staskaaa-netizen/uCNC_Pi_Board/manufacturing/board-3d-bottom-da42d9de.png

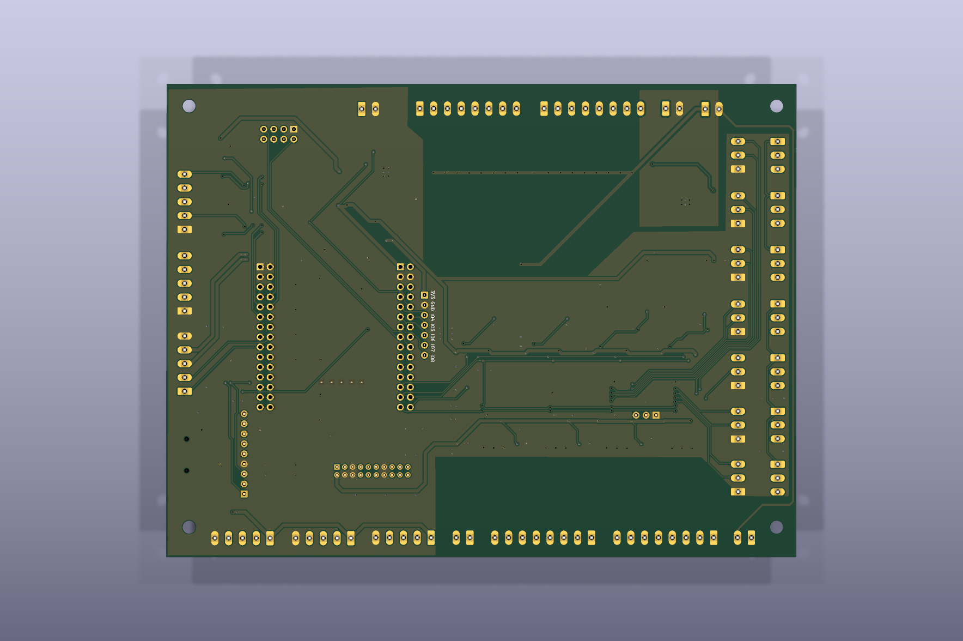
manufacturing/board-3d-bottom-da42d9de.png
