staskaaa-netizen/uCNC_Pi_Board/manufacturing/board-ordered-first-batch.jpg

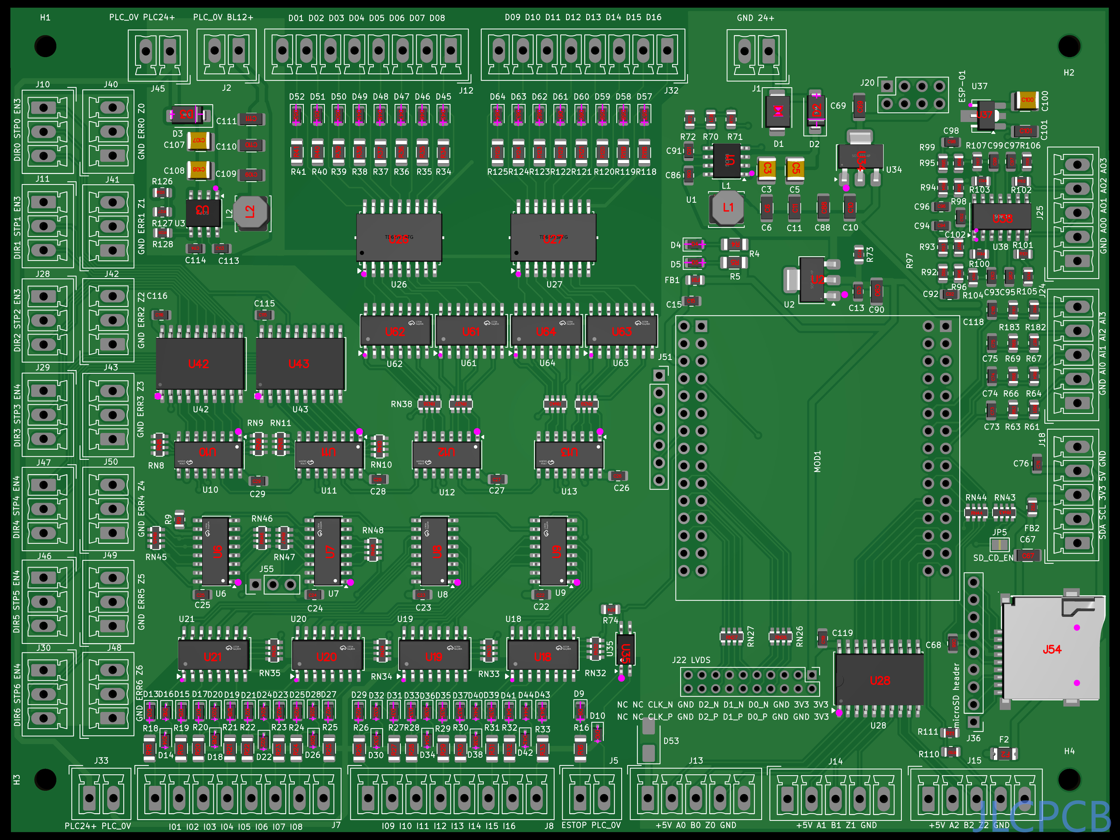
manufacturing/board-ordered-first-batch.jpg
