staskaaa-netizen/uCNC_Pi_Board/experiments/power-schematic-readability/inputs/source-power.png

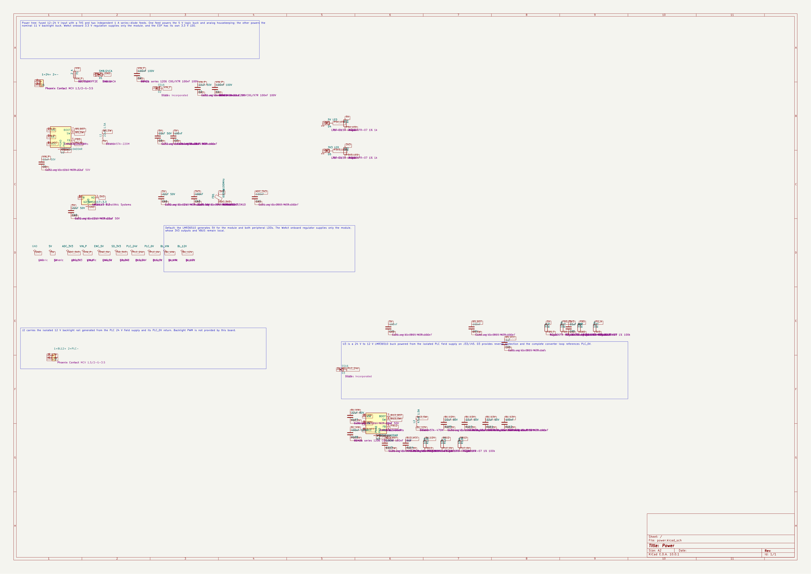
experiments/power-schematic-readability/inputs/source-power.png
