staskaaa-netizen/uCNC_Pi_Board/experiments/power-schematic-readability/method-a/lean-power-a.png

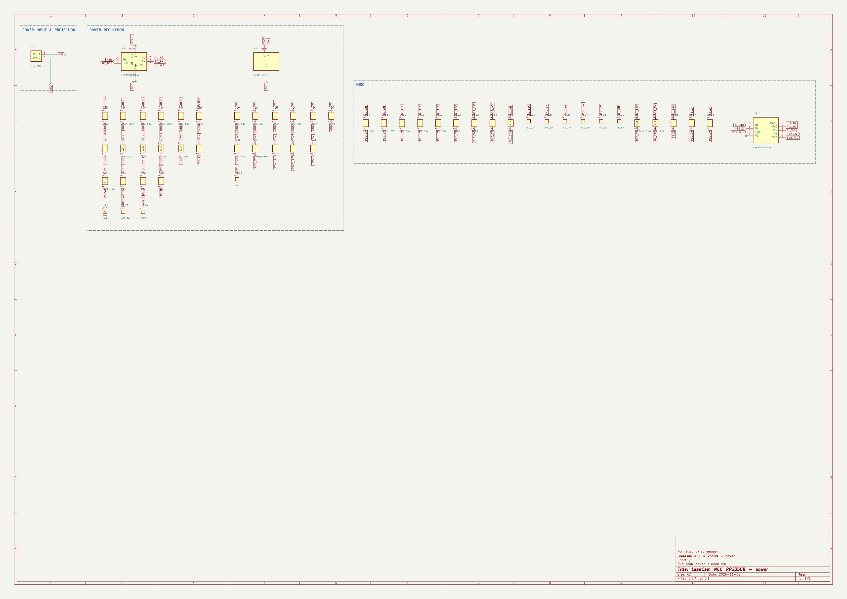
experiments/power-schematic-readability/method-a/lean-power-a.png
