staskaaa-netizen/uCNC_Pi_Board/experiments/power-schematic-readability/method-b/lean-power-b.png

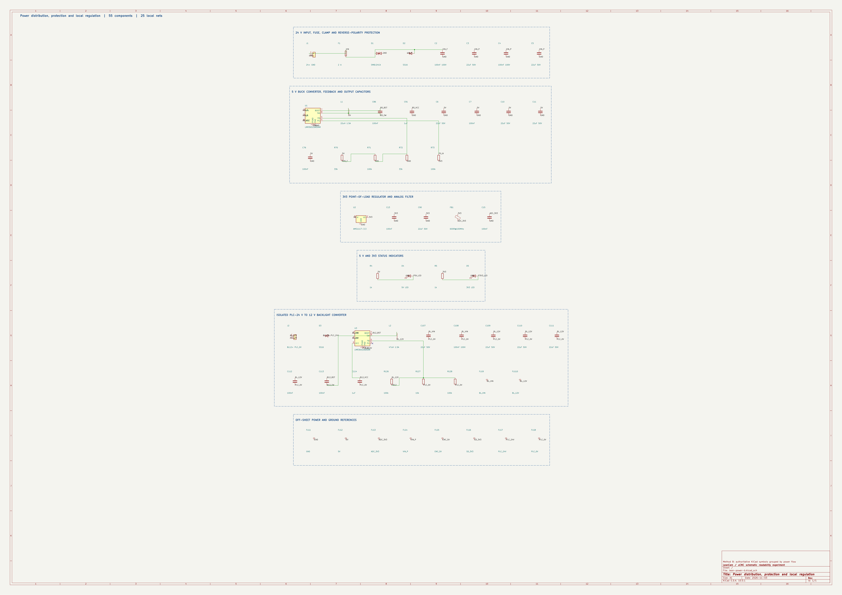
experiments/power-schematic-readability/method-b/lean-power-b.png
