staskaaa-netizen/uCNC_Pi_Board/experiments/power-schematic-readability/other-sheets/analog_io-python.png

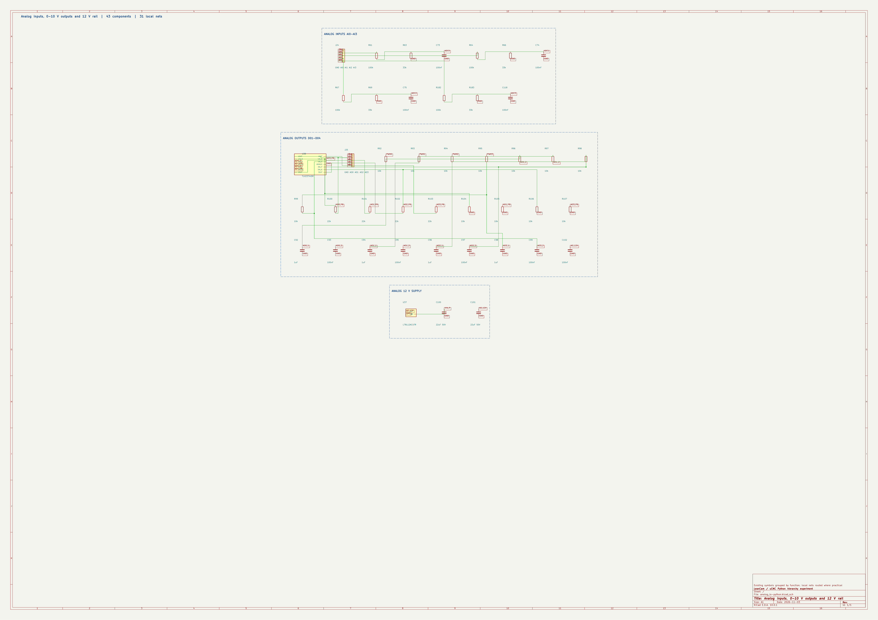
experiments/power-schematic-readability/other-sheets/analog_io-python.png
