staskaaa-netizen/uCNC_Pi_Board/experiments/power-schematic-readability/other-sheets/display-python.png

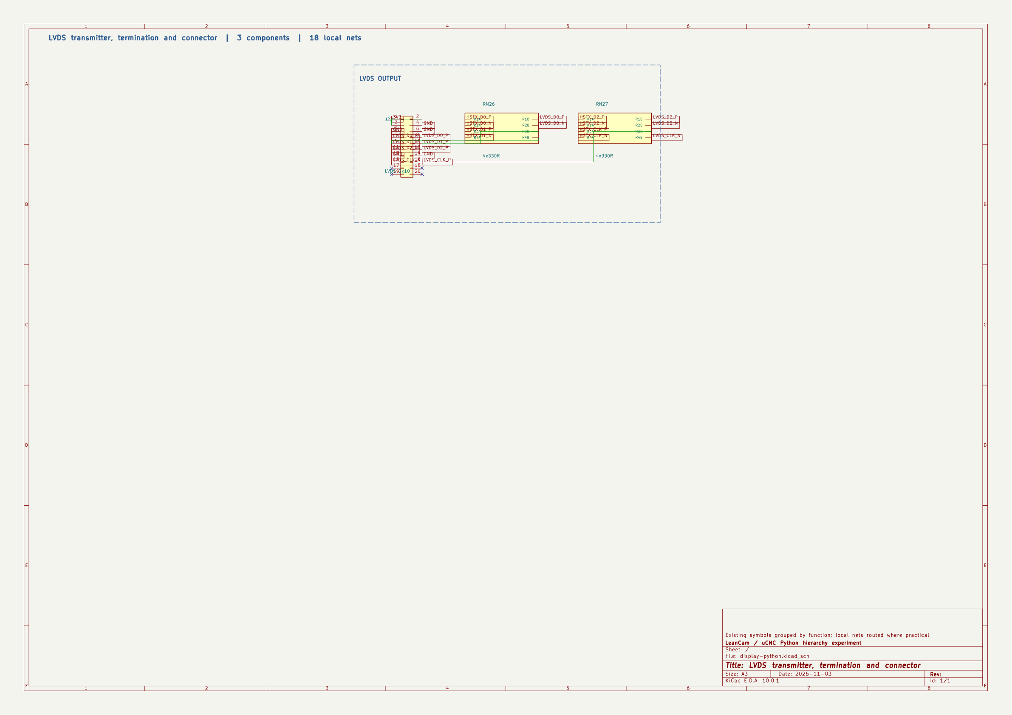
experiments/power-schematic-readability/other-sheets/display-python.png
