staskaaa-netizen/uCNC_Pi_Board/experiments/power-schematic-readability/other-sheets/encoders-python.png

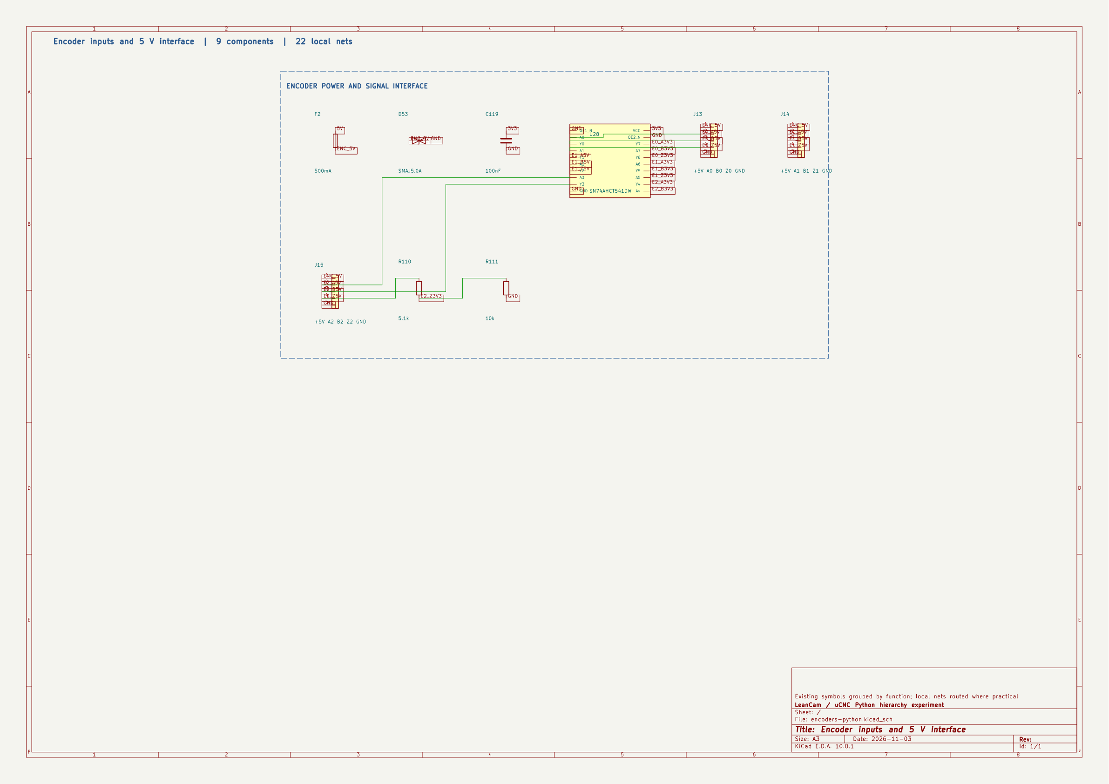
experiments/power-schematic-readability/other-sheets/encoders-python.png
