staskaaa-netizen/uCNC_Pi_Board/experiments/power-schematic-readability/other-sheets/field_inputs-python.png

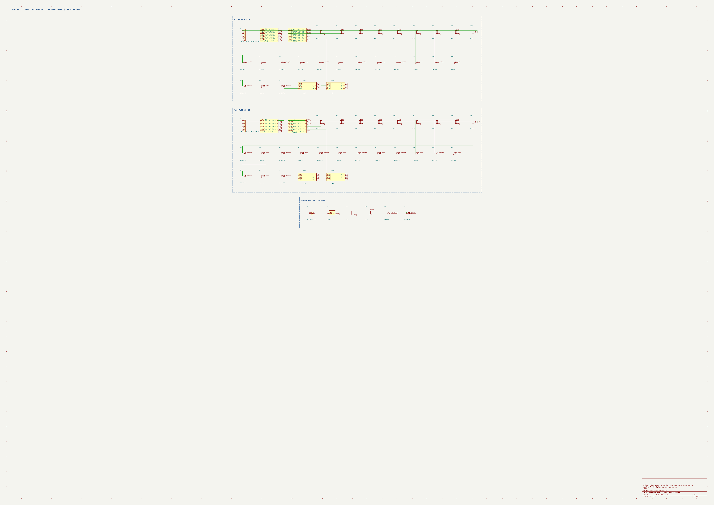
experiments/power-schematic-readability/other-sheets/field_inputs-python.png
