staskaaa-netizen/uCNC_Pi_Board/experiments/power-schematic-readability/other-sheets/field_outputs-python.png

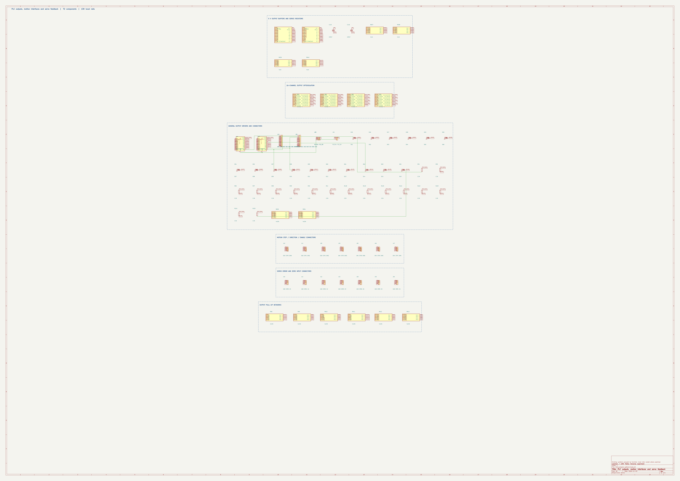
experiments/power-schematic-readability/other-sheets/field_outputs-python.png
