staskaaa-netizen/uCNC_Pi_Board/experiments/power-schematic-readability/other-sheets/mcu_io-python.png

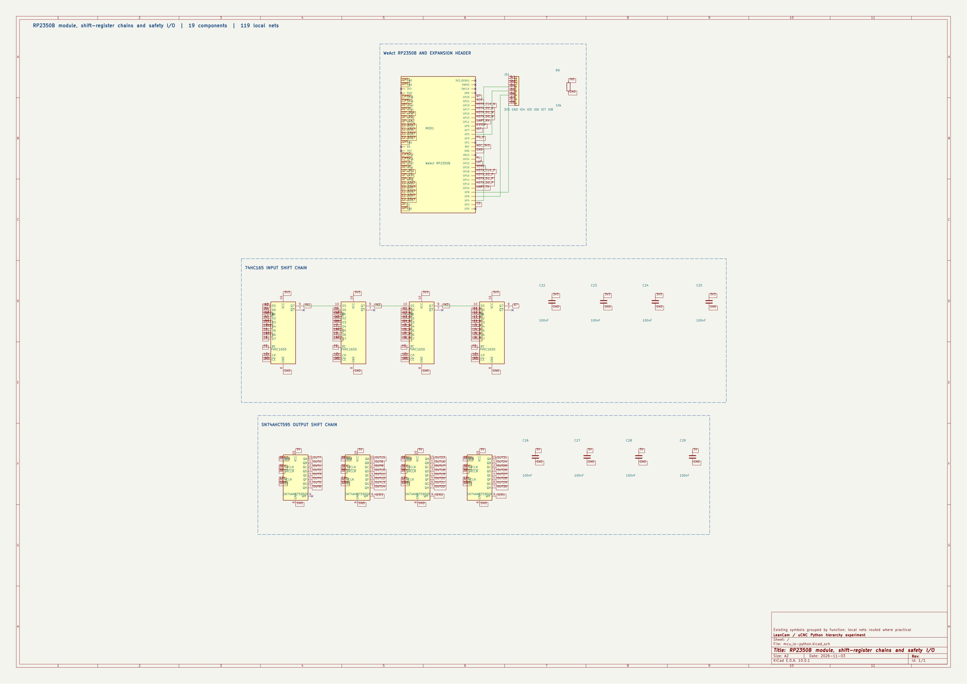
experiments/power-schematic-readability/other-sheets/mcu_io-python.png
