staskaaa-netizen/uCNC_Pi_Board/experiments/power-schematic-readability/other-sheets/storage_wifi_ui-python.png

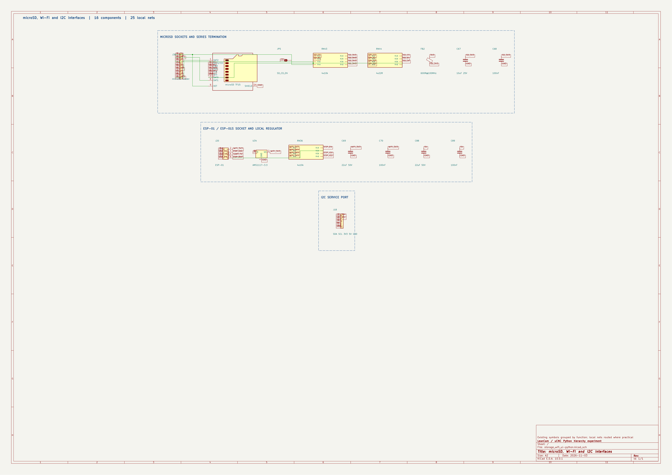
experiments/power-schematic-readability/other-sheets/storage_wifi_ui-python.png
