staskaaa-netizen/uCNC_Pi_Board/manufacturing/bom-all-jlcpcb.csv

Comment | Designator | Footprint | JLCPCB Part #
100nF | C13,C15,C22,C23,C24,C25,C26,C27,C28,C29,C68,C73,C74,C75,C76,C86,C93,C95,C97,C99,C102,C113,C115,C116,C118,C119 | C_0805_2012Metric | C49678
1uF | C91,C92,C94,C96,C98,C114 | C_0805_2012Metric | C28323
22uF 25V | C6,C10,C11,C67,C69,C88,C90,C101,C109,C110,C111 | C_1206_3216Metric | C12891
22uF 35V | C3,C5,C100,C107,C108 | C_1210_3225Metric | C6120016
24+ GND | BL12+ PLC_0V | ESTOP PLC_0V | PLC24+ PLC_0V | J1,J2,J5,J33,J45 | PhoenixContact_MCV_1,5_2-G-3.5_1x02_P3.50mm_Vertical
EN3 STP0 DIR0 | EN3 STP1 DIR1 | EN3 STP2 DIR2 | EN4 STP3 DIR3 | EN4 STP4 DIR4 | EN4 STP5 DIR5 | EN4 STP6 DIR6 | GND ERR0 Z0 | GND ERR1 Z1 | GND ERR2 Z2 | GND ERR3 Z3 | GND ERR4 Z4 | GND ERR5 Z5 | GND ERR6 Z6 | J10,J11,J28,J29,J30,J40,J41,J42,J43,J46,J47,J48,J49,J50 | PhoenixContact_MCV_1,5_3-G-3.5_1x03_P3.50mm_Vertical
5V A0 B0 Z0 GND | 5V A1 B1 Z1 GND | 5V A2 B2 Z2 GND | GND AI0 AI1 AI2 AI3 | GND AO0 AO1 AO2 AO3 | SDA SCL 3V3 5V GND | J13,J14,J15,J18,J24,J25 | PhoenixContact_MCV_1,5_5-G-3.5_1x05_P3.50mm_Vertical
D01 D02 D03 D04 D05 D06 D07 D08 | D09 D10 D11 D12 D13 D14 D15 D16 | I01 I02 I03 I04 I05 I06 I07 I08 | I09 I10 I11 I12 I13 I14 I15 I16 | J7,J8,J12,J32 | PhoenixContact_MCV_1,5_8-G-3.5_1x08_P3.50mm_Vertical
LVDS 2x10 | J22 | PinHeader_2x10_P2.00mm_Vertical
U7 spare inputs: GND, IN13, IN14 | J55 | PinHeader_1x03_P2.54mm_Vertical
microSD header | J36 | PinHeader_1x09_P2.54mm_Vertical
3V3 GND IO4 IO5 IO6 IO7 IO8 | J51 | PinSocket_1x07_P2.54mm_Vertical
ESP-01 | J20 | PinSocket_2x04_P2.54mm_Vertical
US1M | D2,D3 | D_SMA | C412437
SMBJ24CA | D1 | D_SMB | C53133594
1N4148WS | D10,D14,D16,D18,D20,D22,D24,D26,D28,D30,D32,D34,D36,D38,D40,D42,D44 | D_SOD-323 | C2128
3V3 LED | 5V LED | D01 | D02 | D03 | D04 | D05 | D06 | D07 | D08 | D09 | D10 | D11 | D12 | D13 | D14 | D15 | D16 | indicator | D4,D5,D9,D13,D15,D17,D19,D21,D23,D25,D27,D29,D31,D33,D35,D37,D39,D41,D43,D45,D46,D47,D48,D49,D50,D51,D52,D57,D58,D59,D60,D61,D62,D63,D64 | LED_0805_2012Metric | C2297
22uH 1.4A | L1 | L_SXN_SMNR5040 | C9391
47uH 0.9A | L2 | L_SXN_SMNR5040 | C9392
microSD TF15 | J54 | TF-SMD_TF-15-15 | C111196
WeAct RP2350B | MOD1 | WeAct_RP2350B_Socket
TLV2374IDR | U38 | SOIC-14_3.9x8.7mm_P1.27mm | C29793
74HC165D | U6,U7,U8,U9 | SOIC-16_3.9x9.9mm_P1.27mm | C5613
SN74AHCT595DR | U10,U11,U12,U13 | SOIC-16_3.9x9.9mm_P1.27mm | C133793
TLP291-4 | U18,U19,U20,U21,U61,U62,U63,U64 | SOIC-16_4.55x10.3mm_P1.27mm | C60900
SN74AHCT541DWR | U28 | SOIC-20W_7.5x12.8mm_P1.27mm | C2682058
MC74AC541DWR2G | U42,U43 | SOIC-20W_7.5x12.8mm_P1.27mm | C8013
LTV-217-B-G | U35 | SOIC-4_4.55x2.6mm_P1.27mm | C115450
LMR36510ADDAR | U1,U3 | SOIC-8-1EP_3.9x4.9mm_P1.27mm_EP2.41x3.3mm | C1858393
TBD62083AFG(Z,EL) | U26,U27 | SOP-18_7.495x11.515mm_P1.27mm | C4153828
AMS1117-3.3 | U2,U34 | SOT-223-3_TabPin2 | C6186
L78L12ACUTR | U37 | SOT-89-3_Handsoldering | C69601
600R@100MHz | FB1,FB2 | R_0805_2012Metric | C1017
100k | R61,R64,R67,R71,R73,R126,R128,R182 | R_0805_2012Metric | C149504
10k | R9,R74,R92,R93,R94,R95,R96,R97,R98,R99,R104,R105,R106,R107,R127 | R_0805_2012Metric | C17414
22k | R100,R101,R102,R103,R110 | R_0805_2012Metric | C17560
33k | R63,R66,R69,R70,R72,R111,R183 | R_0805_2012Metric | C17633
500mA | F2 | R_1206_3216Metric | C70076
2.2k | R4,R5,R16,R18,R19,R20,R21,R22,R23,R24,R25,R26,R27,R28,R29,R30,R31,R32,R33,R34,R35,R36,R37,R38,R39,R40,R41,R118,R119,R120,R121,R122,R123,R124,R125 | R_1206_3216Metric | C17948
4x1k | RN37,RN38,RN39,RN40 | R_Array_Convex_4x0603 | C20197
4x10k | RN8,RN9,RN10,RN11,RN32,RN33,RN34,RN35,RN43,RN45,RN46,RN47,RN48 | R_Array_Convex_4x0603 | C29718
4x22R | RN44 | R_Array_Convex_4x0603 | C12008
4x330R | RN26,RN27 | R_Array_Convex_4x0603 | C12018
