staskaaa-netizen/uCNC_Pi_Board/manufacturing/packages/uCNC_Pi_Board_SMT_Assembly/bom-full.csv

Quantity | Design Values | Footprint | Manufacturer | MPN | Assembly | References
26 | 100nF | Capacitor_SMD:C_0805_2012Metric | Samsung Electro-Mechanics | CL21 series 0805 X7R 100nF | FIT | C13 C15 C22 C23 C24 C25 C26 C27 C28 C29 C68 C73 C74 C75 C76 C86 C93 C95 C97 C99 C102 C113 C115 C116 C118 C119
6 | 1uF | Capacitor_SMD:C_0805_2012Metric | Samsung Electro-Mechanics | CL21 series 0805 X7R 1uF | FIT | C91 C92 C94 C96 C98 C114
11 | 22uF 25V | Capacitor_SMD:C_1206_3216Metric | Samsung Electro-Mechanics | CL31A226KAHNNNE | FIT | C6 C10 C11 C67 C69 C88 C90 C101 C109 C110 C111
5 | 22uF 35V | Capacitor_SMD:C_1210_3225Metric | Samsung Electro-Mechanics | CL32 series 1210 X7R 22uF 35V | FIT | C3 C5 C100 C107 C108
5 | 24+ GND | BL12+ PLC_0V | ESTOP PLC_0V | PLC24+ PLC_0V | Connector_Phoenix_MC:PhoenixContact_MCV_1,5_2-G-3.5_1x02_P3.50mm_Vertical | Phoenix Contact | Phoenix Contact MCV 1,5/2-G-3.5 | FIT | J1 J2 J5 J33 J45
14 | EN3 STP0 DIR0 | EN3 STP1 DIR1 | EN3 STP2 DIR2 | EN4 STP3 DIR3 | EN4 STP4 DIR4 | EN4 STP5 DIR5 | EN4 STP6 DIR6 | GND ERR0 Z0 | GND ERR1 Z1 | GND ERR2 Z2 | GND ERR3 Z3 | GND ERR4 Z4 | GND ERR5 Z5 | GND ERR6 Z6 | Connector_Phoenix_MC:PhoenixContact_MCV_1,5_3-G-3.5_1x03_P3.50mm_Vertical | Phoenix Contact | Phoenix Contact MCV 1,5/3-G-3.5 | FIT | J10 J11 J28 J29 J30 J40 J41 J42 J43 J46 J47 J48 J49 J50
6 | 5V A0 B0 Z0 GND | 5V A1 B1 Z1 GND | 5V A2 B2 Z2 GND | GND AI0 AI1 AI2 AI3 | GND AO0 AO1 AO2 AO3 | SDA SCL 3V3 5V GND | Connector_Phoenix_MC:PhoenixContact_MCV_1,5_5-G-3.5_1x05_P3.50mm_Vertical | Phoenix Contact | Phoenix Contact MCV 1,5/5-G-3.5 | FIT | J13 J14 J15 J18 J24 J25
4 | D01 D02 D03 D04 D05 D06 D07 D08 | D09 D10 D11 D12 D13 D14 D15 D16 | I01 I02 I03 I04 I05 I06 I07 I08 | I09 I10 I11 I12 I13 I14 I15 I16 | Connector_Phoenix_MC:PhoenixContact_MCV_1,5_8-G-3.5_1x08_P3.50mm_Vertical | Phoenix Contact | Phoenix Contact MCV 1,5/8-G-3.5 | FIT | J7 J8 J12 J32
1 | LVDS 2x10 | Connector_PinHeader_2.00mm:PinHeader_2x10_P2.00mm_Vertical | generic | LVDS 2x10 | FIT | J22
1 | U7 spare inputs: GND, IN13, IN14 | Connector_PinHeader_2.54mm:PinHeader_1x03_P2.54mm_Vertical | generic | U7 spare inputs: GND, IN13, IN14 | FIT | J55
1 | microSD header | Connector_PinHeader_2.54mm:PinHeader_1x09_P2.54mm_Vertical | generic | microSD header | FIT | J36
1 | 3V3 GND IO4 IO5 IO6 IO7 IO8 | Connector_PinSocket_2.54mm:PinSocket_1x07_P2.54mm_Vertical | generic | 3V3 GND IO4 IO5 IO6 IO7 IO8 | FIT | J51
1 | ESP-01 | Connector_PinSocket_2.54mm:PinSocket_2x04_P2.54mm_Vertical | Wurth Elektronik | 61300821121 | FIT | J20
1 | SMAJ5.0A | Diode_SMD:D_SMA | Bourns | SMAJ5.0A | FIT | D53
2 | US1M | Diode_SMD:D_SMA | MDD | US1M | FIT | D2 D3
1 | SMBJ24CA | Diode_SMD:D_SMB | Bourns | SMBJ24CA | FIT | D1
17 | 1N4148WS | Diode_SMD:D_SOD-323 | Diodes Incorporated | 1N4148WS | FIT | D10 D14 D16 D18 D20 D22 D24 D26 D28 D30 D32 D34 D36 D38 D40 D42 D44
35 | 3V3 LED | 5V LED | D01 | D02 | D03 | D04 | D05 | D06 | D07 | D08 | D09 | D10 | D11 | D12 | D13 | D14 | D15 | D16 | indicator | LED_SMD:LED_0805_2012Metric | Hubei KENTO Elec | KT-0805G | FIT | D4 D5 D9 D13 D15 D17 D19 D21 D23 D25 D27 D29 D31 D33 D35 D37 D39 D41 D43 D45 D46 D47 D48 D49 D50 D51 D52 D57 D58 D59 D60 D61 D62 D63 D64
1 | 22uH 1.4A | LeanCam:L_SXN_SMNR5040 | SXN (Shun Xiang Nuo Elec) | SMNR5040-220MT | FIT | L1
1 | 47uH 0.9A | LeanCam:L_SXN_SMNR5040 | SXN (Shun Xiang Nuo Elec) | SMNR5040-470MT | FIT | L2
1 | microSD TF15 | LeanCam:TF-SMD_TF-15-15 | SOFNG | TF-15x15 | FIT | J54
1 | WeAct RP2350B | LeanCam:WeAct_RP2350B_Socket | WeAct Studio | WeAct Studio RP2350B Core Board | FIT | MOD1
1 | TLV2374IDR | Package_SO:SOIC-14_3.9x8.7mm_P1.27mm | Texas Instruments | TLV2374IDR | FIT | U38
4 | 74HC165D | Package_SO:SOIC-16_3.9x9.9mm_P1.27mm | Nexperia | 74HC165D,653 | FIT | U6 U7 U8 U9
4 | SN74AHCT595DR | Package_SO:SOIC-16_3.9x9.9mm_P1.27mm | Texas Instruments | SN74AHCT595DR | FIT | U10 U11 U12 U13
8 | TLP291-4 | Package_SO:SOIC-16_4.55x10.3mm_P1.27mm | Toshiba | TLP291-4 | FIT | U18 U19 U20 U21 U61 U62 U63 U64
1 | SN74AHCT541DWR | Package_SO:SOIC-20W_7.5x12.8mm_P1.27mm | Texas Instruments | SN74AHCT541DWR | FIT | U28
2 | MC74AC541DWR2G | Package_SO:SOIC-20W_7.5x12.8mm_P1.27mm | onsemi | MC74AC541DWR2G | FIT | U42 U43
1 | LTV-217-B-G | Package_SO:SOIC-4_4.55x2.6mm_P1.27mm | Lite-On | LTV-217-B-G | FIT | U35
2 | LMR36510ADDAR | Package_SO:SOIC-8-1EP_3.9x4.9mm_P1.27mm_EP2.41x3.3mm | Texas Instruments | LMR36510ADDAR | FIT | U1 U3
2 | TBD62083AFG(Z,EL) | Package_SO:SOP-18_7.495x11.515mm_P1.27mm | Toshiba | TBD62083AFG(Z,EL) | FIT | U26 U27
2 | AMS1117-3.3 | Package_TO_SOT_SMD:SOT-223-3_TabPin2 | Advanced Monolithic Systems | AMS1117-3.3 | FIT | U2 U34
1 | L78L12ACUTR | Package_TO_SOT_SMD:SOT-89-3_Handsoldering | Texas Instruments | L78L12ACUTR | FIT | U37
2 | 600R@100MHz | Resistor_SMD:R_0805_2012Metric | Sunlord | GZ2012D601TF | FIT | FB1 FB2
8 | 100k | Resistor_SMD:R_0805_2012Metric | Yageo | RC0805 series 1% 100k | FIT | R61 R64 R67 R71 R73 R126 R128 R182
15 | 10k | Resistor_SMD:R_0805_2012Metric | Yageo | RC0805 series 1% 10k | FIT | R9 R74 R92 R93 R94 R95 R96 R97 R98 R99 R104 R105 R106 R107 R127
5 | 22k | Resistor_SMD:R_0805_2012Metric | Yageo | RC0805 series 1% 22k | FIT | R100 R101 R102 R103 R110
7 | 33k | Resistor_SMD:R_0805_2012Metric | Yageo | RC0805 series 1% 33k | FIT | R63 R66 R69 R70 R72 R111 R183
1 | 500mA | Resistor_SMD:R_1206_3216Metric | Bel Fuse | 0ZCG0050FF2E | FIT | F2
35 | 2.2k | Resistor_SMD:R_1206_3216Metric | Yageo | RC1206FR-07 1% 2.2k | FIT | R4 R5 R16 R18 R19 R20 R21 R22 R23 R24 R25 R26 R27 R28 R29 R30 R31 R32 R33 R34 R35 R36 R37 R38 R39 R40 R41 R118 R119 R120 R121 R122 R123 R124 R125
4 | 4x1k | Resistor_SMD:R_Array_Convex_4x0603 | UNI-ROYAL | 4D03WGJ0102T5E | FIT | RN37 RN38 RN39 RN40
13 | 4x10k | Resistor_SMD:R_Array_Convex_4x0603 | UNI-ROYAL | 4D03WGJ0103T5E | FIT | RN8 RN9 RN10 RN11 RN32 RN33 RN34 RN35 RN43 RN45 RN46 RN47 RN48
1 | 4x22R | Resistor_SMD:R_Array_Convex_4x0603 | Yageo | YC164-FR-07 series 1% | FIT | RN44
2 | 4x330R | Resistor_SMD:R_Array_Convex_4x0603 | Yageo | YC164-FR-07330RL | FIT | RN26 RN27
