staskaaa-netizen/uCNC_Pi_Board/experiments/power-schematic-readability/inputs/source-display-components.csv

Reference | Value | LibId | PinCount
J22 | LVDS 2x10 | Connector_Generic:Conn_02x10_Odd_Even | 20
RN26 | 4x330R | LeanCam:ResistorPack04 | 8
RN27 | 4x330R | LeanCam:ResistorPack04 | 8
