staskaaa-netizen/uCNC_Pi_Board/experiments/power-schematic-readability/inputs/source-encoders-components.csv

Reference | Value | LibId | PinCount
C119 | 100nF | Device:C | 2
D53 | SMAJ5.0A | Device:D_TVS | 2
F2 | 500mA | Device:Fuse | 2
J13 | +5V A0 B0 Z0 GND | Connector_Generic:Conn_01x05 | 5
J14 | +5V A1 B1 Z1 GND | Connector_Generic:Conn_01x05 | 5
J15 | +5V A2 B2 Z2 GND | Connector_Generic:Conn_01x05 | 5
R110 | 5.1k | Device:R | 2
R111 | 10k | Device:R | 2
U28 | SN74AHCT541DW | LeanCam:OctalBufferAHCT | 20
