staskaaa-netizen/uCNC_Pi_Board/experiments/power-schematic-readability/inputs/source-field_inputs-components.csv

Reference | Value | LibId | PinCount
D10 | 1N4148WS | Device:D | 2
D13 | indicator | Device:LED | 2
D14 | 1N4148WS | Device:D | 2
D15 | indicator | Device:LED | 2
D16 | 1N4148WS | Device:D | 2
D17 | indicator | Device:LED | 2
D18 | 1N4148WS | Device:D | 2
D19 | indicator | Device:LED | 2
D20 | 1N4148WS | Device:D | 2
D21 | indicator | Device:LED | 2
D22 | 1N4148WS | Device:D | 2
D23 | indicator | Device:LED | 2
D24 | 1N4148WS | Device:D | 2
D25 | indicator | Device:LED | 2
D26 | 1N4148WS | Device:D | 2
D27 | indicator | Device:LED | 2
D28 | 1N4148WS | Device:D | 2
D29 | indicator | Device:LED | 2
D30 | 1N4148WS | Device:D | 2
D31 | indicator | Device:LED | 2
D32 | 1N4148WS | Device:D | 2
D33 | indicator | Device:LED | 2
D34 | 1N4148WS | Device:D | 2
D35 | indicator | Device:LED | 2
D36 | 1N4148WS | Device:D | 2
D37 | indicator | Device:LED | 2
D38 | 1N4148WS | Device:D | 2
D39 | indicator | Device:LED | 2
D40 | 1N4148WS | Device:D | 2
D41 | indicator | Device:LED | 2
D42 | 1N4148WS | Device:D | 2
D43 | indicator | Device:LED | 2
D44 | 1N4148WS | Device:D | 2
D9 | indicator | Device:LED | 2
J5 | ESTOP PLC_0V | Connector_Generic:Conn_01x02 | 2
J7 | I01 I02 I03 I04 I05 I06 I07 I08 | Connector_Generic:Conn_01x08 | 8
J8 | I09 I10 I11 I12 I13 I14 I15 I16 | Connector_Generic:Conn_01x08 | 8
R16 | 2.2k | Device:R | 2
R18 | 2.2k | Device:R | 2
R19 | 2.2k | Device:R | 2
R20 | 2.2k | Device:R | 2
R21 | 2.2k | Device:R | 2
R22 | 2.2k | Device:R | 2
R23 | 2.2k | Device:R | 2
R24 | 2.2k | Device:R | 2
R25 | 2.2k | Device:R | 2
R26 | 2.2k | Device:R | 2
R27 | 2.2k | Device:R | 2
R28 | 2.2k | Device:R | 2
R29 | 2.2k | Device:R | 2
R30 | 2.2k | Device:R | 2
R31 | 2.2k | Device:R | 2
R32 | 2.2k | Device:R | 2
R33 | 2.2k | Device:R | 2
R74 | 4.7k | Device:R | 2
RN32 | 4x10k | LeanCam:ResistorPack04 | 8
RN33 | 4x10k | LeanCam:ResistorPack04 | 8
RN34 | 4x10k | LeanCam:ResistorPack04 | 8
RN35 | 4x10k | LeanCam:ResistorPack04 | 8
U18 | TLP291-4 | LeanCam:QuadOpto | 16
U19 | TLP291-4 | LeanCam:QuadOpto | 16
U20 | TLP291-4 | LeanCam:QuadOpto | 16
U21 | TLP291-4 | LeanCam:QuadOpto | 16
U35 | TLP291 | Isolator:TLP291 | 4
