staskaaa-netizen/uCNC_Pi_Board/experiments/power-schematic-readability/inputs/source-field_outputs-components.csv

Reference | Value | LibId | PinCount
C115 | 100nF | Device:C | 2
C116 | 100nF | Device:C | 2
D45 | D01 | Device:LED | 2
D46 | D02 | Device:LED | 2
D47 | D03 | Device:LED | 2
D48 | D04 | Device:LED | 2
D49 | D05 | Device:LED | 2
D50 | D06 | Device:LED | 2
D51 | D07 | Device:LED | 2
D52 | D08 | Device:LED | 2
D57 | D09 | Device:LED | 2
D58 | D10 | Device:LED | 2
D59 | D11 | Device:LED | 2
D60 | D12 | Device:LED | 2
D61 | D13 | Device:LED | 2
D62 | D14 | Device:LED | 2
D63 | D15 | Device:LED | 2
D64 | D16 | Device:LED | 2
J10 | EN3 STP0 DIR0 | Connector_Generic:Conn_01x03 | 3
J11 | EN3 STP1 DIR1 | Connector_Generic:Conn_01x03 | 3
J12 | D01 D02 D03 D04 D05 D06 D07 D08 | Connector_Generic:Conn_01x08 | 8
J28 | EN3 STP2 DIR2 | Connector_Generic:Conn_01x03 | 3
J29 | EN4 STP3 DIR3 | Connector_Generic:Conn_01x03 | 3
J30 | EN4 STP6 DIR6 | Connector_Generic:Conn_01x03 | 3
J32 | D09 D10 D11 D12 D13 D14 D15 D16 | Connector_Generic:Conn_01x08 | 8
J33 | PLC24+ PLC_0V | Connector_Generic:Conn_01x02 | 2
J40 | GND ERR0 Z0 | Connector_Generic:Conn_01x03 | 3
J41 | GND ERR1 Z1 | Connector_Generic:Conn_01x03 | 3
J42 | GND ERR2 Z2 | Connector_Generic:Conn_01x03 | 3
J43 | GND ERR3 Z3 | Connector_Generic:Conn_01x03 | 3
J45 | PLC24+ PLC_0V | Connector_Generic:Conn_01x02 | 2
J46 | EN4 STP5 DIR5 | Connector_Generic:Conn_01x03 | 3
J47 | EN4 STP4 DIR4 | Connector_Generic:Conn_01x03 | 3
J48 | GND ERR6 Z6 | Connector_Generic:Conn_01x03 | 3
J49 | GND ERR5 Z5 | Connector_Generic:Conn_01x03 | 3
J50 | GND ERR4 Z4 | Connector_Generic:Conn_01x03 | 3
R118 | 2.2k | Device:R | 2
R119 | 2.2k | Device:R | 2
R120 | 2.2k | Device:R | 2
R121 | 2.2k | Device:R | 2
R122 | 2.2k | Device:R | 2
R123 | 2.2k | Device:R | 2
R124 | 2.2k | Device:R | 2
R125 | 2.2k | Device:R | 2
R34 | 2.2k | Device:R | 2
R35 | 2.2k | Device:R | 2
R36 | 2.2k | Device:R | 2
R37 | 2.2k | Device:R | 2
R38 | 2.2k | Device:R | 2
R39 | 2.2k | Device:R | 2
R40 | 2.2k | Device:R | 2
R41 | 2.2k | Device:R | 2
RN10 | 4x10k | LeanCam:ResistorPack04 | 8
RN11 | 4x10k | LeanCam:ResistorPack04 | 8
RN12 | 4x10k | LeanCam:ResistorPack04 | 8
RN13 | 4x10k | LeanCam:ResistorPack04 | 8
RN30 | 4x10k | LeanCam:ResistorPack04 | 8
RN31 | 4x10k | LeanCam:ResistorPack04 | 8
RN37 | 4x1k | LeanCam:ResistorPack04 | 8
RN38 | 4x1k | LeanCam:ResistorPack04 | 8
RN39 | 4x1k | LeanCam:ResistorPack04 | 8
RN40 | 4x1k | LeanCam:ResistorPack04 | 8
RN8 | 4x10k | LeanCam:ResistorPack04 | 8
RN9 | 4x10k | LeanCam:ResistorPack04 | 8
U26 | TBD62083AFG | Transistor_Array:ULN2803A | 18
U27 | TBD62083AFG | Transistor_Array:ULN2803A | 18
U42 | TC74AC541F | LeanCam:OctalBuffer5V | 20
U43 | TC74AC541F | LeanCam:OctalBuffer5V | 20
U61 | TLP291-4 | LeanCam:QuadOpto | 16
U62 | TLP291-4 | LeanCam:QuadOpto | 16
U63 | TLP291-4 | LeanCam:QuadOpto | 16
U64 | TLP291-4 | LeanCam:QuadOpto | 16
