staskaaa-netizen/uCNC_Pi_Board/experiments/power-schematic-readability/inputs/source-mcu_io-components.csv

Reference | Value | LibId | PinCount
C22 | 100nF | Device:C | 2
C23 | 100nF | Device:C | 2
C24 | 100nF | Device:C | 2
C25 | 100nF | Device:C | 2
C26 | 100nF | Device:C | 2
C27 | 100nF | Device:C | 2
C28 | 100nF | Device:C | 2
C29 | 100nF | Device:C | 2
J51 | 3V3 GND IO4 IO5 IO6 IO7 IO8 | Connector_Generic:Conn_01x07 | 7
MOD1 | WeAct RP2350B | LeanCam:WeAct_RP2350B | 64
R9 | 10k | Device:R | 2
U10 | SN74AHCT595DR | 74xx:74AHCT595 | 16
U11 | SN74AHCT595DR | 74xx:74AHCT595 | 16
U12 | SN74AHCT595DR | 74xx:74AHCT595 | 16
U13 | SN74AHCT595DR | 74xx:74AHCT595 | 16
U6 | 74HC165D | 74xx:74HC165 | 16
U7 | 74HC165D | 74xx:74HC165 | 16
U8 | 74HC165D | 74xx:74HC165 | 16
U9 | 74HC165D | 74xx:74HC165 | 16
