staskaaa-netizen/uCNC_Pi_Board/experiments/power-schematic-readability/inputs/source-power-components.csv

Reference | Value | LibId | PinCount
C10 | 22uF 50V | Device:C | 2
C107 | 22uF 50V | Device:C | 2
C108 | 100nF 100V | Device:C | 2
C109 | 22uF 50V | Device:C | 2
C11 | 22uF 50V | Device:C | 2
C110 | 22uF 50V | Device:C | 2
C111 | 22uF 50V | Device:C | 2
C112 | 100nF | Device:C | 2
C113 | 100nF | Device:C | 2
C114 | 1uF | Device:C | 2
C13 | 100nF | Device:C | 2
C15 | 100nF | Device:C | 2
C2 | 100nF 100V | Device:C | 2
C3 | 22uF 50V | Device:C | 2
C4 | 100nF 100V | Device:C | 2
C5 | 22uF 50V | Device:C | 2
C6 | 22uF 50V | Device:C | 2
C7 | 100nF | Device:C | 2
C76 | 100nF | Device:C | 2
C86 | 100nF | Device:C | 2
C90 | 22uF 50V | Device:C | 2
C91 | 1uF | Device:C | 2
D1 | SMBJ24CA | Device:D_TVS | 2
D2 | SS16 | Device:D | 2
D3 | SS16 | Device:D | 2
D4 | 5V LED | Device:LED | 2
D5 | 3V3 LED | Device:LED | 2
F1 | 2 A | Device:Fuse | 2
FB1 | 600R@100MHz | Device:FerriteBead | 2
FLG1 | GND | power:PWR_FLAG | 1
FLG10 | BL_12V | power:PWR_FLAG | 1
FLG2 | 5V | power:PWR_FLAG | 1
FLG3 | ADC_3V3 | power:PWR_FLAG | 1
FLG4 | VIN_P | power:PWR_FLAG | 1
FLG5 | ENC_5V | power:PWR_FLAG | 1
FLG6 | SD_3V3 | power:PWR_FLAG | 1
FLG7 | PLC_24V | power:PWR_FLAG | 1
FLG8 | PLC_0V | power:PWR_FLAG | 1
FLG9 | BL_VIN | power:PWR_FLAG | 1
J1 | 24+ GND | Connector_Generic:Conn_01x02 | 2
J2 | BL12+ PLC_0V | Connector_Generic:Conn_01x02 | 2
L1 | 22uH 1.5A | Device:L | 2
L2 | 47uH 1.5A | Device:L | 2
R126 | 100k | Device:R | 2
R127 | 10k | Device:R | 2
R128 | 100k | Device:R | 2
R4 | 1k | Device:R | 2
R5 | 1k | Device:R | 2
R70 | 33k | Device:R | 2
R71 | 100k | Device:R | 2
R72 | 33k | Device:R | 2
R73 | 100k | Device:R | 2
U1 | LMR36510ADDAR | Regulator_Switching:LMR36510ADDA | 9
U2 | AMS1117-3.3 | Regulator_Linear:AMS1117-3.3 | 3
U3 | LMR36510ADDAR | Regulator_Switching:LMR36510ADDA | 9
