staskaaa-netizen/uCNC_Pi_Board/experiments/power-schematic-readability/inputs/source-storage_wifi_ui-components.csv

Reference | Value | LibId | PinCount
C67 | 10uF 25V | Device:C | 2
C68 | 100nF | Device:C | 2
C69 | 22uF 50V | Device:C | 2
C70 | 100nF | Device:C | 2
C88 | 22uF 50V | Device:C | 2
C89 | 100nF | Device:C | 2
FB2 | 600R@100MHz | Device:FerriteBead | 2
J18 | SDA SCL 3V3 5V GND | Connector_Generic:Conn_01x05 | 5
J20 | ESP-01 | Connector_Generic:Conn_02x04_Odd_Even | 8
J36 | microSD header | Connector_Generic:Conn_01x09 | 9
J54 | microSD TF15 | Connector:Micro_SD_Card_Det1 | 10
JP5 | SD_CD_EN | Jumper:SolderJumper_2_Open | 2
RN36 | 4x10k | LeanCam:ResistorPack04 | 8
RN43 | 4x10k | LeanCam:ResistorPack04 | 8
RN44 | 4x22R | LeanCam:ResistorPack04 | 8
U34 | AMS1117-3.3 | Regulator_Linear:AMS1117-3.3 | 3
