staskaaa-netizen/uCNC_Pi_Board/manufacturing/uCNC_Pi_Board_PCB_Fabrication/README.txt

uCNC Pi Board - PCB Fabrication Package

PCB fabrication only.

- Board: uCNC Pi Board, LeanCam NCC RP2350B
- Outline: 160 x 120 mm
- Copper layers: 2
- Gerbers: copper, solder mask, silkscreen and board edge
- Drill: PTH and NPTH, Excellon, millimetres
- No SMT BOM or placement file is included in this archive.
