staskaaa-netizen/uCNC_Pi_Board/manufacturing/board-3d-bottom-058f7cbe.png

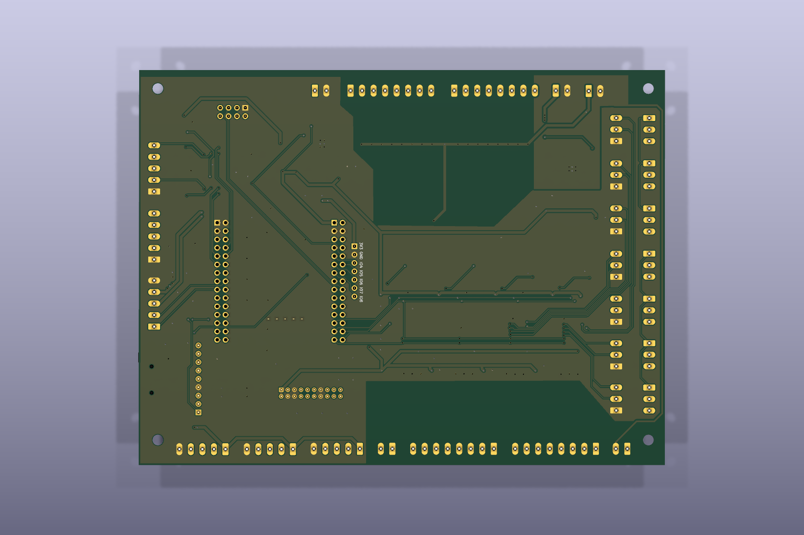
manufacturing/board-3d-bottom-058f7cbe.png
