staskaaa-netizen/uCNC_Pi_Board/manufacturing/board-3d-top-4a6d41f8.png

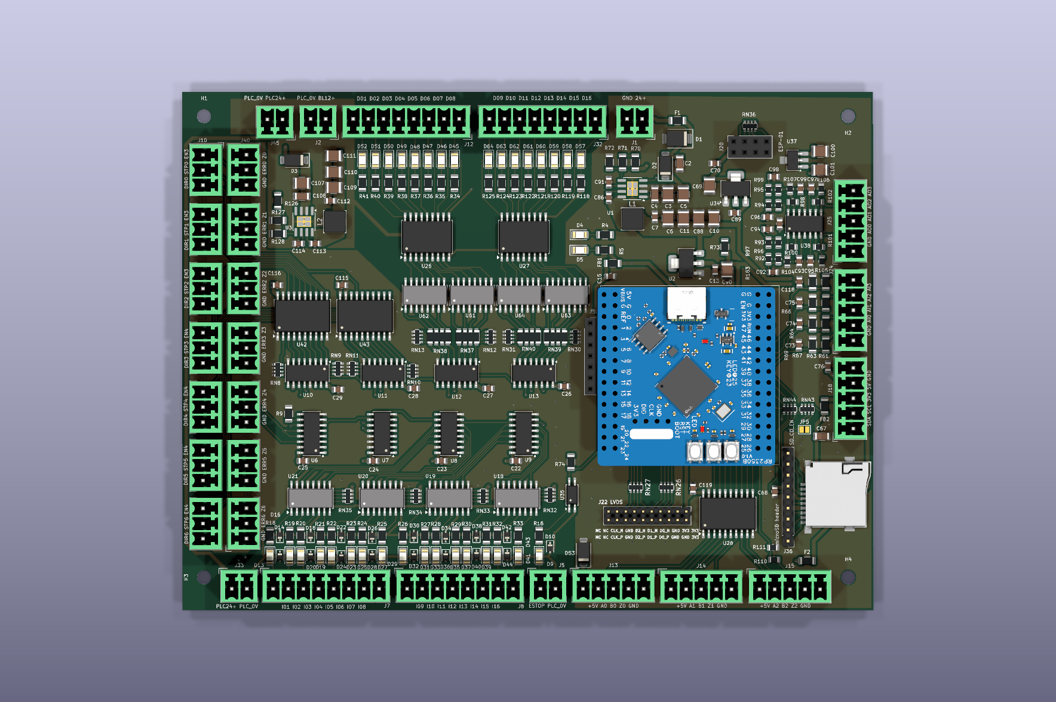
manufacturing/board-3d-top-4a6d41f8.png
