staskaaa-netizen/uCNC_Pi_Board/manufacturing/connector-label-check.png

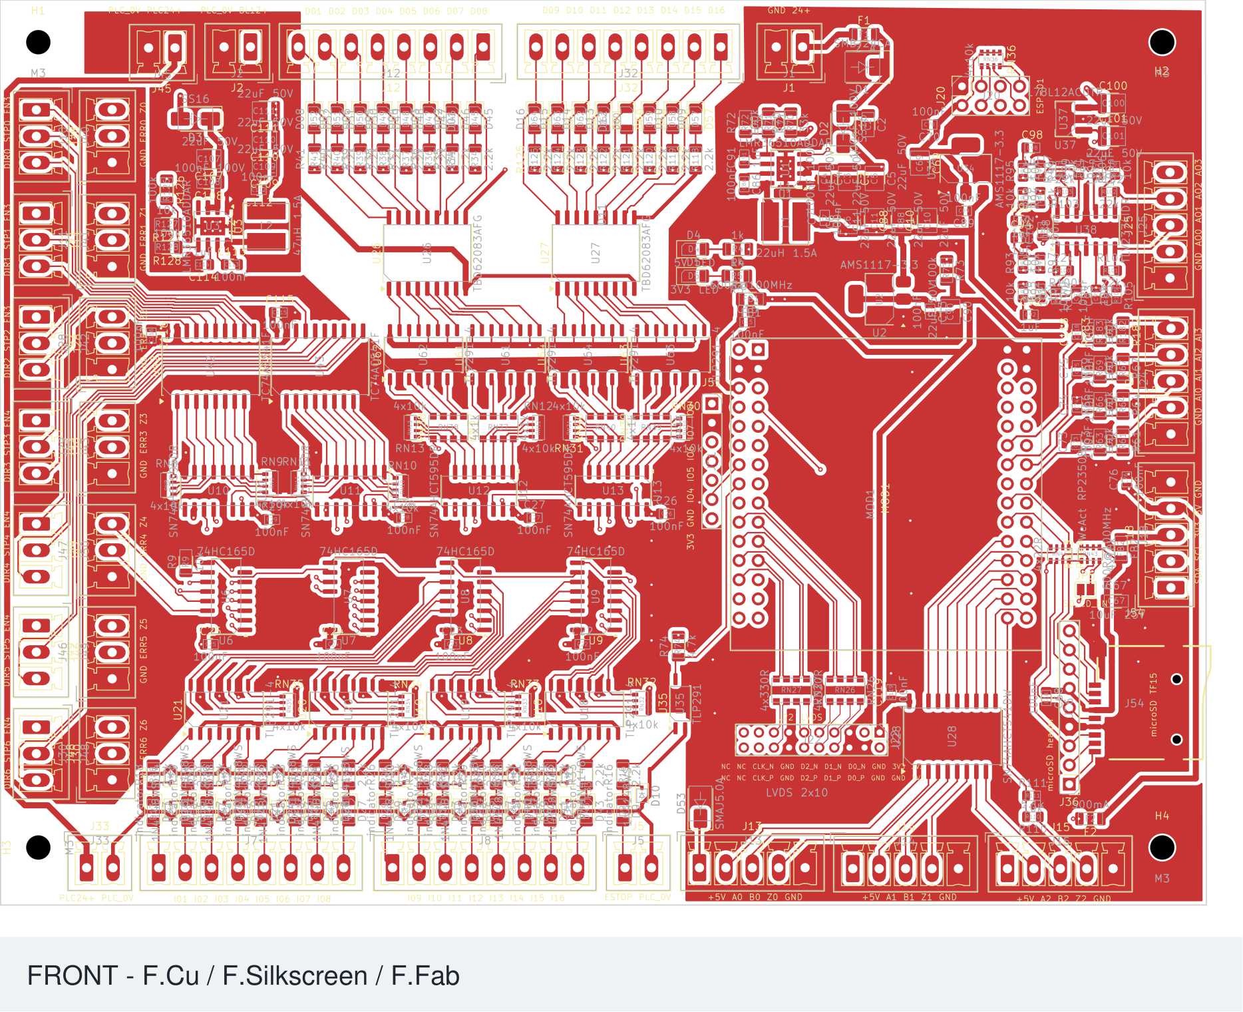
manufacturing/connector-label-check.png
