staskaaa-netizen/uCNC_Pi_Board/manufacturing/board-back.pdf

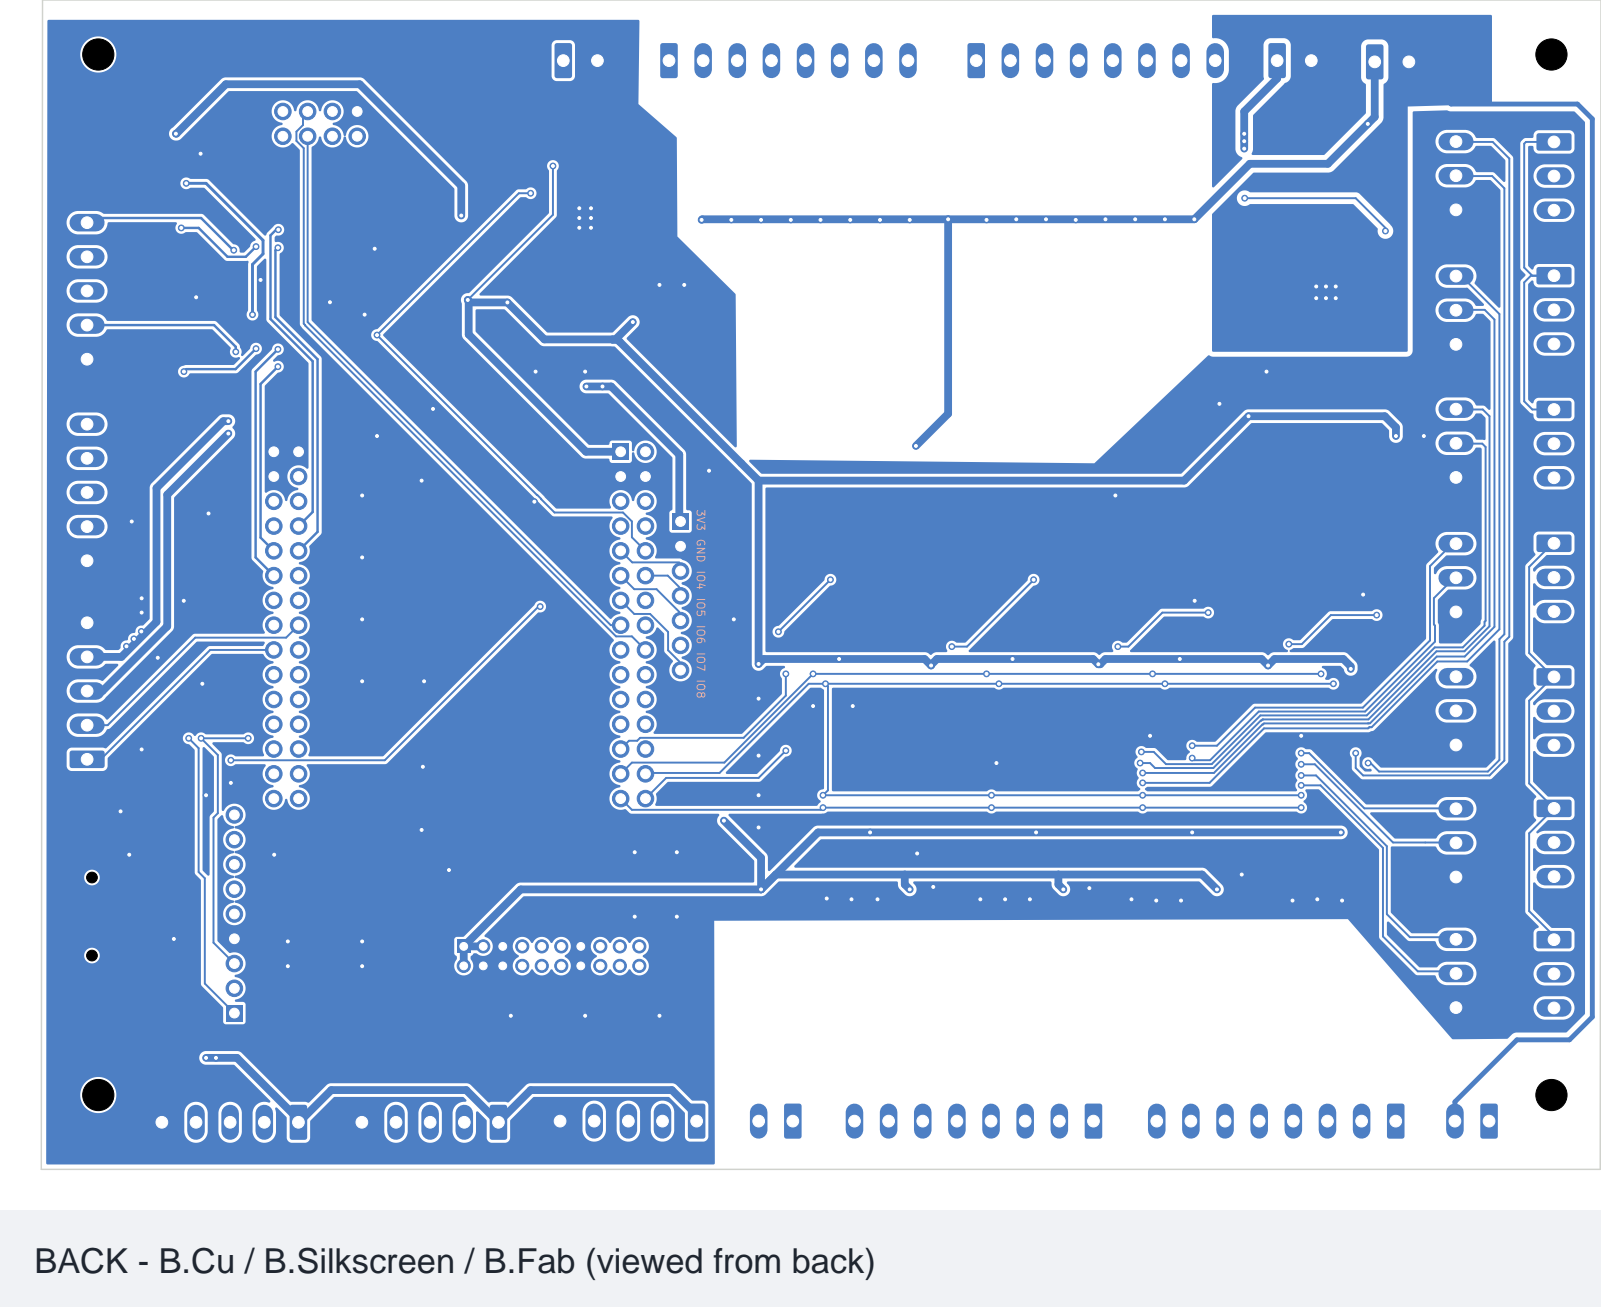
[picture p21: page 1]

BACK - B.Cu / B.Silkscreen / B.Fab (viewed from back)
