staskaaa-netizen/uCNC_Pi_Board/experiments/power-schematic-readability/all-sheets-python.pdf

# 100nF C2

# Power distribution, protection and local regulation | 55 components | 25 local nets

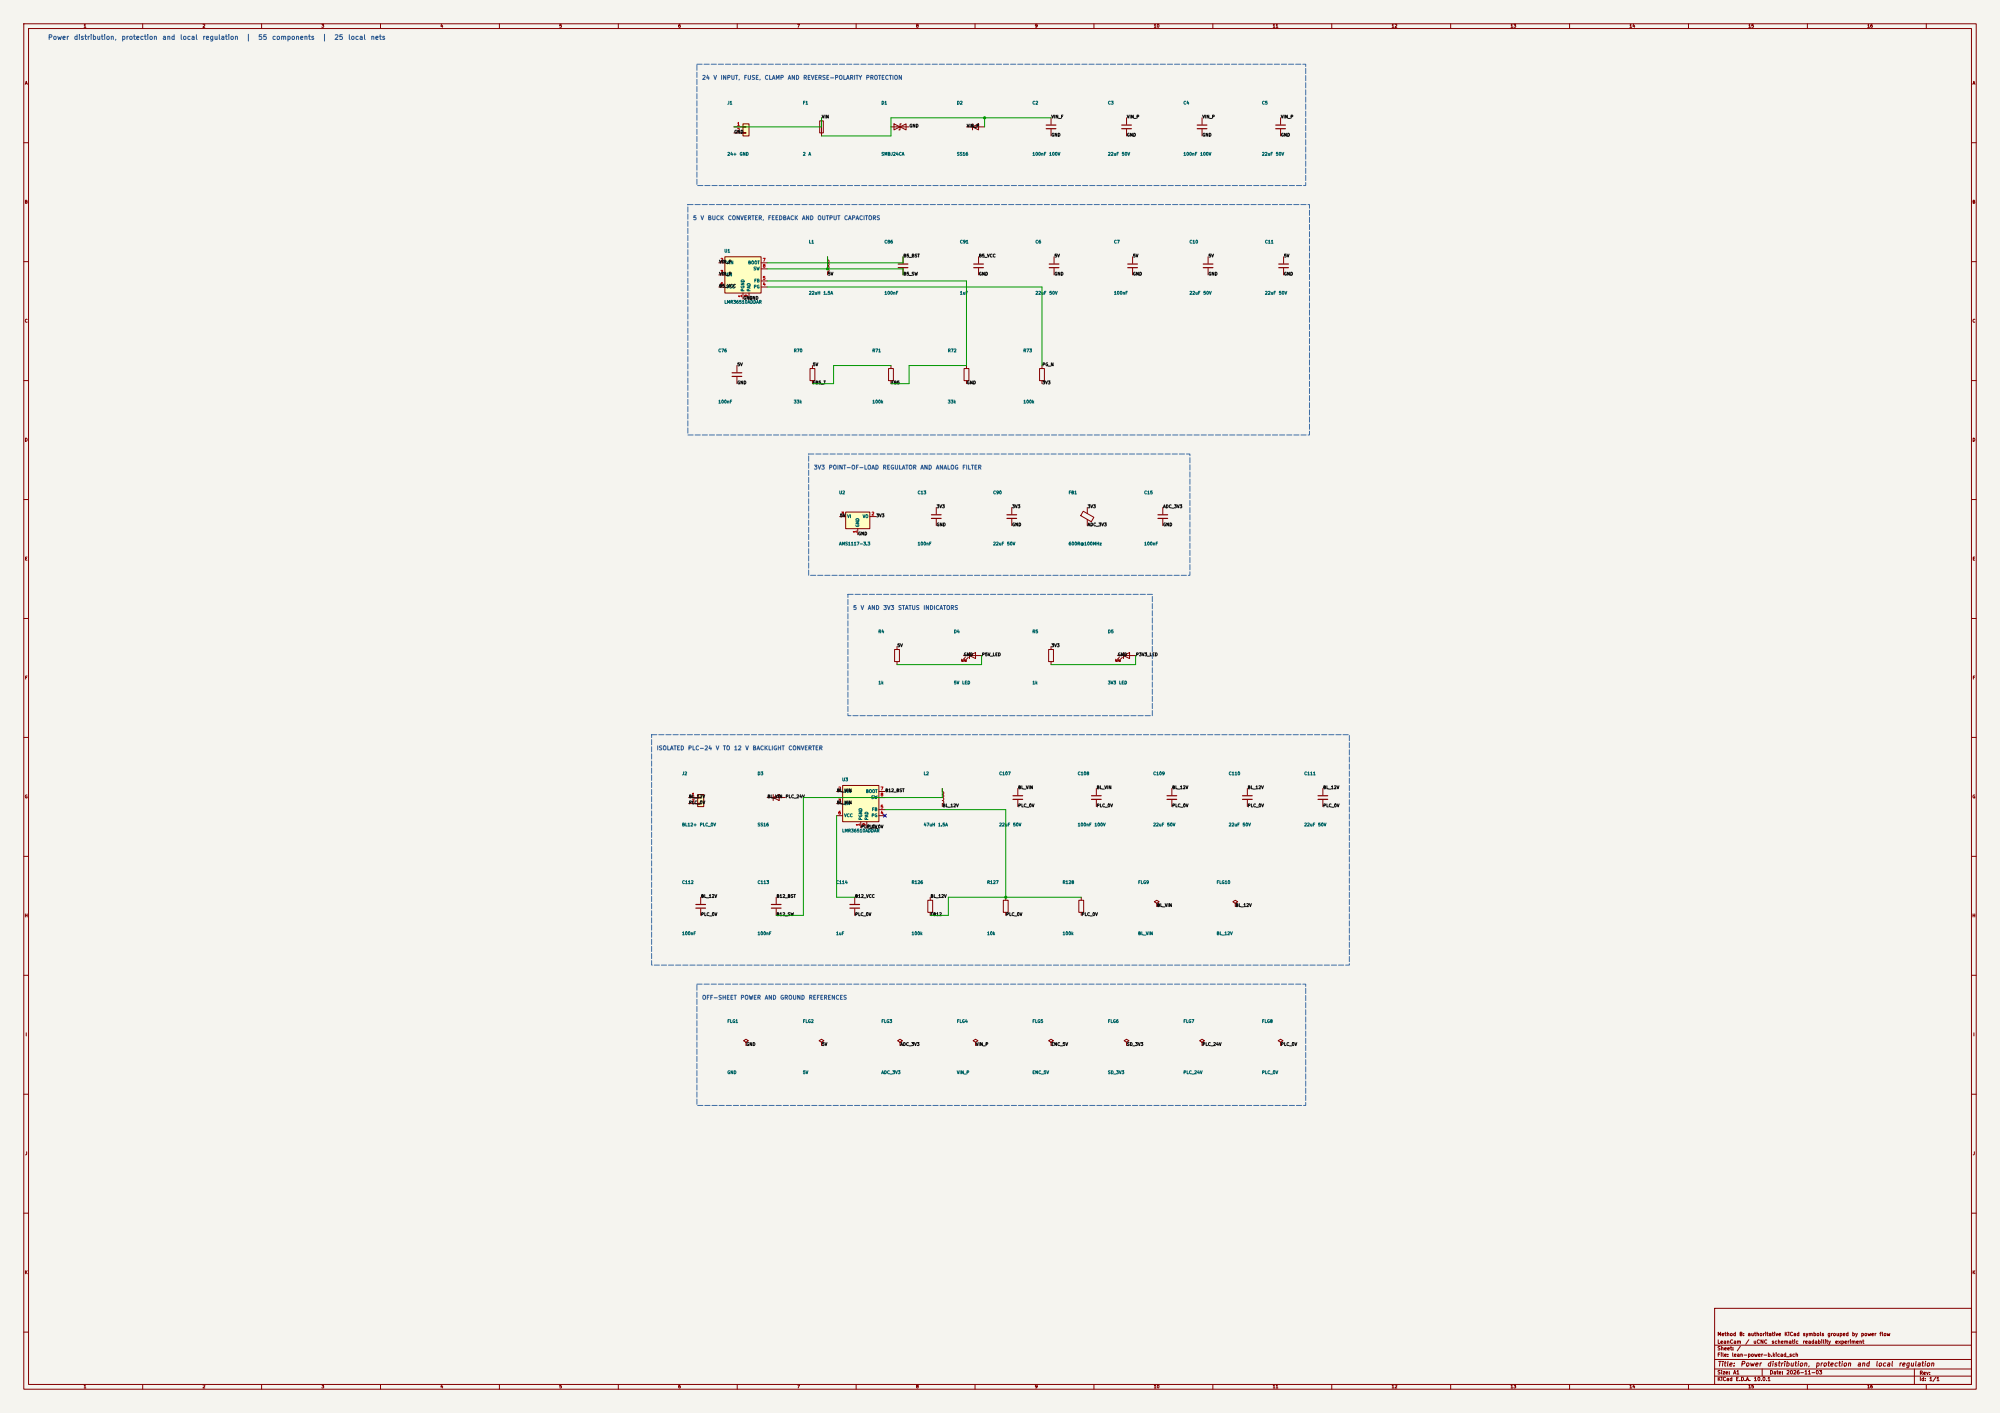
[picture p22: page 1]

24 V INPUT, FUSE, CLAMP AND REVERSE-POLARITY PROTECTION

5 V BUCK CONVERTER, FEEDBACK AND OUTPUT CAPACITORS

3V3 POINT-OF-LOAD REGULATOR AND ANALOG FILTER

Method B: authoritative KiCad symbols grouped by power flow GND

ISOLATED PLC-24 V TO 12 V BACKLIGHT CONVERTER

OFF-SHEET POWER AND GROUND REFERENCES

LeanCam / uCNC schematic readability experiment
Sheet: /
File: lean-power-b.kicad_sch
Title: Power distribution, protection and local regulation
KiCad E.D.A. 10.0.1

# 100nF R66

100k1

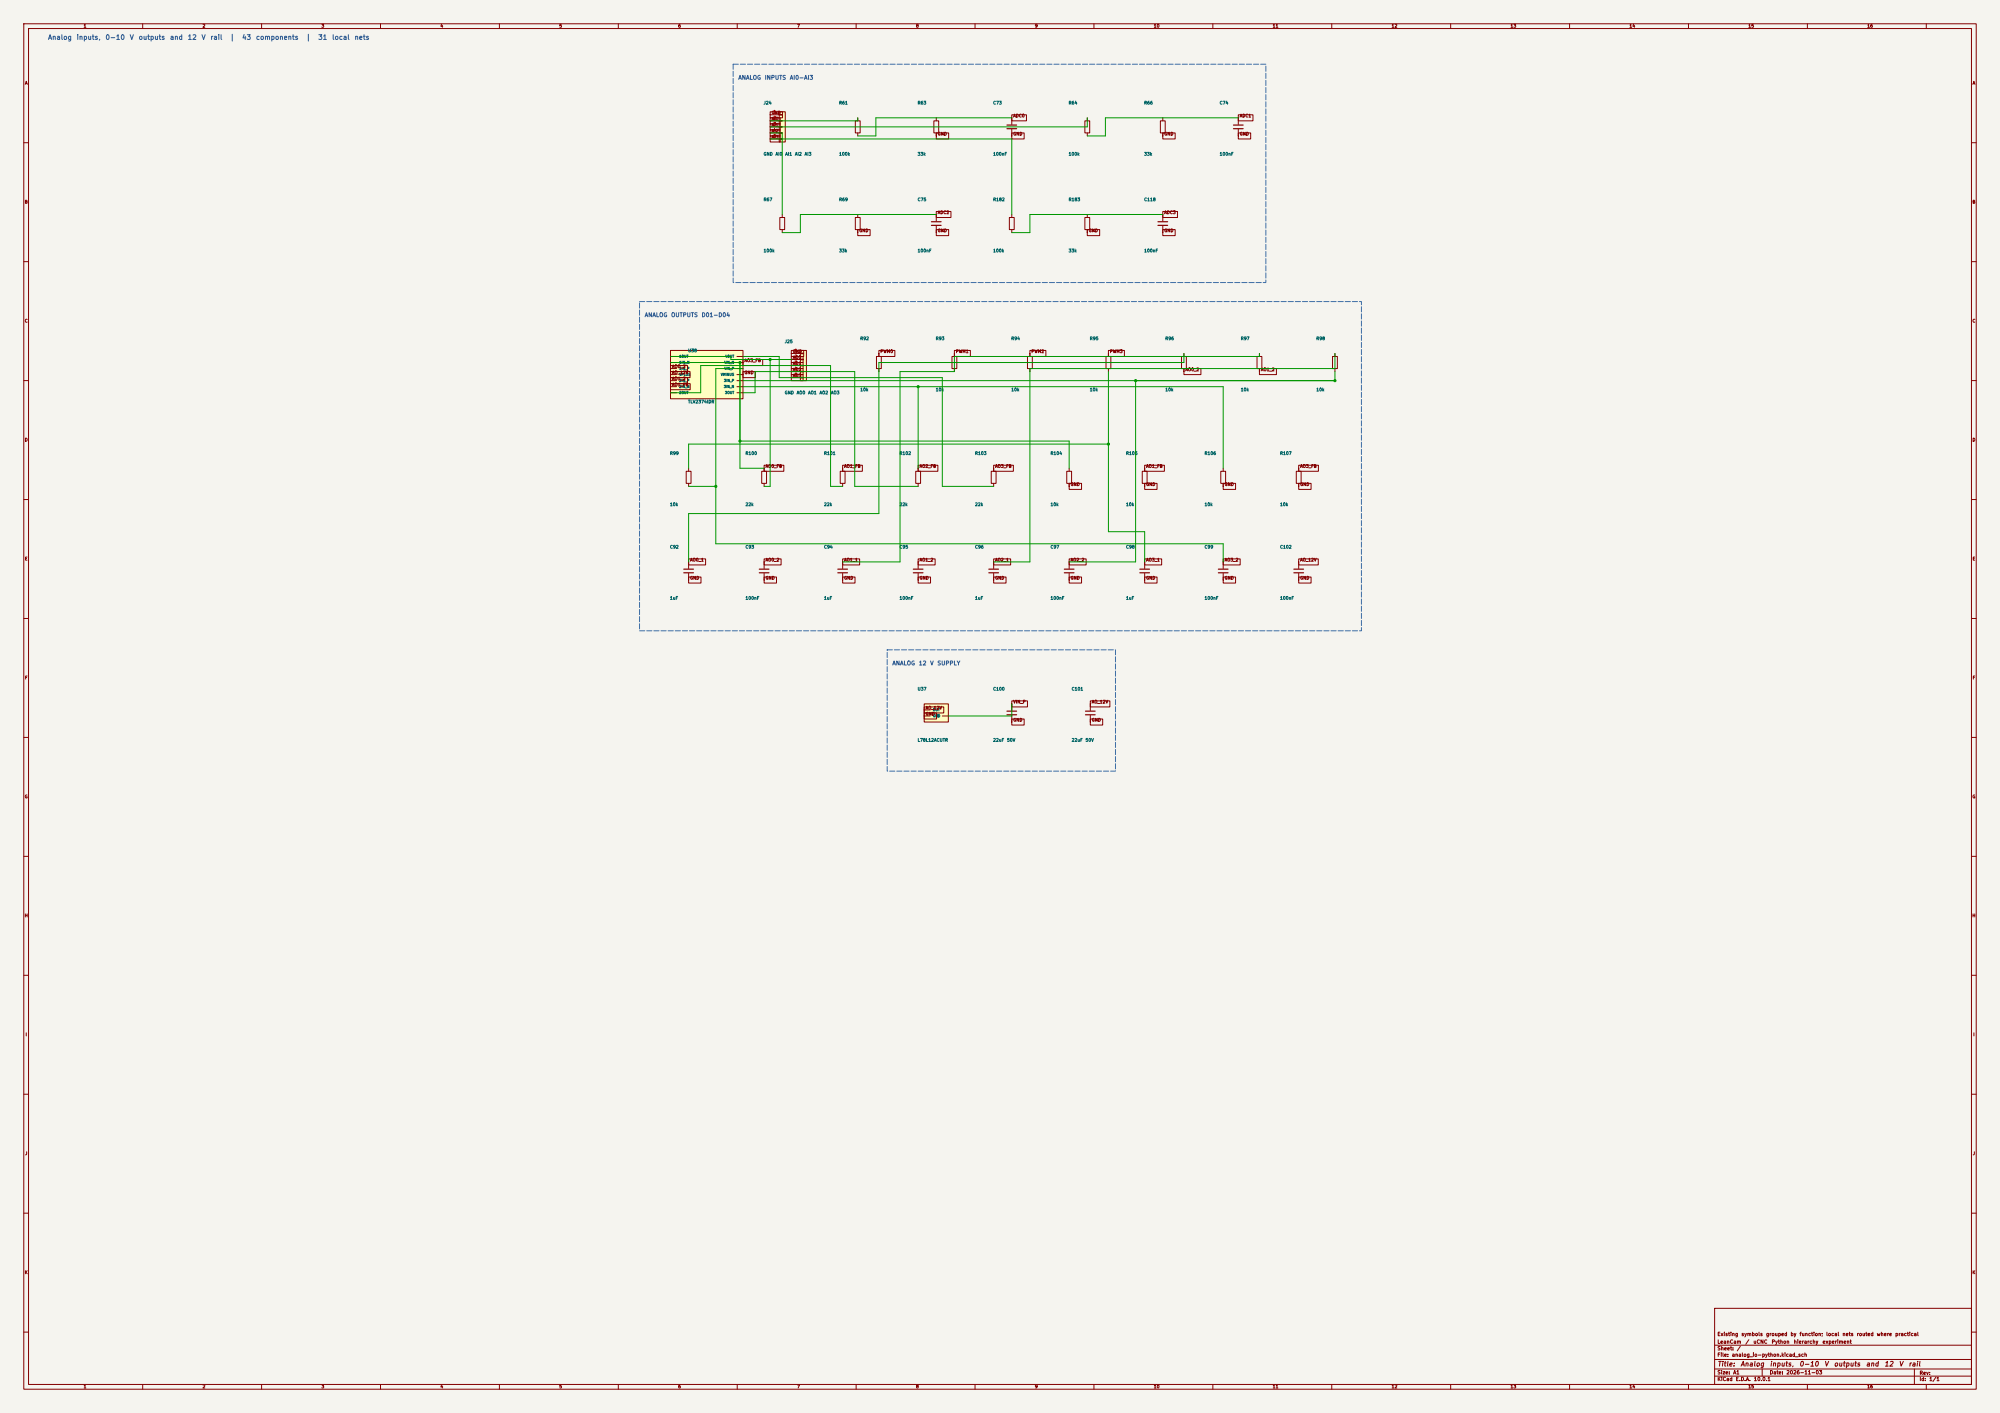
[picture p23: page 2]

Analog inputs, 0-10 V outputs and 12 V rail | 43 components | 31 local nets

Existing symbols grouped by function; local nets routed where practical
LeanCam / uCNC Python hierarchy experiment

File: analog_io-python.kicad_sch
Title: Analog inputs, 0-10 V outputs and 12 V rail

## LVDS_D2_N LVDS OUTPUT

# LVDS transmitter, termination and connector | 3 components | 18 local nets

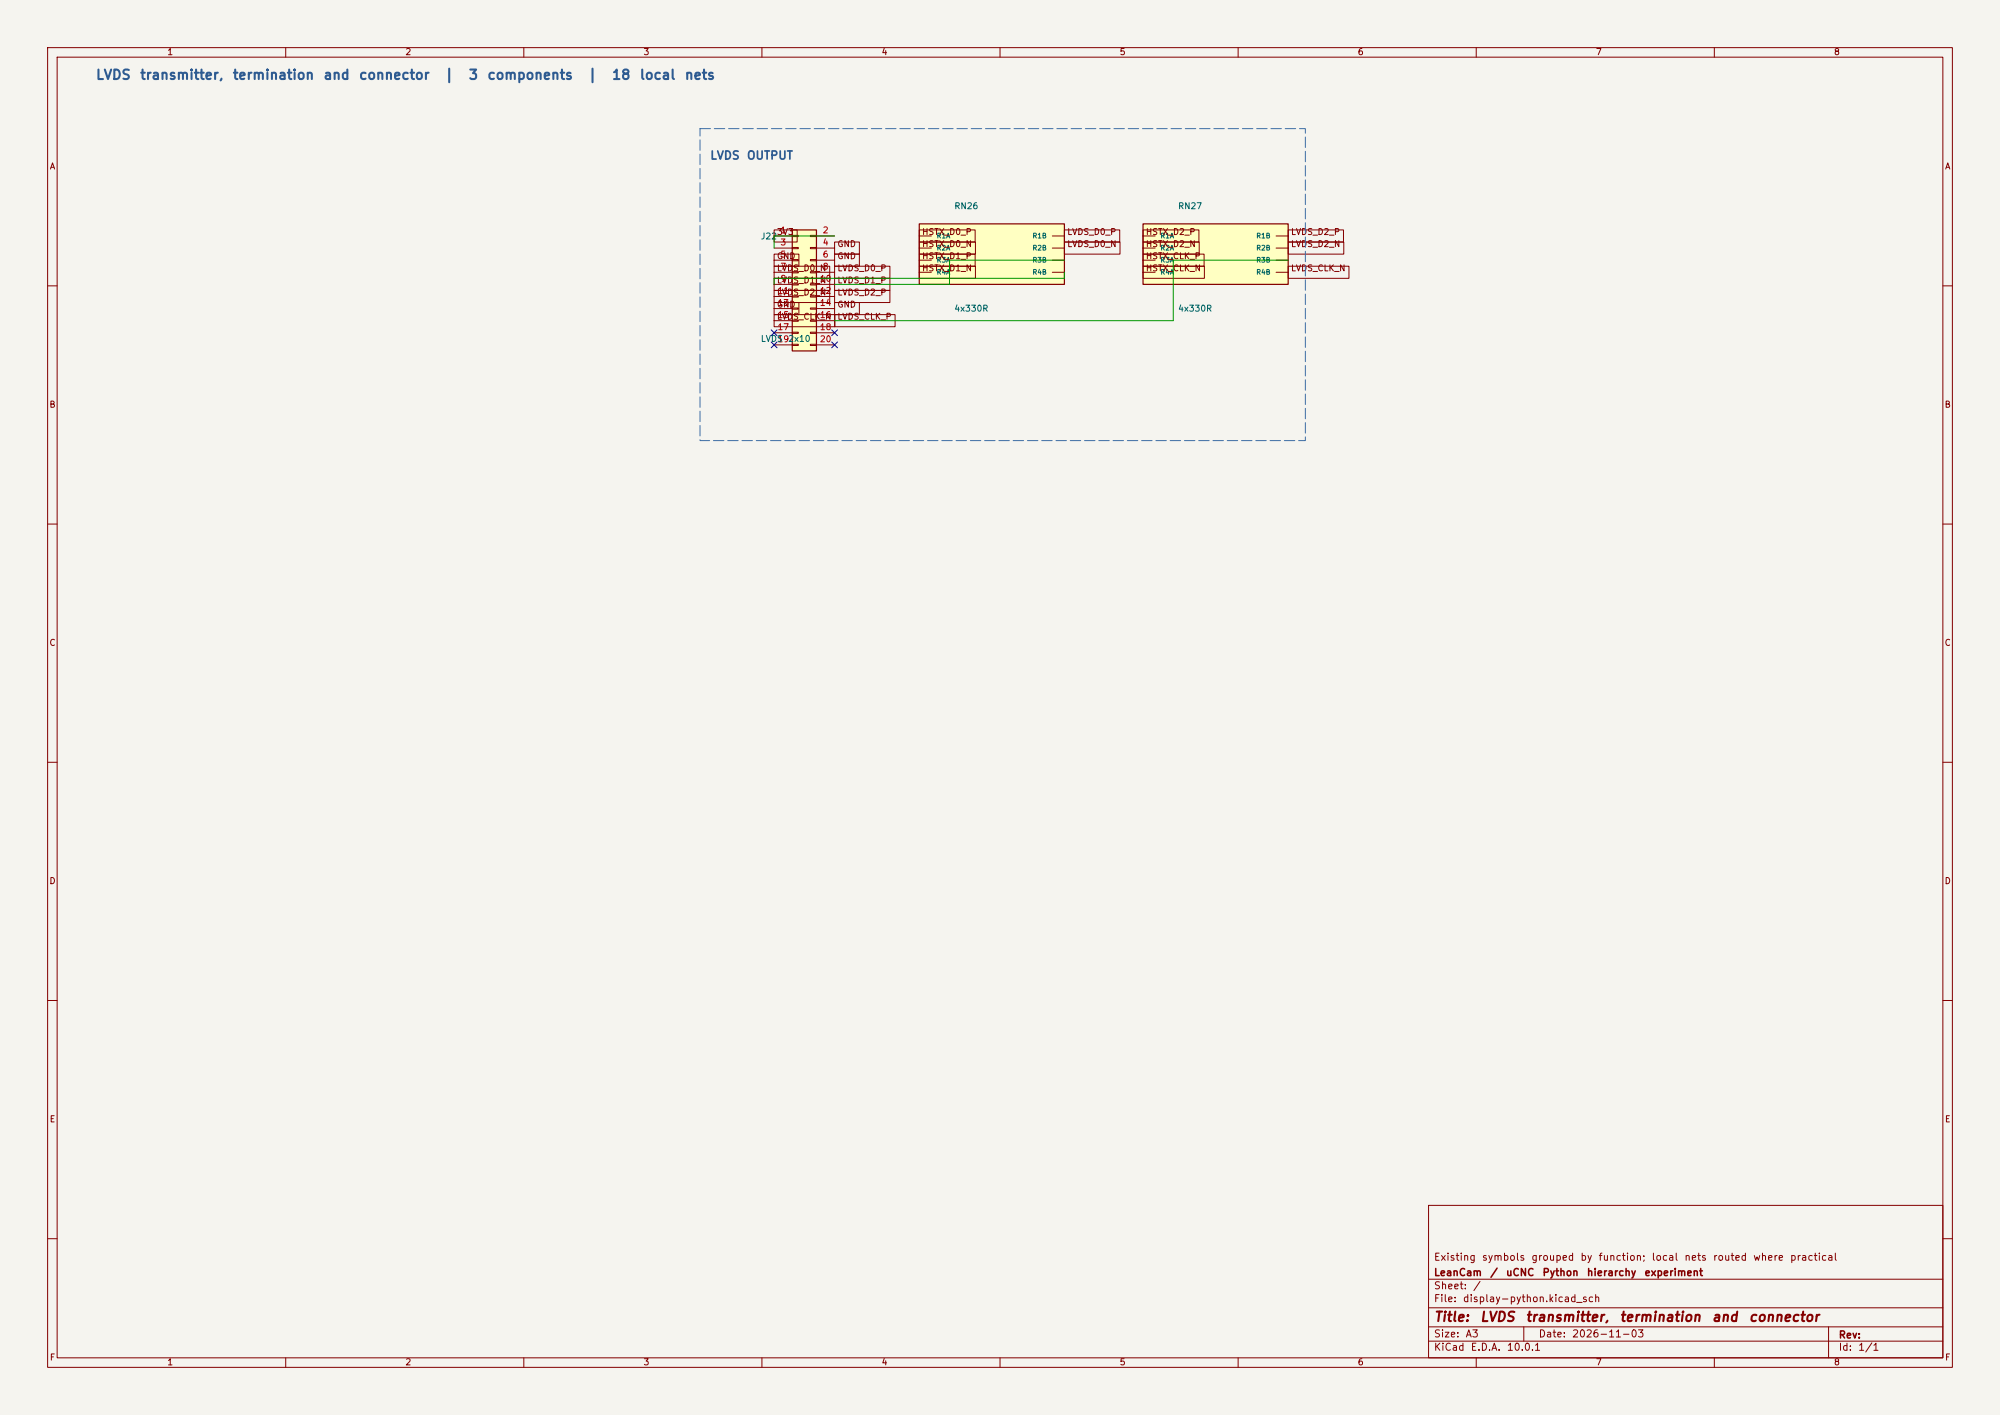
[picture p24: page 3]

Existing symbols grouped by function; local nets routed where practical
LeanCam / uCNC Python hierarchy experiment
Sheet: /
File: display-python.kicad_sch
Title: LVDS transmitter, termination and connector

ENC_5V ENC_5V E2_A5V E2_B5V | E2_Z3V3 | GND Encoder inputs and 5 V interface | 9 components | 22 local nets

## ENCODER POWER AND SIGNAL INTERFACE

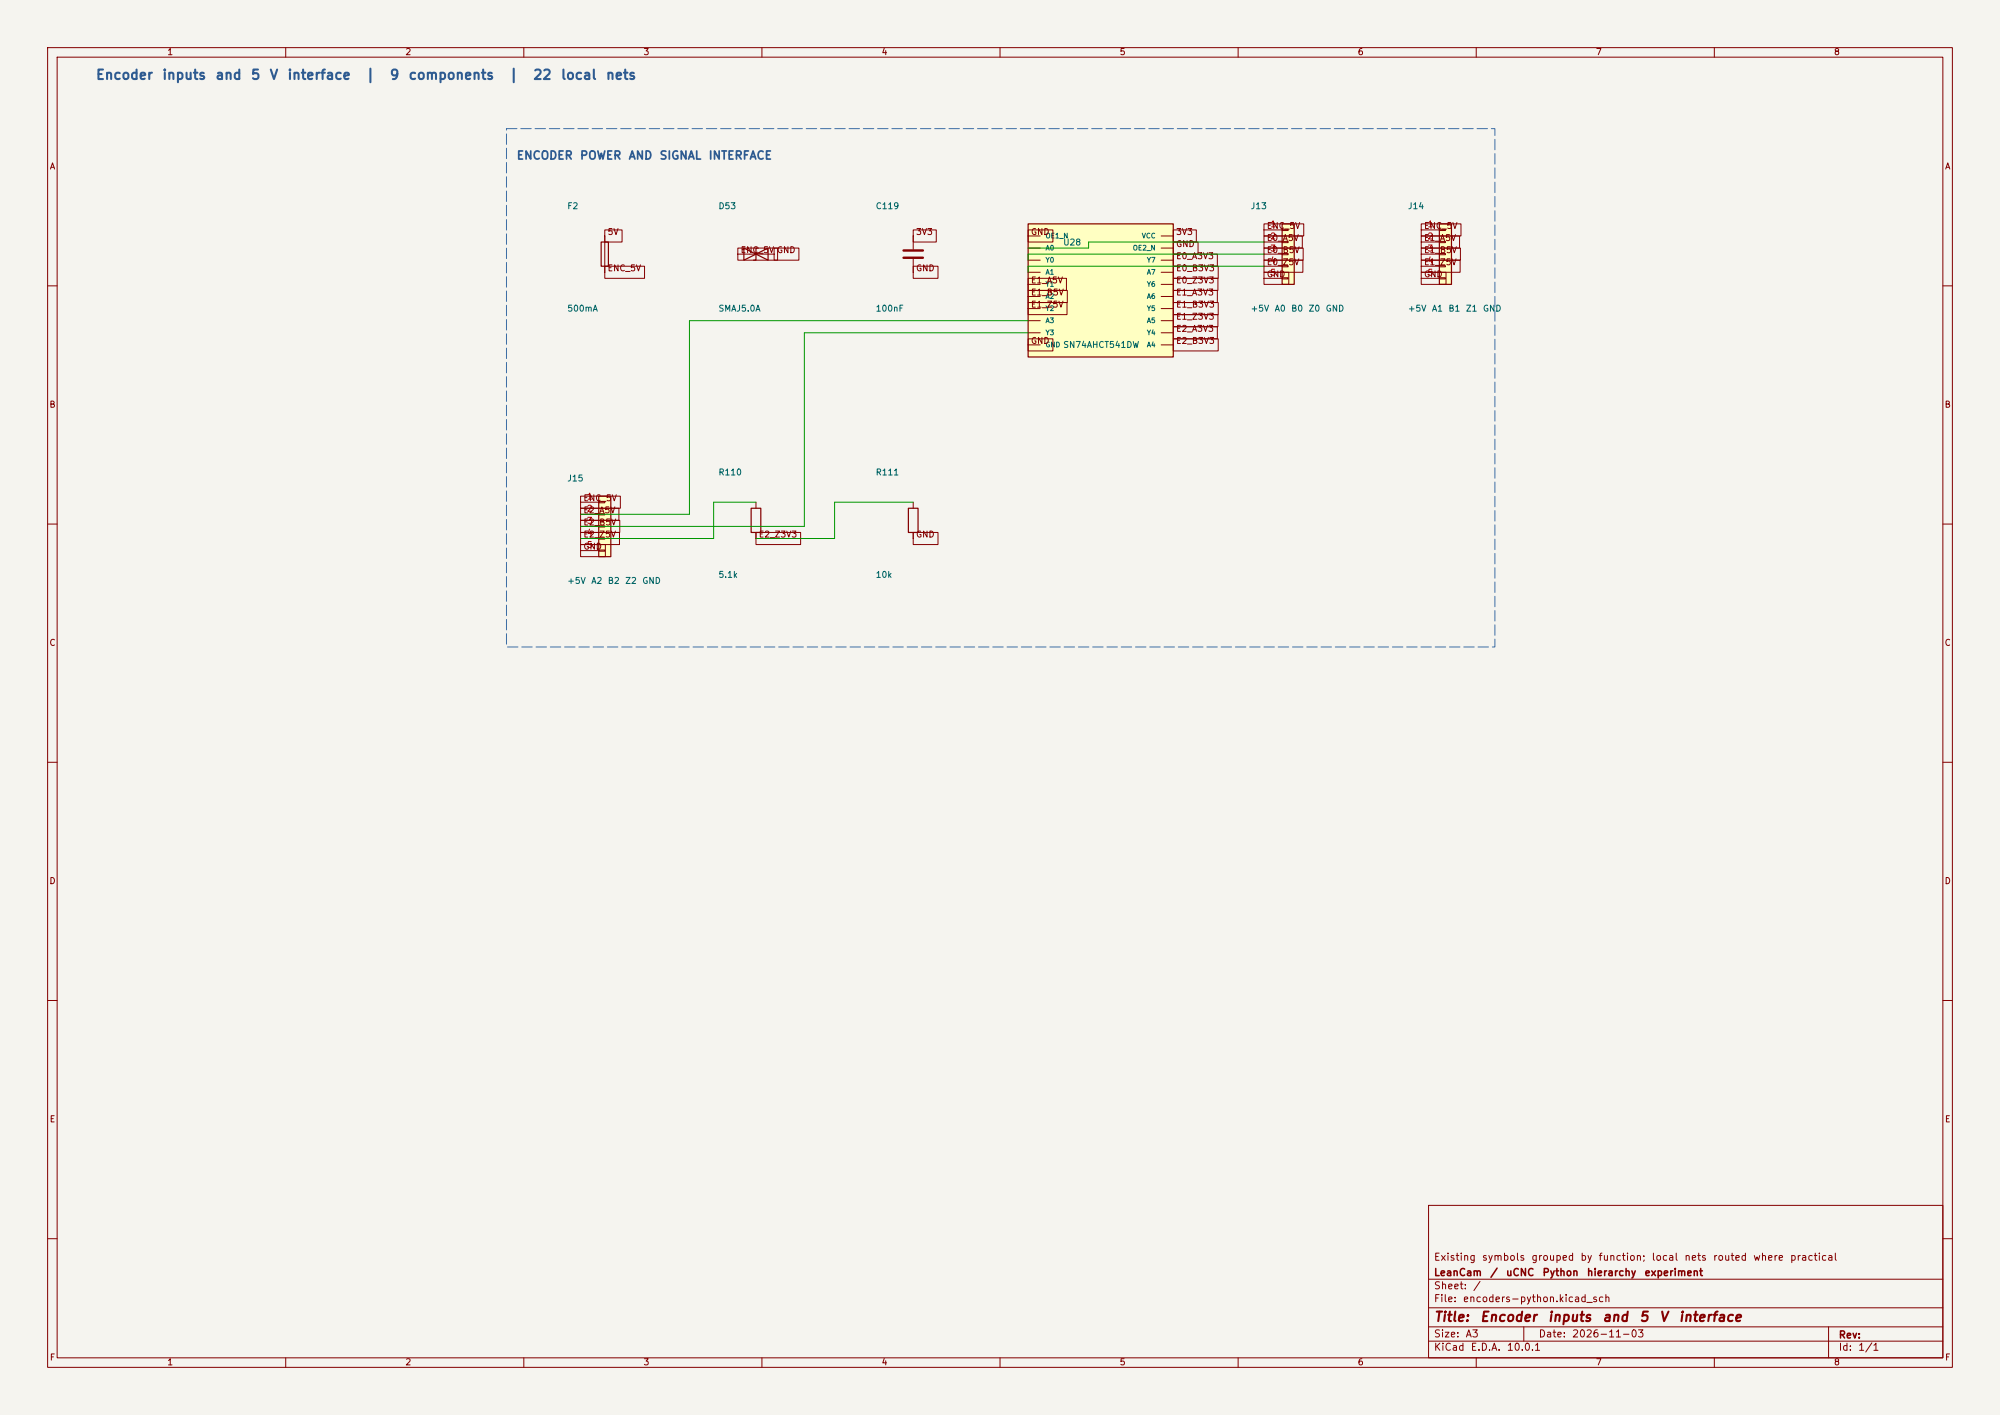
[picture p25: page 4]

Existing symbols grouped by function; local nets routed where practical
LeanCam / uCNC Python hierarchy experiment
Sheet: /
File: encoders-python.kicad_sch
Title: Encoder inputs and 5 V interface

# indicator R31

# 1N4148WS D32

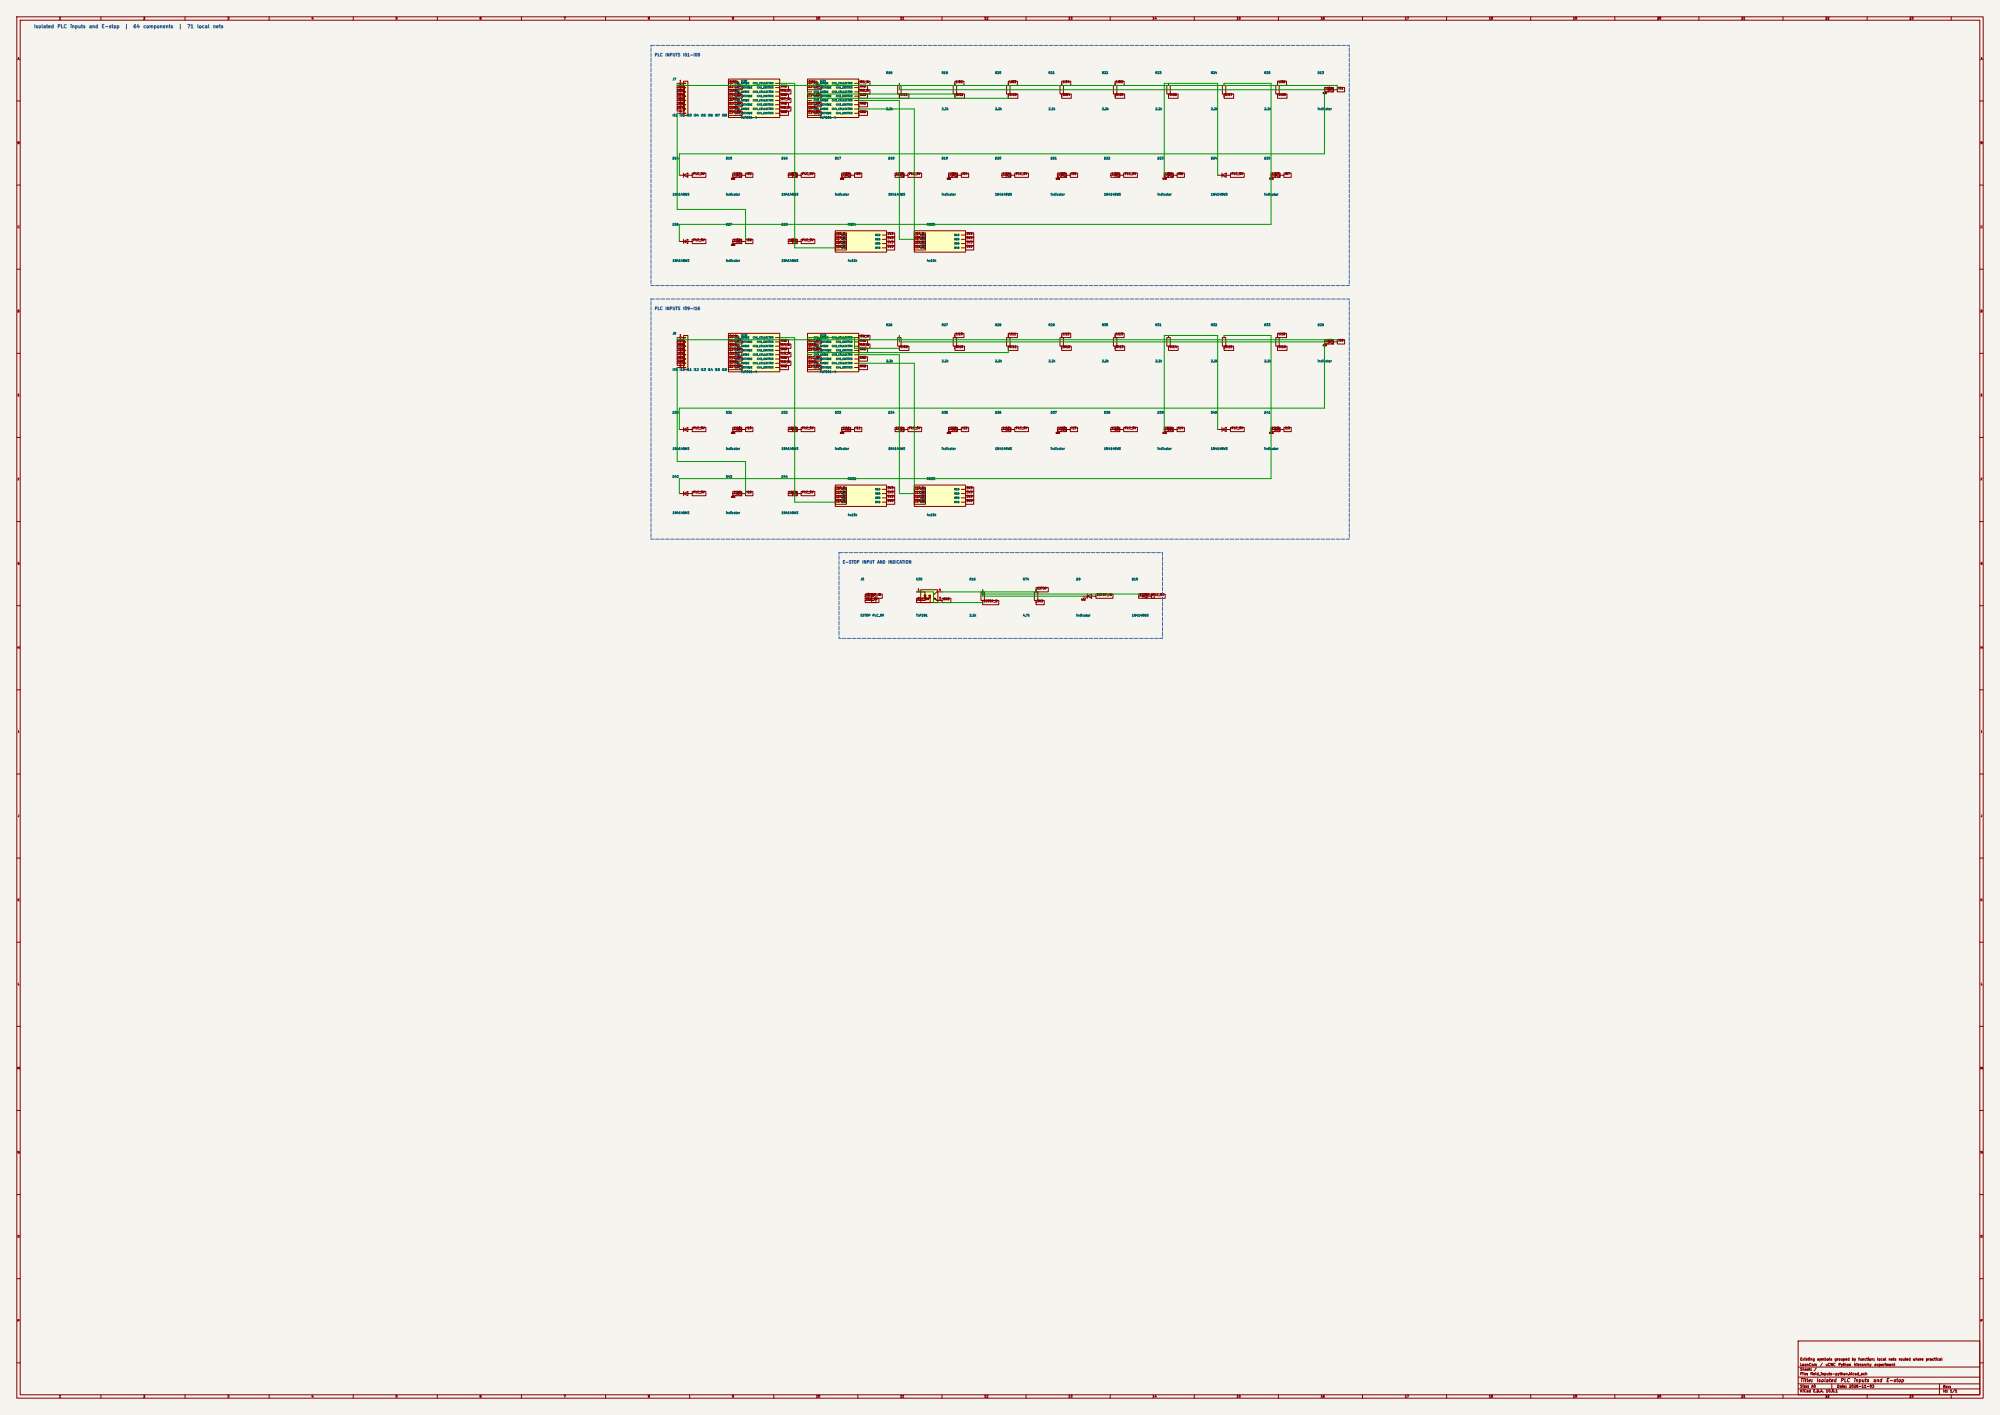
[picture p26: page 5]

Isolated PLC inputs and E-stop | 64 components | 71 local nets

OI15PLC_0V 2.2k | LI15 OI14

LI11 1N4148WS | indicator 1N4148WS

E-STOP INPUT AND INDICATION

File: field_inputs-python.kicad_sch
Title: Isolated PLC inputs and E-stop

# 4x1k OE1_N

# 5VDIR4 DIR5

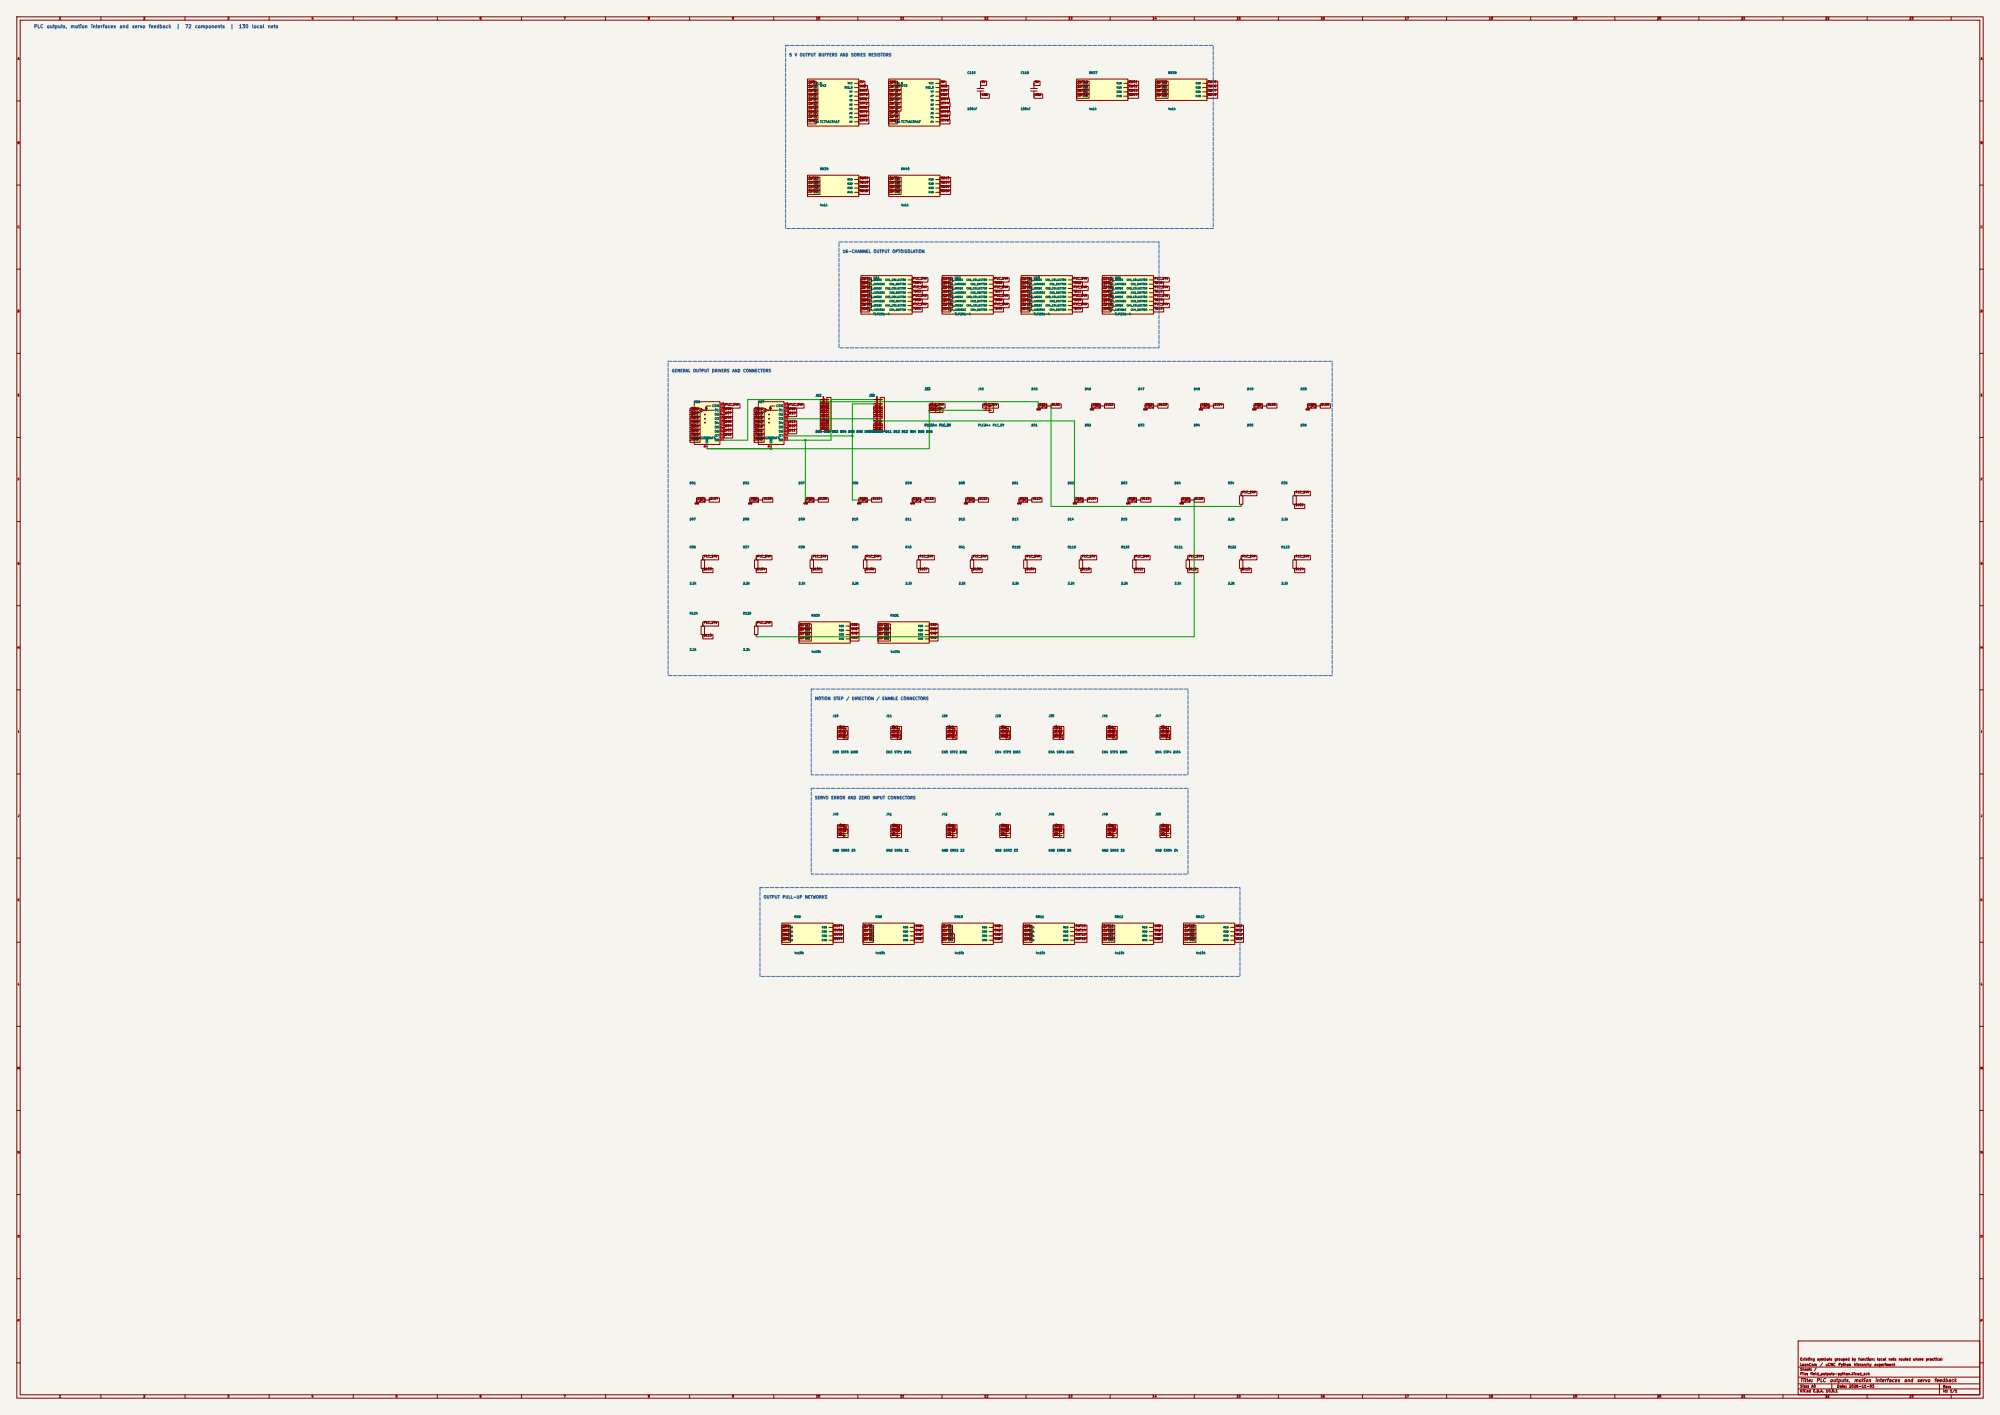
[picture p27: page 6]

PLC outputs, motion interfaces and servo feedback | 72 components | 130 local nets

5 V OUTPUT BUFFERS AND SERIES RESISTORS

MOTION STEP / DIRECTION / ENABLE CONNECTORS

SERVO ERROR AND ZERO INPUT CONNECTORS

OUTPUT PULL-UP NETWORKS

File: field_outputs-python.kicad_sch
Title: PLC outputs, motion interfaces and servo feedback

# GP46 GP44 GP42 GP40 GP38 GP36 GP34 GP32 GP30 GP28 GP26 GND

# 3V3 GP47 GP45 GP43 GP41 GP39 GP37 GP35 GP33 GP31 GP29 GP27 GP25

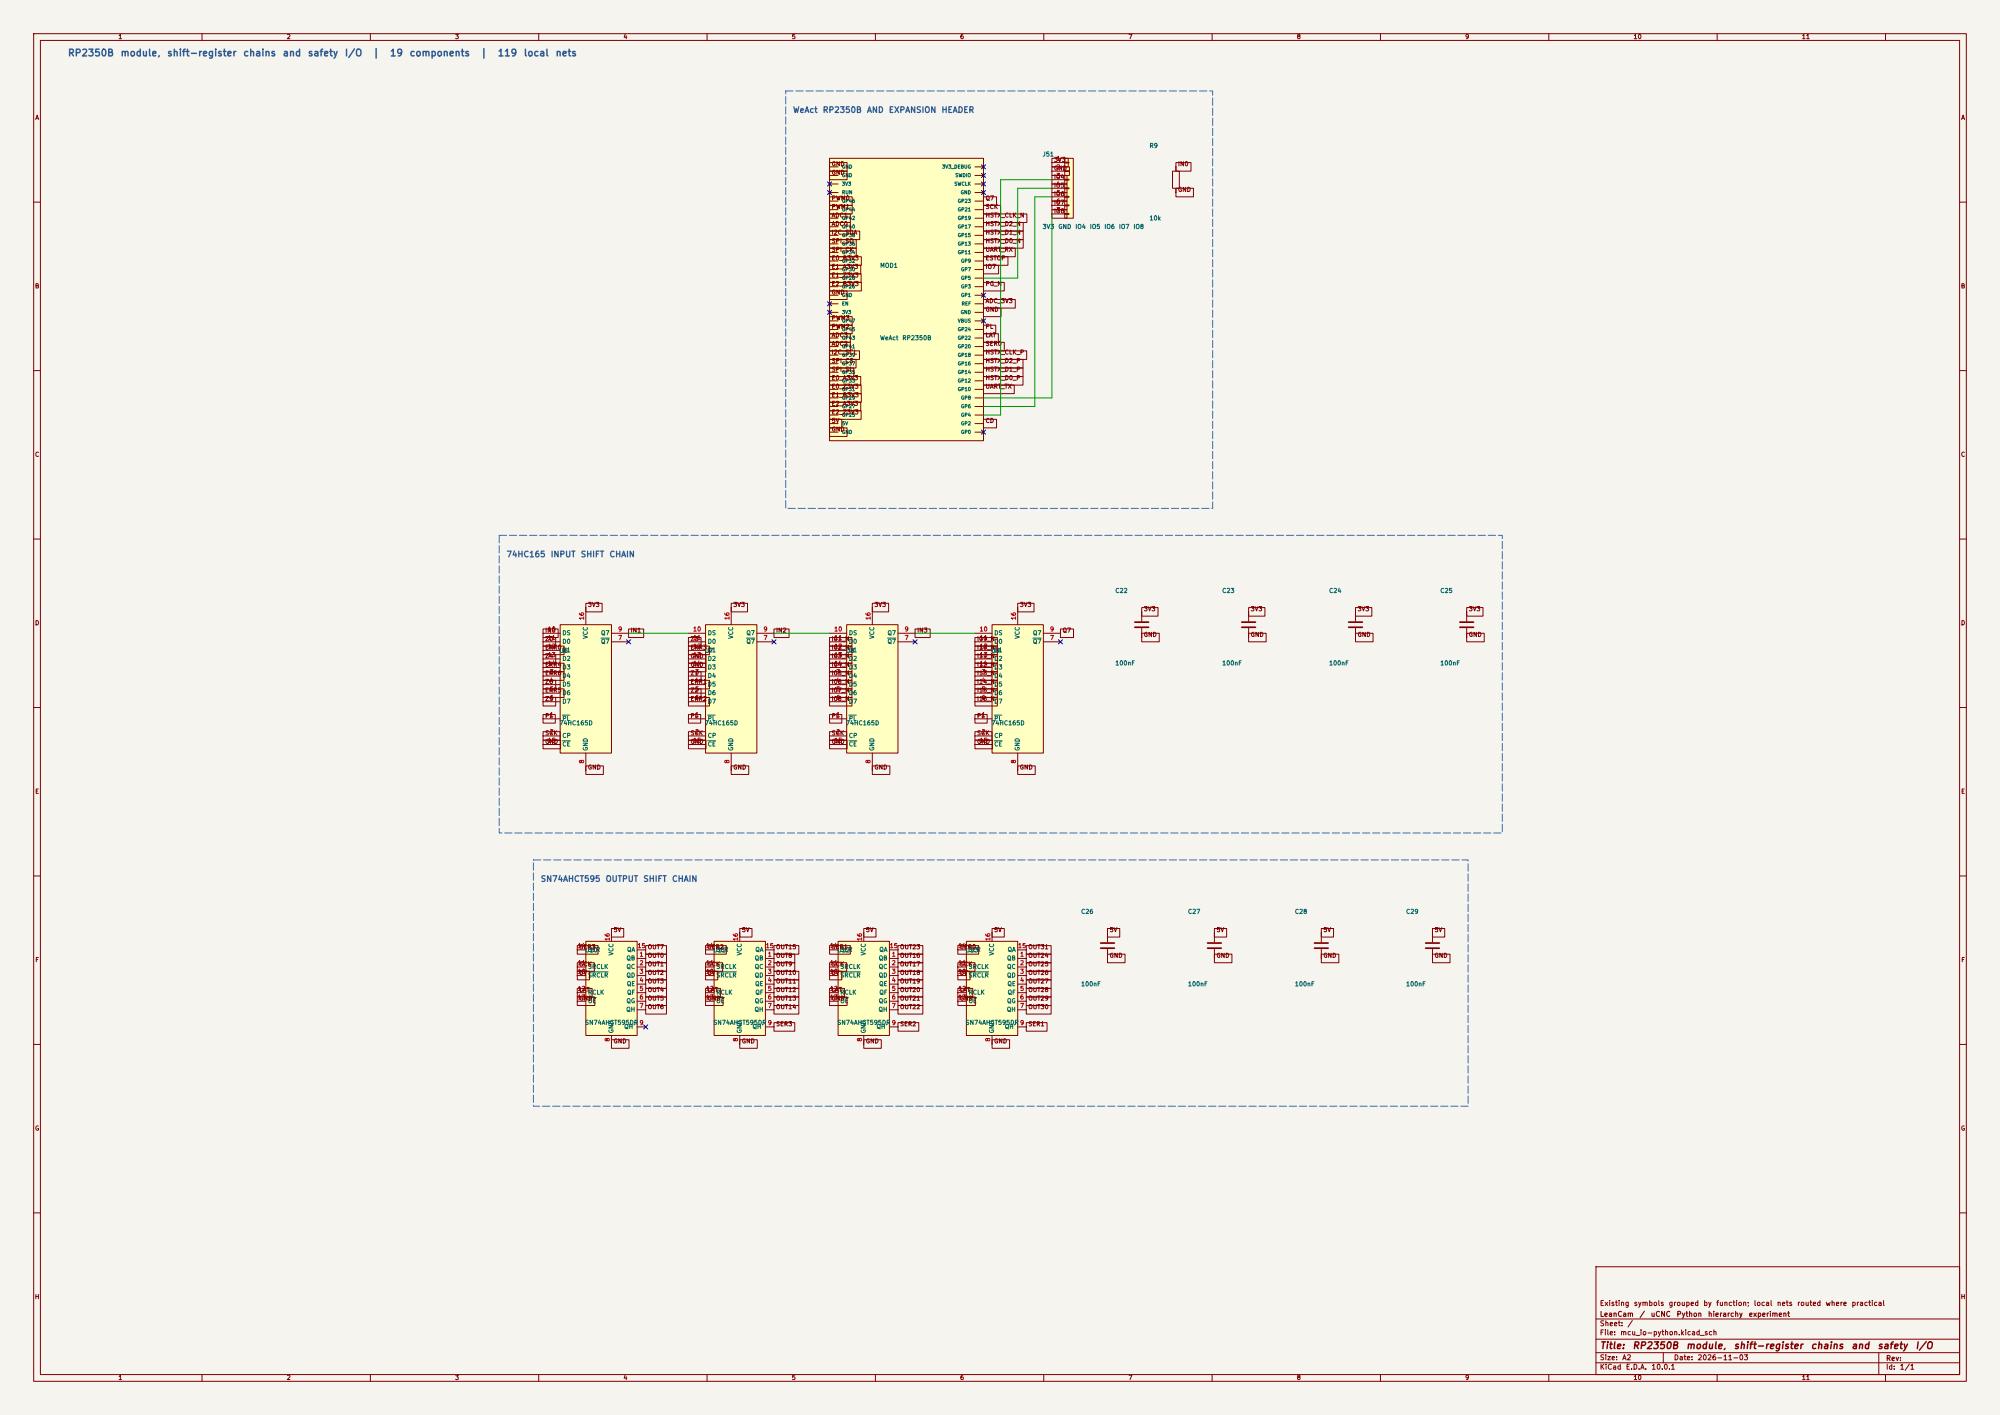
[picture p28: page 7]

RP2350B module, shift-register chains and safety I/O | 19 components | 119 local nets

SN74AHCT595DR QB 1 QC 2 QD 3 QE 4 QF 5 QG 6 QH 7 GND

100nF QB 1 QC 2 QD 3 QE 4 QF 5 QG 6 QH 7 GND

SRCLR 10 SRCLK 11 RCLK 12 OE 13
SCK

File: mcu_io-python.kicad_sch
Title: RP2350B module, shift-register chains and safety I/O

# J54 microSD TF15 GND

## GND MICROSD SOCKETS AND SERIES TERMINATION

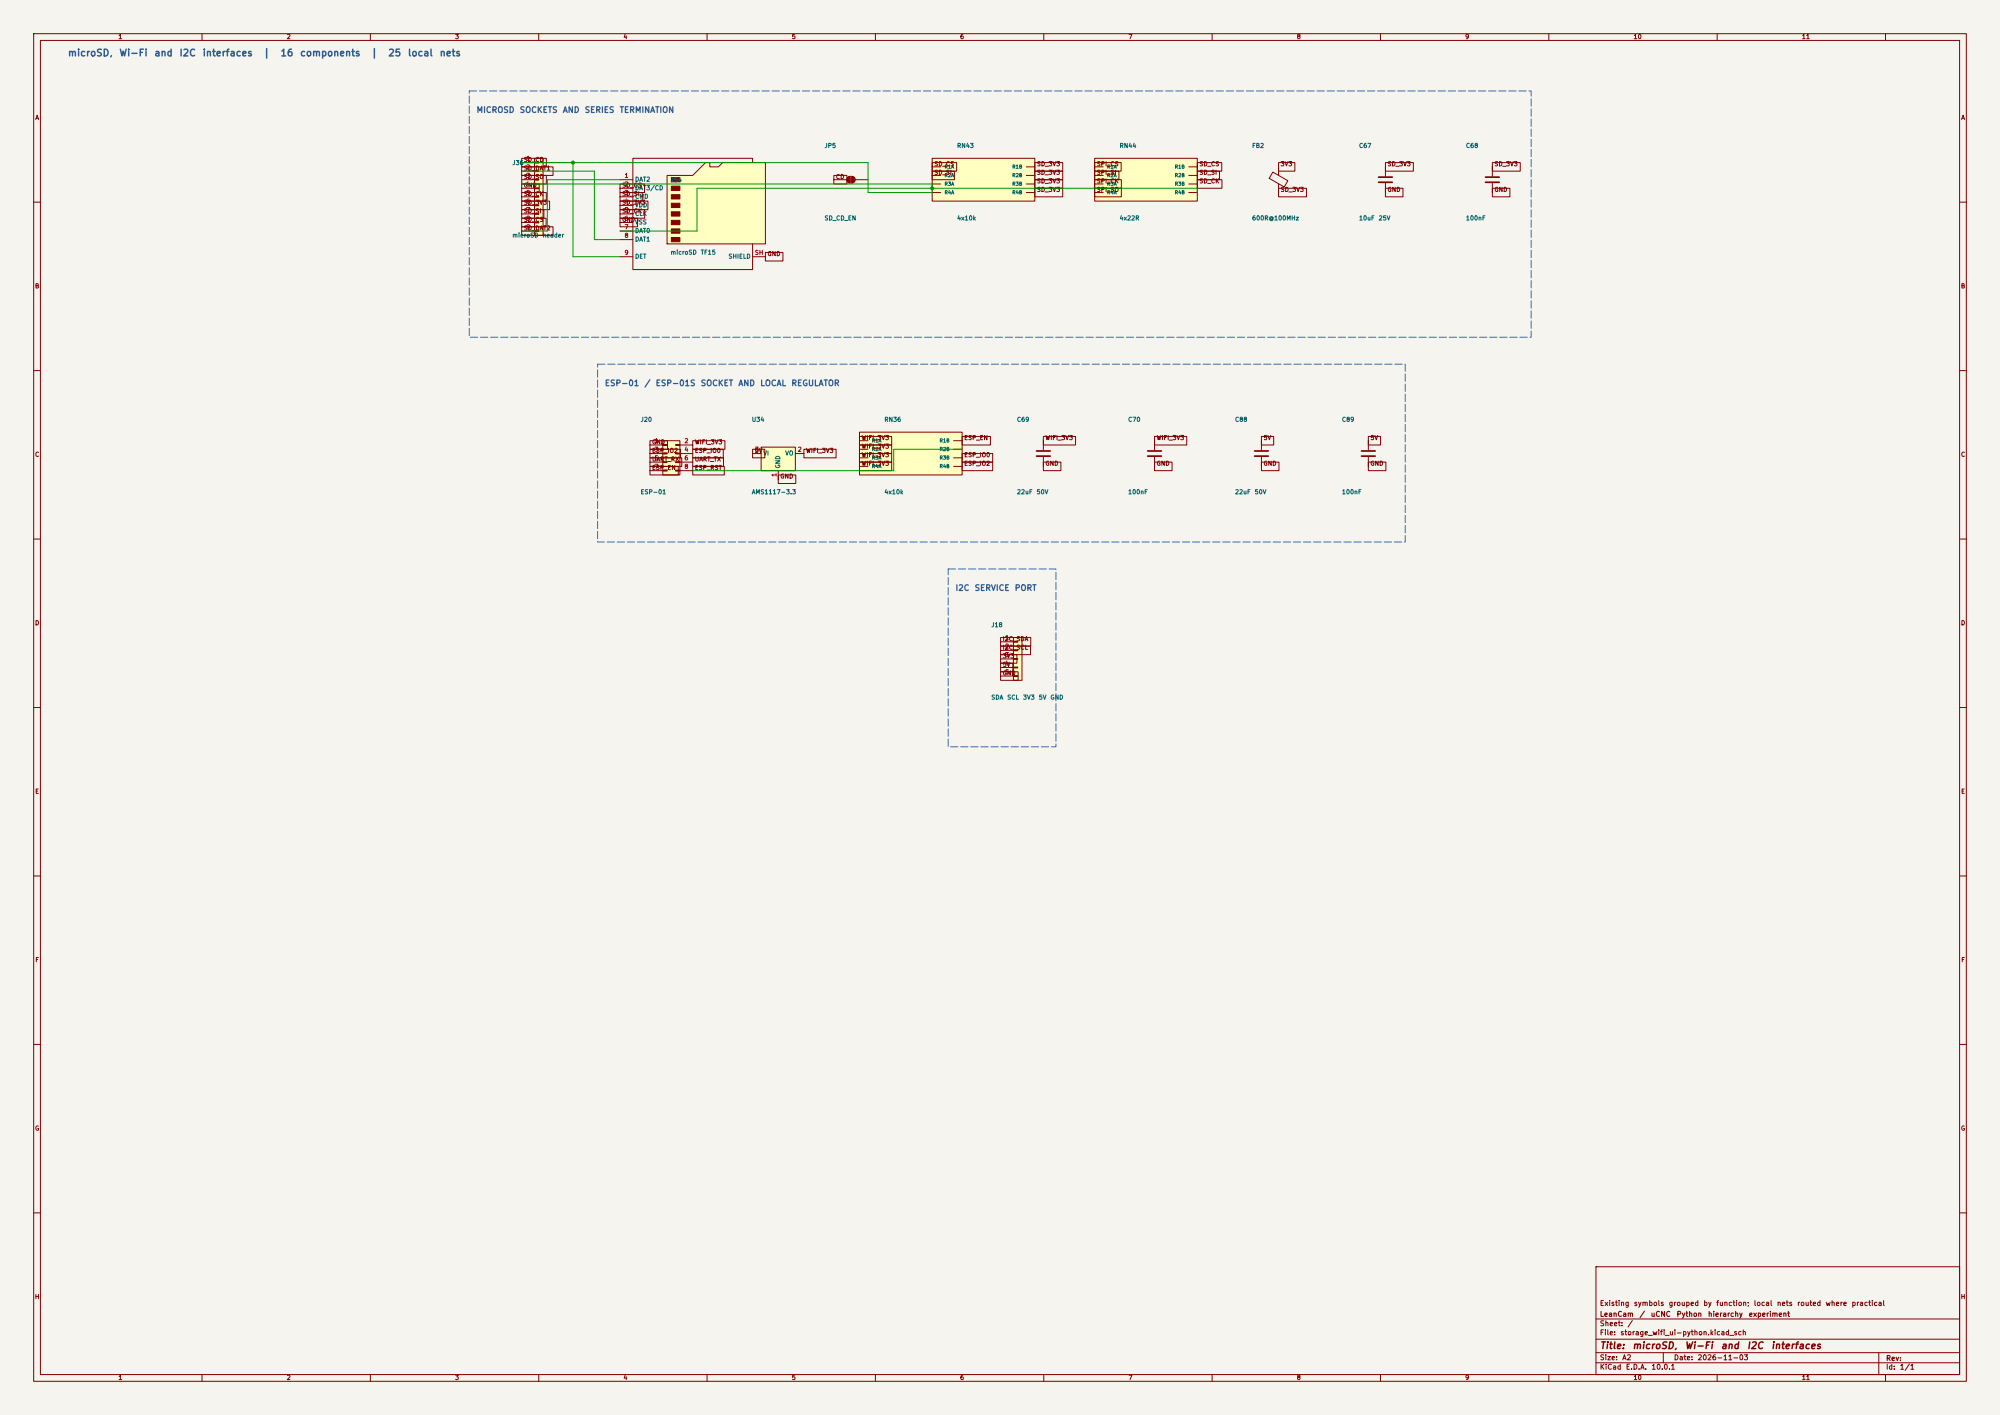
[picture p29: page 8]

microSD, Wi-Fi and I2C interfaces | 16 components | 25 local nets

ESP-01 / ESP-01S SOCKET AND LOCAL REGULATOR

File: storage_wifi_ui-python.kicad_sch
Title: microSD, Wi-Fi and I2C interfaces
