staskaaa-netizen/uCNC_Pi_Board/experiments/power-schematic-readability/schematic-a-vs-b.pdf

# SS16 1 2 C2

# 100nF 1 2 R70

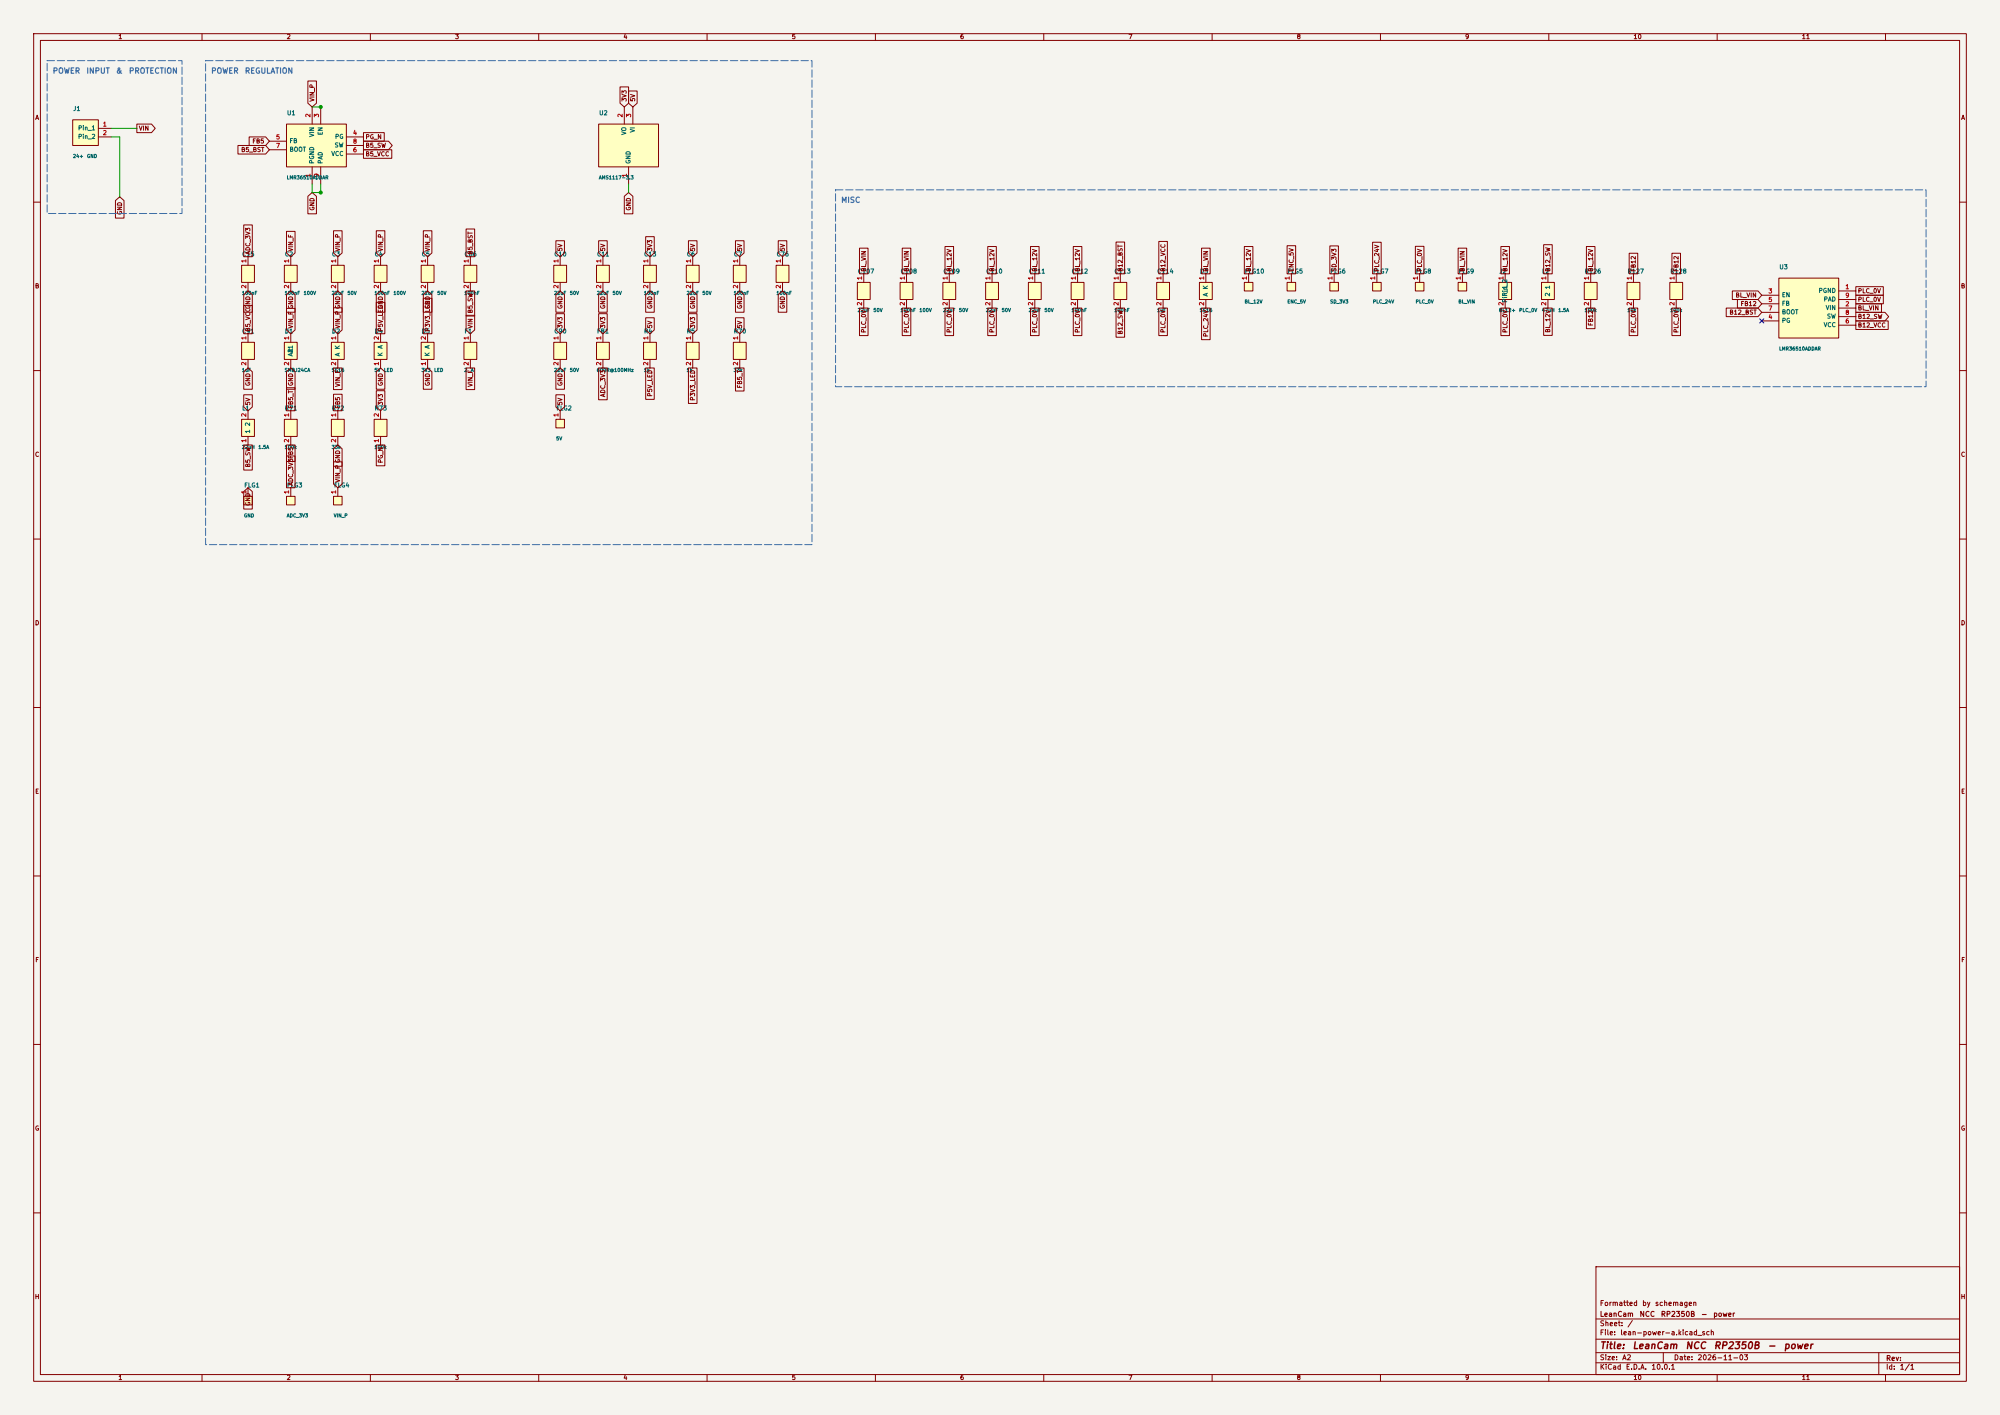
[picture p30: page 1]

Formatted by schemagen
LeanCam NCC RP2350B - power
Sheet: /
File: lean-power-a.kicad_sch
Title: LeanCam NCC RP2350B - power
KiCad E.D.A. 10.0.1

# 100nF C2

# Power distribution, protection and local regulation | 55 components | 25 local nets


24 V INPUT, FUSE, CLAMP AND REVERSE-POLARITY PROTECTION

5 V BUCK CONVERTER, FEEDBACK AND OUTPUT CAPACITORS

3V3 POINT-OF-LOAD REGULATOR AND ANALOG FILTER

Method B: authoritative KiCad symbols grouped by power flow GND

ISOLATED PLC-24 V TO 12 V BACKLIGHT CONVERTER

OFF-SHEET POWER AND GROUND REFERENCES

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
