staskaaa-netizen/uCNC_Pi_Board/manufacturing/packages/uCNC_Pi_Board_SMT_Assembly/assembly-back.pdf

BACK - B.Cu / B.Silkscreen / B.Fab (viewed from back)
