staskaaa-netizen/uCNC_Pi_Board/experiments/power-schematic-readability/method-a/lean-power-a.pdf

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

Size: A2 | Rev:
KiCad E.D.A. 10.0.1 | Id: 1/1
