staskaaa-netizen/uCNC_Pi_Board/experiments/power-schematic-readability/other-sheets/analog_io-python.pdf

Analog inputs, 0-10 V outputs and 12 V rail | 43 components | 31 local nets

Existing symbols grouped by function; local nets routed where practical
LeanCam / uCNC Python hierarchy experiment
Sheet: /
File: analog_io-python.kicad_sch
Title: Analog inputs, 0-10 V outputs and 12 V rail

Size: A1 | Rev:
KiCad E.D.A. 10.0.1 | Id: 1/1
