staskaaa-netizen/uCNC_Pi_Board/experiments/power-schematic-readability/other-sheets/display-python.pdf

LVDS transmitter, termination and connector | 3 components | 18 local nets

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

Size: A3 | Rev: | F Date: 2026-11-03
KiCad E.D.A. 10.0.1 | Id: 1/1
