staskaaa-netizen/uCNC_Pi_Board/experiments/power-schematic-readability/other-sheets/field_inputs-python.pdf

Isolated PLC inputs and E-stop | 64 components | 71 local nets

E-STOP INPUT AND INDICATION

Existing symbols grouped by function; local nets routed where practical
LeanCam / uCNC Python hierarchy experiment
Sheet: /
File: field_inputs-python.kicad_sch
Title: Isolated PLC inputs and E-stop

Size: A0 | Rev:
KiCad E.D.A. 10.0.1 | Id: 1/1
