staskaaa-netizen/uCNC_Pi_Board/experiments/power-schematic-readability/other-sheets/field_outputs-python.pdf

PLC outputs, motion interfaces and servo feedback | 72 components | 130 local nets

5 V OUTPUT BUFFERS AND SERIES RESISTORS

GENERAL OUTPUT DRIVERS AND CONNECTORS

MOTION STEP / DIRECTION / ENABLE CONNECTORS

SERVO ERROR AND ZERO INPUT CONNECTORS

OUTPUT PULL-UP NETWORKS

Existing symbols grouped by function; local nets routed where practical
LeanCam / uCNC Python hierarchy experiment
Sheet: /
File: field_outputs-python.kicad_sch
Title: PLC outputs, motion interfaces and servo feedback

Size: A0 | Rev:
KiCad E.D.A. 10.0.1 | Id: 1/1
