staskaaa-netizen/uCNC_Pi_Board/experiments/power-schematic-readability/other-sheets/mcu_io-python.pdf

RP2350B module, shift-register chains and safety I/O | 19 components | 119 local nets

SRCLR 10 SRCLK 11 RCLK 12 OE 13
SCK

Existing symbols grouped by function; local nets routed where practical
LeanCam / uCNC Python hierarchy experiment
Sheet: /
File: mcu_io-python.kicad_sch
Title: RP2350B module, shift-register chains and safety I/O

Size: A2 | Rev:
KiCad E.D.A. 10.0.1 | Id: 1/1
