staskaaa-netizen/uCNC_Pi_Board/experiments/power-schematic-readability/other-sheets/storage_wifi_ui-python.pdf

microSD, Wi-Fi and I2C interfaces | 16 components | 25 local nets

GND MICROSD SOCKETS AND SERIES TERMINATION

ESP-01 / ESP-01S SOCKET AND LOCAL REGULATOR

Existing symbols grouped by function; local nets routed where practical
LeanCam / uCNC Python hierarchy experiment
Sheet: /
File: storage_wifi_ui-python.kicad_sch
Title: microSD, Wi-Fi and I2C interfaces

Size: A2 | Rev:
KiCad E.D.A. 10.0.1 | Id: 1/1
