staskaaa-netizen/uCNC_Pi_Board/experiments/power-schematic-readability/inputs/source-power.pdf

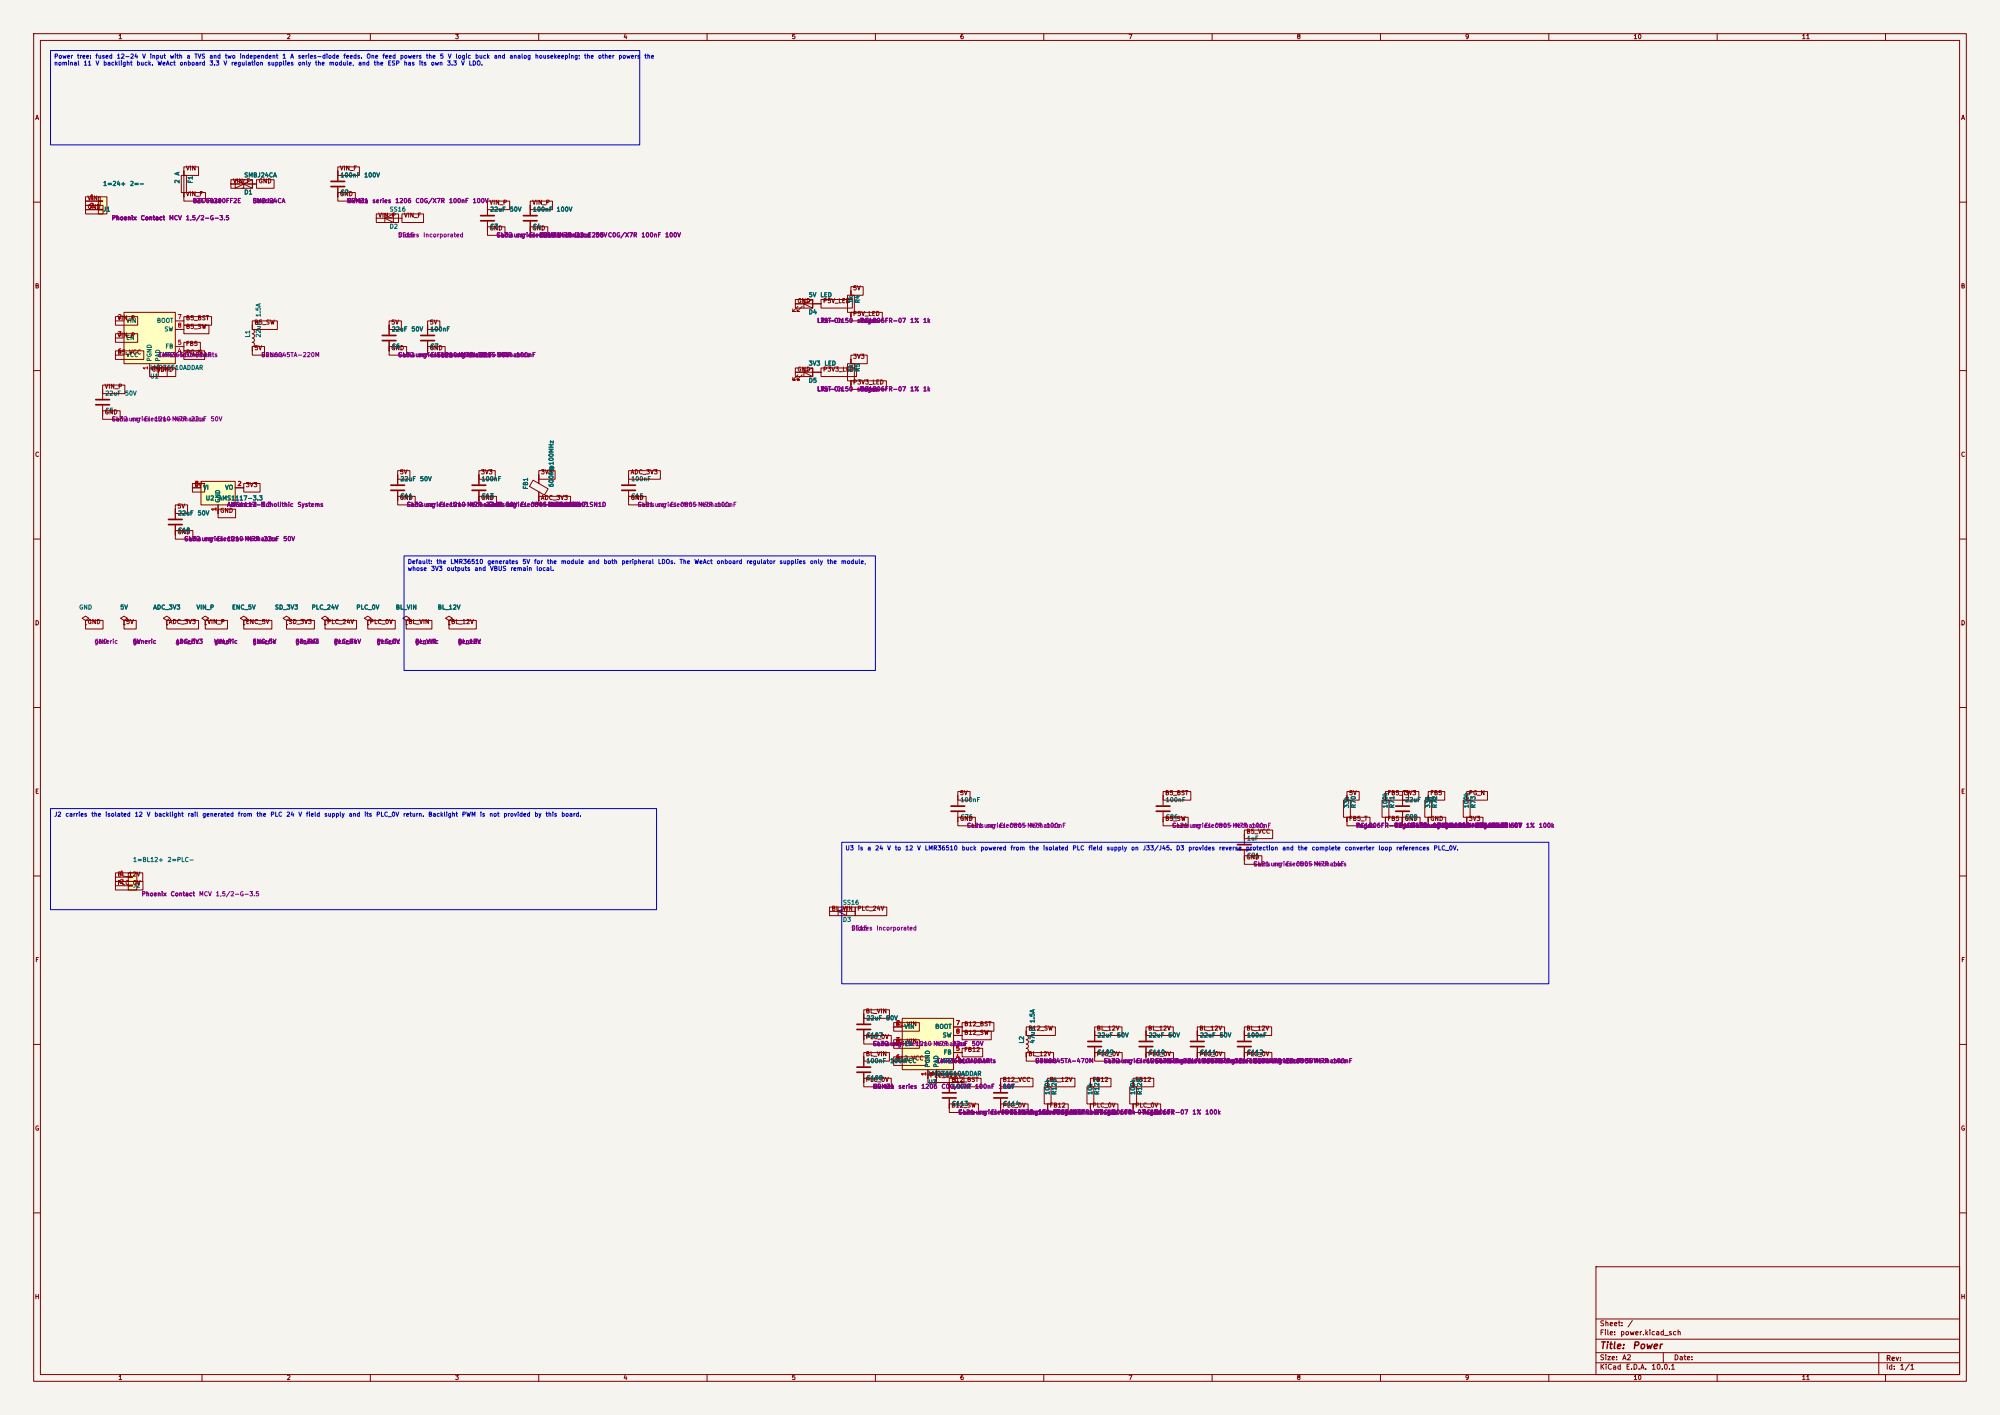
[picture p31: page 1]

22uF 50V CL32 Samsung series Electro-Mechanics 1210 X7R 22uF 50V C4

100nF Samsung CL21 series Electro-Mechanics 0805 X7R 100nF C3

22uF 50V CL32 Samsung series Electro-Mechanics 1210 X7R 22uF 50V C7

22uF 50V CL32 Samsung series Electro-Mechanics 1210 X7R 22uF 50V PGND
B5_VCC

100nF Samsung CL21 series Electro-Mechanics 0805 X7R 100nF BL_12VBL_12V generic C7
GND

3V3 GND
100nF Samsung CL21 series Electro-Mechanics 0805 X7R 100nF

AMS1117-3.3 Advanced Monolithic Systems GND

22uF 50V CL32 Samsung series Electro-Mechanics 1210 X7R 22uF 50V

Default: the LMR36510 generates 5V for the module and both peripheral LDOs. The WeAct onboard regulator supplies only the module, whose 3V3 outputs and VBUS remain local. C10

100nF Samsung CL21 series Electro-Mechanics 0805 X7R 100nF L247uH 1.5A SRN6045TA-470M Bourns C113

100nF Samsung CL21 series Electro-Mechanics 0805 X7R 100nF C76

BL_VIN
100nF Samsung CL21 series Electro-Mechanics 0805 X7R 100nF C107

22uF 50V CL32 Samsung series Electro-Mechanics 1210 X7R 22uF 50V U3

22uF 50V CL32 Samsung series Electro-Mechanics 1210 X7R 22uF 50V C114

100nF Samsung CL21 series Electro-Mechanics 0805 X7R 100nF C111

B12_BST

Size: A2 | Rev:
KiCad E.D.A. 10.0.1 | Id: 1/1
