staskaaa-netizen/uCNC_Pi_Board/(list of files, drawings)

Other design files:
hardware/motherboard.dsn
