staskaaa-netizen/uCNC_Pi_Board/hardware/motherboard.kicad_pcb

## KiCad design hardware/motherboard.kicad_pcb (2026-11-07)

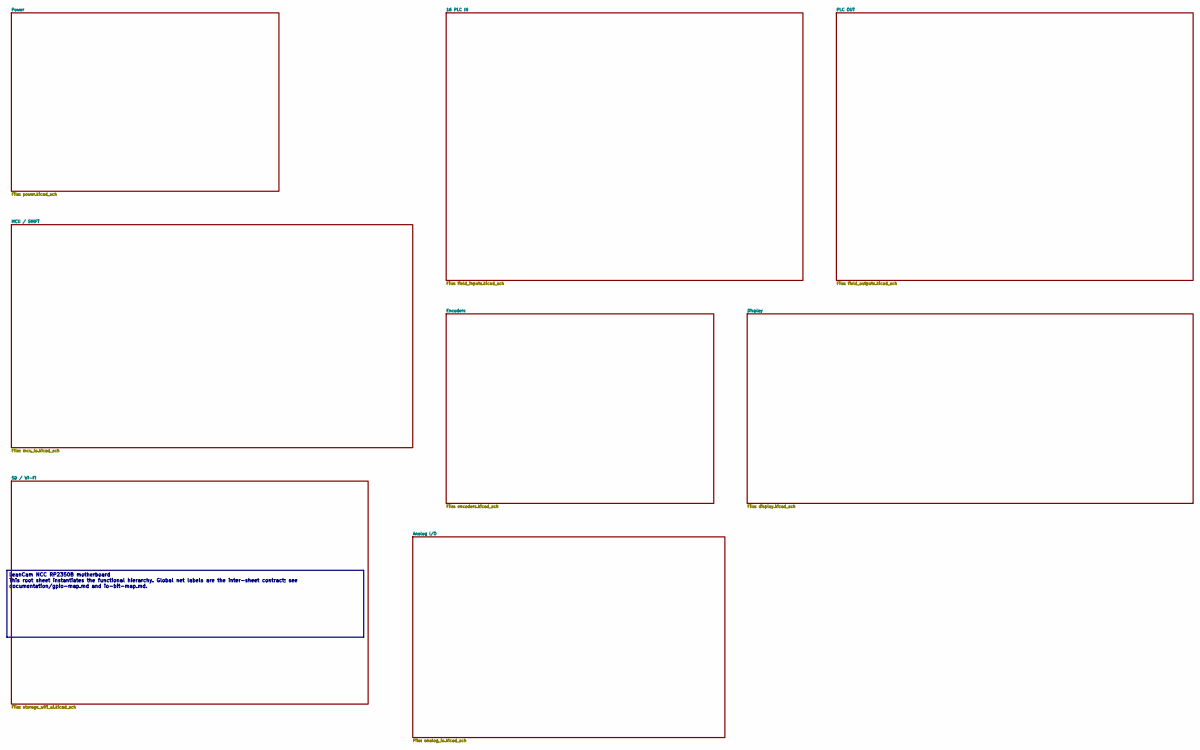
[picture p32: schematic motherboard.kicad_sch, LeanCam NCC RP2350B Motherboard]

Notes on the sheet:
LeanCam NCC RP2350B motherboard This root sheet instantiates the functional hierarchy. Global net labels are the inter-sheet contract; see documentation/gpio-map.md and io-bit-map.md.

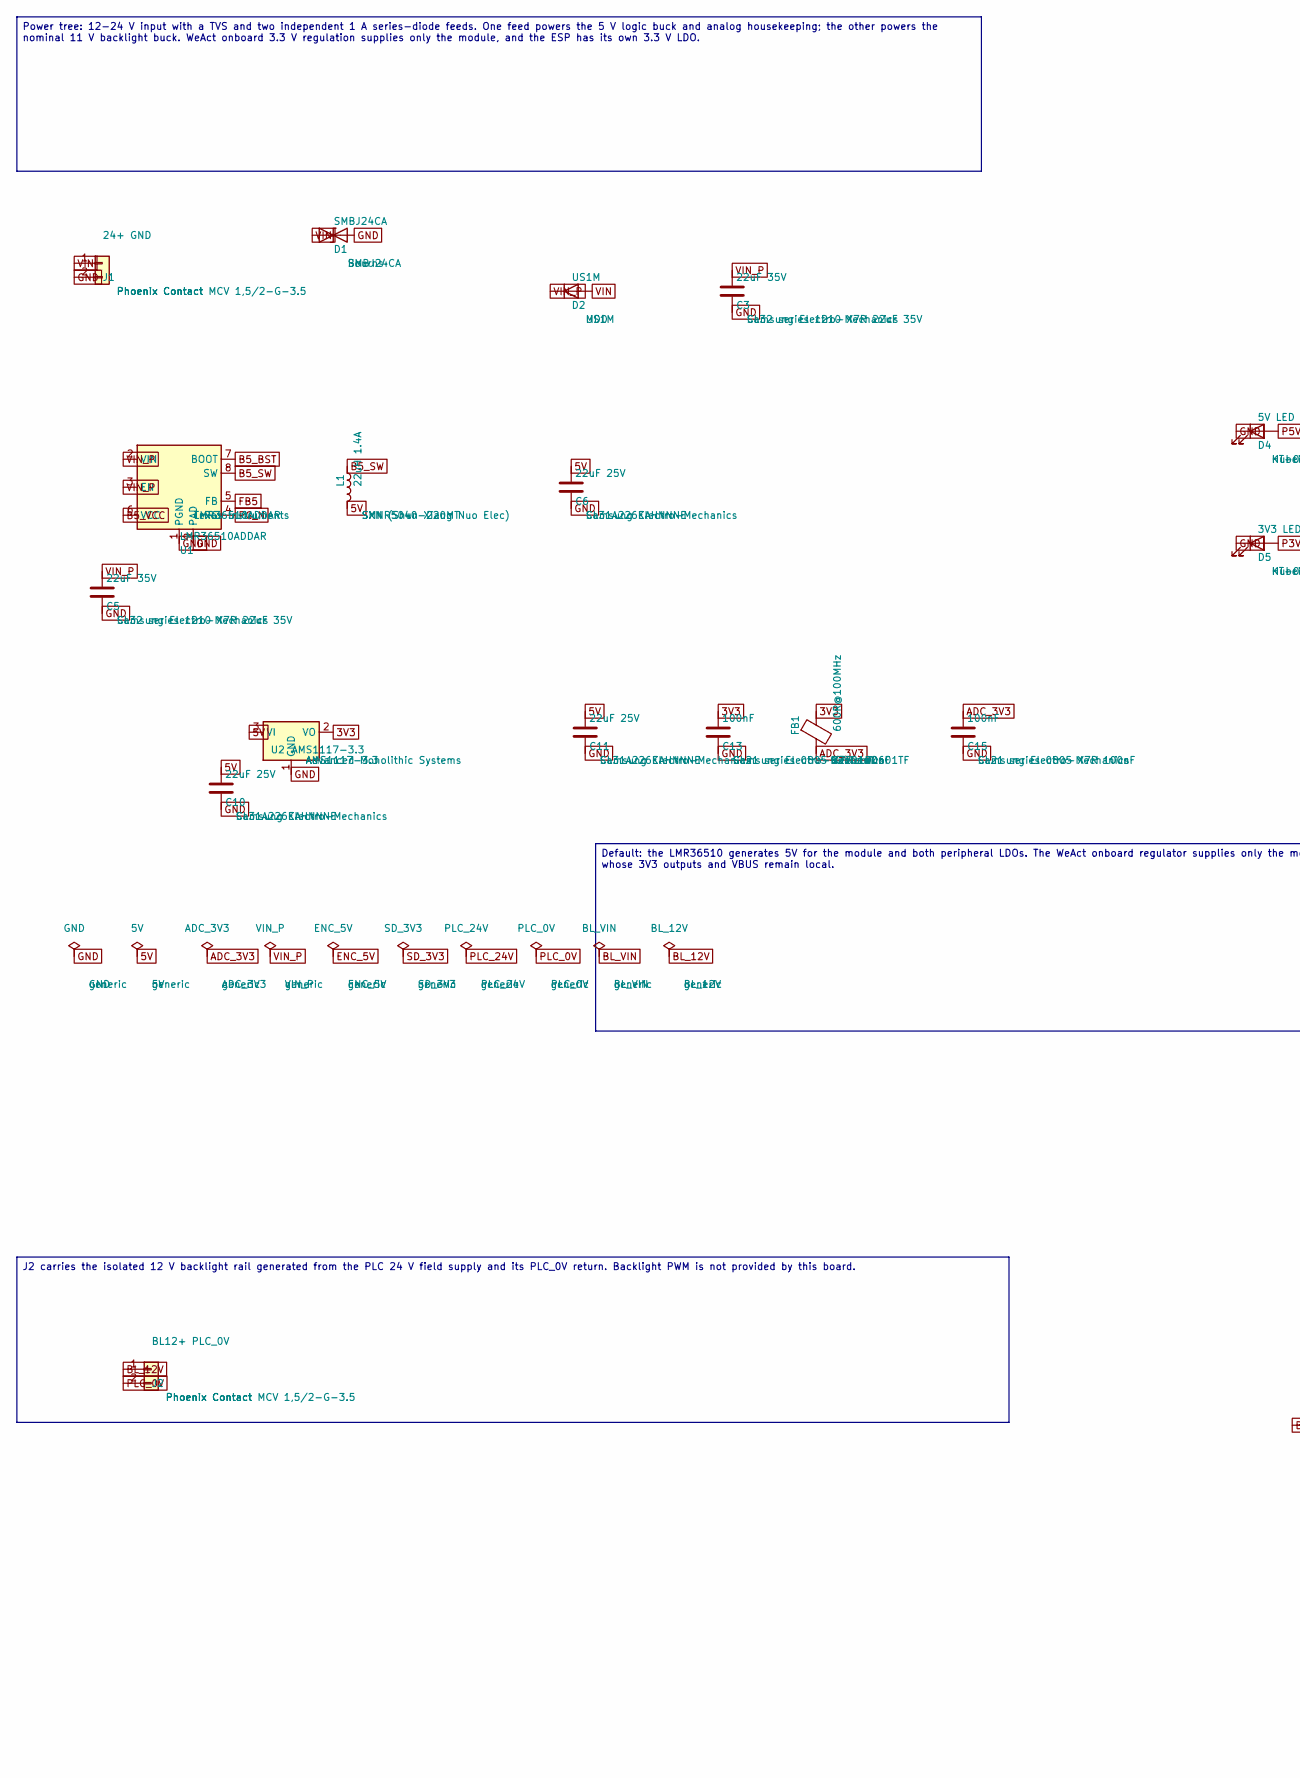
[picture p33: schematic power.kicad_sch, part in row 1, column 1]

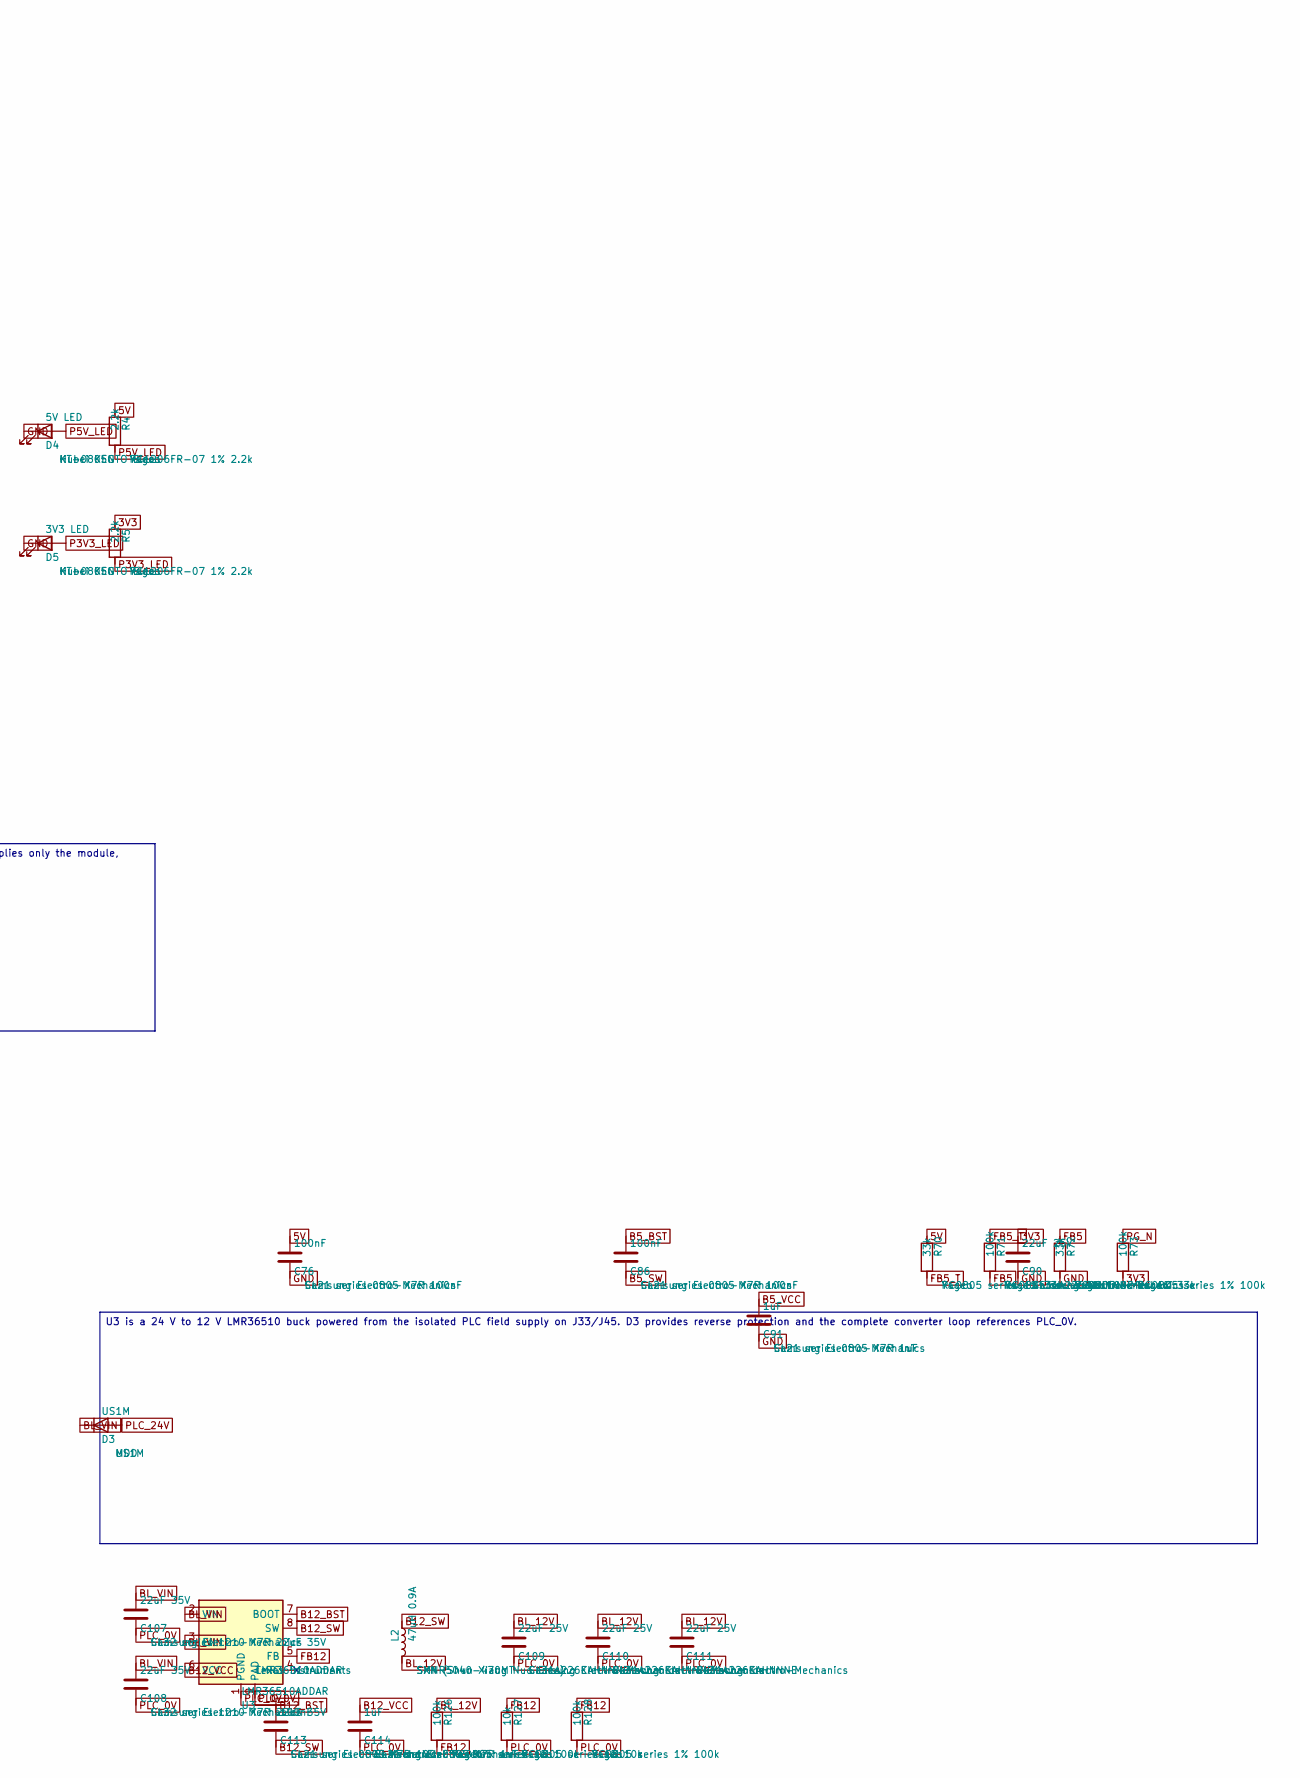
[picture p34: schematic power.kicad_sch, part in row 1, column 2]

Parts:
C3, C5, C107, C108: 22uF 35V; C_1210_3225Metric; MPN CL32 series 1210 X7R 22uF 35V
C6, C10, C11, C90, C109, C110, C111: 22uF 25V; C_1206_3216Metric; MPN CL31A226KAHNNNE
C13, C15, C76, C86, C113: 100nF; C_0805_2012Metric; MPN CL21 series 0805 X7R 100nF
C91, C114: 1uF; C_0805_2012Metric; MPN CL21 series 0805 X7R 1uF
D1: SMBJ24CA; D_SMB; MPN SMBJ24CA
D2, D3: US1M; D_SMA; MPN US1M
D4: 5V LED; LED_0805_2012Metric; MPN KT-0805G
D5: 3V3 LED; LED_0805_2012Metric; MPN KT-0805G
FB1: 600R@100MHz; R_0805_2012Metric; MPN GZ2012D601TF
FLG1: GND; MPN GND
FLG2: 5V; MPN 5V
FLG3: ADC_3V3; MPN ADC_3V3
FLG4: VIN_P; MPN VIN_P
FLG5: ENC_5V; MPN ENC_5V
FLG6: SD_3V3; MPN SD_3V3
FLG7: PLC_24V; MPN PLC_24V
FLG8: PLC_0V; MPN PLC_0V
FLG9: BL_VIN; MPN BL_VIN
FLG10: BL_12V; MPN BL_12V
J1: 24+ GND; PhoenixContact_MCV_1,5_2-G-3.5_1x02_P3.50mm_Vertical; MPN Phoenix Contact MCV 1,5/2-G-3.5
J2: BL12+ PLC_0V; PhoenixContact_MCV_1,5_2-G-3.5_1x02_P3.50mm_Vertical; MPN Phoenix Contact MCV 1,5/2-G-3.5
L1: 22uH 1.4A; L_SXN_SMNR5040; MPN SMNR5040-220MT
L2: 47uH 0.9A; L_SXN_SMNR5040; MPN SMNR5040-470MT
R4, R5: 2.2k; R_1206_3216Metric; MPN RC1206FR-07 1% 2.2k
R70, R72: 33k; R_0805_2012Metric; MPN RC0805 series 1% 33k
R71, R73, R126, R128: 100k; R_0805_2012Metric; MPN RC0805 series 1% 100k
R127: 10k; R_0805_2012Metric; MPN RC0805 series 1% 10k
U1, U3: LMR36510ADDAR; SOIC-8-1EP_3.9x4.9mm_P1.27mm_EP2.41x3.3mm; MPN LMR36510ADDAR
U2: AMS1117-3.3; SOT-223-3_TabPin2; MPN AMS1117-3.3

Connections:
3V3: C13.1, C90.1, FB1.1, R5.1, R73.2, U2.2 (VO); also elsewhere on the board
5V: C6.1, C10.1, C11.1, C76.1, FLG2.1, L1.2, R4.1, R70.1, U2.3 (VI); also elsewhere on the board
ADC_3V3: C15.1, FB1.2, FLG3.1; also elsewhere on the board
B5_BST: C86.1, U1.7 (BOOT)
B5_SW: C86.2, L1.1, U1.8 (SW)
B5_VCC: C91.1, U1.6 (VCC)
B12_BST: C113.1, U3.7 (BOOT)
B12_SW: C113.2, L2.1, U3.8 (SW)
B12_VCC: C114.1, U3.6 (VCC)
BL_12V: C109.1, C110.1, C111.1, FLG10.1, J2.1, L2.2, R126.1
BL_VIN: C107.1, C108.1, D3.1 (K), FLG9.1, U3.2 (VIN), U3.3 (EN)
FB5: R71.2, R72.1, U1.5 (FB)
FB5_T: R70.2, R71.1
FB12: R126.2, R127.1, R128.1, U3.5 (FB)
GND: C3.2, C5.2, C6.2, C10.2, C11.2, C13.2, C15.2, C76.2, C90.2, C91.2, D1.2 (A2), D4.1 (K), D5.1 (K), FLG1.1, J1.2, R72.2, U1.1 (PGND), U1.9 (PAD), U2.1 (GND); also elsewhere on the board
P3V3_LED: D5.2 (A), R5.2
P5V_LED: D4.2 (A), R4.2
PG_N: R73.1, U1.4 (PG); also elsewhere on the board
PLC_0V: C107.2, C108.2, C109.2, C110.2, C111.2, C114.2, FLG8.1, J2.2, R127.2, R128.2, U3.1 (PGND), U3.9 (PAD); also elsewhere on the board
PLC_24V: D3.2 (A), FLG7.1; also elsewhere on the board
VIN: D1.1 (A1), D2.2 (A), J1.1
VIN_P: C3.1, C5.1, D2.1 (K), FLG4.1, U1.2 (VIN), U1.3 (EN); also elsewhere on the board

Notes on the sheet:
Power tree: 12-24 V input with a TVS and two independent 1 A series-diode feeds. One feed powers the 5 V logic buck and analog housekeeping; the other powers the nominal 11 V backlight buck. WeAct onboard 3.3 V regulation supplies only the module, and the ESP has its own 3.3 V LDO.
Default: the LMR36510 generates 5V for the module and both peripheral LDOs. The WeAct onboard regulator supplies only the module, whose 3V3 outputs and VBUS remain local.
J2 carries the isolated 12 V backlight rail generated from the PLC 24 V field supply and its PLC_0V return. Backlight PWM is not provided by this board.
U3 is a 24 V to 12 V LMR36510 buck powered from the isolated PLC field supply on J33/J45. D3 provides reverse protection and the complete converter loop references PLC_0V.

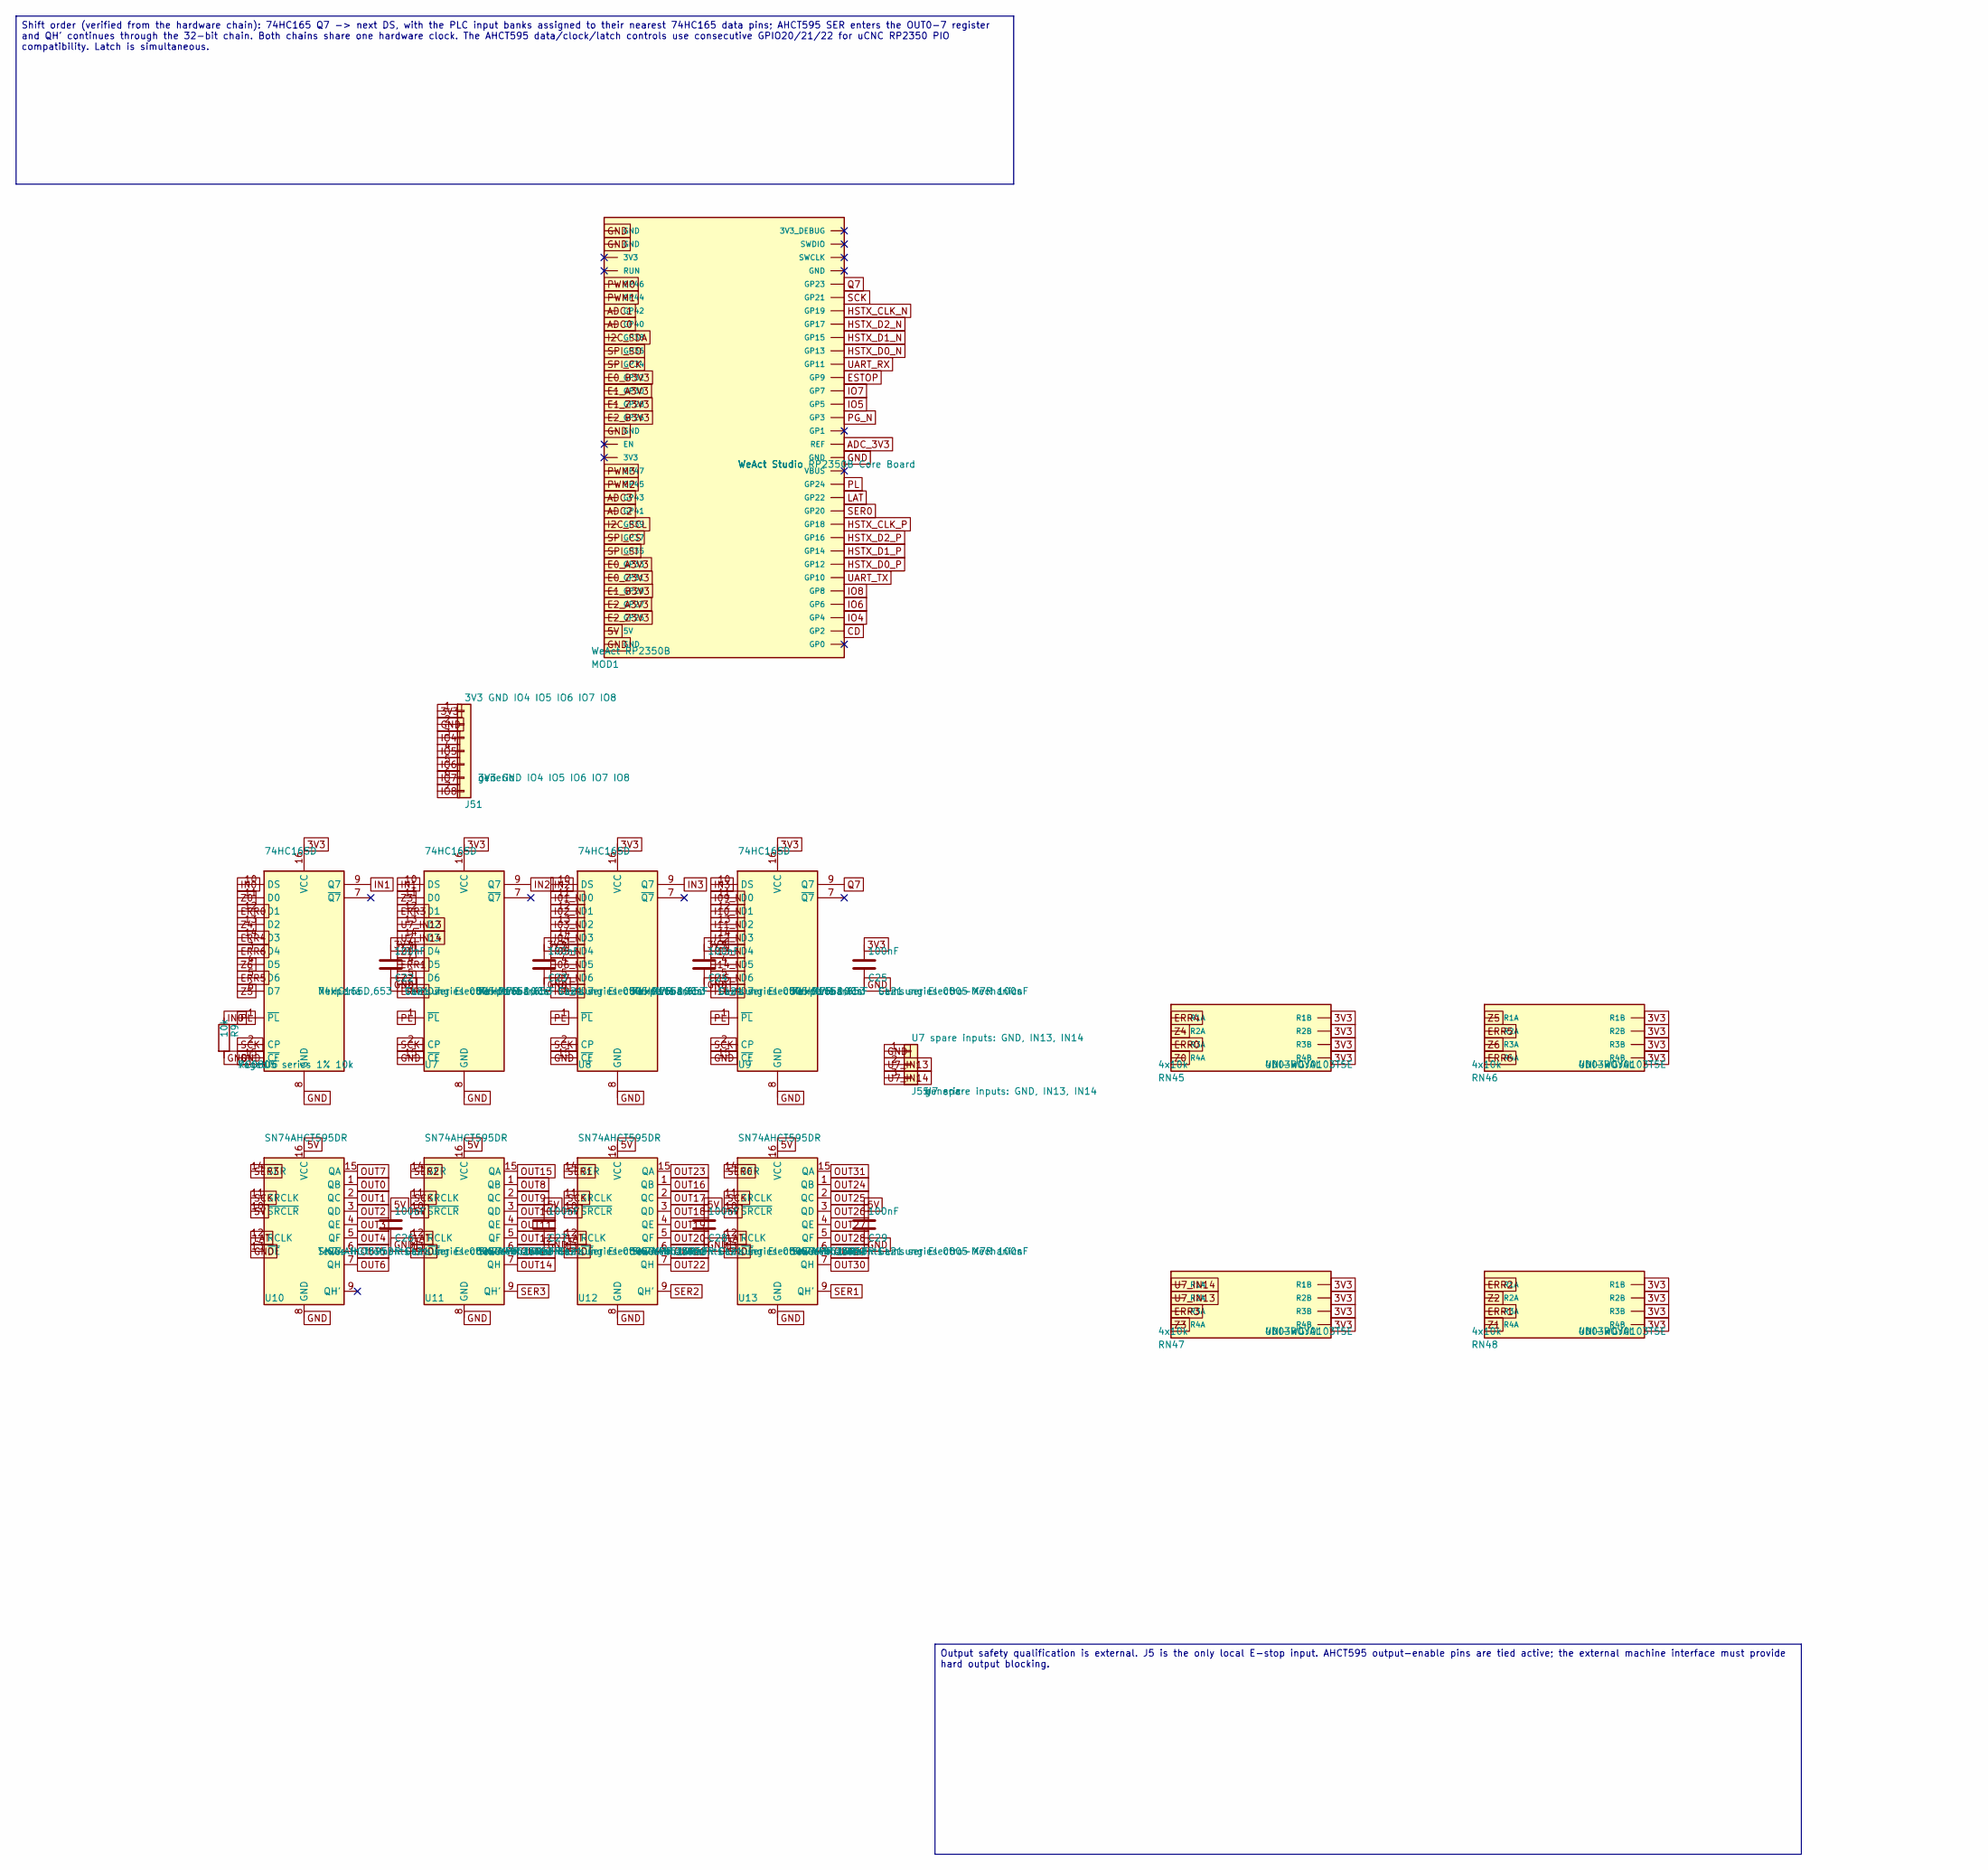
[picture p35: schematic mcu_io.kicad_sch, MCU / SHIFT]

Parts:
C22, C23, C24, C25, C26, C27, C28, C29: 100nF; C_0805_2012Metric; MPN CL21 series 0805 X7R 100nF
J51: 3V3 GND IO4 IO5 IO6 IO7 IO8; PinSocket_1x07_P2.54mm_Vertical; MPN 3V3 GND IO4 IO5 IO6 IO7 IO8
J55: U7 spare inputs: GND, IN13, IN14; PinHeader_1x03_P2.54mm_Vertical; MPN U7 spare inputs: GND, IN13, IN14
MOD1: WeAct RP2350B; WeAct_RP2350B_Socket; MPN WeAct Studio RP2350B Core Board
R9: 10k; R_0805_2012Metric; MPN RC0805 series 1% 10k
RN45, RN46, RN47, RN48: 4x10k; R_Array_Convex_4x0603; MPN 4D03WGJ0103T5E
U6, U7, U8, U9: 74HC165D; SOIC-16_3.9x9.9mm_P1.27mm; MPN 74HC165D,653
U10, U11, U12, U13: SN74AHCT595DR; SOIC-16_3.9x9.9mm_P1.27mm; MPN SN74AHCT595DR

Connections:
3V3: C22.1, C23.1, C24.1, C25.1, J51.1, RN45.5 (R4B), RN45.6 (R3B), RN45.7 (R2B), RN45.8 (R1B), RN46.5 (R4B), RN46.6 (R3B), RN46.7 (R2B), RN46.8 (R1B), RN47.5 (R4B), RN47.6 (R3B), RN47.7 (R2B), RN47.8 (R1B), RN48.5 (R4B), RN48.6 (R3B), RN48.7 (R2B), RN48.8 (R1B), U6.16 (VCC), U7.16 (VCC), U8.16 (VCC), U9.16 (VCC); also elsewhere on the board
5V: C26.1, C27.1, C28.1, C29.1, MOD1.31 (5V), U10.10 (~SRCLR), U10.16 (VCC), U11.10 (~SRCLR), U11.16 (VCC), U12.10 (~SRCLR), U12.16 (VCC), U13.10 (~SRCLR), U13.16 (VCC); also elsewhere on the board
ADC0: MOD1.8 (GP40); also elsewhere on the board
ADC1: MOD1.7 (GP42); also elsewhere on the board
ADC2: MOD1.22 (GP41); also elsewhere on the board
ADC3: MOD1.21 (GP43); also elsewhere on the board
ADC_3V3: MOD1.48 (REF); also elsewhere on the board
CD: MOD1.34 (GP2); also elsewhere on the board
E0_A3V3: MOD1.26 (GP33); also elsewhere on the board
E0_B3V3: MOD1.12 (GP32); also elsewhere on the board
E0_Z3V3: MOD1.27 (GP31); also elsewhere on the board
E1_A3V3: MOD1.13 (GP30); also elsewhere on the board
E1_B3V3: MOD1.28 (GP29); also elsewhere on the board
E1_Z3V3: MOD1.14 (GP28); also elsewhere on the board
E2_A3V3: MOD1.29 (GP27); also elsewhere on the board
E2_B3V3: MOD1.15 (GP26); also elsewhere on the board
E2_Z3V3: MOD1.30 (GP25); also elsewhere on the board
ERR0: RN45.3 (R3A), U6.12 (D1); also elsewhere on the board
ERR1: RN48.3 (R3A), U7.4 (D5); also elsewhere on the board
ERR2: RN48.1 (R1A), U7.6 (D7); also elsewhere on the board
ERR3: RN47.3 (R3A), U7.12 (D1); also elsewhere on the board
ERR4: RN45.1 (R1A), U6.14 (D3); also elsewhere on the board
ERR5: RN46.2 (R2A), U6.5 (D6); also elsewhere on the board
ERR6: RN46.4 (R4A), U6.3 (D4); also elsewhere on the board
ESTOP: MOD1.53 (GP9); also elsewhere on the board
GND: C22.2, C23.2, C24.2, C25.2, C26.2, C27.2, C28.2, C29.2, J51.2, J55.1, MOD1.1 (GND), MOD1.2 (GND), MOD1.16 (GND), MOD1.32 (GND), MOD1.47 (GND), R9.2, U6.8 (GND), U6.15 (~CE), U7.8 (GND), U7.15 (~CE), U8.8 (GND), U8.15 (~CE), U9.8 (GND), U9.15 (~CE), U10.8 (GND), U10.13 (~OE), U11.8 (GND), U11.13 (~OE), U12.8 (GND), U12.13 (~OE), U13.8 (GND), U13.13 (~OE); also elsewhere on the board
HSTX_CLK_N: MOD1.58 (GP19); also elsewhere on the board
HSTX_CLK_P: MOD1.42 (GP18); also elsewhere on the board
HSTX_D0_N: MOD1.55 (GP13); also elsewhere on the board
HSTX_D0_P: MOD1.39 (GP12); also elsewhere on the board
HSTX_D1_N: MOD1.56 (GP15); also elsewhere on the board
HSTX_D1_P: MOD1.40 (GP14); also elsewhere on the board
HSTX_D2_N: MOD1.57 (GP17); also elsewhere on the board
HSTX_D2_P: MOD1.41 (GP16); also elsewhere on the board
I01_N: U8.11 (D0); also elsewhere on the board
I2C_SCL: MOD1.23 (GP39); also elsewhere on the board
I2C_SDA: MOD1.9 (GP38); also elsewhere on the board
I02_N: U8.12 (D1); also elsewhere on the board
I03_N: U8.13 (D2); also elsewhere on the board
I04_N: U8.14 (D3); also elsewhere on the board
I05_N: U8.3 (D4); also elsewhere on the board
I06_N: U8.4 (D5); also elsewhere on the board
I07_N: U8.5 (D6); also elsewhere on the board
I08_N: U8.6 (D7); also elsewhere on the board
I09_N: U9.11 (D0); also elsewhere on the board
I10_N: U9.12 (D1); also elsewhere on the board
I11_N: U9.13 (D2); also elsewhere on the board
I12_N: U9.14 (D3); also elsewhere on the board
I13_N: U9.3 (D4); also elsewhere on the board
I14_N: U9.4 (D5); also elsewhere on the board
I15_N: U9.5 (D6); also elsewhere on the board
I16_N: U9.6 (D7); also elsewhere on the board
IN0: R9.1, U6.10 (DS)
IN1: U6.9 (Q7), U7.10 (DS)
IN2: U7.9 (Q7), U8.10 (DS)
IN3: U8.9 (Q7), U9.10 (DS)
IO4: J51.3, MOD1.35 (GP4)
IO5: J51.4, MOD1.51 (GP5)
IO6: J51.5, MOD1.36 (GP6)
IO7: J51.6, MOD1.52 (GP7)
IO8: J51.7, MOD1.37 (GP8)
LAT: MOD1.44 (GP22), U10.12 (RCLK), U11.12 (RCLK), U12.12 (RCLK), U13.12 (RCLK)
OUT0: U10.1 (QB); also elsewhere on the board
OUT1: U10.2 (QC); also elsewhere on the board
OUT2: U10.3 (QD); also elsewhere on the board
OUT3: U10.4 (QE); also elsewhere on the board
OUT4: U10.5 (QF); also elsewhere on the board
OUT5: U10.6 (QG); also elsewhere on the board
OUT6: U10.7 (QH); also elsewhere on the board
OUT7: U10.15 (QA); also elsewhere on the board
OUT8: U11.1 (QB); also elsewhere on the board
OUT9: U11.2 (QC); also elsewhere on the board
OUT10: U11.3 (QD); also elsewhere on the board
OUT11: U11.4 (QE); also elsewhere on the board
OUT12: U11.5 (QF); also elsewhere on the board
OUT13: U11.6 (QG); also elsewhere on the board
OUT14: U11.7 (QH); also elsewhere on the board
OUT15: U11.15 (QA); also elsewhere on the board
OUT16: U12.1 (QB); also elsewhere on the board
OUT17: U12.2 (QC); also elsewhere on the board
OUT18: U12.3 (QD); also elsewhere on the board
OUT19: U12.4 (QE); also elsewhere on the board
OUT20: U12.5 (QF); also elsewhere on the board
OUT21: U12.6 (QG); also elsewhere on the board
OUT22: U12.7 (QH); also elsewhere on the board
OUT23: U12.15 (QA); also elsewhere on the board
OUT24: U13.1 (QB); also elsewhere on the board
OUT25: U13.2 (QC); also elsewhere on the board
OUT26: U13.3 (QD); also elsewhere on the board
OUT27: U13.4 (QE); also elsewhere on the board
OUT28: U13.5 (QF); also elsewhere on the board
OUT29: U13.6 (QG); also elsewhere on the board
OUT30: U13.7 (QH); also elsewhere on the board
OUT31: U13.15 (QA); also elsewhere on the board
PG_N: MOD1.50 (GP3); also elsewhere on the board
PL: MOD1.45 (GP24), U6.1 (~PL), U7.1 (~PL), U8.1 (~PL), U9.1 (~PL)
PWM0: MOD1.5 (GP46); also elsewhere on the board
PWM1: MOD1.6 (GP44); also elsewhere on the board
PWM2: MOD1.20 (GP45); also elsewhere on the board
PWM3: MOD1.19 (GP47); also elsewhere on the board
Q7: MOD1.60 (GP23), U9.9 (Q7)
SCK: MOD1.59 (GP21), U6.2 (CP), U7.2 (CP), U8.2 (CP), U9.2 (CP), U10.11 (SRCLK), U11.11 (SRCLK), U12.11 (SRCLK), U13.11 (SRCLK)
SER0: MOD1.43 (GP20), U13.14 (SER)
SER1: U12.14 (SER), U13.9 (QH')
SER2: U11.14 (SER), U12.9 (QH')
SER3: U10.14 (SER), U11.9 (QH')
SPI_CK: MOD1.11 (GP34); also elsewhere on the board
SPI_CS: MOD1.24 (GP37); also elsewhere on the board
SPI_SI: MOD1.25 (GP35); also elsewhere on the board
SPI_SO: MOD1.10 (GP36); also elsewhere on the board
U7_IN13: J55.2, RN47.2 (R2A), U7.13 (D2)
U7_IN14: J55.3, RN47.1 (R1A), U7.14 (D3)
UART_RX: MOD1.54 (GP11); also elsewhere on the board
UART_TX: MOD1.38 (GP10); also elsewhere on the board
Z0: RN45.4 (R4A), U6.11 (D0); also elsewhere on the board
Z1: RN48.4 (R4A), U7.3 (D4); also elsewhere on the board
Z2: RN48.2 (R2A), U7.5 (D6); also elsewhere on the board
Z3: RN47.4 (R4A), U7.11 (D0); also elsewhere on the board
Z4: RN45.2 (R2A), U6.13 (D2); also elsewhere on the board
Z5: RN46.1 (R1A), U6.6 (D7); also elsewhere on the board
Z6: RN46.3 (R3A), U6.4 (D5); also elsewhere on the board

Notes on the sheet:
Shift order (verified from the hardware chain): 74HC165 Q7 -> next DS, with the PLC input banks assigned to their nearest 74HC165 data pins; AHCT595 SER enters the OUT0-7 register and QH' continues through the 32-bit chain. Both chains share one hardware clock. The AHCT595 data/clock/latch controls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
Output safety qualification is external. J5 is the only local E-stop input. AHCT595 output-enable pins are tied active; the external machine interface must provide hard output blocking.
