staskaaa-netizen/uCNC_Pi_Board/hardware/motherboard.kicad_pcb

## KiCad design hardware/motherboard.kicad_pcb (continued)

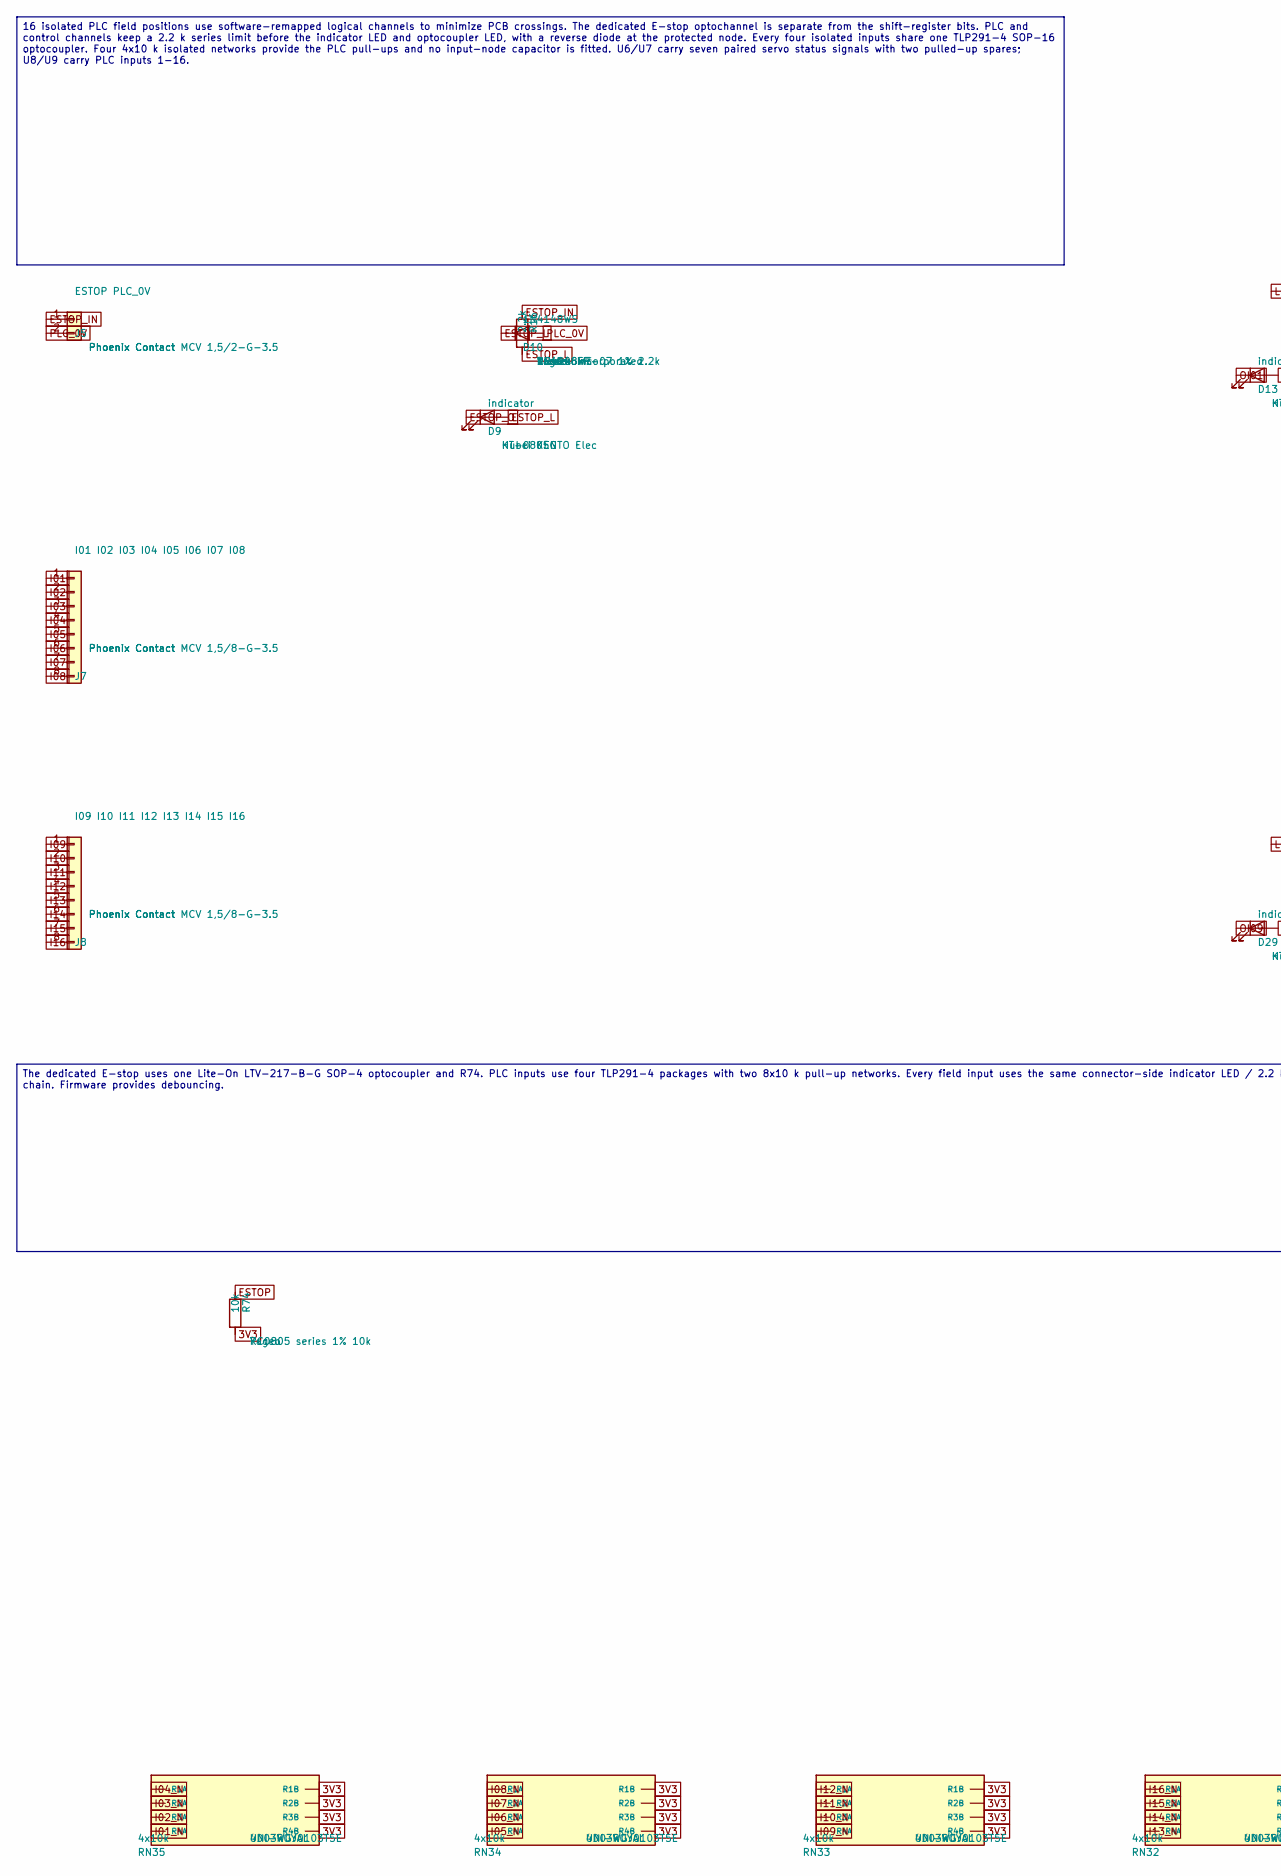
[picture p36: schematic field_inputs.kicad_sch, 16 PLC IN, part in row 1, column 1]

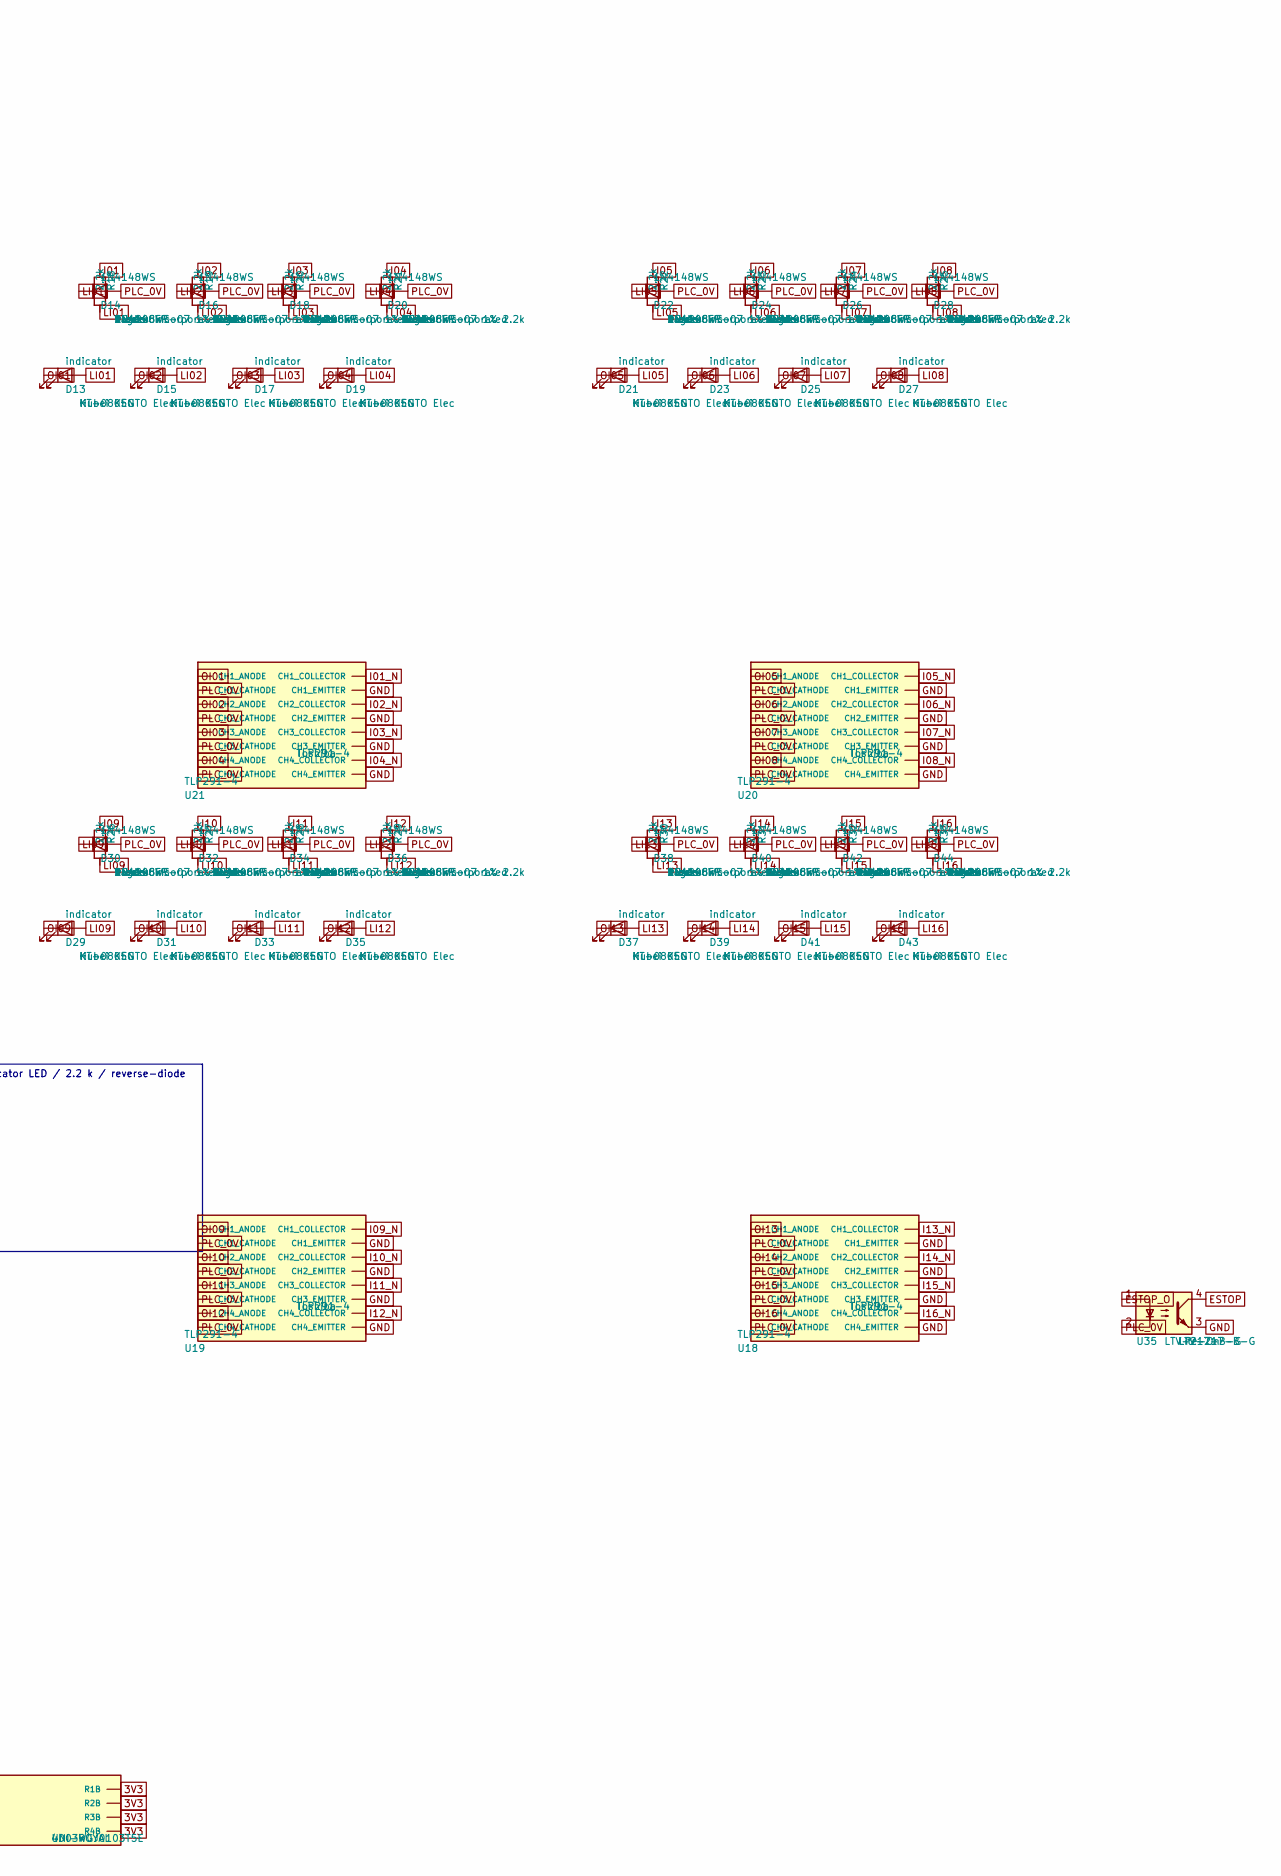
[picture p37: schematic field_inputs.kicad_sch, 16 PLC IN, part in row 1, column 2]

Parts:
D9, D13, D15, D17, D19, D21, D23, D25, D27, D29, D31, D33, D35, D37, D39, D41, D43: indicator; LED_0805_2012Metric; MPN KT-0805G
D10, D14, D16, D18, D20, D22, D24, D26, D28, D30, D32, D34, D36, D38, D40, D42, D44: 1N4148WS; D_SOD-323; MPN 1N4148WS
J5: ESTOP PLC_0V; PhoenixContact_MCV_1,5_2-G-3.5_1x02_P3.50mm_Vertical; MPN Phoenix Contact MCV 1,5/2-G-3.5
J7: I01 I02 I03 I04 I05 I06 I07 I08; PhoenixContact_MCV_1,5_8-G-3.5_1x08_P3.50mm_Vertical; MPN Phoenix Contact MCV 1,5/8-G-3.5
J8: I09 I10 I11 I12 I13 I14 I15 I16; PhoenixContact_MCV_1,5_8-G-3.5_1x08_P3.50mm_Vertical; MPN Phoenix Contact MCV 1,5/8-G-3.5
R16, R18, R19, R20, R21, R22, R23, R24, R25, R26, R27, R28, R29, R30, R31, R32, R33: 2.2k; R_1206_3216Metric; MPN RC1206FR-07 1% 2.2k
R74: 10k; R_0805_2012Metric; MPN RC0805 series 1% 10k
RN32, RN33, RN34, RN35: 4x10k; R_Array_Convex_4x0603; MPN 4D03WGJ0103T5E
U18, U19, U20, U21: TLP291-4; SOIC-16_4.55x10.3mm_P1.27mm; MPN TLP291-4
U35: LTV-217-B-G; SOIC-4_4.55x2.6mm_P1.27mm; MPN LTV-217-B-G

Connections:
3V3: R74.2, RN32.5 (R4B), RN32.6 (R3B), RN32.7 (R2B), RN32.8 (R1B), RN33.5 (R4B), RN33.6 (R3B), RN33.7 (R2B), RN33.8 (R1B), RN34.5 (R4B), RN34.6 (R3B), RN34.7 (R2B), RN34.8 (R1B), RN35.5 (R4B), RN35.6 (R3B), RN35.7 (R2B), RN35.8 (R1B); also elsewhere on the board
ESTOP: R74.1, U35.4; also elsewhere on the board
ESTOP_IN: J5.1, R16.1
ESTOP_L: D9.2 (A), D10.1 (K), R16.2
ESTOP_O: D9.1 (K), U35.1
GND: U18.9 (CH4_EMITTER), U18.11 (CH3_EMITTER), U18.13 (CH2_EMITTER), U18.15 (CH1_EMITTER), U19.9 (CH4_EMITTER), U19.11 (CH3_EMITTER), U19.13 (CH2_EMITTER), U19.15 (CH1_EMITTER), U20.9 (CH4_EMITTER), U20.11 (CH3_EMITTER), U20.13 (CH2_EMITTER), U20.15 (CH1_EMITTER), U21.9 (CH4_EMITTER), U21.11 (CH3_EMITTER), U21.13 (CH2_EMITTER), U21.15 (CH1_EMITTER), U35.3; also elsewhere on the board
I01: J7.1, R18.1
I01_N: RN35.4 (R4A), U21.16 (CH1_COLLECTOR); also elsewhere on the board
I02: J7.2, R19.1
I02_N: RN35.3 (R3A), U21.14 (CH2_COLLECTOR); also elsewhere on the board
I03: J7.3, R20.1
I03_N: RN35.2 (R2A), U21.12 (CH3_COLLECTOR); also elsewhere on the board
I04: J7.4, R21.1
I04_N: RN35.1 (R1A), U21.10 (CH4_COLLECTOR); also elsewhere on the board
I05: J7.5, R22.1
I05_N: RN34.4 (R4A), U20.16 (CH1_COLLECTOR); also elsewhere on the board
I06: J7.6, R23.1
I06_N: RN34.3 (R3A), U20.14 (CH2_COLLECTOR); also elsewhere on the board
I07: J7.7, R24.1
I07_N: RN34.2 (R2A), U20.12 (CH3_COLLECTOR); also elsewhere on the board
I08: J7.8, R25.1
I08_N: RN34.1 (R1A), U20.10 (CH4_COLLECTOR); also elsewhere on the board
I09: J8.1, R26.1
I09_N: RN33.4 (R4A), U19.16 (CH1_COLLECTOR); also elsewhere on the board
I10: J8.2, R27.1
I10_N: RN33.3 (R3A), U19.14 (CH2_COLLECTOR); also elsewhere on the board
I11: J8.3, R28.1
I11_N: RN33.2 (R2A), U19.12 (CH3_COLLECTOR); also elsewhere on the board
I12: J8.4, R29.1
I12_N: RN33.1 (R1A), U19.10 (CH4_COLLECTOR); also elsewhere on the board
I13: J8.5, R30.1
I13_N: RN32.4 (R4A), U18.16 (CH1_COLLECTOR); also elsewhere on the board
I14: J8.6, R31.1
I14_N: RN32.3 (R3A), U18.14 (CH2_COLLECTOR); also elsewhere on the board
I15: J8.7, R32.1
I15_N: RN32.2 (R2A), U18.12 (CH3_COLLECTOR); also elsewhere on the board
I16: J8.8, R33.1
I16_N: RN32.1 (R1A), U18.10 (CH4_COLLECTOR); also elsewhere on the board
LI01: D13.2 (A), D14.1 (K), R18.2
LI02: D15.2 (A), D16.1 (K), R19.2
LI03: D17.2 (A), D18.1 (K), R20.2
LI04: D19.2 (A), D20.1 (K), R21.2
LI05: D21.2 (A), D22.1 (K), R22.2
LI06: D23.2 (A), D24.1 (K), R23.2
LI07: D25.2 (A), D26.1 (K), R24.2
LI08: D27.2 (A), D28.1 (K), R25.2
LI09: D29.2 (A), D30.1 (K), R26.2
LI10: D31.2 (A), D32.1 (K), R27.2
LI11: D33.2 (A), D34.1 (K), R28.2
LI12: D35.2 (A), D36.1 (K), R29.2
LI13: D37.2 (A), D38.1 (K), R30.2
LI14: D39.2 (A), D40.1 (K), R31.2
LI15: D41.2 (A), D42.1 (K), R32.2
LI16: D43.2 (A), D44.1 (K), R33.2
OI01: D13.1 (K), U21.1 (CH1_ANODE)
OI02: D15.1 (K), U21.3 (CH2_ANODE)
OI03: D17.1 (K), U21.5 (CH3_ANODE)
OI04: D19.1 (K), U21.7 (CH4_ANODE)
OI05: D21.1 (K), U20.1 (CH1_ANODE)
OI06: D23.1 (K), U20.3 (CH2_ANODE)
OI07: D25.1 (K), U20.5 (CH3_ANODE)
OI08: D27.1 (K), U20.7 (CH4_ANODE)
OI09: D29.1 (K), U19.1 (CH1_ANODE)
OI10: D31.1 (K), U19.3 (CH2_ANODE)
OI11: D33.1 (K), U19.5 (CH3_ANODE)
OI12: D35.1 (K), U19.7 (CH4_ANODE)
OI13: D37.1 (K), U18.1 (CH1_ANODE)
OI14: D39.1 (K), U18.3 (CH2_ANODE)
OI15: D41.1 (K), U18.5 (CH3_ANODE)
OI16: D43.1 (K), U18.7 (CH4_ANODE)
PLC_0V: D10.2 (A), D14.2 (A), D16.2 (A), D18.2 (A), D20.2 (A), D22.2 (A), D24.2 (A), D26.2 (A), D28.2 (A), D30.2 (A), D32.2 (A), D34.2 (A), D36.2 (A), D38.2 (A), D40.2 (A), D42.2 (A), D44.2 (A), J5.2, U18.2 (CH1_CATHODE), U18.4 (CH2_CATHODE), U18.6 (CH3_CATHODE), U18.8 (CH4_CATHODE), U19.2 (CH1_CATHODE), U19.4 (CH2_CATHODE), U19.6 (CH3_CATHODE), U19.8 (CH4_CATHODE), U20.2 (CH1_CATHODE), U20.4 (CH2_CATHODE), U20.6 (CH3_CATHODE), U20.8 (CH4_CATHODE), U21.2 (CH1_CATHODE), U21.4 (CH2_CATHODE), U21.6 (CH3_CATHODE), U21.8 (CH4_CATHODE), U35.2; also elsewhere on the board

Notes on the sheet:
16 isolated PLC field positions use software-remapped logical channels to minimize PCB crossings. The dedicated E-stop optochannel is separate from the shift-register bits. PLC and control channels keep a 2.2 k series limit before the indicator LED and optocoupler LED, with a reverse diode at the p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
The dedicated E-stop uses one Lite-On LTV-217-B-G SOP-4 optocoupler and R74. PLC inputs use four TLP291-4 packages with two 8x10 k pull-up networks. Every field input uses the same connector-side indicator LED / 2.2 k / reverse-diode chain. Firmware provides debouncing.

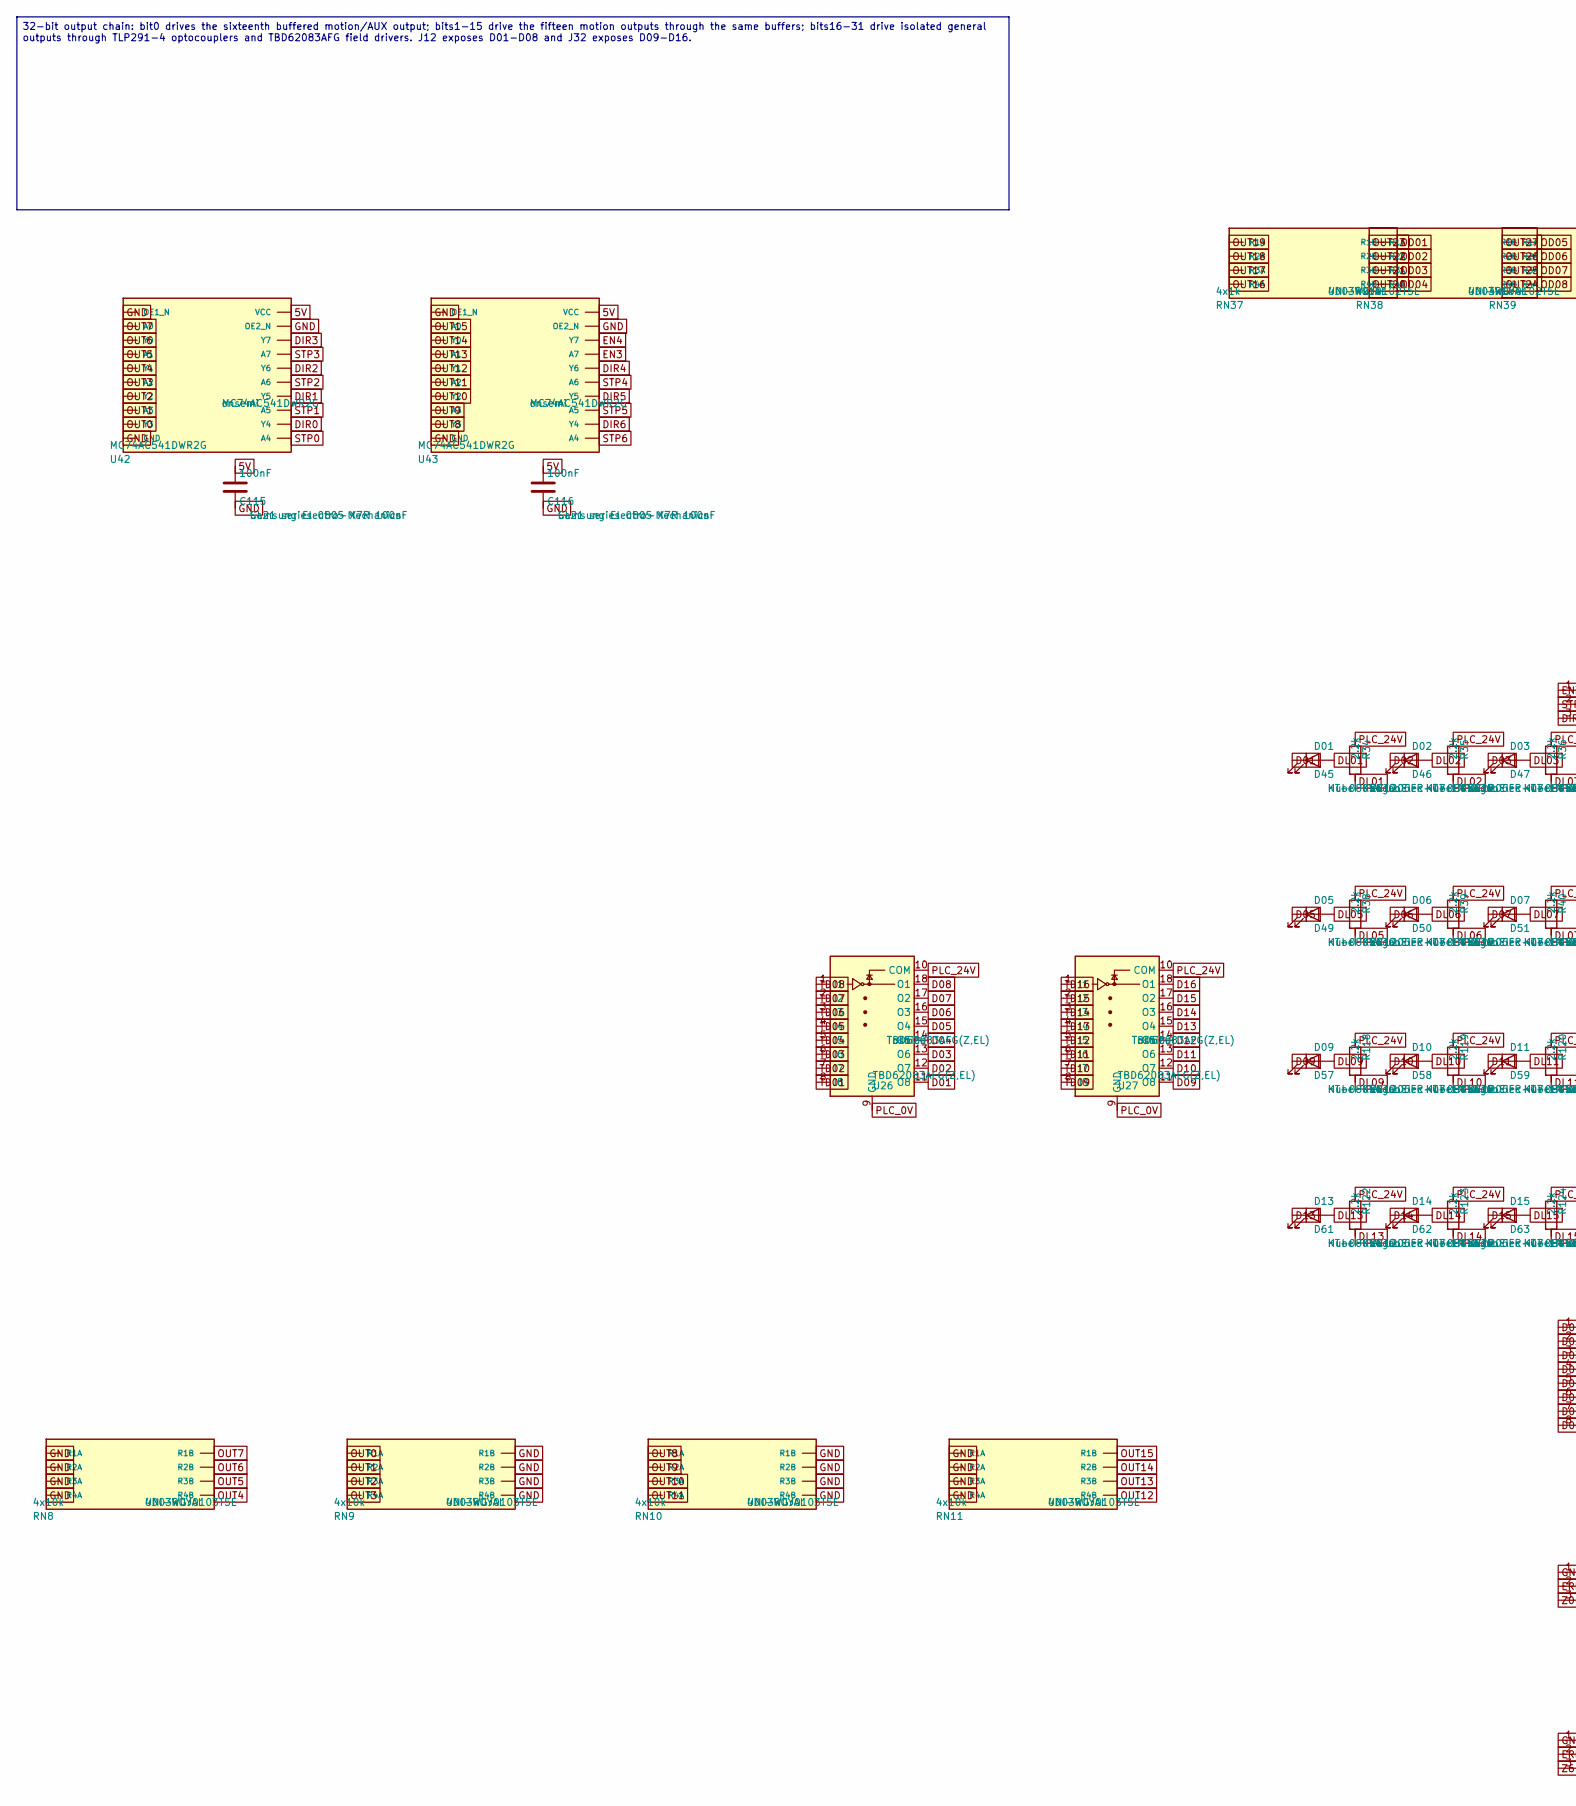
[picture p38: schematic field_outputs.kicad_sch, PLC OUT, part in row 1, column 1]

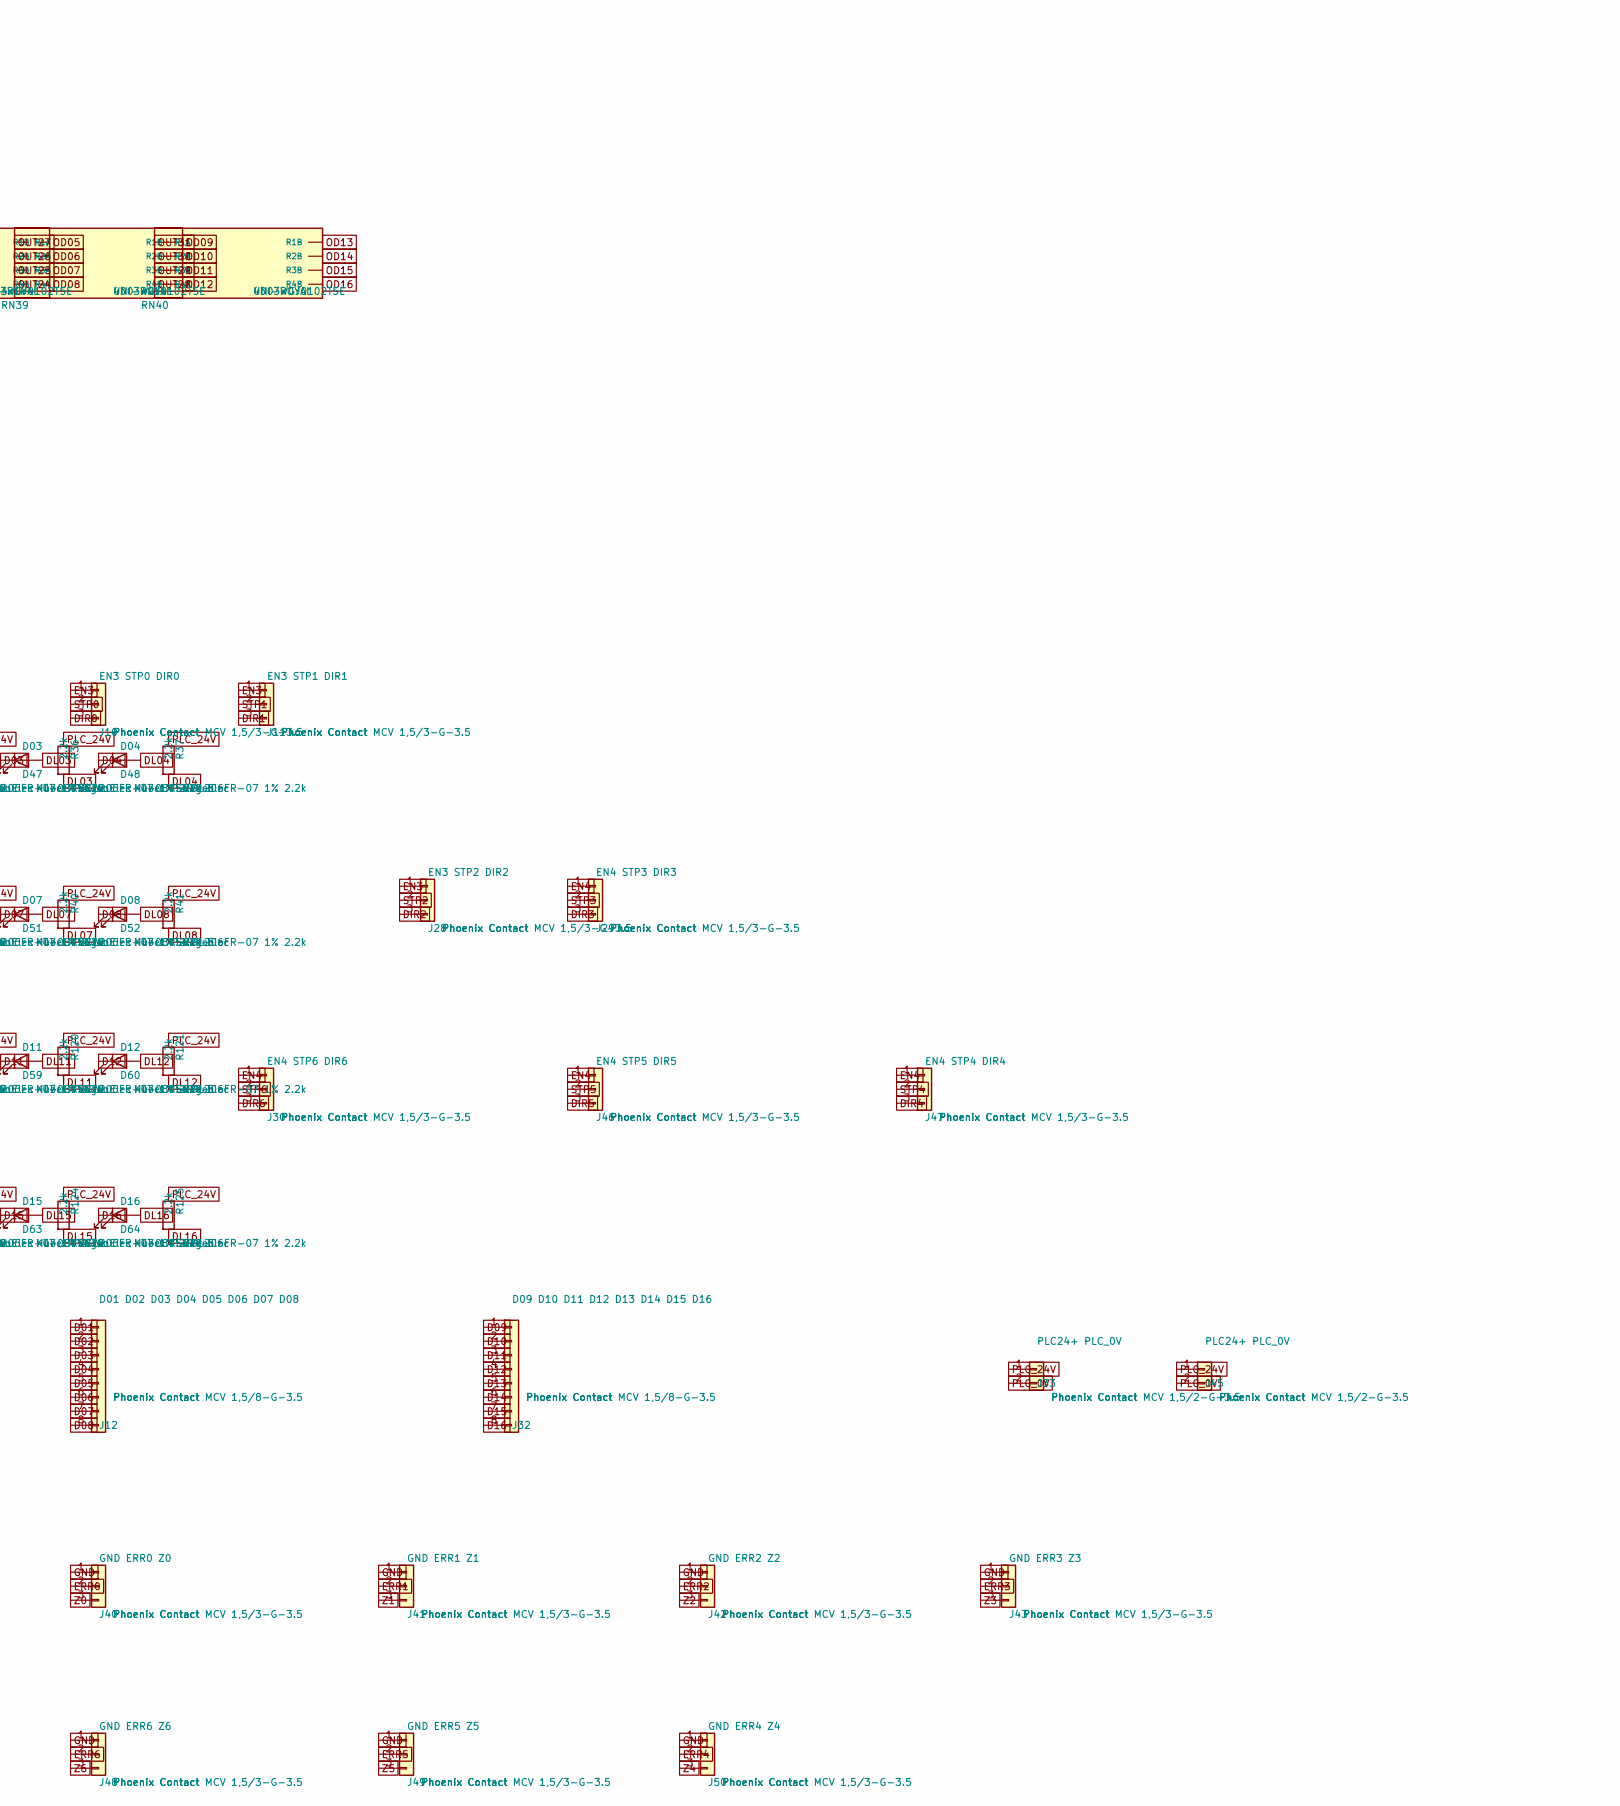
[picture p39: schematic field_outputs.kicad_sch, PLC OUT, part in row 1, column 2]

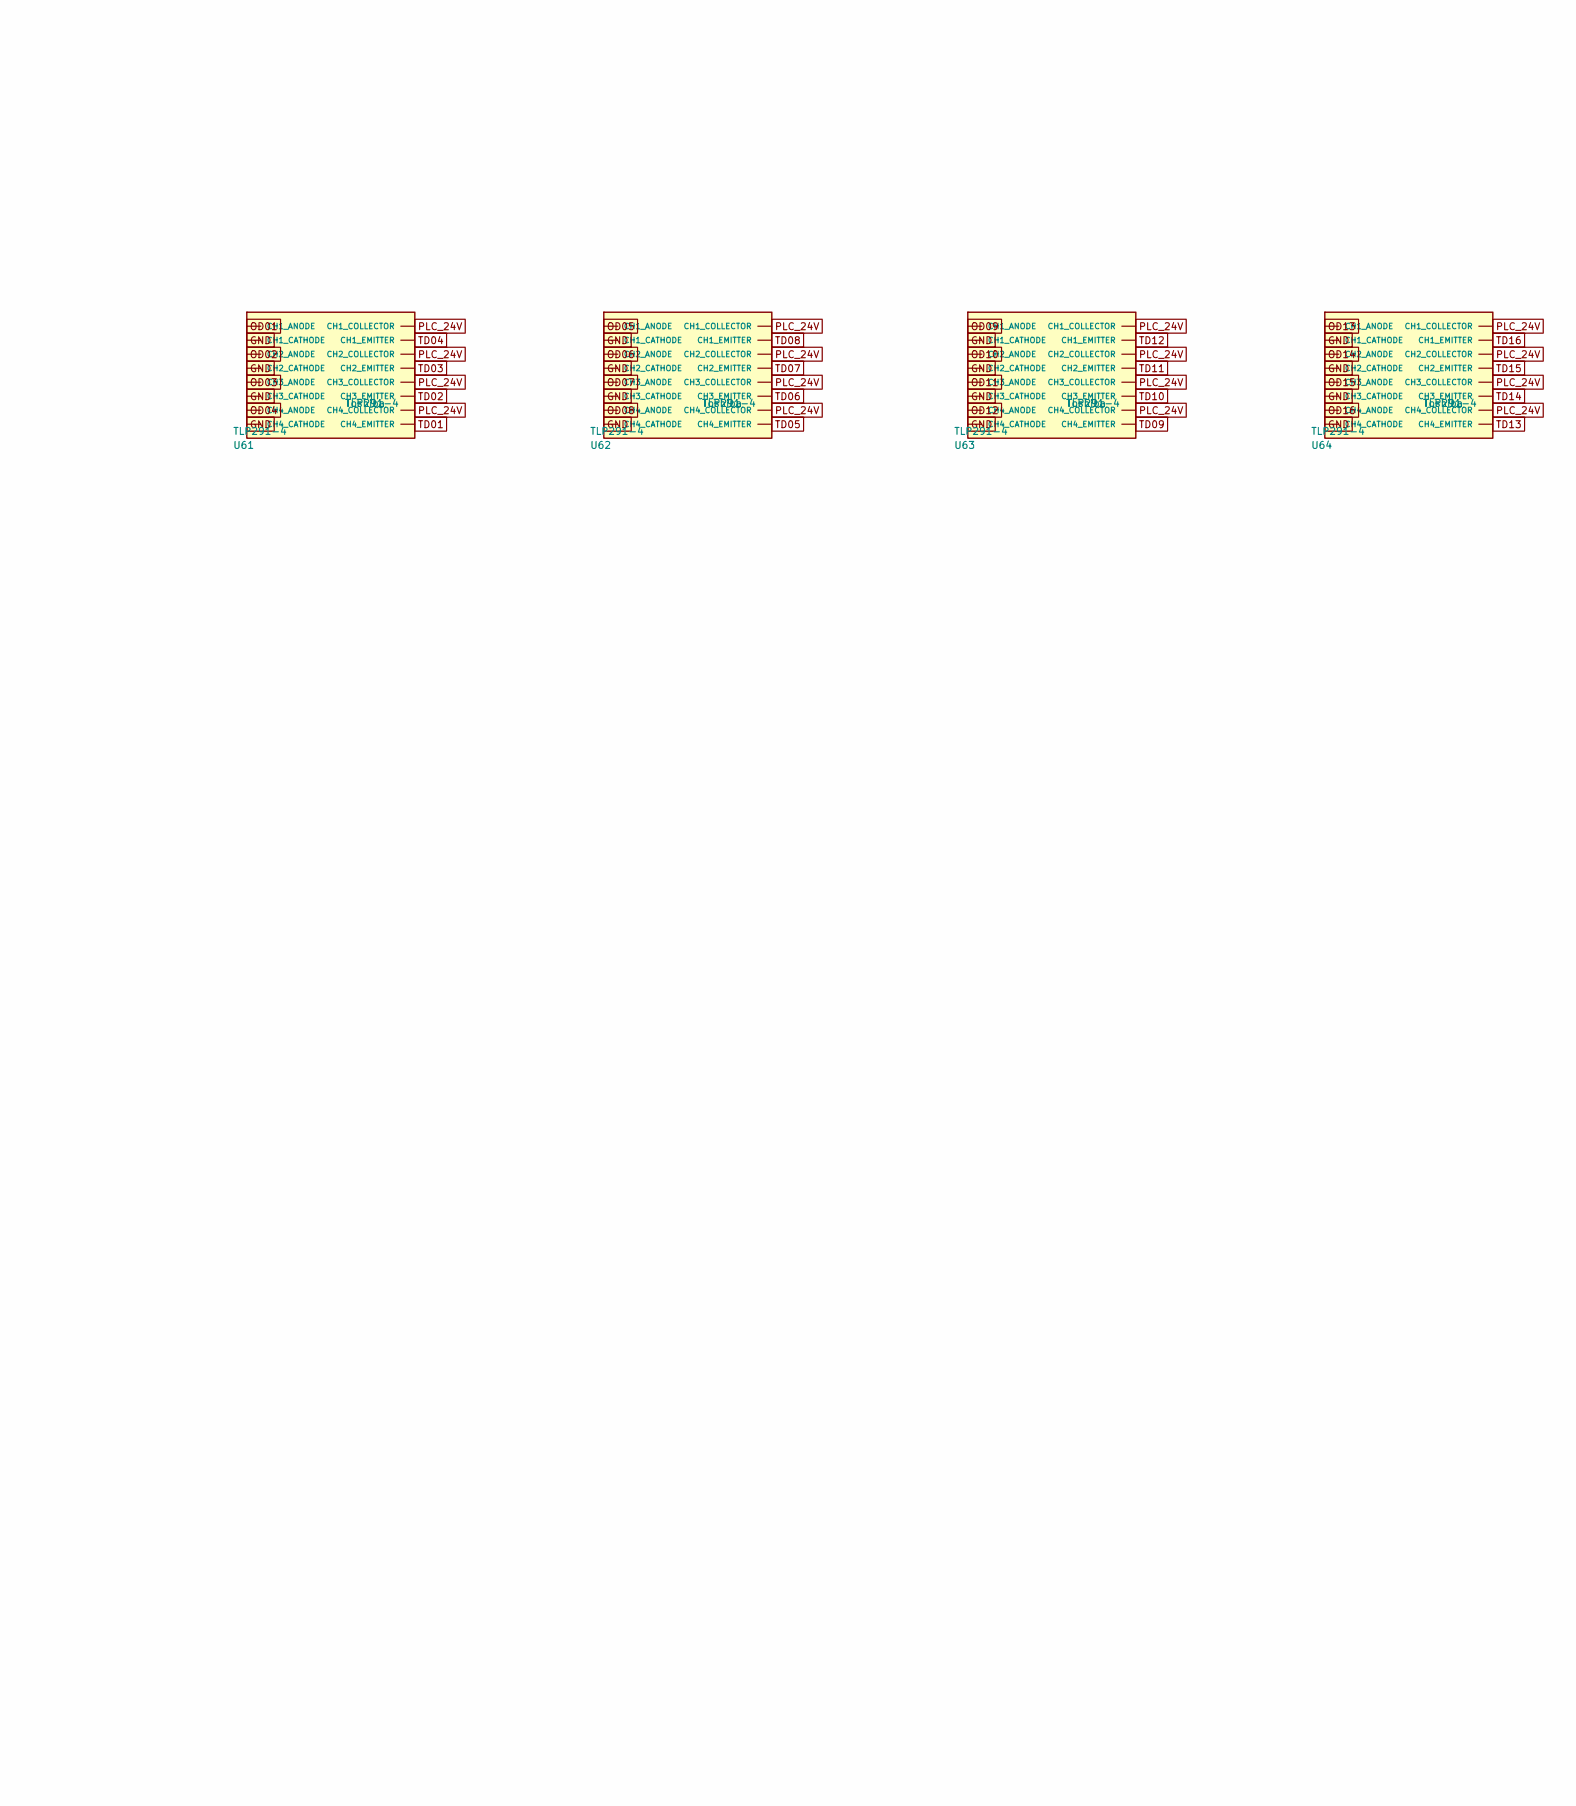
[picture p40: schematic field_outputs.kicad_sch, PLC OUT, part in row 1, column 3]

Parts:
C115, C116: 100nF; C_0805_2012Metric; MPN CL21 series 0805 X7R 100nF
D45: D01; LED_0805_2012Metric; MPN KT-0805G
D46: D02; LED_0805_2012Metric; MPN KT-0805G
D47: D03; LED_0805_2012Metric; MPN KT-0805G
D48: D04; LED_0805_2012Metric; MPN KT-0805G
D49: D05; LED_0805_2012Metric; MPN KT-0805G
D50: D06; LED_0805_2012Metric; MPN KT-0805G
D51: D07; LED_0805_2012Metric; MPN KT-0805G
D52: D08; LED_0805_2012Metric; MPN KT-0805G
D57: D09; LED_0805_2012Metric; MPN KT-0805G
D58: D10; LED_0805_2012Metric; MPN KT-0805G
D59: D11; LED_0805_2012Metric; MPN KT-0805G
D60: D12; LED_0805_2012Metric; MPN KT-0805G
D61: D13; LED_0805_2012Metric; MPN KT-0805G
D62: D14; LED_0805_2012Metric; MPN KT-0805G
D63: D15; LED_0805_2012Metric; MPN KT-0805G
D64: D16; LED_0805_2012Metric; MPN KT-0805G
J10: EN3 STP0 DIR0; PhoenixContact_MCV_1,5_3-G-3.5_1x03_P3.50mm_Vertical; MPN Phoenix Contact MCV 1,5/3-G-3.5
J11: EN3 STP1 DIR1; PhoenixContact_MCV_1,5_3-G-3.5_1x03_P3.50mm_Vertical; MPN Phoenix Contact MCV 1,5/3-G-3.5
J12: D01 D02 D03 D04 D05 D06 D07 D08; PhoenixContact_MCV_1,5_8-G-3.5_1x08_P3.50mm_Vertical; MPN Phoenix Contact MCV 1,5/8-G-3.5
J28: EN3 STP2 DIR2; PhoenixContact_MCV_1,5_3-G-3.5_1x03_P3.50mm_Vertical; MPN Phoenix Contact MCV 1,5/3-G-3.5
J29: EN4 STP3 DIR3; PhoenixContact_MCV_1,5_3-G-3.5_1x03_P3.50mm_Vertical; MPN Phoenix Contact MCV 1,5/3-G-3.5
J30: EN4 STP6 DIR6; PhoenixContact_MCV_1,5_3-G-3.5_1x03_P3.50mm_Vertical; MPN Phoenix Contact MCV 1,5/3-G-3.5
J32: D09 D10 D11 D12 D13 D14 D15 D16; PhoenixContact_MCV_1,5_8-G-3.5_1x08_P3.50mm_Vertical; MPN Phoenix Contact MCV 1,5/8-G-3.5
J33, J45: PLC24+ PLC_0V; PhoenixContact_MCV_1,5_2-G-3.5_1x02_P3.50mm_Vertical; MPN Phoenix Contact MCV 1,5/2-G-3.5
J40: GND ERR0 Z0; PhoenixContact_MCV_1,5_3-G-3.5_1x03_P3.50mm_Vertical; MPN Phoenix Contact MCV 1,5/3-G-3.5
J41: GND ERR1 Z1; PhoenixContact_MCV_1,5_3-G-3.5_1x03_P3.50mm_Vertical; MPN Phoenix Contact MCV 1,5/3-G-3.5
J42: GND ERR2 Z2; PhoenixContact_MCV_1,5_3-G-3.5_1x03_P3.50mm_Vertical; MPN Phoenix Contact MCV 1,5/3-G-3.5
J43: GND ERR3 Z3; PhoenixContact_MCV_1,5_3-G-3.5_1x03_P3.50mm_Vertical; MPN Phoenix Contact MCV 1,5/3-G-3.5
J46: EN4 STP5 DIR5; PhoenixContact_MCV_1,5_3-G-3.5_1x03_P3.50mm_Vertical; MPN Phoenix Contact MCV 1,5/3-G-3.5
J47: EN4 STP4 DIR4; PhoenixContact_MCV_1,5_3-G-3.5_1x03_P3.50mm_Vertical; MPN Phoenix Contact MCV 1,5/3-G-3.5
J48: GND ERR6 Z6; PhoenixContact_MCV_1,5_3-G-3.5_1x03_P3.50mm_Vertical; MPN Phoenix Contact MCV 1,5/3-G-3.5
J49: GND ERR5 Z5; PhoenixContact_MCV_1,5_3-G-3.5_1x03_P3.50mm_Vertical; MPN Phoenix Contact MCV 1,5/3-G-3.5
J50: GND ERR4 Z4; PhoenixContact_MCV_1,5_3-G-3.5_1x03_P3.50mm_Vertical; MPN Phoenix Contact MCV 1,5/3-G-3.5
R34, R35, R36, R37, R38, R39, R40, R41, R118, R119, R120, R121, R122, R123, R124, R125: 2.2k; R_1206_3216Metric; MPN RC1206FR-07 1% 2.2k
RN8, RN9, RN10, RN11: 4x10k; R_Array_Convex_4x0603; MPN 4D03WGJ0103T5E
RN37, RN38, RN39, RN40: 4x1k; R_Array_Convex_4x0603; MPN 4D03WGJ0102T5E
U26, U27: TBD62083AFG(Z,EL); SOP-18_7.495x11.515mm_P1.27mm; MPN TBD62083AFG(Z,EL)
U42, U43: MC74AC541DWR2G; SOIC-20W_7.5x12.8mm_P1.27mm; MPN MC74AC541DWR2G
U61, U62, U63, U64: TLP291-4; SOIC-16_4.55x10.3mm_P1.27mm; MPN TLP291-4

Connections:
5V: C115.1, C116.1, U42.20 (VCC), U43.20 (VCC); also elsewhere on the board
D01: D45.1 (K), J12.1, U26.11 (O8)
D02: D46.1 (K), J12.2, U26.12 (O7)
D03: D47.1 (K), J12.3, U26.13 (O6)
D04: D48.1 (K), J12.4, U26.14 (O5)
D05: D49.1 (K), J12.5, U26.15 (O4)
D06: D50.1 (K), J12.6, U26.16 (O3)
D07: D51.1 (K), J12.7, U26.17 (O2)
D08: D52.1 (K), J12.8, U26.18 (O1)
D09: D57.1 (K), J32.1, U27.11 (O8)
D10: D58.1 (K), J32.2, U27.12 (O7)
D11: D59.1 (K), J32.3, U27.13 (O6)
D12: D60.1 (K), J32.4, U27.14 (O5)
D13: D61.1 (K), J32.5, U27.15 (O4)
D14: D62.1 (K), J32.6, U27.16 (O3)
D15: D63.1 (K), J32.7, U27.17 (O2)
D16: D64.1 (K), J32.8, U27.18 (O1)
DIR0: J10.3, U42.12 (Y4)
DIR1: J11.3, U42.14 (Y5)
DIR2: J28.3, U42.16 (Y6)
DIR3: J29.3, U42.18 (Y7)
DIR4: J47.3, U43.16 (Y6)
DIR5: J46.3, U43.14 (Y5)
DIR6: J30.3, U43.12 (Y4)
DL01: D45.2 (A), R34.2
DL02: D46.2 (A), R35.2
DL03: D47.2 (A), R36.2
DL04: D48.2 (A), R37.2
DL05: D49.2 (A), R38.2
DL06: D50.2 (A), R39.2
DL07: D51.2 (A), R40.2
DL08: D52.2 (A), R41.2
DL09: D57.2 (A), R118.2
DL10: D58.2 (A), R119.2
DL11: D59.2 (A), R120.2
DL12: D60.2 (A), R121.2
DL13: D61.2 (A), R122.2
DL14: D62.2 (A), R123.2
DL15: D63.2 (A), R124.2
DL16: D64.2 (A), R125.2
EN3: J10.1, J11.1, J28.1, U43.17 (A7)
EN4: J29.1, J30.1, J46.1, J47.1, U43.18 (Y7)
ERR0: J40.2; also elsewhere on the board
ERR1: J41.2; also elsewhere on the board
ERR2: J42.2; also elsewhere on the board
ERR3: J43.2; also elsewhere on the board
ERR4: J50.2; also elsewhere on the board
ERR5: J49.2; also elsewhere on the board
ERR6: J48.2; also elsewhere on the board
GND: C115.2, C116.2, J40.1, J41.1, J42.1, J43.1, J48.1, J49.1, J50.1, RN8.1 (R1A), RN8.2 (R2A), RN8.3 (R3A), RN8.4 (R4A), RN9.5 (R4B), RN9.6 (R3B), RN9.7 (R2B), RN9.8 (R1B), RN10.5 (R4B), RN10.6 (R3B), RN10.7 (R2B), RN10.8 (R1B), RN11.1 (R1A), RN11.2 (R2A), RN11.3 (R3A), RN11.4 (R4A), U42.1 (OE1_N), U42.10 (GND), U42.19 (OE2_N), U43.1 (OE1_N), U43.10 (GND), U43.19 (OE2_N), U61.2 (CH1_CATHODE), U61.4 (CH2_CATHODE), U61.6 (CH3_CATHODE), U61.8 (CH4_CATHODE), U62.2 (CH1_CATHODE), U62.4 (CH2_CATHODE), U62.6 (CH3_CATHODE), U62.8 (CH4_CATHODE), U63.2 (CH1_CATHODE), U63.4 (CH2_CATHODE), U63.6 (CH3_CATHODE), U63.8 (CH4_CATHODE), U64.2 (CH1_CATHODE), U64.4 (CH2_CATHODE), U64.6 (CH3_CATHODE), U64.8 (CH4_CATHODE); also elsewhere on the board
OD01: RN37.8 (R1B), U61.1 (CH1_ANODE)
OD02: RN37.7 (R2B), U61.3 (CH2_ANODE)
OD03: RN37.6 (R3B), U61.5 (CH3_ANODE)
OD04: RN37.5 (R4B), U61.7 (CH4_ANODE)
OD05: RN38.8 (R1B), U62.1 (CH1_ANODE)
OD06: RN38.7 (R2B), U62.3 (CH2_ANODE)
OD07: RN38.6 (R3B), U62.5 (CH3_ANODE)
OD08: RN38.5 (R4B), U62.7 (CH4_ANODE)
OD09: RN39.8 (R1B), U63.1 (CH1_ANODE)
OD10: RN39.7 (R2B), U63.3 (CH2_ANODE)
OD11: RN39.6 (R3B), U63.5 (CH3_ANODE)
OD12: RN39.5 (R4B), U63.7 (CH4_ANODE)
OD13: RN40.8 (R1B), U64.1 (CH1_ANODE)
OD14: RN40.7 (R2B), U64.3 (CH2_ANODE)
OD15: RN40.6 (R3B), U64.5 (CH3_ANODE)
OD16: RN40.5 (R4B), U64.7 (CH4_ANODE)
OUT0: RN9.1 (R1A), U42.9 (Y3); also elsewhere on the board
OUT1: RN9.2 (R2A), U42.8 (A3); also elsewhere on the board
OUT2: RN9.3 (R3A), U42.7 (Y2); also elsewhere on the board
OUT3: RN9.4 (R4A), U42.6 (A2); also elsewhere on the board
OUT4: RN8.5 (R4B), U42.5 (Y1); also elsewhere on the board
OUT5: RN8.6 (R3B), U42.4 (A1); also elsewhere on the board
OUT6: RN8.7 (R2B), U42.3 (Y0); also elsewhere on the board
OUT7: RN8.8 (R1B), U42.2 (A0); also elsewhere on the board
OUT8: RN10.1 (R1A), U43.9 (Y3); also elsewhere on the board
OUT9: RN10.2 (R2A), U43.8 (A3); also elsewhere on the board
OUT10: RN10.3 (R3A), U43.7 (Y2); also elsewhere on the board
OUT11: RN10.4 (R4A), U43.6 (A2); also elsewhere on the board
OUT12: RN11.5 (R4B), U43.5 (Y1); also elsewhere on the board
OUT13: RN11.6 (R3B), U43.4 (A1); also elsewhere on the board
OUT14: RN11.7 (R2B), U43.3 (Y0); also elsewhere on the board
OUT15: RN11.8 (R1B), U43.2 (A0); also elsewhere on the board
OUT16: RN37.4 (R4A); also elsewhere on the board
OUT17: RN37.3 (R3A); also elsewhere on the board
OUT18: RN37.2 (R2A); also elsewhere on the board
OUT19: RN37.1 (R1A); also elsewhere on the board
OUT20: RN38.4 (R4A); also elsewhere on the board
OUT21: RN38.3 (R3A); also elsewhere on the board
OUT22: RN38.2 (R2A); also elsewhere on the board
OUT23: RN38.1 (R1A); also elsewhere on the board
OUT24: RN39.4 (R4A); also elsewhere on the board
OUT25: RN39.3 (R3A); also elsewhere on the board
OUT26: RN39.2 (R2A); also elsewhere on the board
OUT27: RN39.1 (R1A); also elsewhere on the board
OUT28: RN40.4 (R4A); also elsewhere on the board
OUT29: RN40.3 (R3A); also elsewhere on the board
OUT30: RN40.2 (R2A); also elsewhere on the board
OUT31: RN40.1 (R1A); also elsewhere on the board
PLC_0V: J33.2, J45.2, U26.9 (GND), U27.9 (GND); also elsewhere on the board
PLC_24V: J33.1, J45.1, R34.1, R35.1, R36.1, R37.1, R38.1, R39.1, R40.1, R41.1, R118.1, R119.1, R120.1, R121.1, R122.1, R123.1, R124.1, R125.1, U26.10 (COM), U27.10 (COM), U61.10 (CH4_COLLECTOR), U61.12 (CH3_COLLECTOR), U61.14 (CH2_COLLECTOR), U61.16 (CH1_COLLECTOR), U62.10 (CH4_COLLECTOR), U62.12 (CH3_COLLECTOR), U62.14 (CH2_COLLECTOR), U62.16 (CH1_COLLECTOR), U63.10 (CH4_COLLECTOR), U63.12 (CH3_COLLECTOR), U63.14 (CH2_COLLECTOR), U63.16 (CH1_COLLECTOR), U64.10 (CH4_COLLECTOR), U64.12 (CH3_COLLECTOR), U64.14 (CH2_COLLECTOR), U64.16 (CH1_COLLECTOR); also elsewhere on the board
STP0: J10.2, U42.11 (A4)
STP1: J11.2, U42.13 (A5)
STP2: J28.2, U42.15 (A6)
STP3: J29.2, U42.17 (A7)
STP4: J47.2, U43.15 (A6)
STP5: J46.2, U43.13 (A5)
STP6: J30.2, U43.11 (A4)
TD01: U26.8 (I8), U61.9 (CH4_EMITTER)
TD02: U26.7 (I7), U61.11 (CH3_EMITTER)
TD03: U26.6 (I6), U61.13 (CH2_EMITTER)
TD04: U26.5 (I5), U61.15 (CH1_EMITTER)
TD05: U26.4 (I4), U62.9 (CH4_EMITTER)
TD06: U26.3 (I3), U62.11 (CH3_EMITTER)
TD07: U26.2 (I2), U62.13 (CH2_EMITTER)
TD08: U26.1 (I1), U62.15 (CH1_EMITTER)
TD09: U27.8 (I8), U63.9 (CH4_EMITTER)
TD10: U27.7 (I7), U63.11 (CH3_EMITTER)
TD11: U27.6 (I6), U63.13 (CH2_EMITTER)
TD12: U27.5 (I5), U63.15 (CH1_EMITTER)
TD13: U27.4 (I4), U64.9 (CH4_EMITTER)
TD14: U27.3 (I3), U64.11 (CH3_EMITTER)
TD15: U27.2 (I2), U64.13 (CH2_EMITTER)
TD16: U27.1 (I1), U64.15 (CH1_EMITTER)
Z0: J40.3; also elsewhere on the board
Z1: J41.3; also elsewhere on the board
Z2: J42.3; also elsewhere on the board
Z3: J43.3; also elsewhere on the board
Z4: J50.3; also elsewhere on the board
Z5: J49.3; also elsewhere on the board
Z6: J48.3; also elsewhere on the board

Notes on the sheet:
32-bit output chain: bit0 drives the sixteenth buffered motion/AUX output; bits1-15 drive the fifteen motion outputs through the same buffers; bits16-31 drive isolated general outputs through TLP291-4 optocouplers and TBD62083AFG field drivers. J12 exposes D01-D08 and J32 exposes D09-D16.
