staskaaa-netizen/uCNC_Pi_Board/hardware/motherboard.kicad_pcb

## KiCad design hardware/motherboard.kicad_pcb (continued)

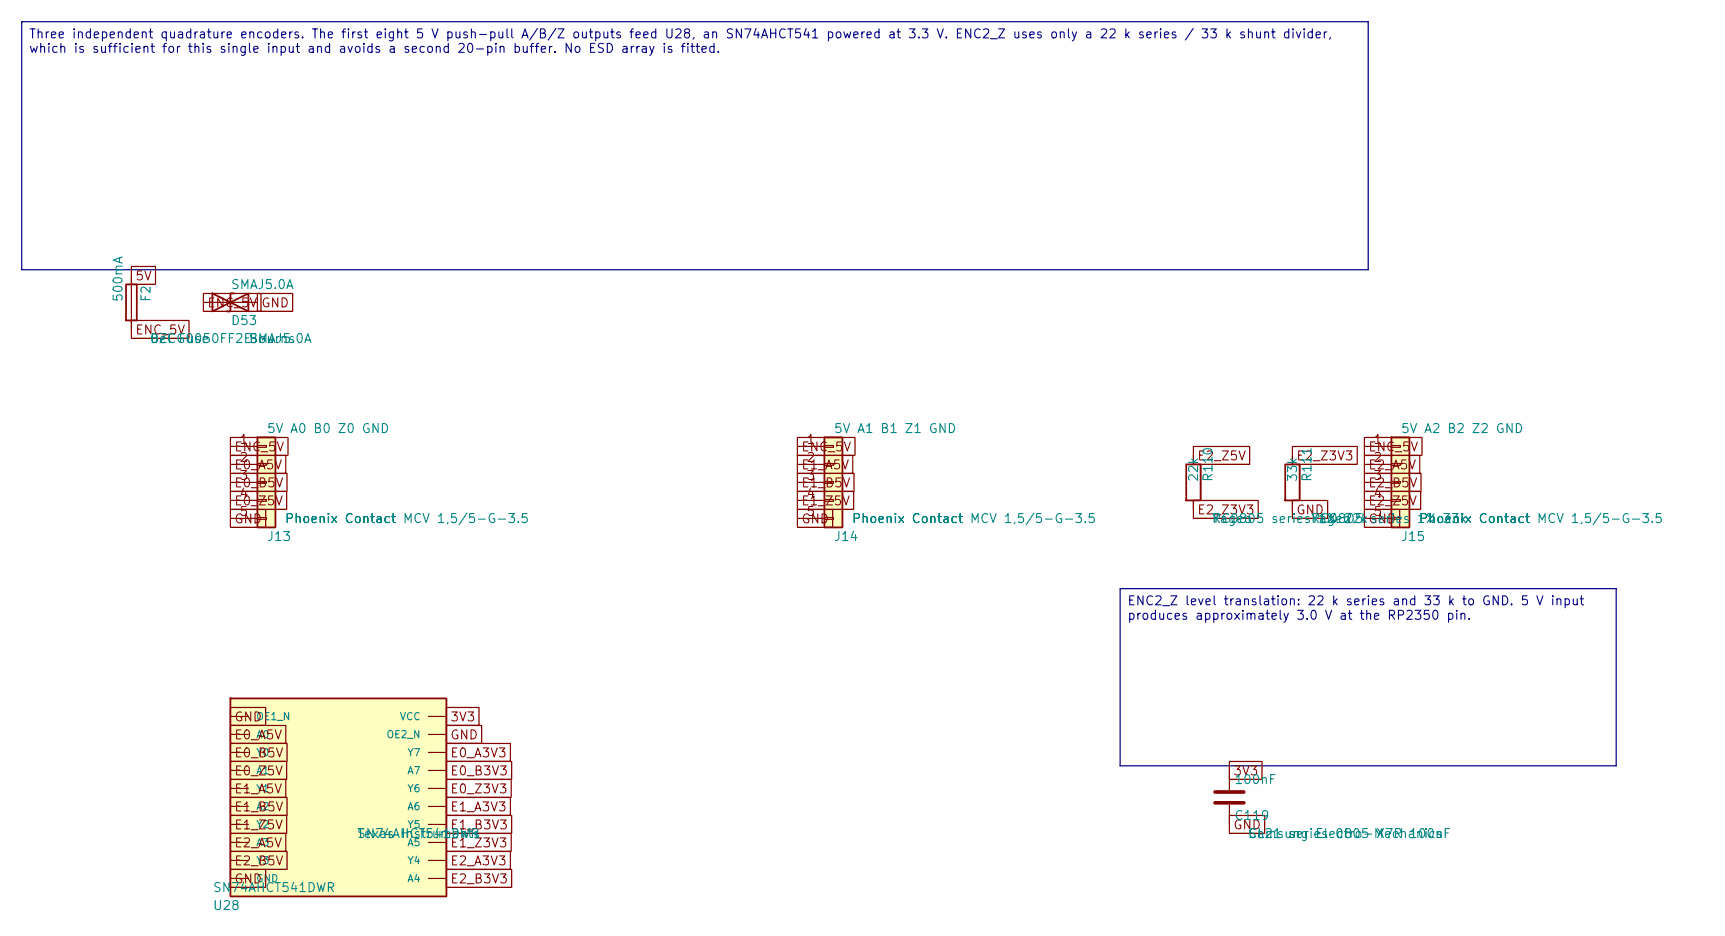
[picture p41: schematic encoders.kicad_sch]

Parts:
C119: 100nF; C_0805_2012Metric; MPN CL21 series 0805 X7R 100nF
D53: SMAJ5.0A; D_SMA; MPN SMAJ5.0A
F2: 500mA; R_1206_3216Metric; MPN 0ZCG0050FF2E
J13: 5V A0 B0 Z0 GND; PhoenixContact_MCV_1,5_5-G-3.5_1x05_P3.50mm_Vertical; MPN Phoenix Contact MCV 1,5/5-G-3.5
J14: 5V A1 B1 Z1 GND; PhoenixContact_MCV_1,5_5-G-3.5_1x05_P3.50mm_Vertical; MPN Phoenix Contact MCV 1,5/5-G-3.5
J15: 5V A2 B2 Z2 GND; PhoenixContact_MCV_1,5_5-G-3.5_1x05_P3.50mm_Vertical; MPN Phoenix Contact MCV 1,5/5-G-3.5
R110: 22k; R_0805_2012Metric; MPN RC0805 series 1% 22k
R111: 33k; R_0805_2012Metric; MPN RC0805 series 1% 33k
U28: SN74AHCT541DWR; SOIC-20W_7.5x12.8mm_P1.27mm; MPN SN74AHCT541DWR

Connections:
3V3: C119.1, U28.20 (VCC); also elsewhere on the board
5V: F2.1; also elsewhere on the board
E0_A3V3: U28.18 (Y7); also elsewhere on the board
E0_A5V: J13.2, U28.2 (A0)
E0_B3V3: U28.17 (A7); also elsewhere on the board
E0_B5V: J13.3, U28.3 (Y0)
E0_Z3V3: U28.16 (Y6); also elsewhere on the board
E0_Z5V: J13.4, U28.4 (A1)
E1_A3V3: U28.15 (A6); also elsewhere on the board
E1_A5V: J14.2, U28.5 (Y1)
E1_B3V3: U28.14 (Y5); also elsewhere on the board
E1_B5V: J14.3, U28.6 (A2)
E1_Z3V3: U28.13 (A5); also elsewhere on the board
E1_Z5V: J14.4, U28.7 (Y2)
E2_A3V3: U28.12 (Y4); also elsewhere on the board
E2_A5V: J15.2, U28.8 (A3)
E2_B3V3: U28.11 (A4); also elsewhere on the board
E2_B5V: J15.3, U28.9 (Y3)
E2_Z3V3: R110.2, R111.1; also elsewhere on the board
E2_Z5V: J15.4, R110.1
ENC_5V: D53.1 (A1), F2.2, J13.1, J14.1, J15.1
GND: C119.2, D53.2 (A2), J13.5, J14.5, J15.5, R111.2, U28.1 (OE1_N), U28.10 (GND), U28.19 (OE2_N); also elsewhere on the board

Notes on the sheet:
Three independent quadrature encoders. The first eight 5 V push-pull A/B/Z outputs feed U28, an SN74AHCT541 powered at 3.3 V. ENC2_Z uses only a 22 k series / 33 k shunt divider, which is sufficient for this single input and avoids a second 20-pin buffer. No ESD array is fitted.
ENC2_Z level translation: 22 k series and 33 k to GND. 5 V input produces approximately 3.0 V at the RP2350 pin.

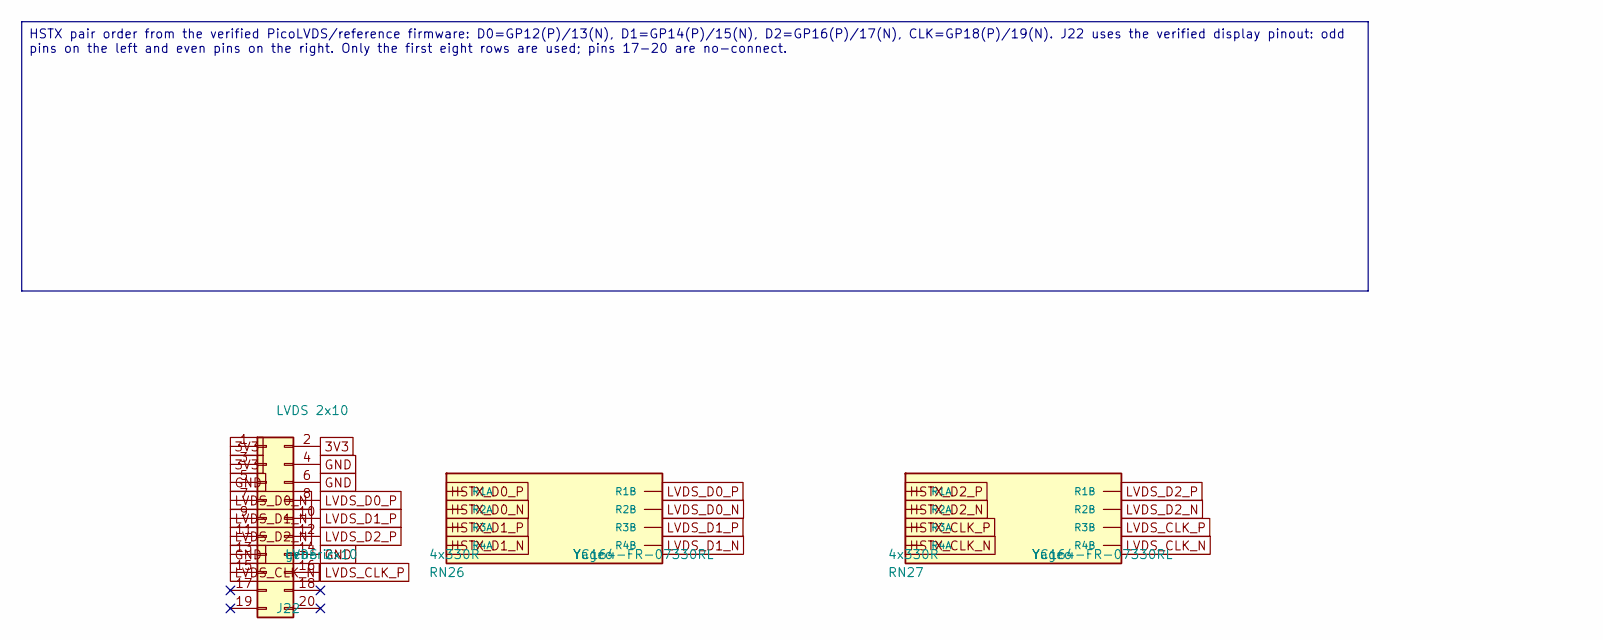
[picture p42: schematic display.kicad_sch]

Parts:
J22: LVDS 2x10; PinHeader_2x10_P2.00mm_Vertical; MPN LVDS 2x10
RN26, RN27: 4x330R; R_Array_Convex_4x0603; MPN YC164-FR-07330RL

Connections:
3V3: J22.1, J22.2, J22.3; also elsewhere on the board
GND: J22.4, J22.5, J22.6, J22.13, J22.14; also elsewhere on the board
HSTX_CLK_N: RN27.4 (R4A); also elsewhere on the board
HSTX_CLK_P: RN27.3 (R3A); also elsewhere on the board
HSTX_D0_N: RN26.2 (R2A); also elsewhere on the board
HSTX_D0_P: RN26.1 (R1A); also elsewhere on the board
HSTX_D1_N: RN26.4 (R4A); also elsewhere on the board
HSTX_D1_P: RN26.3 (R3A); also elsewhere on the board
HSTX_D2_N: RN27.2 (R2A); also elsewhere on the board
HSTX_D2_P: RN27.1 (R1A); also elsewhere on the board
LVDS_CLK_N: J22.15, RN27.5 (R4B)
LVDS_CLK_P: J22.16, RN27.6 (R3B)
LVDS_D0_N: J22.7, RN26.7 (R2B)
LVDS_D0_P: J22.8, RN26.8 (R1B)
LVDS_D1_N: J22.9, RN26.5 (R4B)
LVDS_D1_P: J22.10, RN26.6 (R3B)
LVDS_D2_N: J22.11, RN27.7 (R2B)
LVDS_D2_P: J22.12, RN27.8 (R1B)

Notes on the sheet:
HSTX pair order from the verified PicoLVDS/reference firmware: D0=GP12(P)/13(N), D1=GP14(P)/15(N), D2=GP16(P)/17(N), CLK=GP18(P)/19(N). J22 uses the verified display pinout: odd pins on the left and even pins on the right. Only the first eight rows are used; pins 17-20 are no-connect.

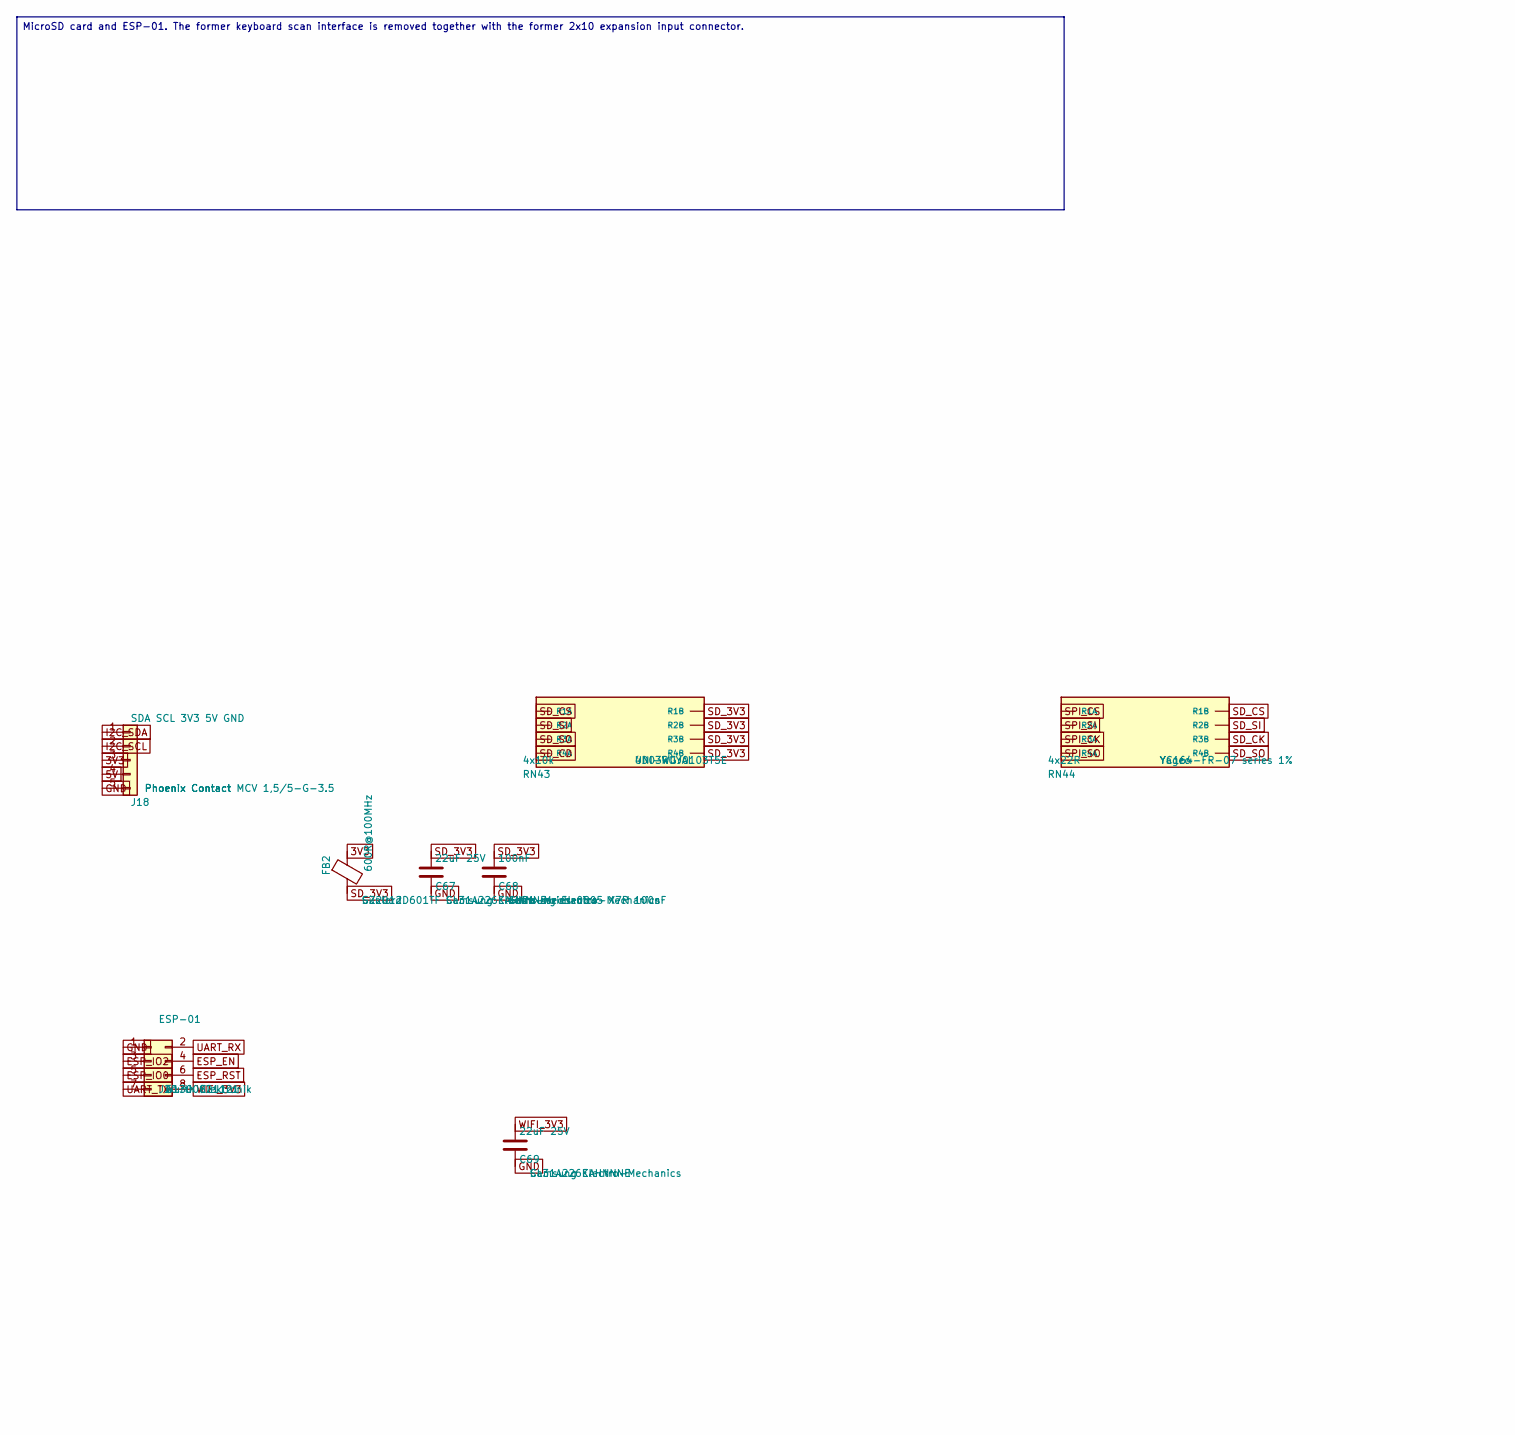
[picture p43: schematic storage_wifi_ui.kicad_sch, SD / Wi-Fi, part in row 1, column 1]

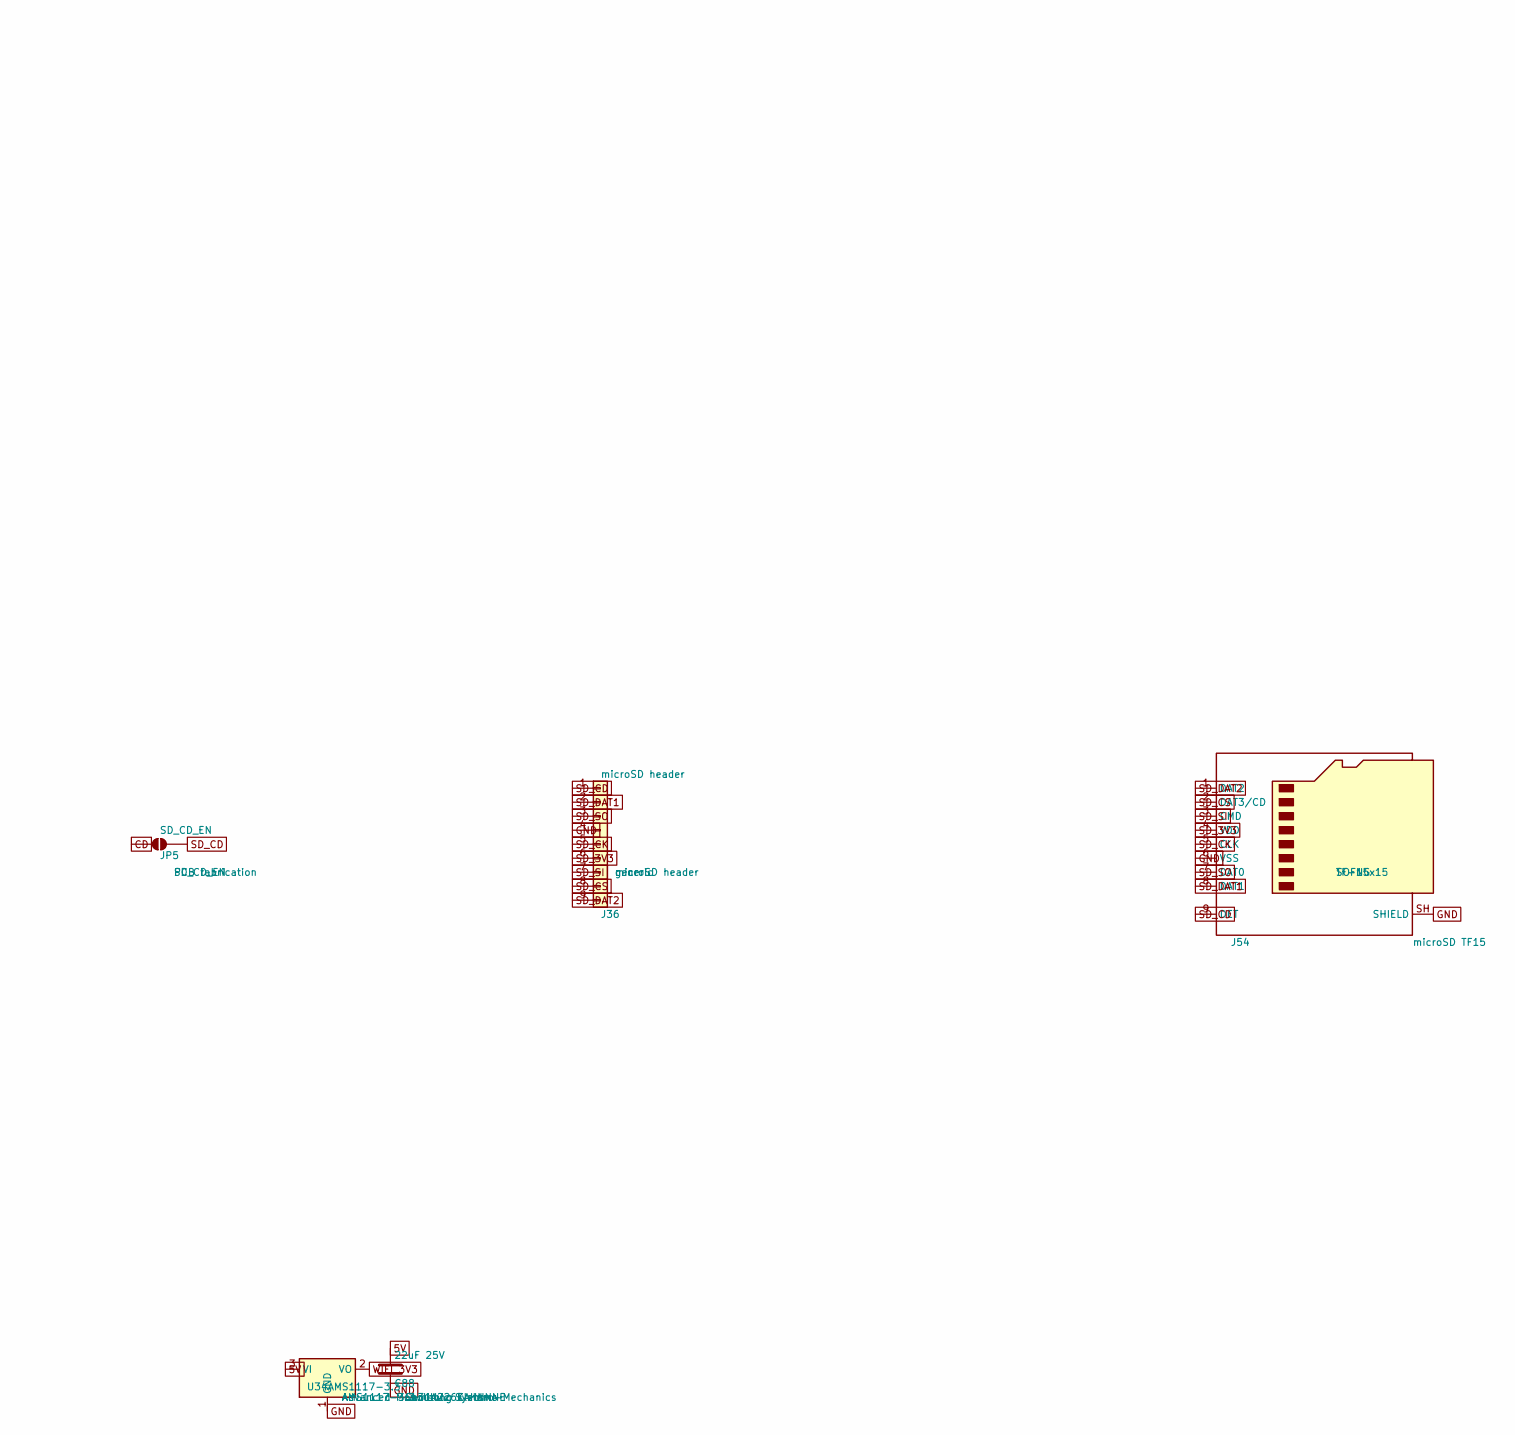
[picture p44: schematic storage_wifi_ui.kicad_sch, SD / Wi-Fi, part in row 1, column 2]

Parts:
C67, C69, C88: 22uF 25V; C_1206_3216Metric; MPN CL31A226KAHNNNE
C68: 100nF; C_0805_2012Metric; MPN CL21 series 0805 X7R 100nF
FB2: 600R@100MHz; R_0805_2012Metric; MPN GZ2012D601TF
J18: SDA SCL 3V3 5V GND; PhoenixContact_MCV_1,5_5-G-3.5_1x05_P3.50mm_Vertical; MPN Phoenix Contact MCV 1,5/5-G-3.5
J20: ESP-01; PinSocket_2x04_P2.54mm_Vertical; MPN 61300821121
J36: microSD header; PinHeader_1x09_P2.54mm_Vertical; MPN microSD header
J54: microSD TF15; TF-SMD_TF-15-15; MPN TF-15x15
JP5: SD_CD_EN; SolderJumper-2_P1.3mm_Open_Pad1.0x1.5mm; MPN SD_CD_EN
RN43: 4x10k; R_Array_Convex_4x0603; MPN 4D03WGJ0103T5E
RN44: 4x22R; R_Array_Convex_4x0603; MPN YC164-FR-07 series 1%
U34: AMS1117-3.3; SOT-223-3_TabPin2; MPN AMS1117-3.3

Connections:
3V3: FB2.1, J18.3; also elsewhere on the board
5V: C88.1, J18.4, U34.3 (VI); also elsewhere on the board
CD: JP5.1 (A); also elsewhere on the board
ESP_EN: J20.4
ESP_IO0: J20.5
ESP_IO2: J20.3
ESP_RST: J20.6
GND: C67.2, C68.2, C69.2, C88.2, J18.5, J20.1, J36.4, J54.6 (VSS), J54.10, J54.11, J54.12, J54.13, J54.SH (SHIELD), U34.1 (GND); also elsewhere on the board
I2C_SCL: J18.2; also elsewhere on the board
I2C_SDA: J18.1; also elsewhere on the board
SD_3V3: C67.1, C68.1, FB2.2, J36.6, J54.4 (VDD), RN43.5 (R4B), RN43.6 (R3B), RN43.7 (R2B), RN43.8 (R1B)
SD_CD: J36.1, J54.9 (DET), JP5.2 (B), RN43.4 (R4A)
SD_CK: J36.5, J54.5 (CLK), RN44.6 (R3B)
SD_CS: J36.8, J54.2 (DAT3/CD), RN43.1 (R1A), RN44.8 (R1B)
SD_DAT1: J36.2, J54.8 (DAT1)
SD_DAT2: J36.9, J54.1 (DAT2)
SD_SI: J36.7, J54.3 (CMD), RN43.2 (R2A), RN44.7 (R2B)
SD_SO: J36.3, J54.7 (DAT0), RN43.3 (R3A), RN44.5 (R4B)
SPI_CK: RN44.3 (R3A); also elsewhere on the board
SPI_CS: RN44.1 (R1A); also elsewhere on the board
SPI_SI: RN44.2 (R2A); also elsewhere on the board
SPI_SO: RN44.4 (R4A); also elsewhere on the board
UART_RX: J20.2; also elsewhere on the board
UART_TX: J20.7; also elsewhere on the board
WIFI_3V3: C69.1, J20.8, U34.2 (VO)

Notes on the sheet:
MicroSD card and ESP-01. The former keyboard scan interface is removed together with the former 2x10 expansion input connector.

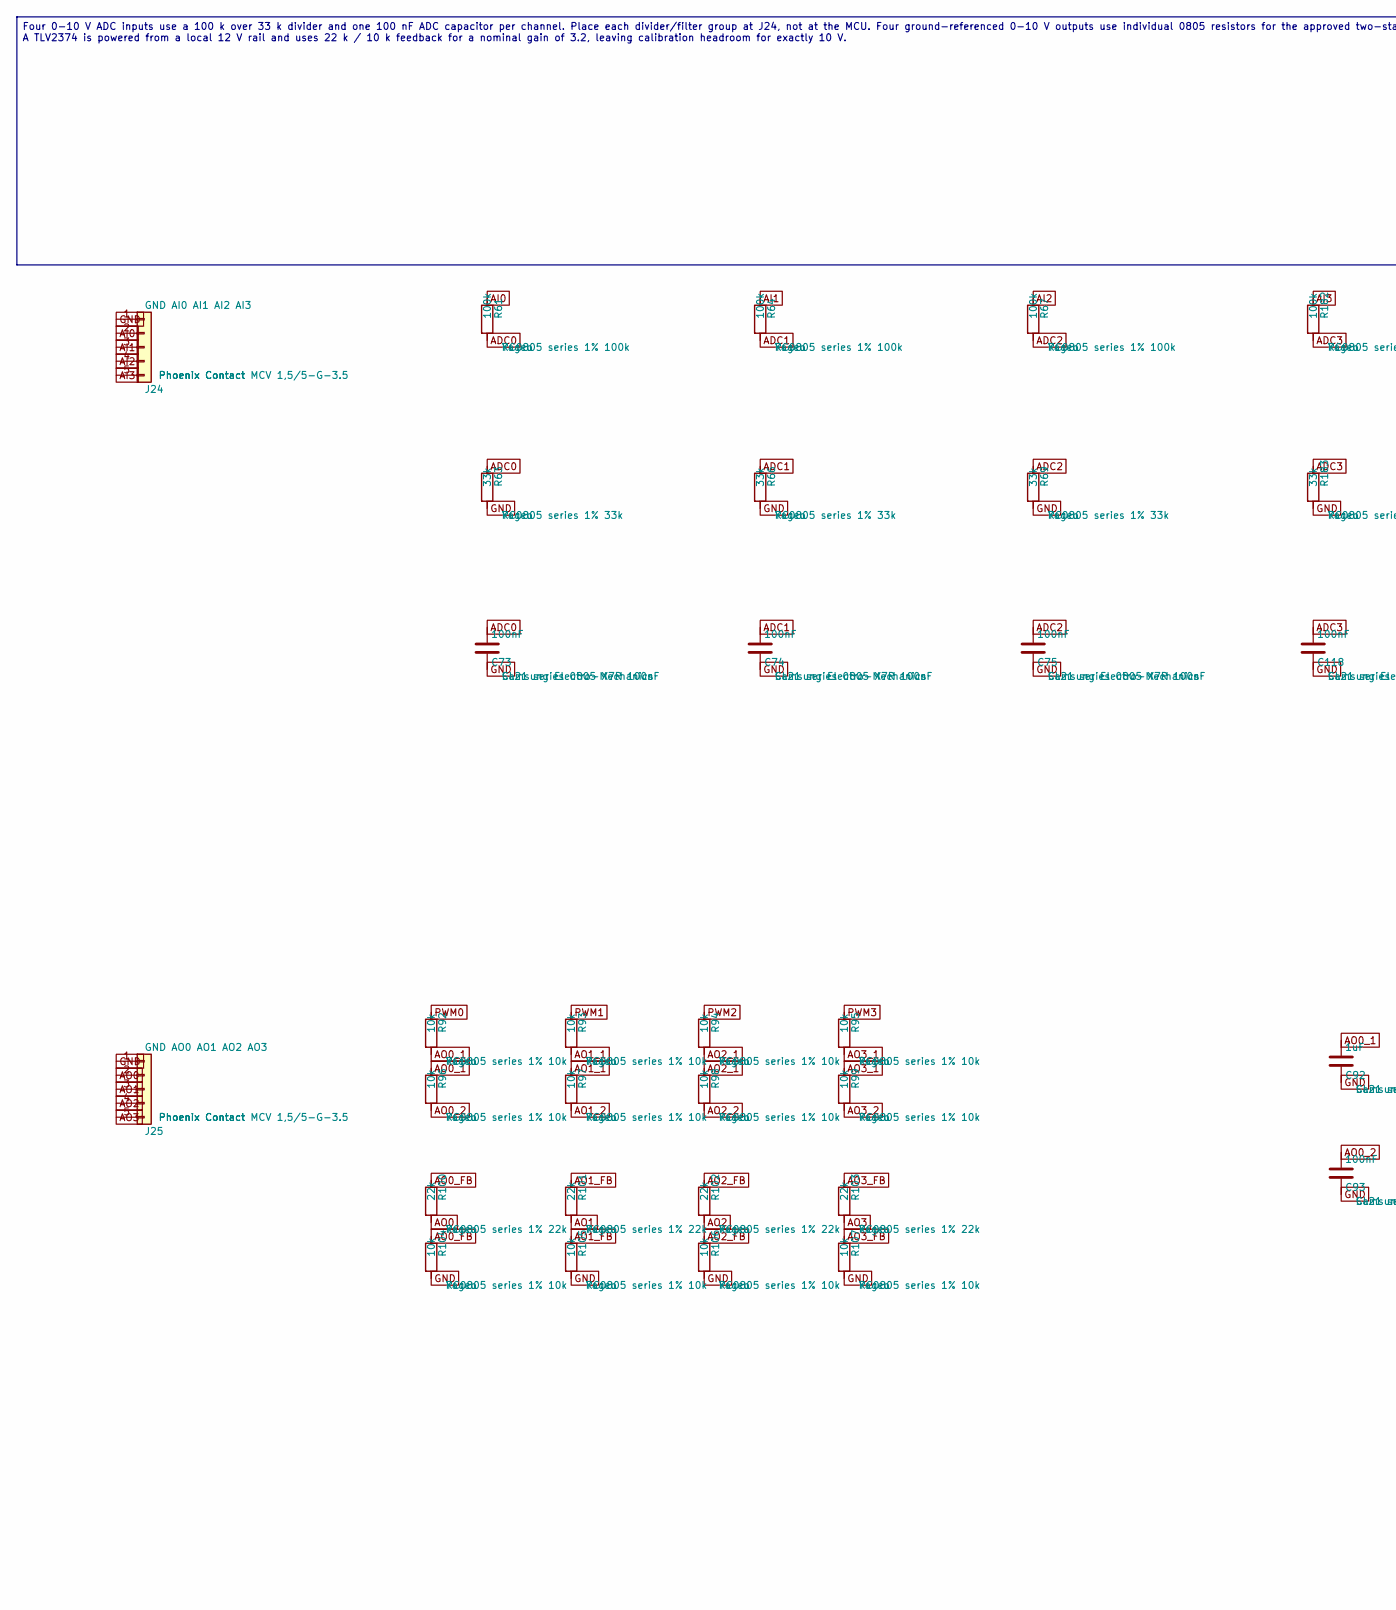
[picture p45: schematic analog_io.kicad_sch, Analog I/O, part in row 1, column 1]

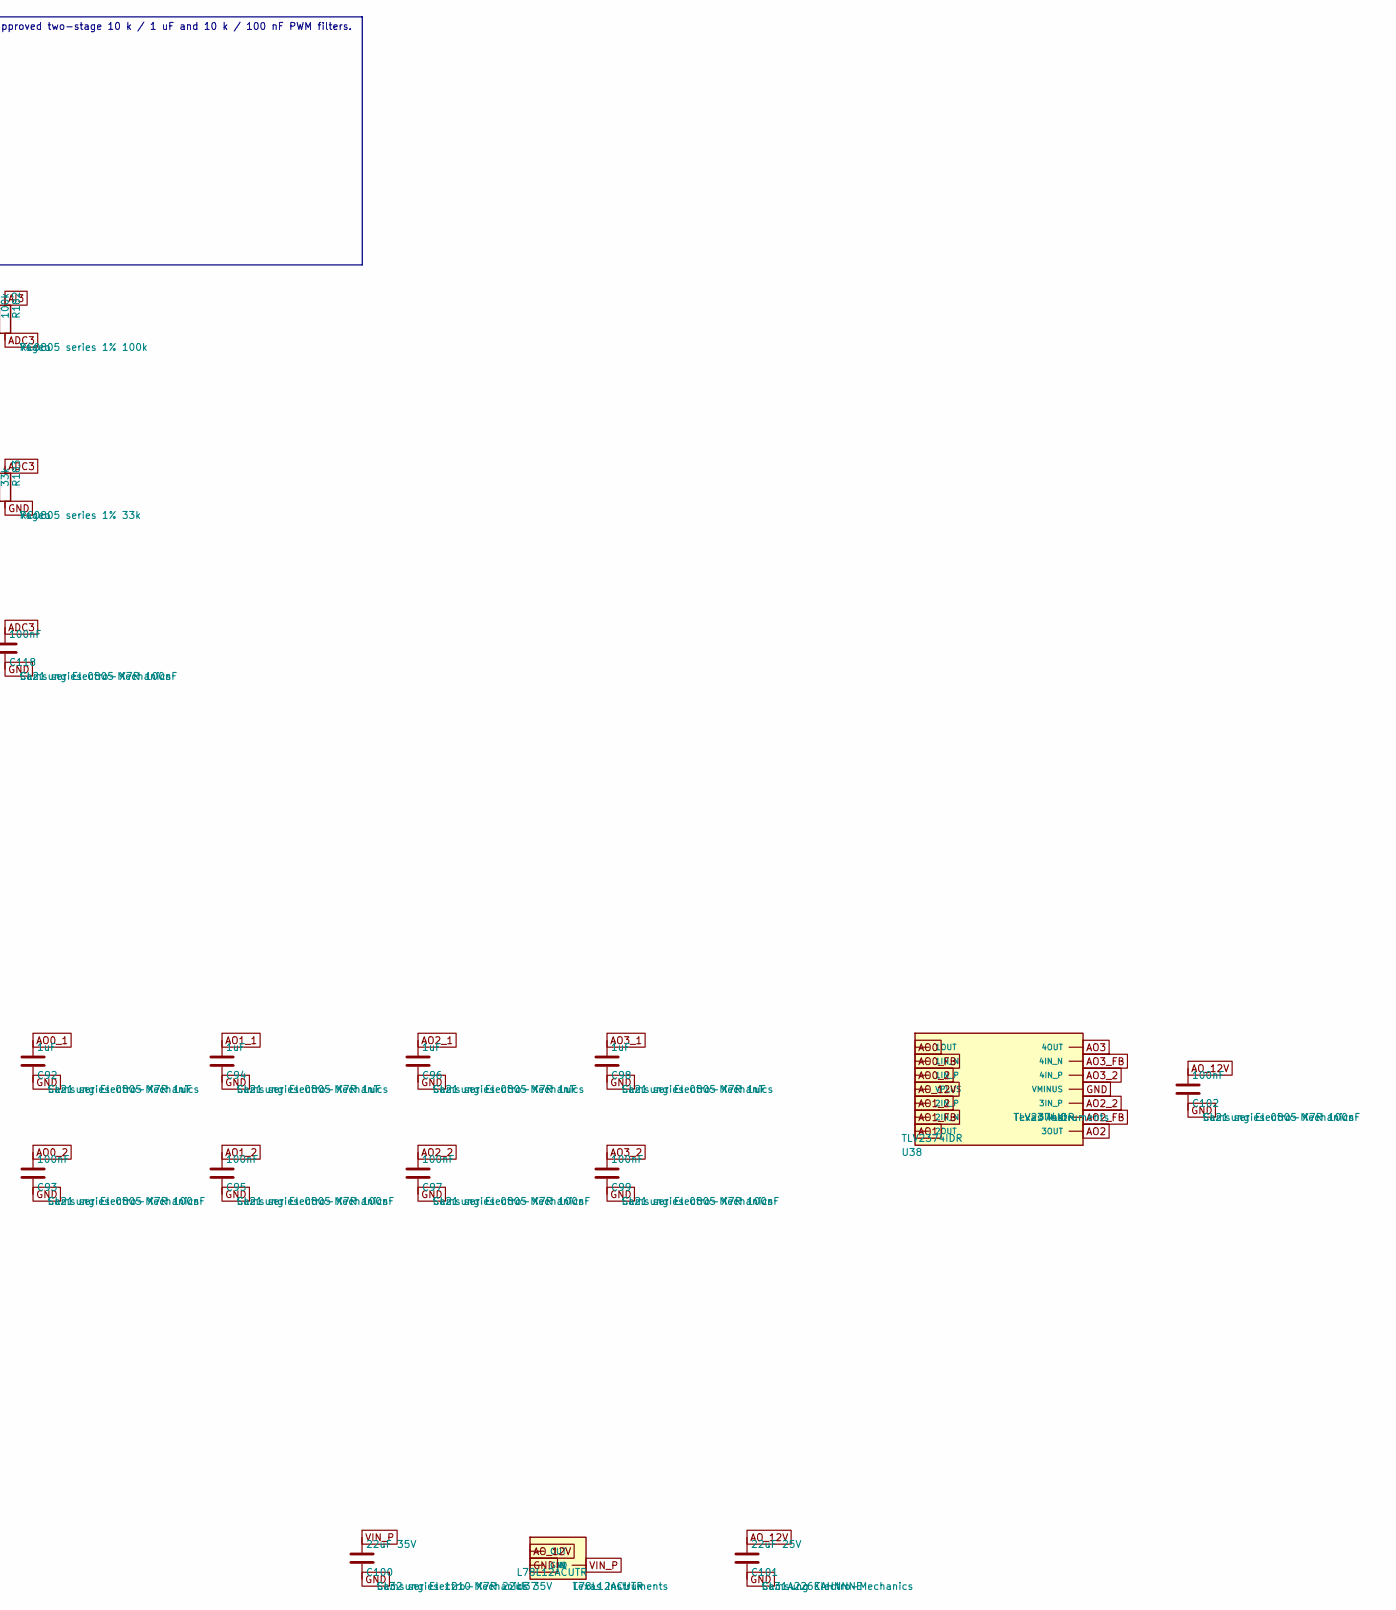
[picture p46: schematic analog_io.kicad_sch, Analog I/O, part in row 1, column 2]

Parts:
C73, C74, C75, C93, C95, C97, C99, C102, C118: 100nF; C_0805_2012Metric; MPN CL21 series 0805 X7R 100nF
C92, C94, C96, C98: 1uF; C_0805_2012Metric; MPN CL21 series 0805 X7R 1uF
C100: 22uF 35V; C_1210_3225Metric; MPN CL32 series 1210 X7R 22uF 35V
C101: 22uF 25V; C_1206_3216Metric; MPN CL31A226KAHNNNE
J24: GND AI0 AI1 AI2 AI3; PhoenixContact_MCV_1,5_5-G-3.5_1x05_P3.50mm_Vertical; MPN Phoenix Contact MCV 1,5/5-G-3.5
J25: GND AO0 AO1 AO2 AO3; PhoenixContact_MCV_1,5_5-G-3.5_1x05_P3.50mm_Vertical; MPN Phoenix Contact MCV 1,5/5-G-3.5
R61, R64, R67, R182: 100k; R_0805_2012Metric; MPN RC0805 series 1% 100k
R63, R66, R69, R183: 33k; R_0805_2012Metric; MPN RC0805 series 1% 33k
R92, R93, R94, R95, R96, R97, R98, R99, R104, R105, R106, R107: 10k; R_0805_2012Metric; MPN RC0805 series 1% 10k
R100, R101, R102, R103: 22k; R_0805_2012Metric; MPN RC0805 series 1% 22k
U37: L78L12ACUTR; SOT-89-3_Handsoldering; MPN L78L12ACUTR
U38: TLV2374IDR; SOIC-14_3.9x8.7mm_P1.27mm; MPN TLV2374IDR

Connections:
ADC0: C73.1, R61.2, R63.1; also elsewhere on the board
ADC1: C74.1, R64.2, R66.1; also elsewhere on the board
ADC2: C75.1, R67.2, R69.1; also elsewhere on the board
ADC3: C118.1, R182.2, R183.1; also elsewhere on the board
AI0: J24.2, R61.1
AI1: J24.3, R64.1
AI2: J24.4, R67.1
AI3: J24.5, R182.1
AO0: J25.2, R100.2, U38.1 (1OUT)
AO0_1: C92.1, R92.2, R96.1
AO0_2: C93.1, R96.2, U38.3 (1IN_P)
AO0_FB: R100.1, R104.1, U38.2 (1IN_N)
AO1: J25.3, R101.2, U38.7 (2OUT)
AO1_1: C94.1, R93.2, R97.1
AO1_2: C95.1, R97.2, U38.5 (2IN_P)
AO1_FB: R101.1, R105.1, U38.6 (2IN_N)
AO2: J25.4, R102.2, U38.8 (3OUT)
AO2_1: C96.1, R94.2, R98.1
AO2_2: C97.1, R98.2, U38.10 (3IN_P)
AO2_FB: R102.1, R106.1, U38.9 (3IN_N)
AO3: J25.5, R103.2, U38.14 (4OUT)
AO3_1: C98.1, R95.2, R99.1
AO3_2: C99.1, R99.2, U38.12 (4IN_P)
AO3_FB: R103.1, R107.1, U38.13 (4IN_N)
AO_12V: C101.1, C102.1, U37.1 (OUT), U38.4 (VPLUS)
GND: C73.2, C74.2, C75.2, C92.2, C93.2, C94.2, C95.2, C96.2, C97.2, C98.2, C99.2, C100.2, C101.2, C102.2, C118.2, J24.1, J25.1, R63.2, R66.2, R69.2, R104.2, R105.2, R106.2, R107.2, R183.2, U37.2 (GND), U38.11 (VMINUS); also elsewhere on the board
PWM0: R92.1; also elsewhere on the board
PWM1: R93.1; also elsewhere on the board
PWM2: R94.1; also elsewhere on the board
PWM3: R95.1; also elsewhere on the board
VIN_P: C100.1, U37.3 (IN); also elsewhere on the board

Notes on the sheet:
Four 0-10 V ADC inputs use a 100 k over 33 k divider and one 100 nF ADC capacitor per channel. Place each divider/filter group at J24, not at the MCU. Four ground-referenced 0-10 V outputs use individual 0805 resistors for the approved two-stage 10 k / 1 uF and 10 k / 100 nF PWM filters. A TLV2374 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

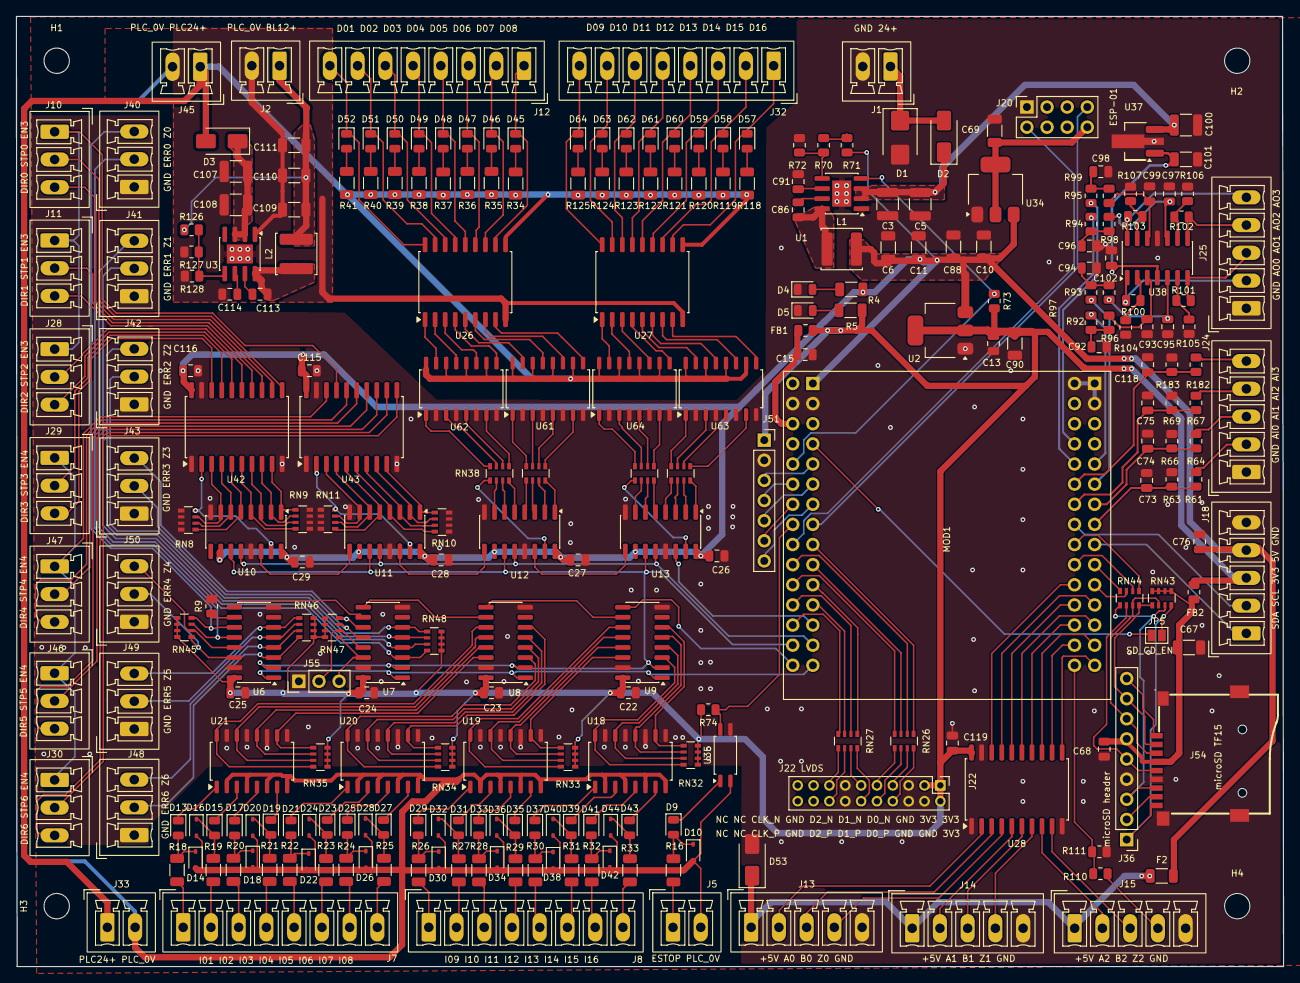
[picture p47: board motherboard.kicad_pcb from above]

Board: 2 copper layers, 159.9 x 119.9 mm, 268 parts (0 on the bottom side), 317 nets.

Other parts of the board:
H1, H2, H3, H4: M3; MountingHole_3.2mm_M3
