staskaaa-netizen/uCNC_Pi_Board/experiments/power-schematic-readability/method-a/lean-power-a.kicad_sch

## KiCad design experiments/power-schematic-readability/method-a/lean-power-a.kicad_sch (2026-11-03)

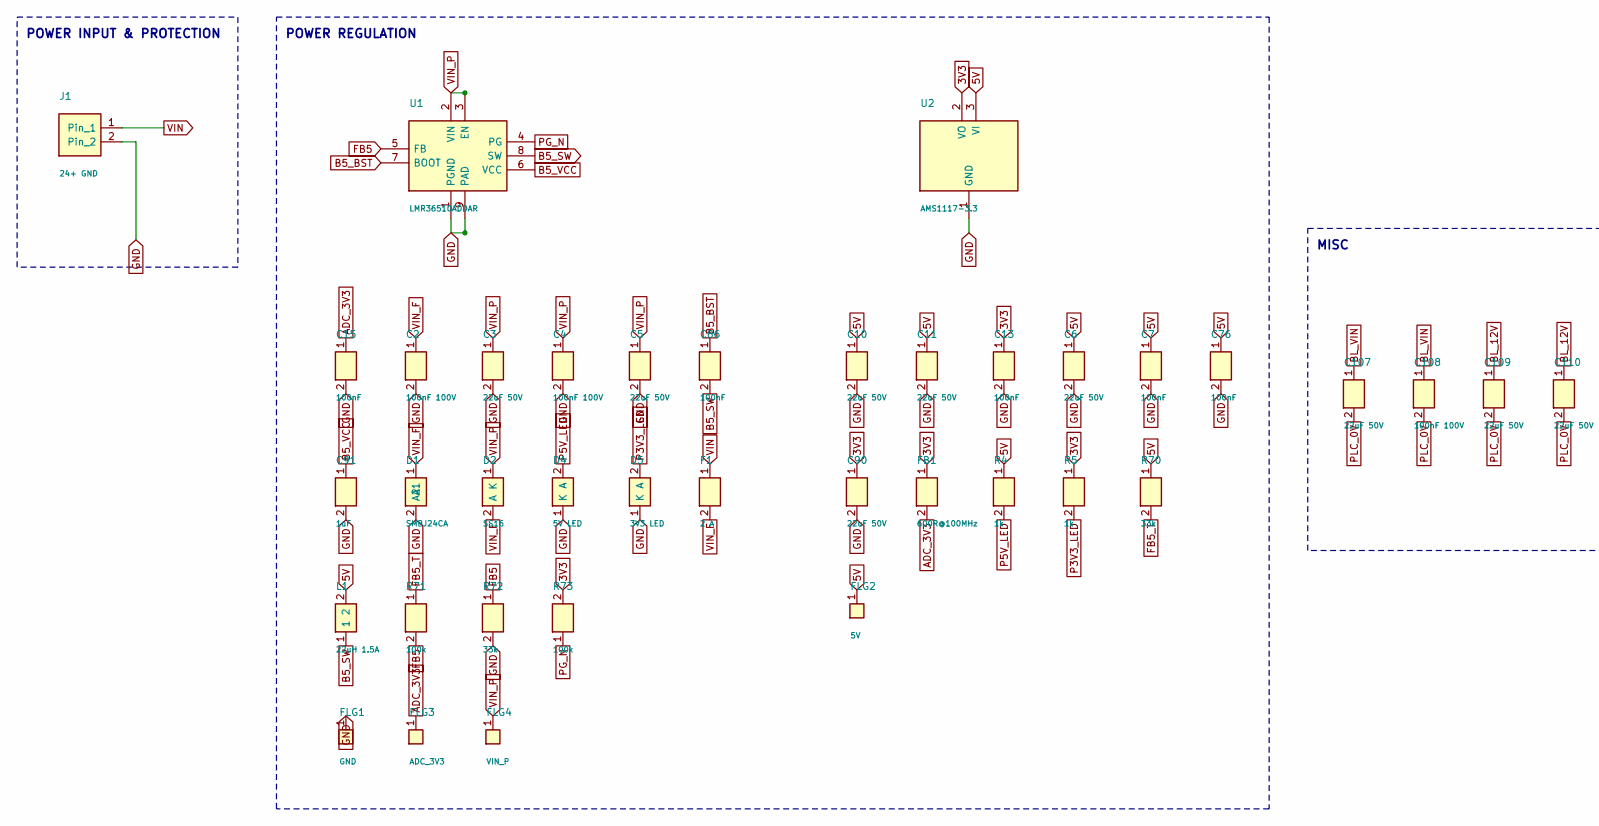
[picture p48: schematic lean-power-a.kicad_sch, part in row 1, column 1]

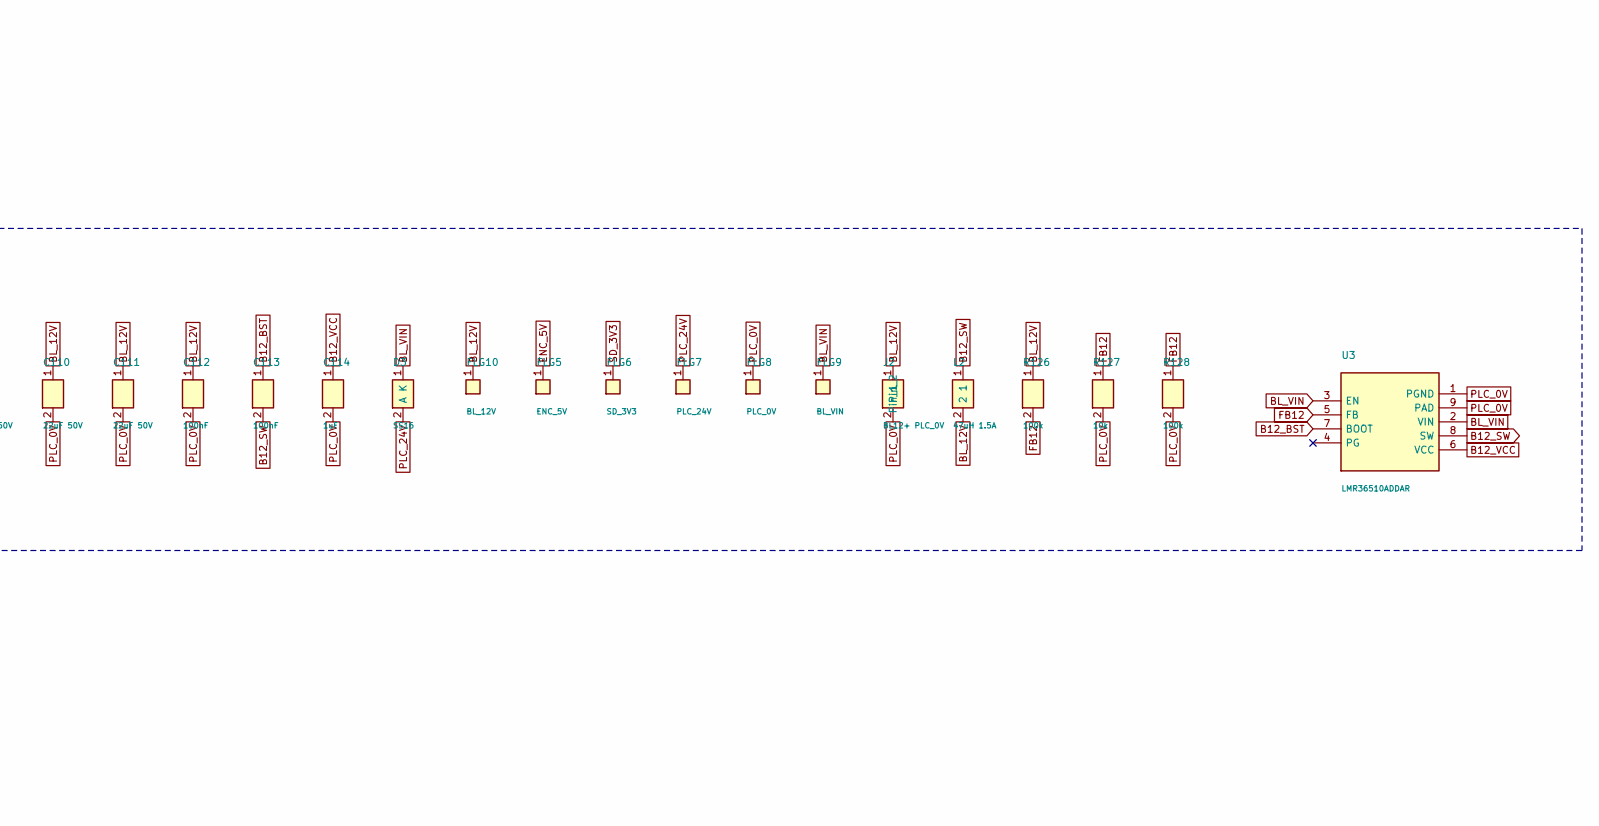
[picture p49: schematic lean-power-a.kicad_sch, part in row 1, column 2]

Parts:
C2, C4, C108: 100nF 100V; C_1206_3216Metric
C3, C5, C6, C10, C11, C90, C107, C109, C110, C111: 22uF 50V; C_1210_3225Metric
C7, C13, C15, C76, C86, C112, C113: 100nF; C_0805_2012Metric
C91, C114: 1uF; C_0805_2012Metric
D1: SMBJ24CA; D_SMB
D2, D3: SS16; D_SMA
D4: 5V LED; LED_1206_3216Metric
D5: 3V3 LED; LED_1206_3216Metric
F1: 2 A; R_1206_3216Metric
FB1: 600R@100MHz; R_1206_3216Metric
FLG1: GND
FLG2: 5V
FLG3: ADC_3V3
FLG4: VIN_P
FLG5: ENC_5V
FLG6: SD_3V3
FLG7: PLC_24V
FLG8: PLC_0V
FLG9: BL_VIN
FLG10: BL_12V
J1: 24+ GND; PhoenixContact_MCV_1,5_2-G-3.5_1x02_P3.50mm_Vertical
J2: BL12+ PLC_0V; PhoenixContact_MCV_1,5_2-G-3.5_1x02_P3.50mm_Vertical
L1: 22uH 1.5A; L_Bourns_SRN6045TA
L2: 47uH 1.5A; L_Bourns_SRN6045TA
R4, R5: 1k; R_1206_3216Metric
R70, R72: 33k; R_1206_3216Metric
R71, R73, R126, R128: 100k; R_1206_3216Metric
R127: 10k; R_1206_3216Metric
U1, U3: LMR36510ADDAR; SOIC-8-1EP_3.9x4.9mm_P1.27mm_EP2.41x3.3mm
U2: AMS1117-3.3; SOT-223-3_TabPin2

Connections:
3V3: C13.1, C90.1, FB1.1, R5.1, R73.2, U2.2 (VO)
5V: C6.1, C7.1, C10.1, C11.1, C76.1, FLG2.1, L1.2, R4.1, R70.1, U2.3 (VI)
ADC_3V3: C15.1, FB1.2, FLG3.1
B5_BST: C86.1, U1.7 (BOOT)
B5_SW: C86.2, L1.1, U1.8 (SW)
B5_VCC: C91.1, U1.6 (VCC)
B12_BST: C113.1, U3.7 (BOOT)
B12_SW: C113.2, L2.1, U3.8 (SW)
B12_VCC: C114.1, U3.6 (VCC)
BL_12V: C109.1, C110.1, C111.1, C112.1, FLG10.1, J2.1, L2.2, R126.1
BL_VIN: C107.1, C108.1, D3.1 (K), FLG9.1, U3.2 (VIN), U3.3 (EN)
ENC_5V: FLG5.1
FB5: R71.2, R72.1, U1.5 (FB)
FB5_T: R70.2, R71.1
FB12: R126.2, R127.1, R128.1, U3.5 (FB)
GND: C2.2, C3.2, C4.2, C5.2, C6.2, C7.2, C10.2, C11.2, C13.2, C15.2, C76.2, C90.2, C91.2, D1.2 (A2), D4.1 (K), D5.1 (K), FLG1.1, J1.2, R72.2, U1.1 (PGND), U1.9 (PAD), U2.1 (GND)
P3V3_LED: D5.2 (A), R5.2
P5V_LED: D4.2 (A), R4.2
PG_N: R73.1, U1.4 (PG)
PLC_0V: C107.2, C108.2, C109.2, C110.2, C111.2, C112.2, C114.2, FLG8.1, J2.2, R127.2, R128.2, U3.1 (PGND), U3.9 (PAD)
PLC_24V: D3.2 (A), FLG7.1
SD_3V3: FLG6.1
VIN: F1.1, J1.1
VIN_F: C2.1, D1.1 (A1), D2.2 (A), F1.2
VIN_P: C3.1, C4.1, C5.1, D2.1 (K), FLG4.1, U1.2 (VIN), U1.3 (EN)

Notes on the sheet:
MISC
POWER REGULATION
POWER INPUT & PROTECTION
