staskaaa-netizen/uCNC_Pi_Board/experiments/power-schematic-readability/other-sheets/analog_io-python.kicad_sch

## KiCad design experiments/power-schematic-readability/other-sheets/analog_io-python.kicad_sch (2026-11-03)

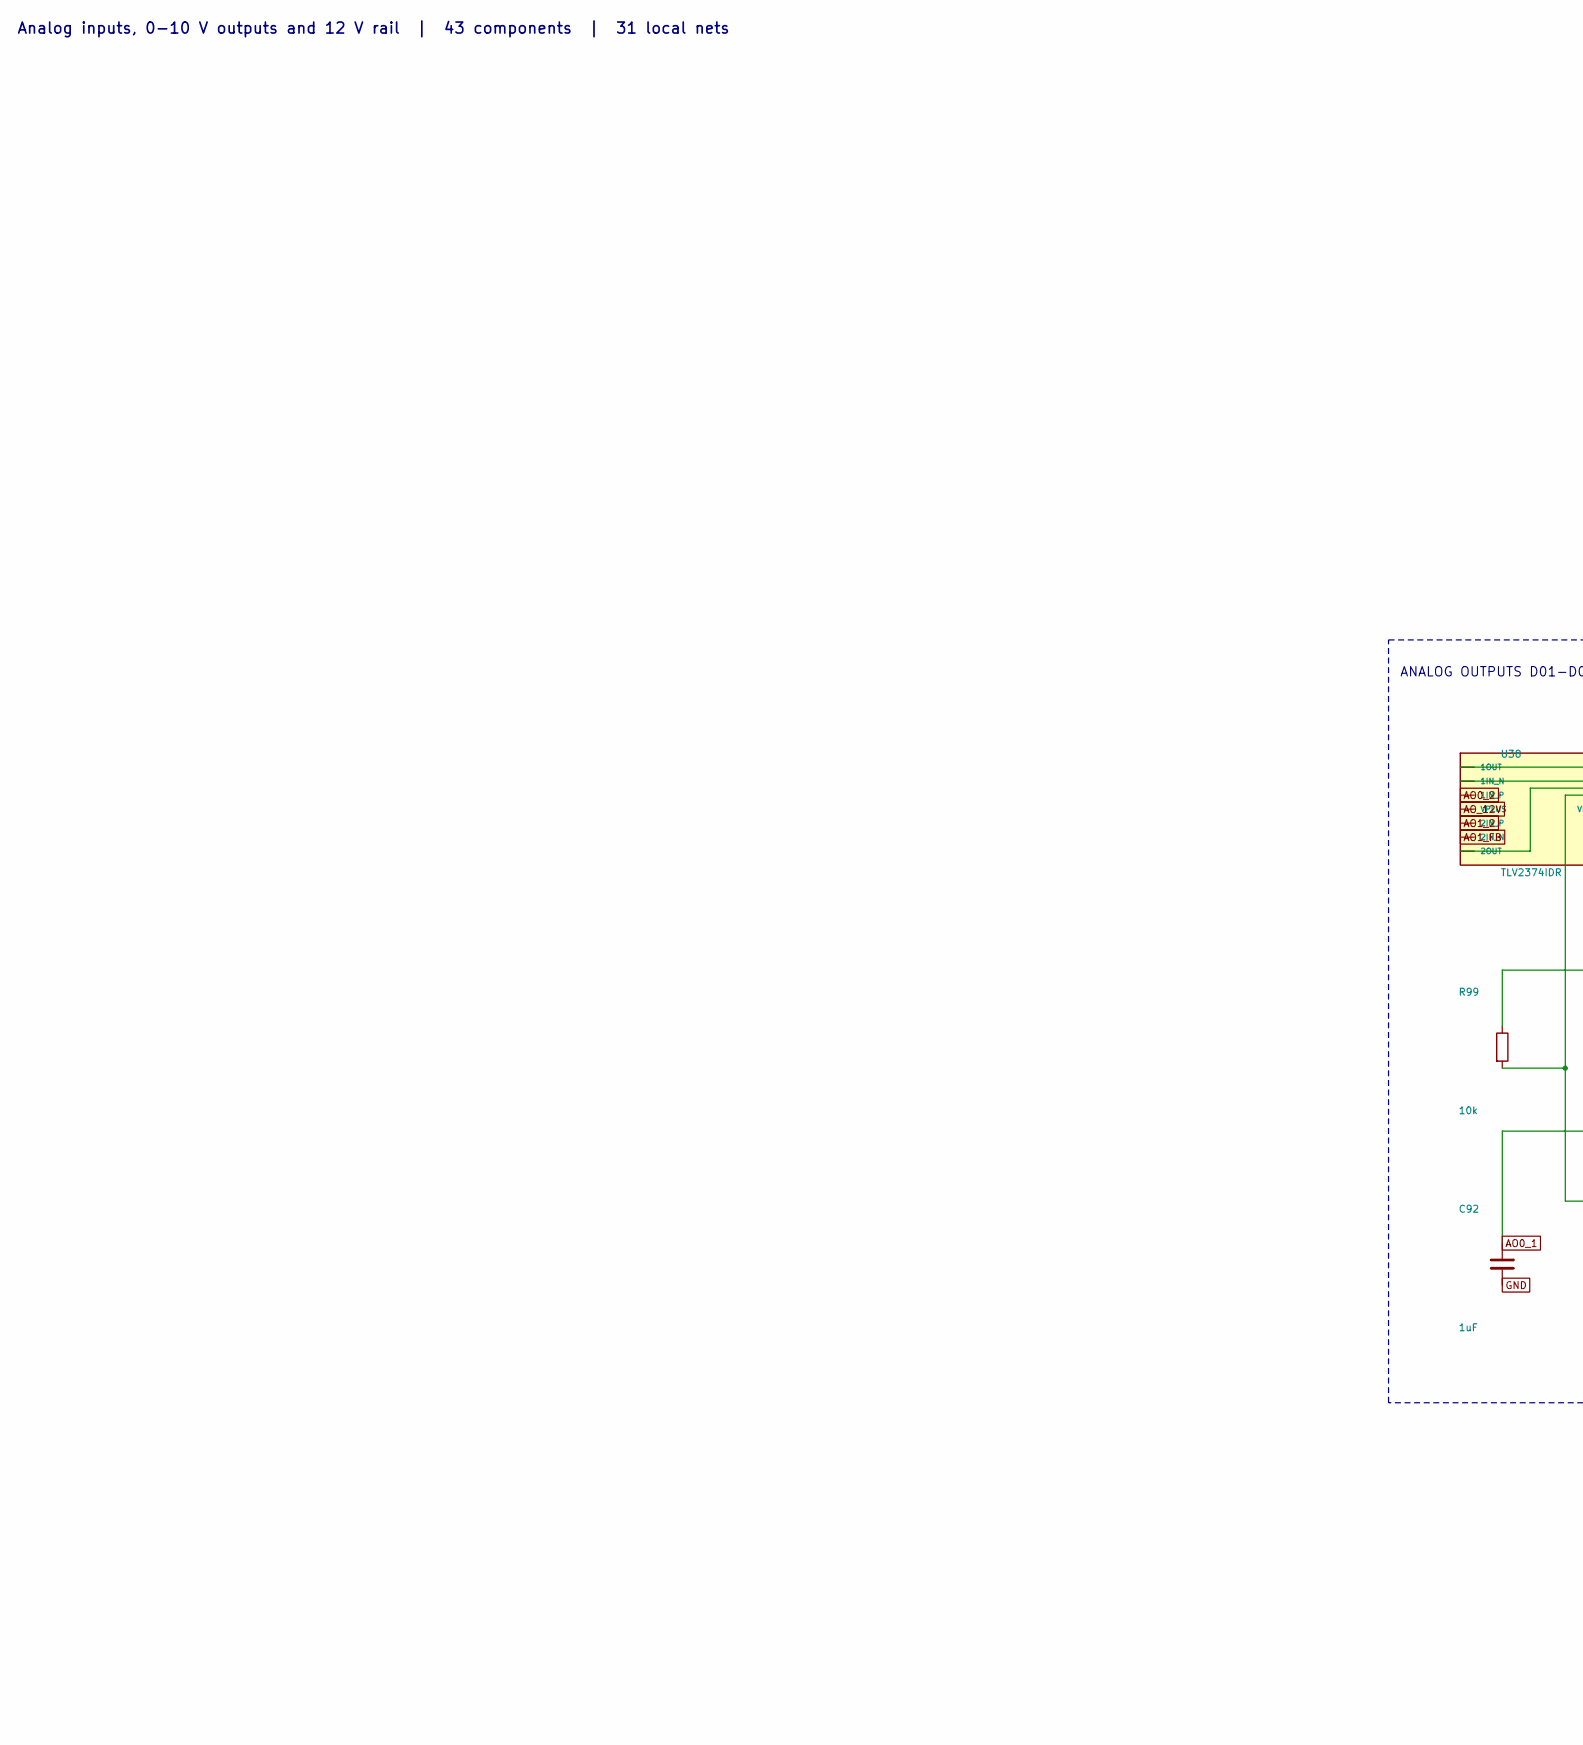
[picture p50: schematic analog_io-python.kicad_sch, part in row 1, column 1]

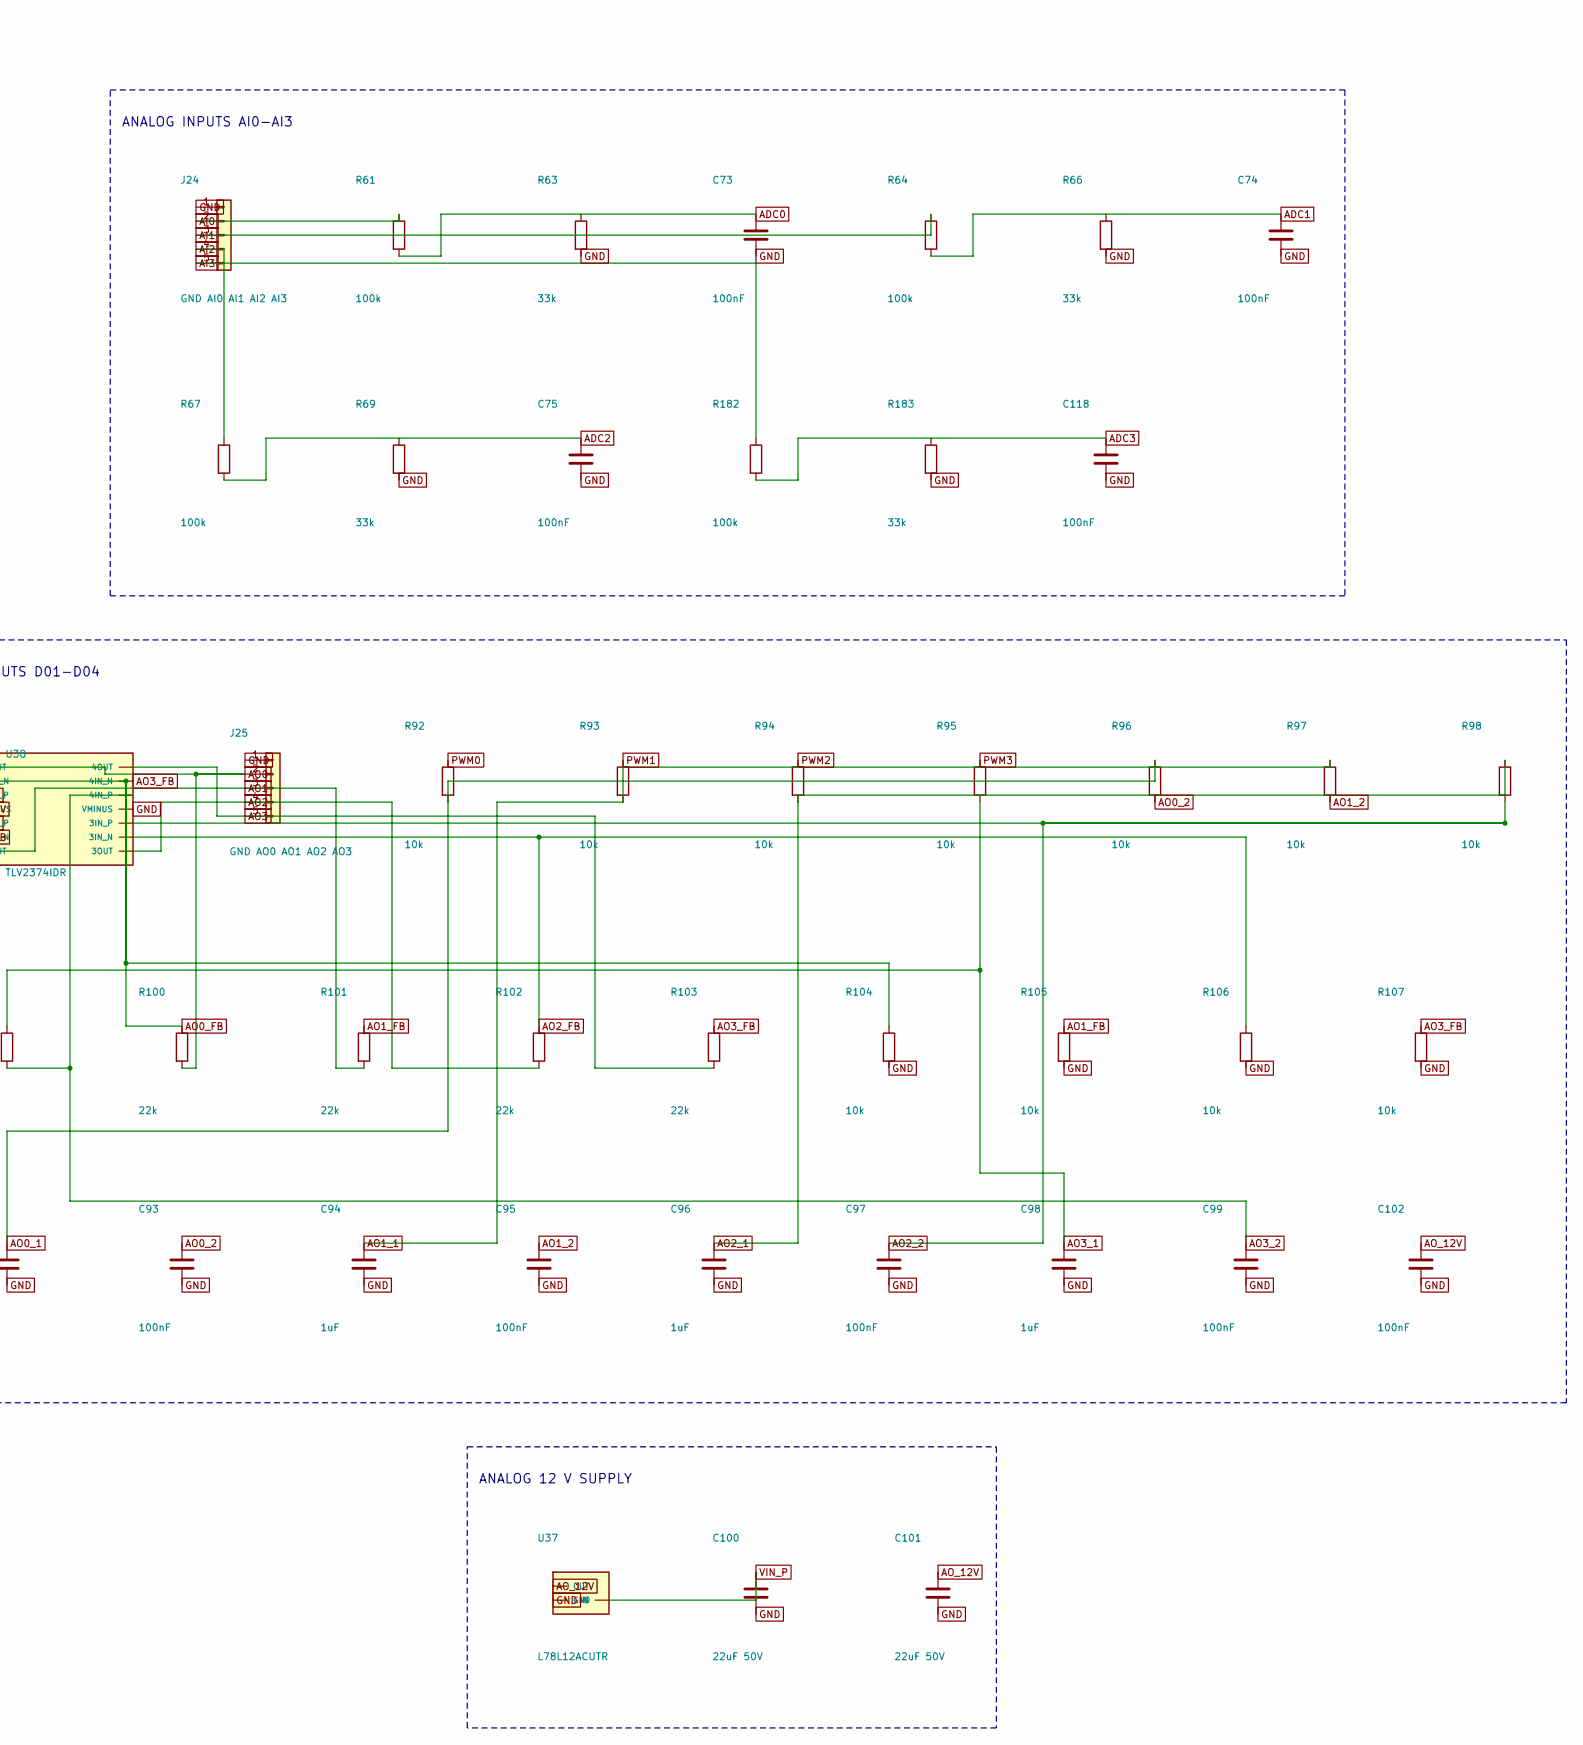
[picture p51: schematic analog_io-python.kicad_sch, part in row 1, column 2]

Parts:
C73, C74, C75, C93, C95, C97, C99, C102, C118: 100nF; C_0805_2012Metric; MPN CL21 series 0805 X7R 100nF
C92, C94, C96, C98: 1uF; C_0805_2012Metric; MPN CL21 series 0805 X7R 1uF
C100, C101: 22uF 50V; C_1210_3225Metric; MPN CL32 series 1210 X7R 22uF 50V
J24: GND AI0 AI1 AI2 AI3; PhoenixContact_MCV_1,5_5-G-3.5_1x05_P3.50mm_Vertical; MPN Phoenix Contact MCV 1,5/5-G-3.5
J25: GND AO0 AO1 AO2 AO3; PhoenixContact_MCV_1,5_5-G-3.5_1x05_P3.50mm_Vertical; MPN Phoenix Contact MCV 1,5/5-G-3.5
R61, R64, R67, R182: 100k; R_1206_3216Metric; MPN RC1206FR-07 1% 100k
R63, R66, R69, R183: 33k; R_1206_3216Metric; MPN RC1206FR-07 1% 33k
R92, R93, R94, R95, R96, R97, R98, R99, R104, R105, R106, R107: 10k; R_0805_2012Metric; MPN RC0805 series 1% 10k
R100, R101, R102, R103: 22k; R_0805_2012Metric; MPN RC0805 series 1% 22k
U37: L78L12ACUTR; SOT-89-3_Handsoldering; MPN L78L12ACUTR
U38: TLV2374IDR; SOIC-14_3.9x8.7mm_P1.27mm; MPN TLV2374IDR

Connections:
ADC0: C73.1, R61.2, R63.1
ADC1: C74.1, R64.2, R66.1
ADC2: C75.1, R67.2, R69.1
ADC3: C118.1, R182.2, R183.1
AI0: J24.2, R61.1
AI1: J24.3, R64.1
AI2: J24.4, R67.1
AI3: J24.5, R182.1
AO0: J25.2, R100.2, U38.1 (1OUT)
AO0_1: C92.1, R92.2, R96.1
AO0_2: C93.1, R96.2, U38.3 (1IN_P)
AO0_FB: R100.1, R104.1, U38.2 (1IN_N)
AO1: J25.3, R101.2, U38.7 (2OUT)
AO1_1: C94.1, R93.2, R97.1
AO1_2: C95.1, R97.2, U38.5 (2IN_P)
AO1_FB: R101.1, R105.1, U38.6 (2IN_N)
AO2: J25.4, R102.2, U38.8 (3OUT)
AO2_1: C96.1, R94.2, R98.1
AO2_2: C97.1, R98.2, U38.10 (3IN_P)
AO2_FB: R102.1, R106.1, U38.9 (3IN_N)
AO3: J25.5, R103.2, U38.14 (4OUT)
AO3_1: C98.1, R95.2, R99.1
AO3_2: C99.1, R99.2, U38.12 (4IN_P)
AO3_FB: R103.1, R107.1, U38.13 (4IN_N)
AO_12V: C101.1, C102.1, U37.1 (OUT), U38.4 (VPLUS)
GND: C73.2, C74.2, C75.2, C92.2, C93.2, C94.2, C95.2, C96.2, C97.2, C98.2, C99.2, C100.2, C101.2, C102.2, C118.2, J24.1, J25.1, R63.2, R66.2, R69.2, R104.2, R105.2, R106.2, R107.2, R183.2, U37.2 (GND), U38.11 (VMINUS)
PWM0: R92.1
PWM1: R93.1
PWM2: R94.1
PWM3: R95.1
VIN_P: C100.1, U37.3 (IN)

Notes on the sheet:
Analog inputs, 0-10 V outputs and 12 V rail | 43 components | 31 local nets
ANALOG INPUTS AI0-AI3
ANALOG OUTPUTS D01-D04
ANALOG 12 V SUPPLY
