staskaaa-netizen/uCNC_Pi_Board/experiments/power-schematic-readability/other-sheets/display-python.kicad_sch

## KiCad design experiments/power-schematic-readability/other-sheets/display-python.kicad_sch (2026-11-03)

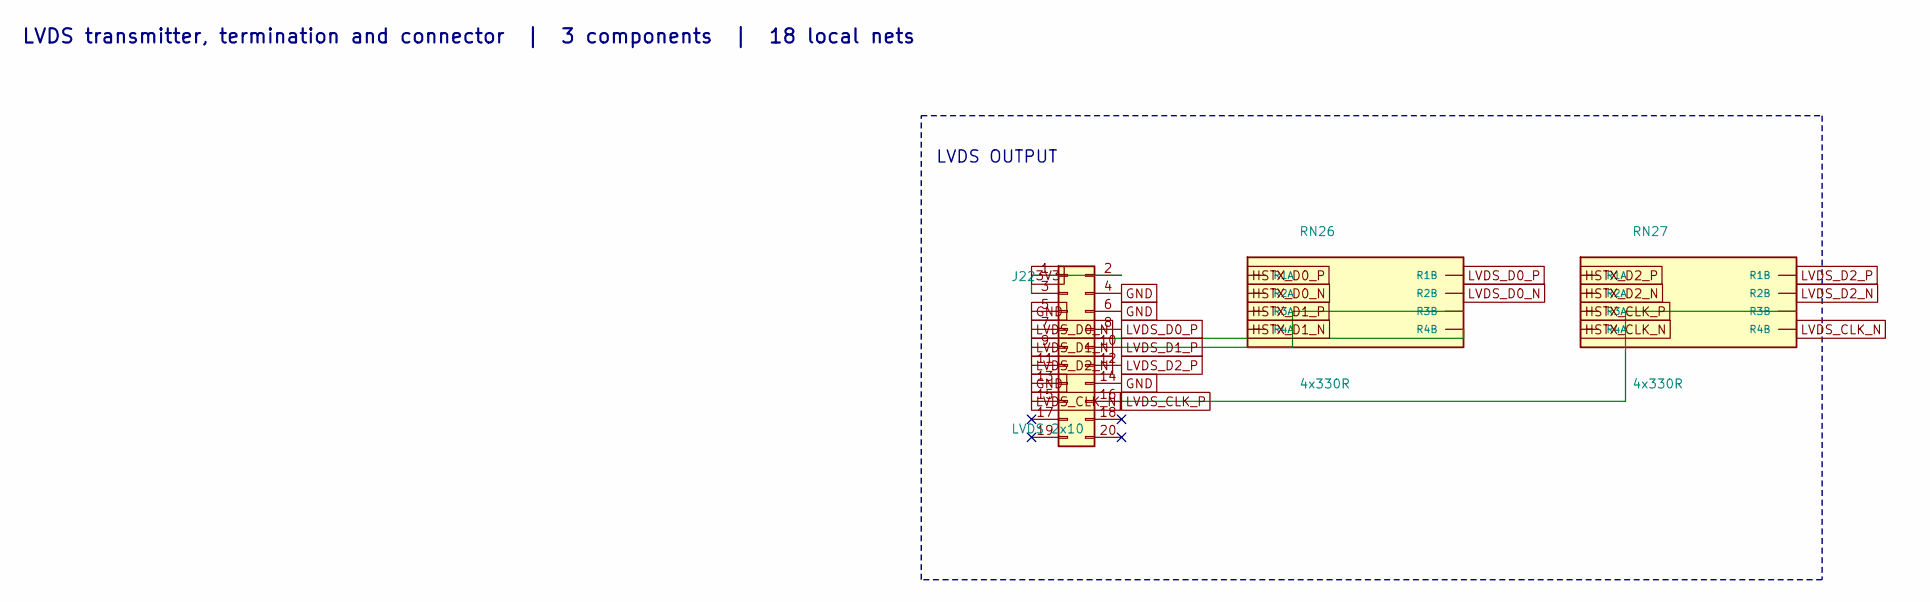
[picture p52: schematic display-python.kicad_sch]

Parts:
J22: LVDS 2x10; PinHeader_2x10_P2.00mm_Vertical; MPN LVDS 2x10
RN26, RN27: 4x330R; R_Array_Convex_4x1206; MPN YC324-FR-07330RL

Connections:
3V3: J22.1, J22.2, J22.3
GND: J22.4, J22.5, J22.6, J22.13, J22.14
HSTX_CLK_N: RN27.4 (R4A)
HSTX_CLK_P: RN27.3 (R3A)
HSTX_D0_N: RN26.2 (R2A)
HSTX_D0_P: RN26.1 (R1A)
HSTX_D1_N: RN26.4 (R4A)
HSTX_D1_P: RN26.3 (R3A)
HSTX_D2_N: RN27.2 (R2A)
HSTX_D2_P: RN27.1 (R1A)
LVDS_CLK_N: J22.15, RN27.5 (R4B)
LVDS_CLK_P: J22.16, RN27.6 (R3B)
LVDS_D0_N: J22.7, RN26.7 (R2B)
LVDS_D0_P: J22.8, RN26.8 (R1B)
LVDS_D1_N: J22.9, RN26.5 (R4B)
LVDS_D1_P: J22.10, RN26.6 (R3B)
LVDS_D2_N: J22.11, RN27.7 (R2B)
LVDS_D2_P: J22.12, RN27.8 (R1B)

Notes on the sheet:
LVDS transmitter, termination and connector | 3 components | 18 local nets
LVDS OUTPUT
