staskaaa-netizen/uCNC_Pi_Board/experiments/power-schematic-readability/other-sheets/encoders-python.kicad_sch

## KiCad design experiments/power-schematic-readability/other-sheets/encoders-python.kicad_sch (2026-11-03)

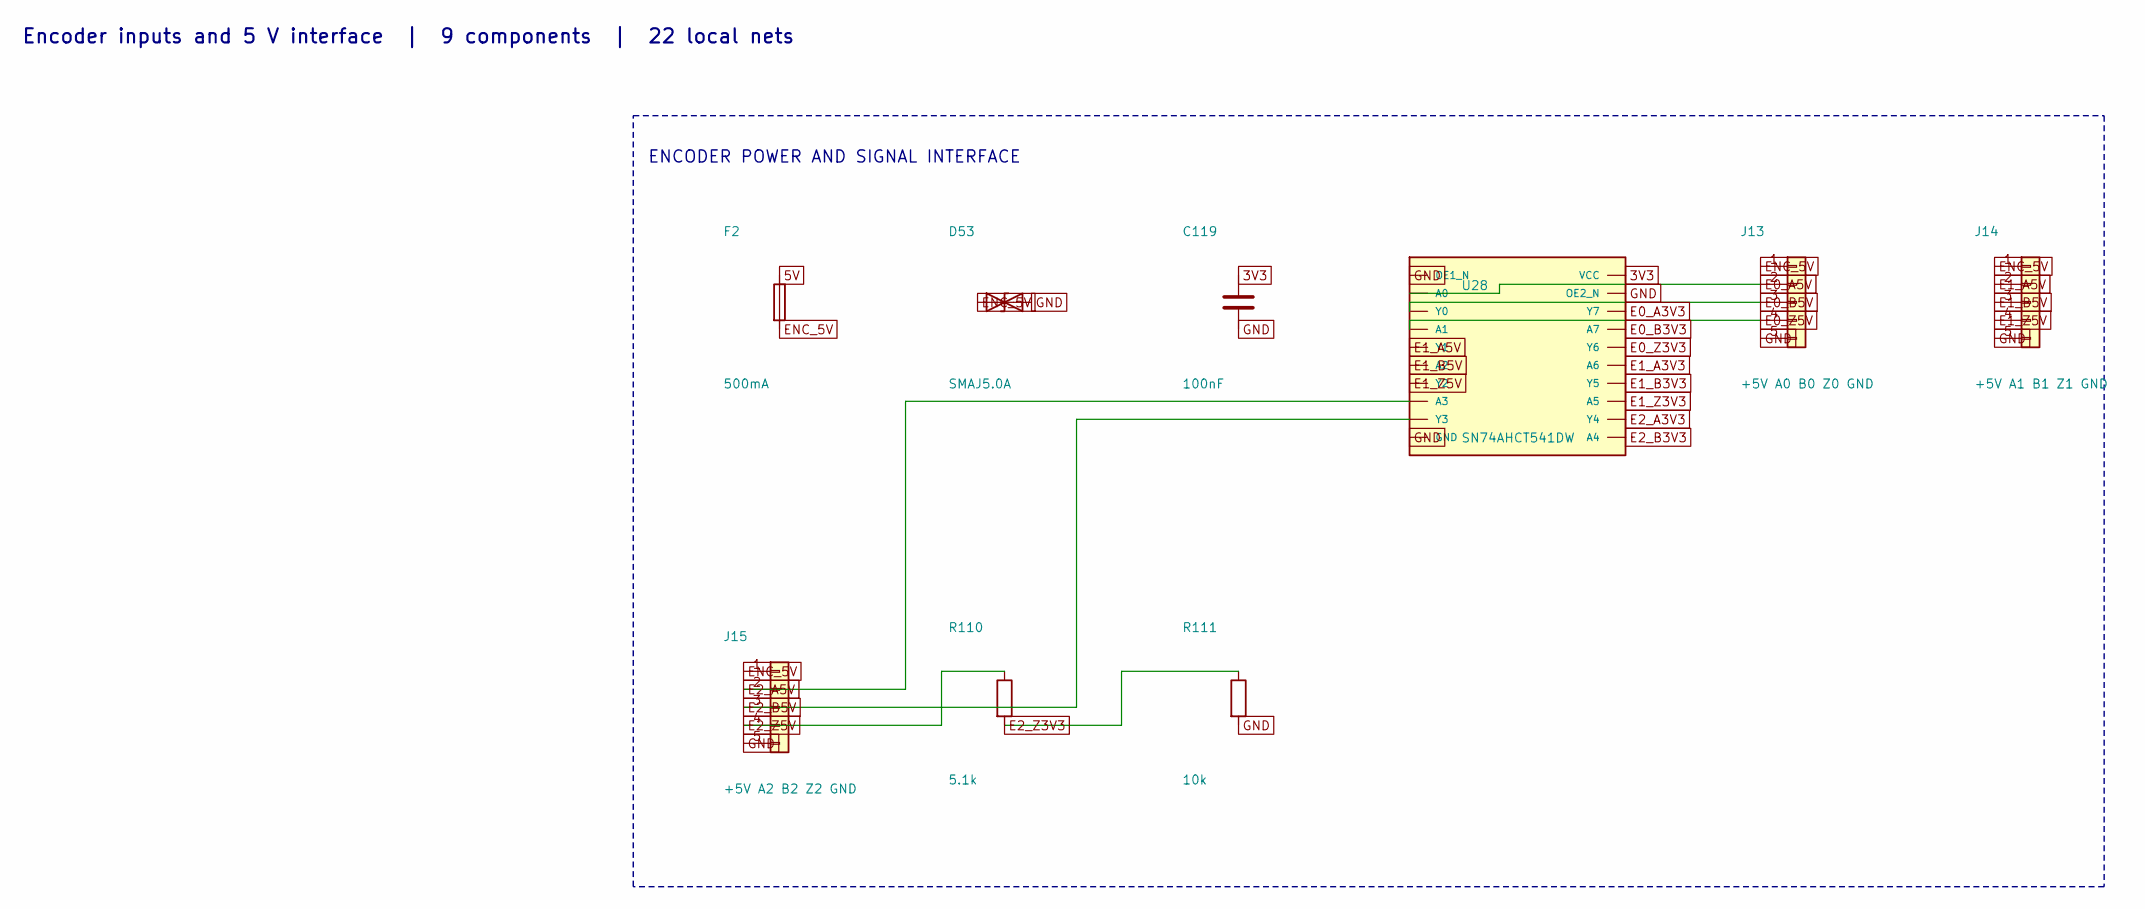
[picture p53: schematic encoders-python.kicad_sch]

Parts:
C119: 100nF; C_0805_2012Metric; MPN CL21 series 0805 X7R 100nF
D53: SMAJ5.0A; D_SMA; MPN SMAJ5.0A
F2: 500mA; R_1206_3216Metric; MPN 0ZCG0050FF2E
J13: +5V A0 B0 Z0 GND; PhoenixContact_MCV_1,5_5-G-3.5_1x05_P3.50mm_Vertical; MPN Phoenix Contact MCV 1,5/5-G-3.5
J14: +5V A1 B1 Z1 GND; PhoenixContact_MCV_1,5_5-G-3.5_1x05_P3.50mm_Vertical; MPN Phoenix Contact MCV 1,5/5-G-3.5
J15: +5V A2 B2 Z2 GND; PhoenixContact_MCV_1,5_5-G-3.5_1x05_P3.50mm_Vertical; MPN Phoenix Contact MCV 1,5/5-G-3.5
R110: 5.1k; R_0805_2012Metric; MPN RC0805 series 1% 5.1k
R111: 10k; R_0805_2012Metric; MPN RC0805 series 1% 10k
U28: SN74AHCT541DW; SOIC-20W_7.5x12.8mm_P1.27mm; MPN SN74AHCT541DW

Connections:
3V3: C119.1, U28.20 (VCC)
5V: F2.1
E0_A3V3: U28.18 (Y7)
E0_A5V: J13.2, U28.2 (A0)
E0_B3V3: U28.17 (A7)
E0_B5V: J13.3, U28.3 (Y0)
E0_Z3V3: U28.16 (Y6)
E0_Z5V: J13.4, U28.4 (A1)
E1_A3V3: U28.15 (A6)
E1_A5V: J14.2, U28.5 (Y1)
E1_B3V3: U28.14 (Y5)
E1_B5V: J14.3, U28.6 (A2)
E1_Z3V3: U28.13 (A5)
E1_Z5V: J14.4, U28.7 (Y2)
E2_A3V3: U28.12 (Y4)
E2_A5V: J15.2, U28.8 (A3)
E2_B3V3: U28.11 (A4)
E2_B5V: J15.3, U28.9 (Y3)
E2_Z3V3: R110.2, R111.1
E2_Z5V: J15.4, R110.1
ENC_5V: D53.1 (A1), F2.2, J13.1, J14.1, J15.1
GND: C119.2, D53.2 (A2), J13.5, J14.5, J15.5, R111.2, U28.1 (OE1_N), U28.10 (GND), U28.19 (OE2_N)

Notes on the sheet:
Encoder inputs and 5 V interface | 9 components | 22 local nets
ENCODER POWER AND SIGNAL INTERFACE
