staskaaa-netizen/uCNC_Pi_Board/experiments/power-schematic-readability/other-sheets/field_inputs-python.kicad_sch

## KiCad design experiments/power-schematic-readability/other-sheets/field_inputs-python.kicad_sch (2026-11-03)

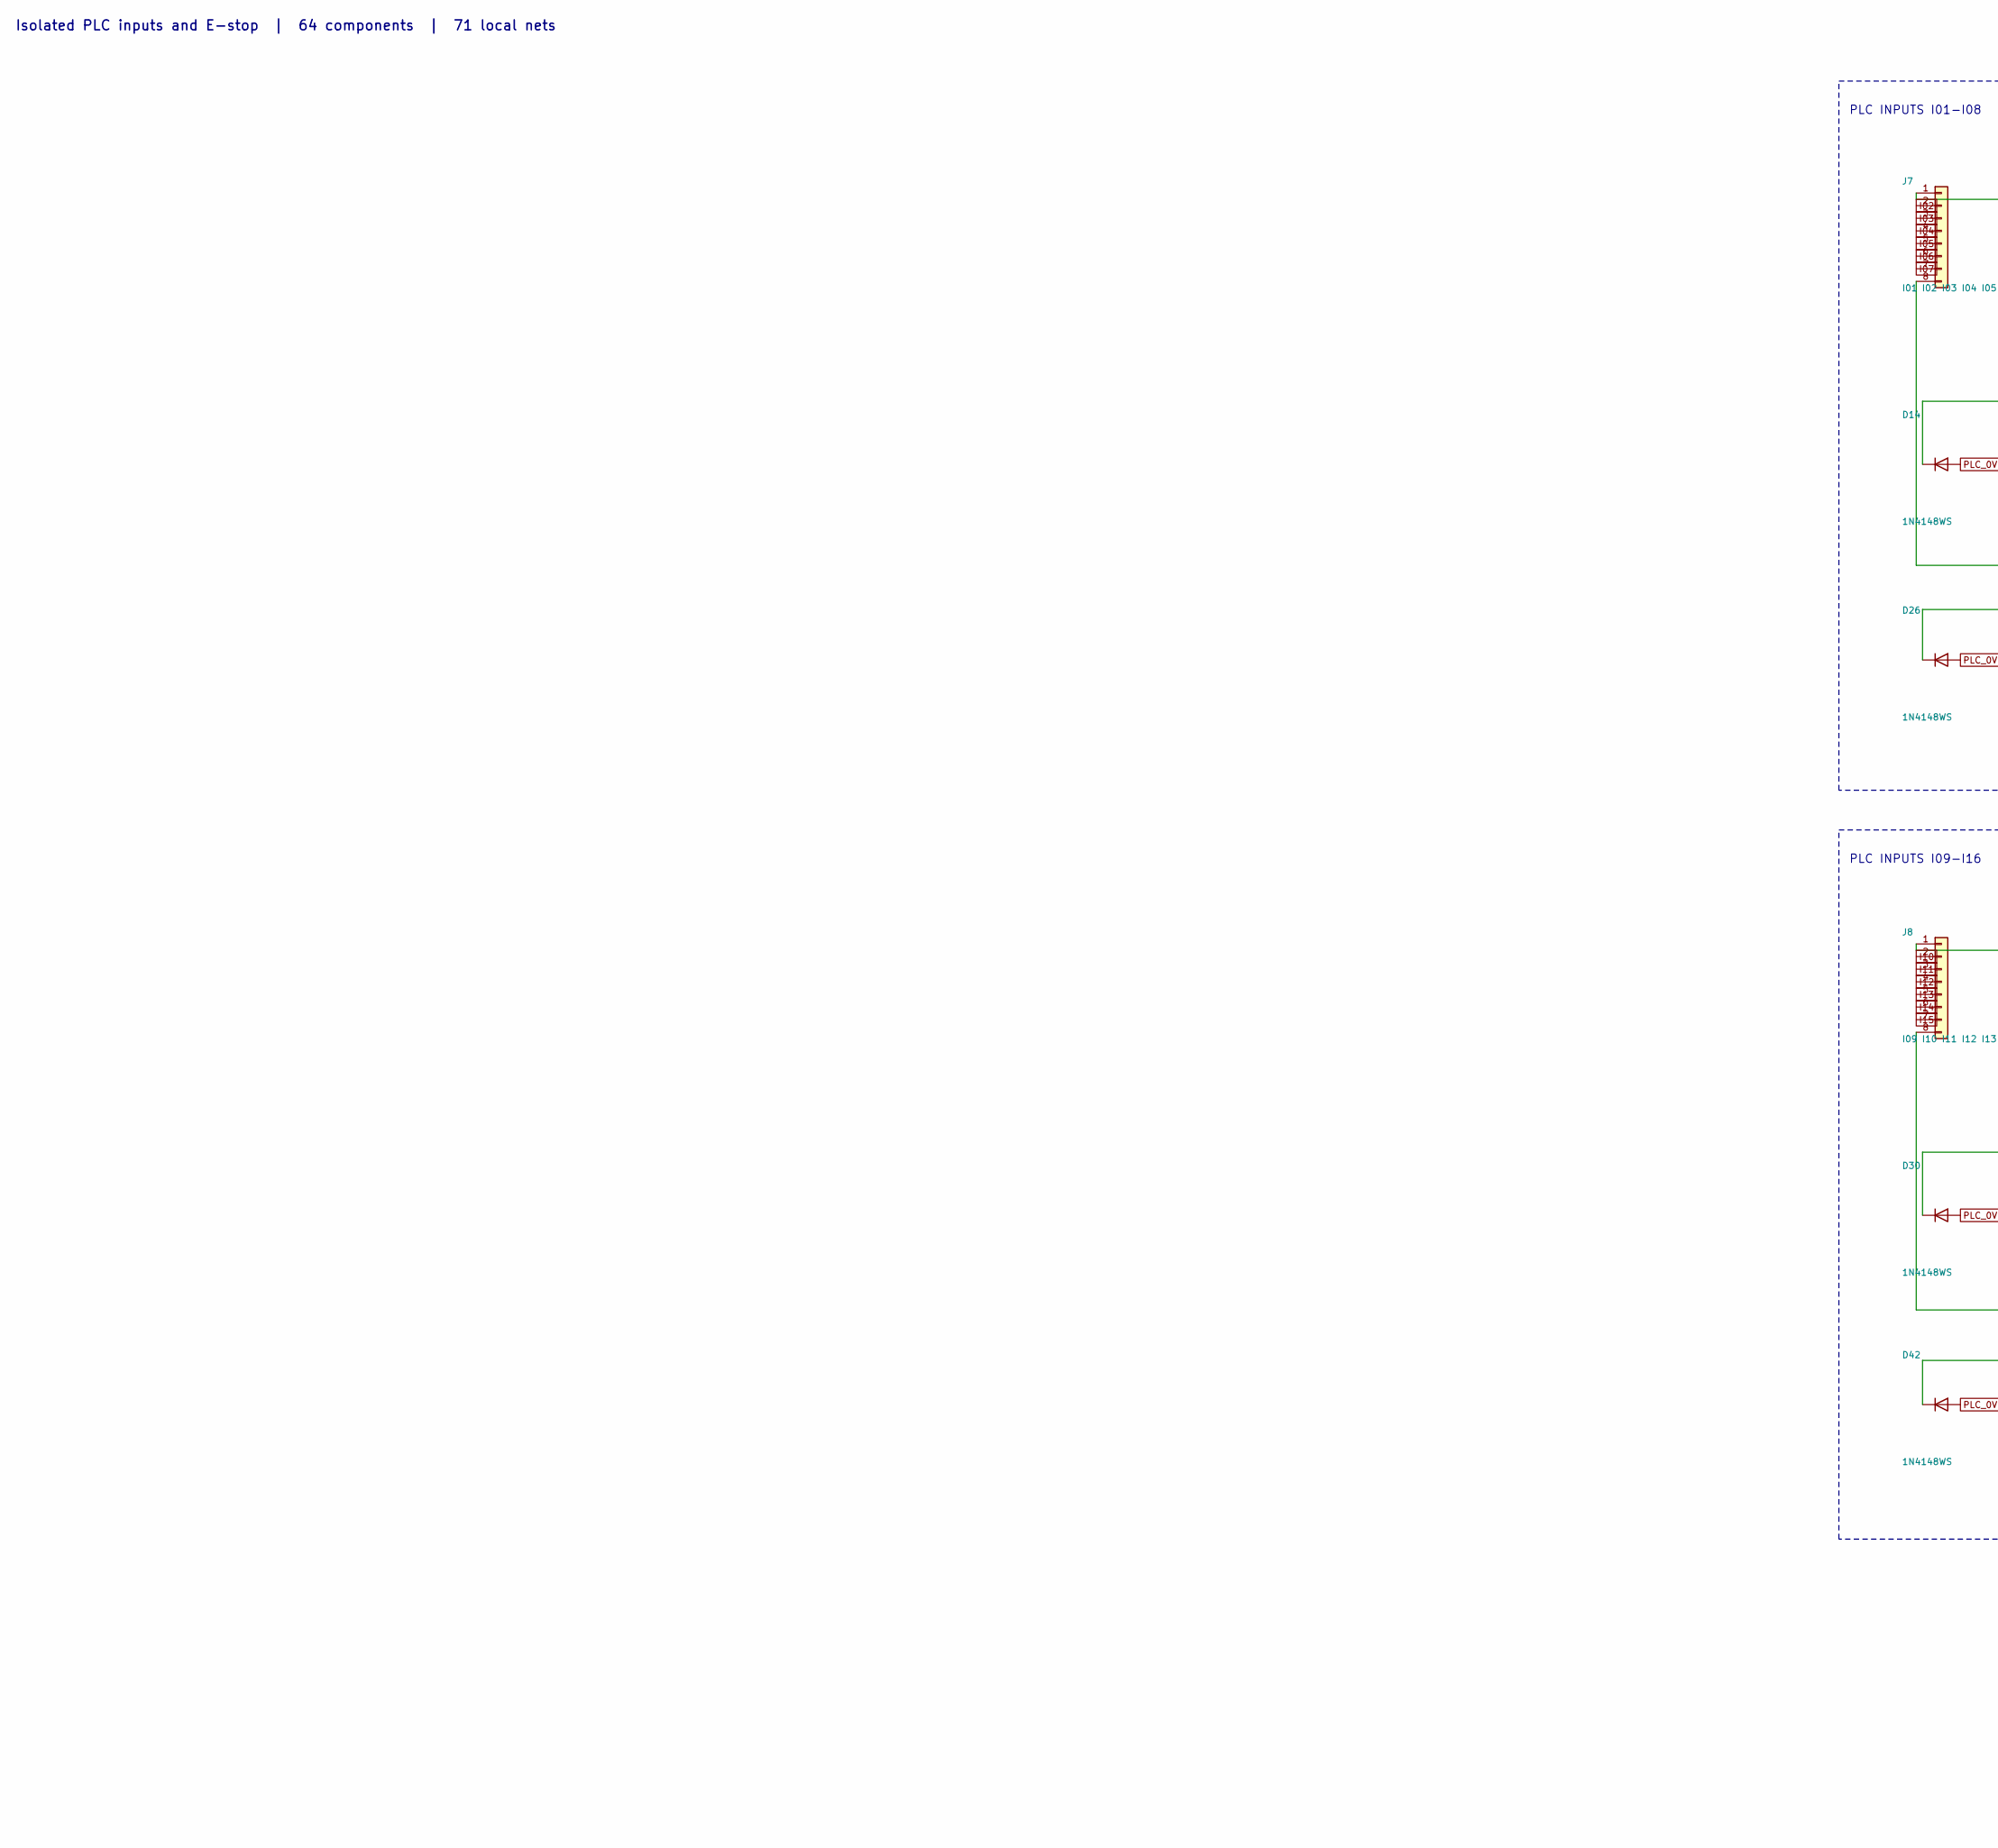
[picture p54: schematic field_inputs-python.kicad_sch, part in row 1, column 1]

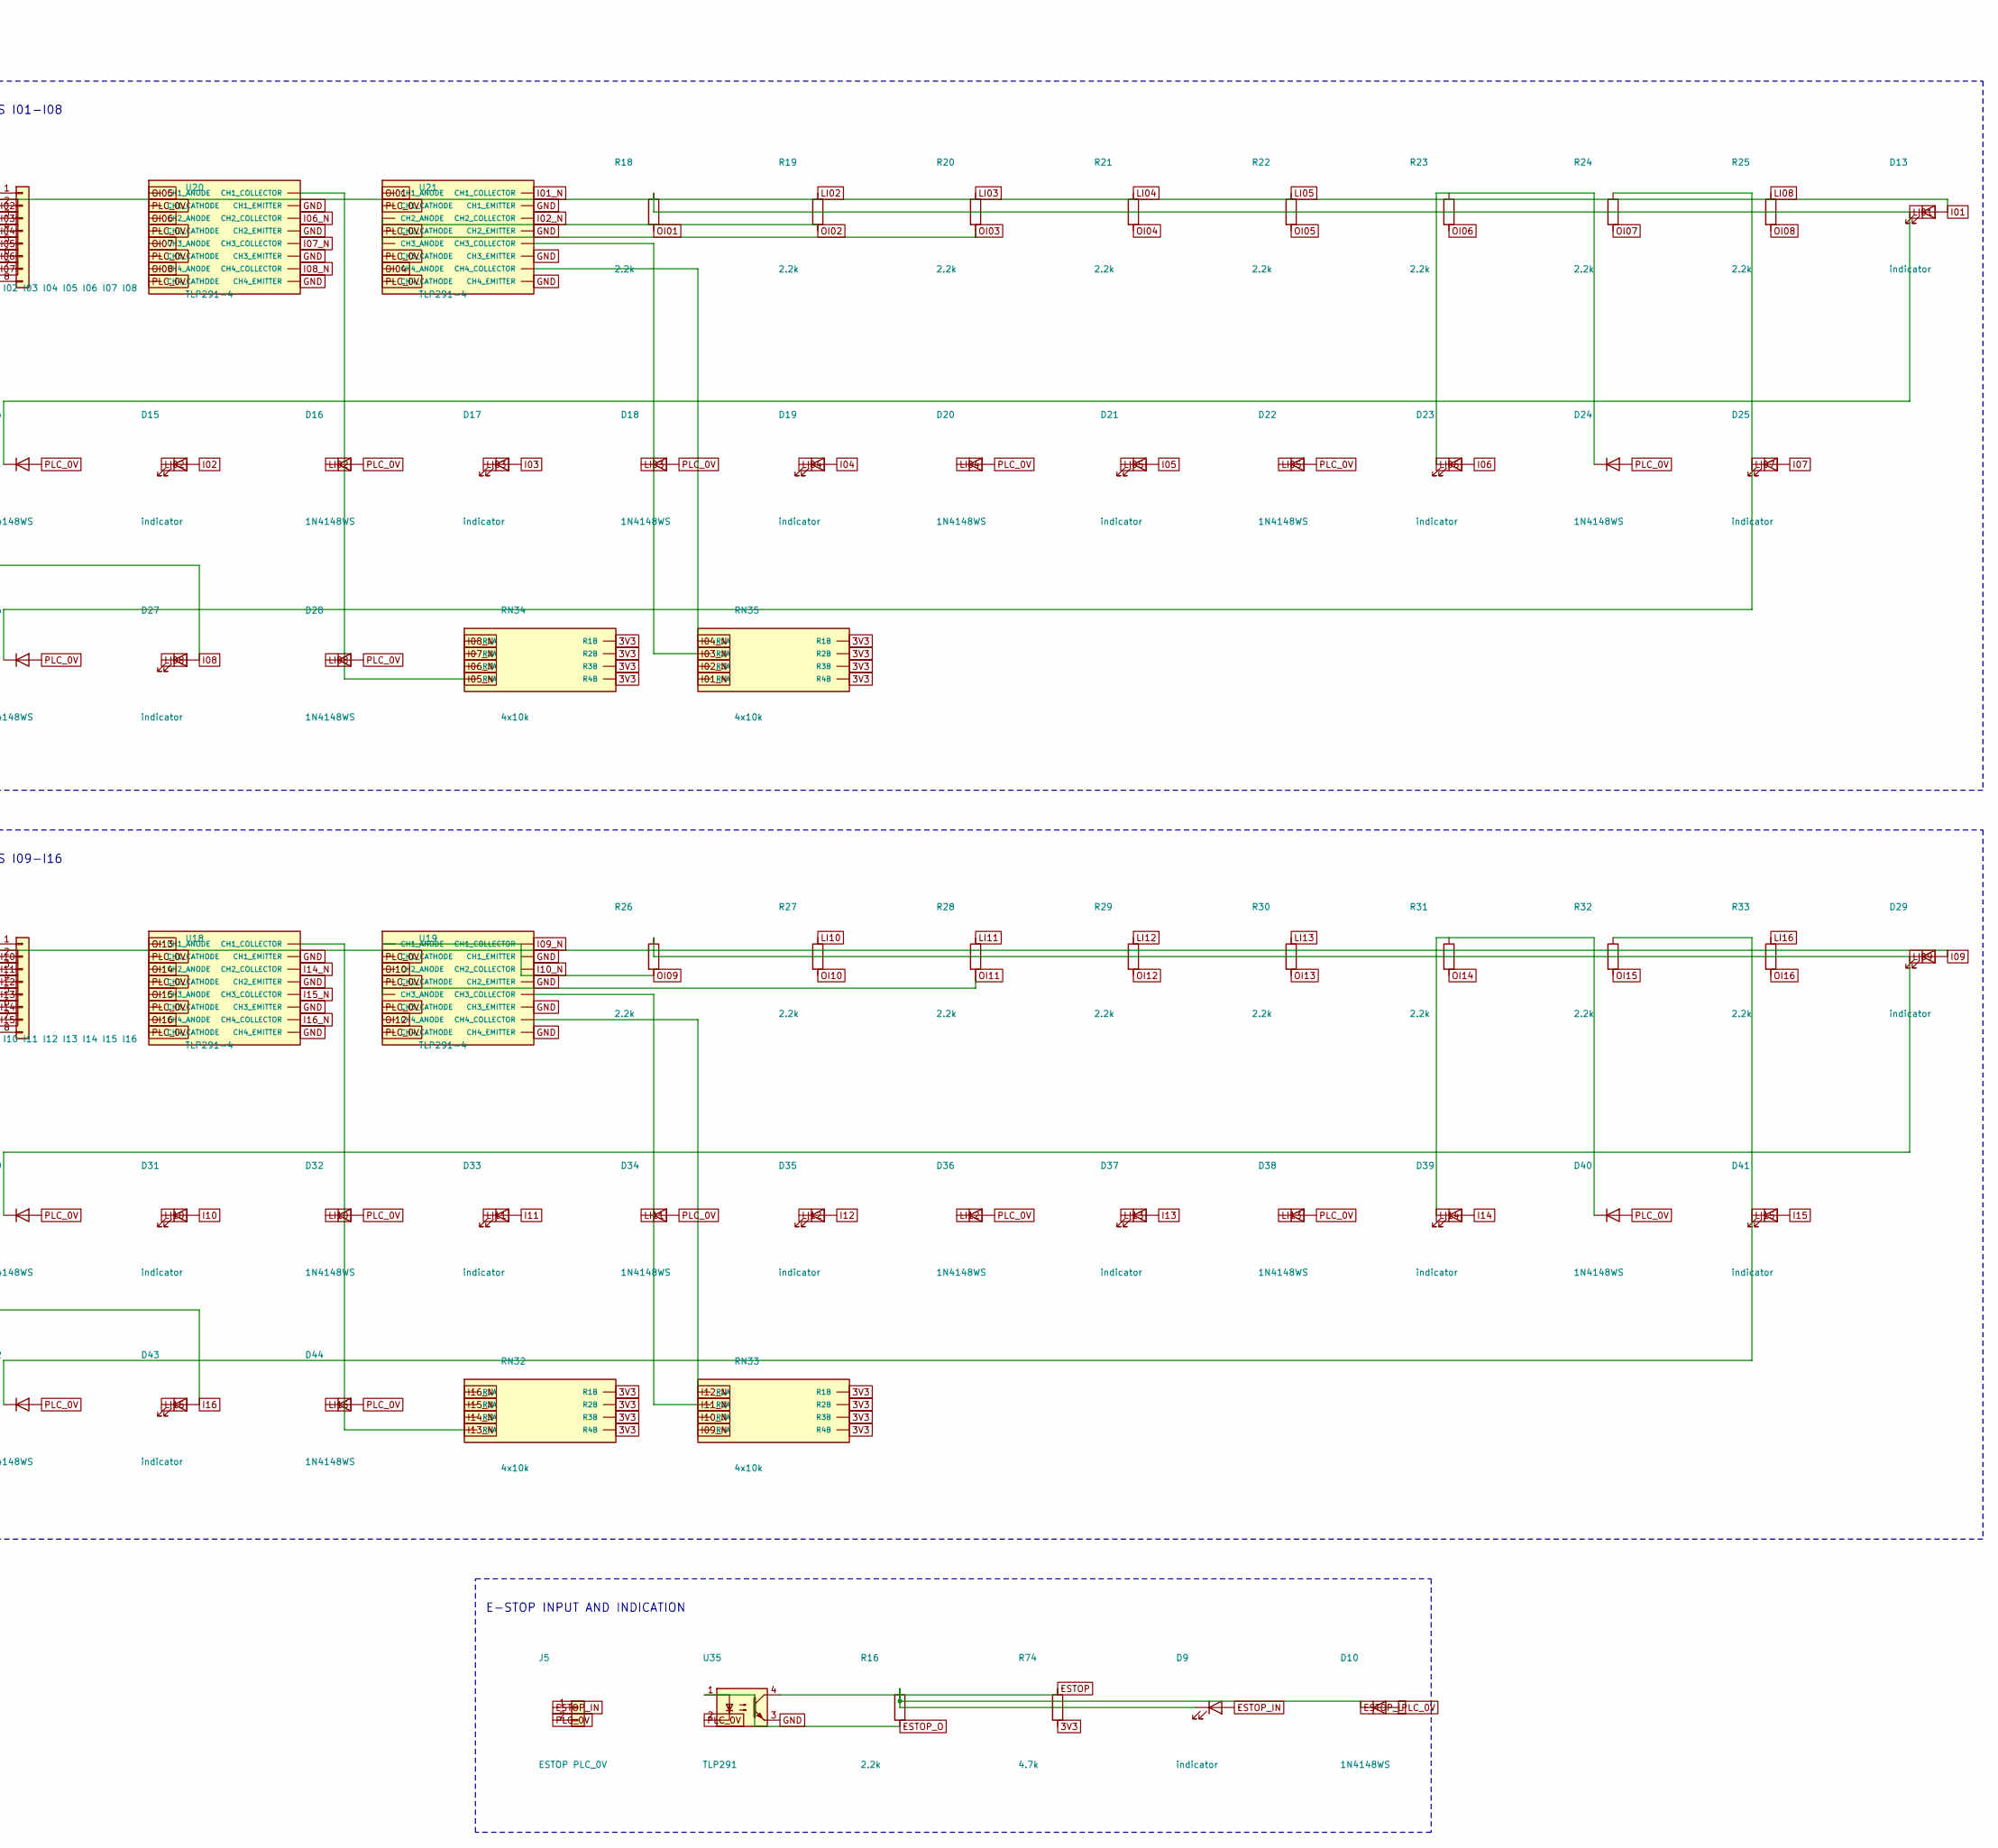
[picture p55: schematic field_inputs-python.kicad_sch, part in row 1, column 2]

Parts:
D9, D13, D15, D17, D19, D21, D23, D25, D27, D29, D31, D33, D35, D37, D39, D41, D43: indicator; LED_1206_3216Metric; MPN LTST-C150KGKT
D10, D14, D16, D18, D20, D22, D24, D26, D28, D30, D32, D34, D36, D38, D40, D42, D44: 1N4148WS; D_SOD-323; MPN 1N4148WS
J5: ESTOP PLC_0V; PhoenixContact_MCV_1,5_2-G-3.5_1x02_P3.50mm_Vertical; MPN Phoenix Contact MCV 1,5/2-G-3.5
J7: I01 I02 I03 I04 I05 I06 I07 I08; PhoenixContact_MCV_1,5_8-G-3.5_1x08_P3.50mm_Vertical; MPN Phoenix Contact MCV 1,5/8-G-3.5
J8: I09 I10 I11 I12 I13 I14 I15 I16; PhoenixContact_MCV_1,5_8-G-3.5_1x08_P3.50mm_Vertical; MPN Phoenix Contact MCV 1,5/8-G-3.5
R16, R18, R19, R20, R21, R22, R23, R24, R25, R26, R27, R28, R29, R30, R31, R32, R33: 2.2k; R_1206_3216Metric; MPN RC1206FR-07 1% 2.2k
R74: 4.7k; R_1206_3216Metric; MPN RC1206FR-07 4K7L
RN32, RN33, RN34, RN35: 4x10k; R_Array_Convex_4x0603; MPN YC164-FR-0710KL
U18, U19, U20, U21: TLP291-4; SOIC-16_4.55x10.3mm_P1.27mm; MPN TLP291-4
U35: TLP291; SOIC-4_4.55x2.6mm_P1.27mm; MPN TLP291

Connections:
3V3: R74.2, RN32.5 (R4B), RN32.6 (R3B), RN32.7 (R2B), RN32.8 (R1B), RN33.5 (R4B), RN33.6 (R3B), RN33.7 (R2B), RN33.8 (R1B), RN34.5 (R4B), RN34.6 (R3B), RN34.7 (R2B), RN34.8 (R1B), RN35.5 (R4B), RN35.6 (R3B), RN35.7 (R2B), RN35.8 (R1B)
ESTOP: R74.1, U35.4
ESTOP_IN: D9.2 (A), J5.1
ESTOP_L: D9.1 (K), D10.1 (K), R16.1
ESTOP_O: R16.2, U35.1
GND: U18.9 (CH4_EMITTER), U18.11 (CH3_EMITTER), U18.13 (CH2_EMITTER), U18.15 (CH1_EMITTER), U19.9 (CH4_EMITTER), U19.11 (CH3_EMITTER), U19.13 (CH2_EMITTER), U19.15 (CH1_EMITTER), U20.9 (CH4_EMITTER), U20.11 (CH3_EMITTER), U20.13 (CH2_EMITTER), U20.15 (CH1_EMITTER), U21.9 (CH4_EMITTER), U21.11 (CH3_EMITTER), U21.13 (CH2_EMITTER), U21.15 (CH1_EMITTER), U35.3
I01: D13.2 (A), J7.1
I01_N: RN35.4 (R4A), U21.16 (CH1_COLLECTOR)
I02: D15.2 (A), J7.2
I02_N: RN35.3 (R3A), U21.14 (CH2_COLLECTOR)
I03: D17.2 (A), J7.3
I03_N: RN35.2 (R2A), U21.12 (CH3_COLLECTOR)
I04: D19.2 (A), J7.4
I04_N: RN35.1 (R1A), U21.10 (CH4_COLLECTOR)
I05: D21.2 (A), J7.5
I05_N: RN34.4 (R4A), U20.16 (CH1_COLLECTOR)
I06: D23.2 (A), J7.6
I06_N: RN34.3 (R3A), U20.14 (CH2_COLLECTOR)
I07: D25.2 (A), J7.7
I07_N: RN34.2 (R2A), U20.12 (CH3_COLLECTOR)
I08: D27.2 (A), J7.8
I08_N: RN34.1 (R1A), U20.10 (CH4_COLLECTOR)
I09: D29.2 (A), J8.1
I09_N: RN33.4 (R4A), U19.16 (CH1_COLLECTOR)
I10: D31.2 (A), J8.2
I10_N: RN33.3 (R3A), U19.14 (CH2_COLLECTOR)
I11: D33.2 (A), J8.3
I11_N: RN33.2 (R2A), U19.12 (CH3_COLLECTOR)
I12: D35.2 (A), J8.4
I12_N: RN33.1 (R1A), U19.10 (CH4_COLLECTOR)
I13: D37.2 (A), J8.5
I13_N: RN32.4 (R4A), U18.16 (CH1_COLLECTOR)
I14: D39.2 (A), J8.6
I14_N: RN32.3 (R3A), U18.14 (CH2_COLLECTOR)
I15: D41.2 (A), J8.7
I15_N: RN32.2 (R2A), U18.12 (CH3_COLLECTOR)
I16: D43.2 (A), J8.8
I16_N: RN32.1 (R1A), U18.10 (CH4_COLLECTOR)
LI01: D13.1 (K), D14.1 (K), R18.1
LI02: D15.1 (K), D16.1 (K), R19.1
LI03: D17.1 (K), D18.1 (K), R20.1
LI04: D19.1 (K), D20.1 (K), R21.1
LI05: D21.1 (K), D22.1 (K), R22.1
LI06: D23.1 (K), D24.1 (K), R23.1
LI07: D25.1 (K), D26.1 (K), R24.1
LI08: D27.1 (K), D28.1 (K), R25.1
LI09: D29.1 (K), D30.1 (K), R26.1
LI10: D31.1 (K), D32.1 (K), R27.1
LI11: D33.1 (K), D34.1 (K), R28.1
LI12: D35.1 (K), D36.1 (K), R29.1
LI13: D37.1 (K), D38.1 (K), R30.1
LI14: D39.1 (K), D40.1 (K), R31.1
LI15: D41.1 (K), D42.1 (K), R32.1
LI16: D43.1 (K), D44.1 (K), R33.1
OI01: R18.2, U21.1 (CH1_ANODE)
OI02: R19.2, U21.3 (CH2_ANODE)
OI03: R20.2, U21.5 (CH3_ANODE)
OI04: R21.2, U21.7 (CH4_ANODE)
OI05: R22.2, U20.1 (CH1_ANODE)
OI06: R23.2, U20.3 (CH2_ANODE)
OI07: R24.2, U20.5 (CH3_ANODE)
OI08: R25.2, U20.7 (CH4_ANODE)
OI09: R26.2, U19.1 (CH1_ANODE)
OI10: R27.2, U19.3 (CH2_ANODE)
OI11: R28.2, U19.5 (CH3_ANODE)
OI12: R29.2, U19.7 (CH4_ANODE)
OI13: R30.2, U18.1 (CH1_ANODE)
OI14: R31.2, U18.3 (CH2_ANODE)
OI15: R32.2, U18.5 (CH3_ANODE)
OI16: R33.2, U18.7 (CH4_ANODE)
PLC_0V: D10.2 (A), D14.2 (A), D16.2 (A), D18.2 (A), D20.2 (A), D22.2 (A), D24.2 (A), D26.2 (A), D28.2 (A), D30.2 (A), D32.2 (A), D34.2 (A), D36.2 (A), D38.2 (A), D40.2 (A), D42.2 (A), D44.2 (A), J5.2, U18.2 (CH1_CATHODE), U18.4 (CH2_CATHODE), U18.6 (CH3_CATHODE), U18.8 (CH4_CATHODE), U19.2 (CH1_CATHODE), U19.4 (CH2_CATHODE), U19.6 (CH3_CATHODE), U19.8 (CH4_CATHODE), U20.2 (CH1_CATHODE), U20.4 (CH2_CATHODE), U20.6 (CH3_CATHODE), U20.8 (CH4_CATHODE), U21.2 (CH1_CATHODE), U21.4 (CH2_CATHODE), U21.6 (CH3_CATHODE), U21.8 (CH4_CATHODE), U35.2

Notes on the sheet:
Isolated PLC inputs and E-stop | 64 components | 71 local nets
PLC INPUTS I01-I08
PLC INPUTS I09-I16
E-STOP INPUT AND INDICATION
