staskaaa-netizen/uCNC_Pi_Board/experiments/power-schematic-readability/other-sheets/field_outputs-python.kicad_sch

## KiCad design experiments/power-schematic-readability/other-sheets/field_outputs-python.kicad_sch (2026-11-03)

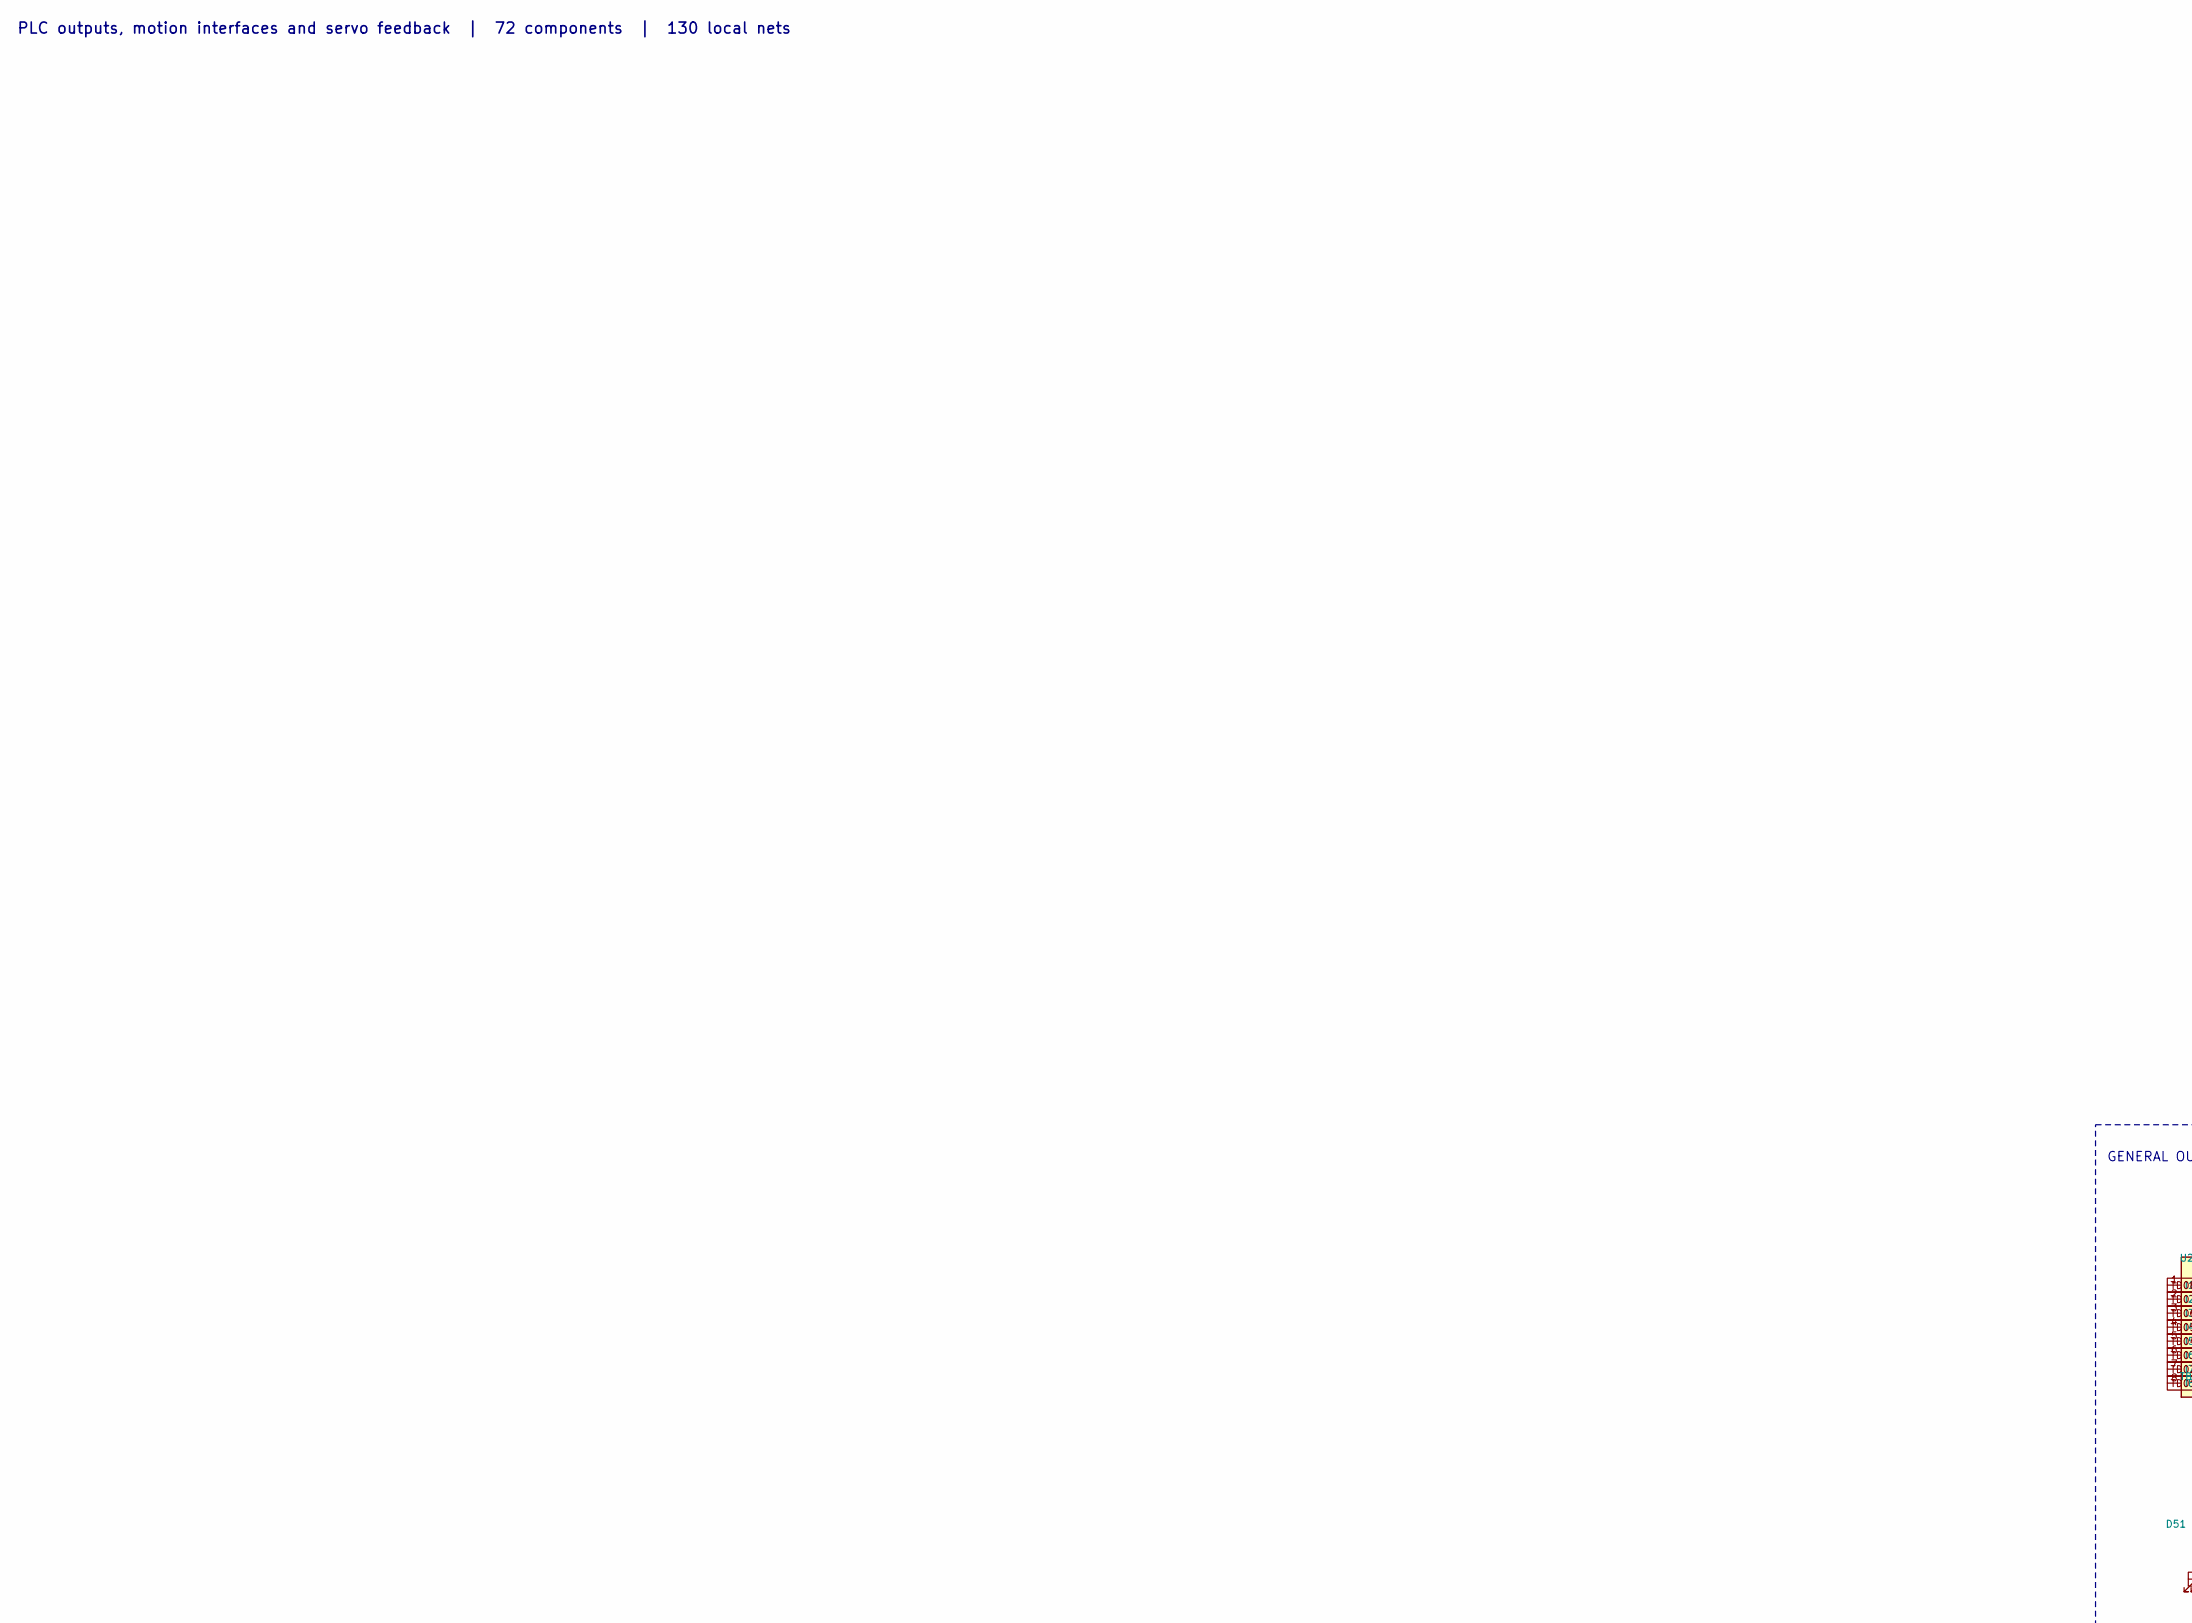
[picture p56: schematic field_outputs-python.kicad_sch, part in row 1, column 1]

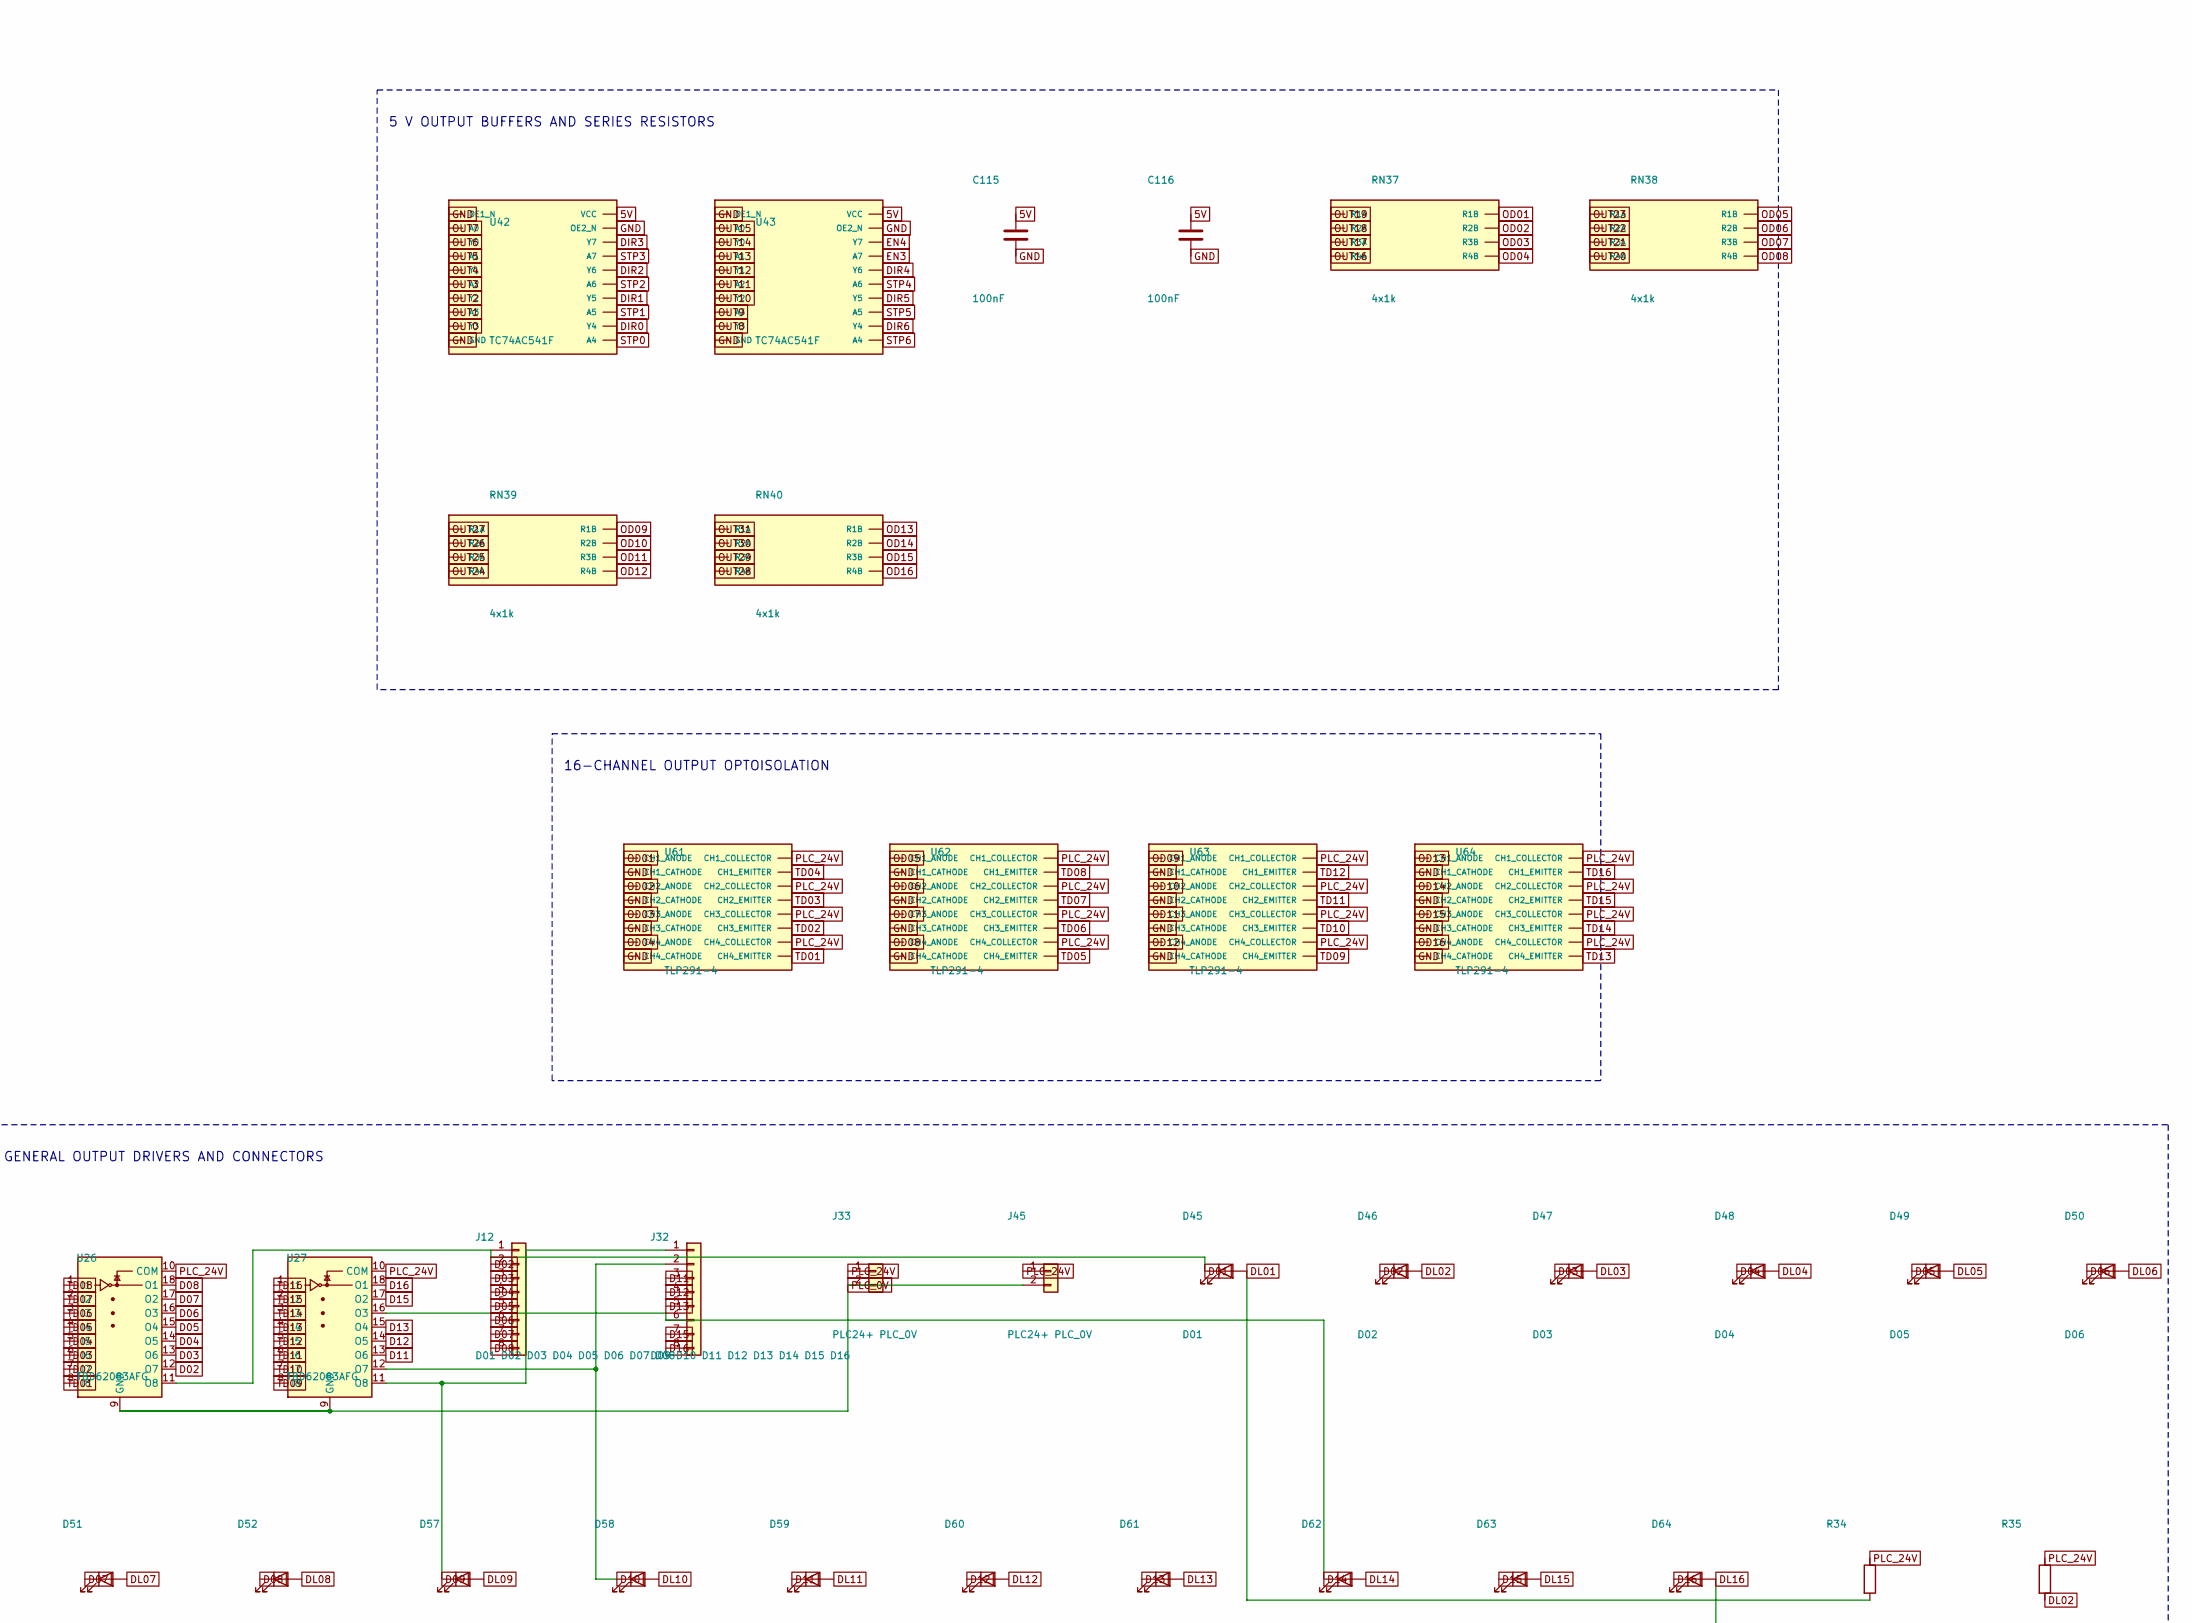
[picture p57: schematic field_outputs-python.kicad_sch, part in row 1, column 2]

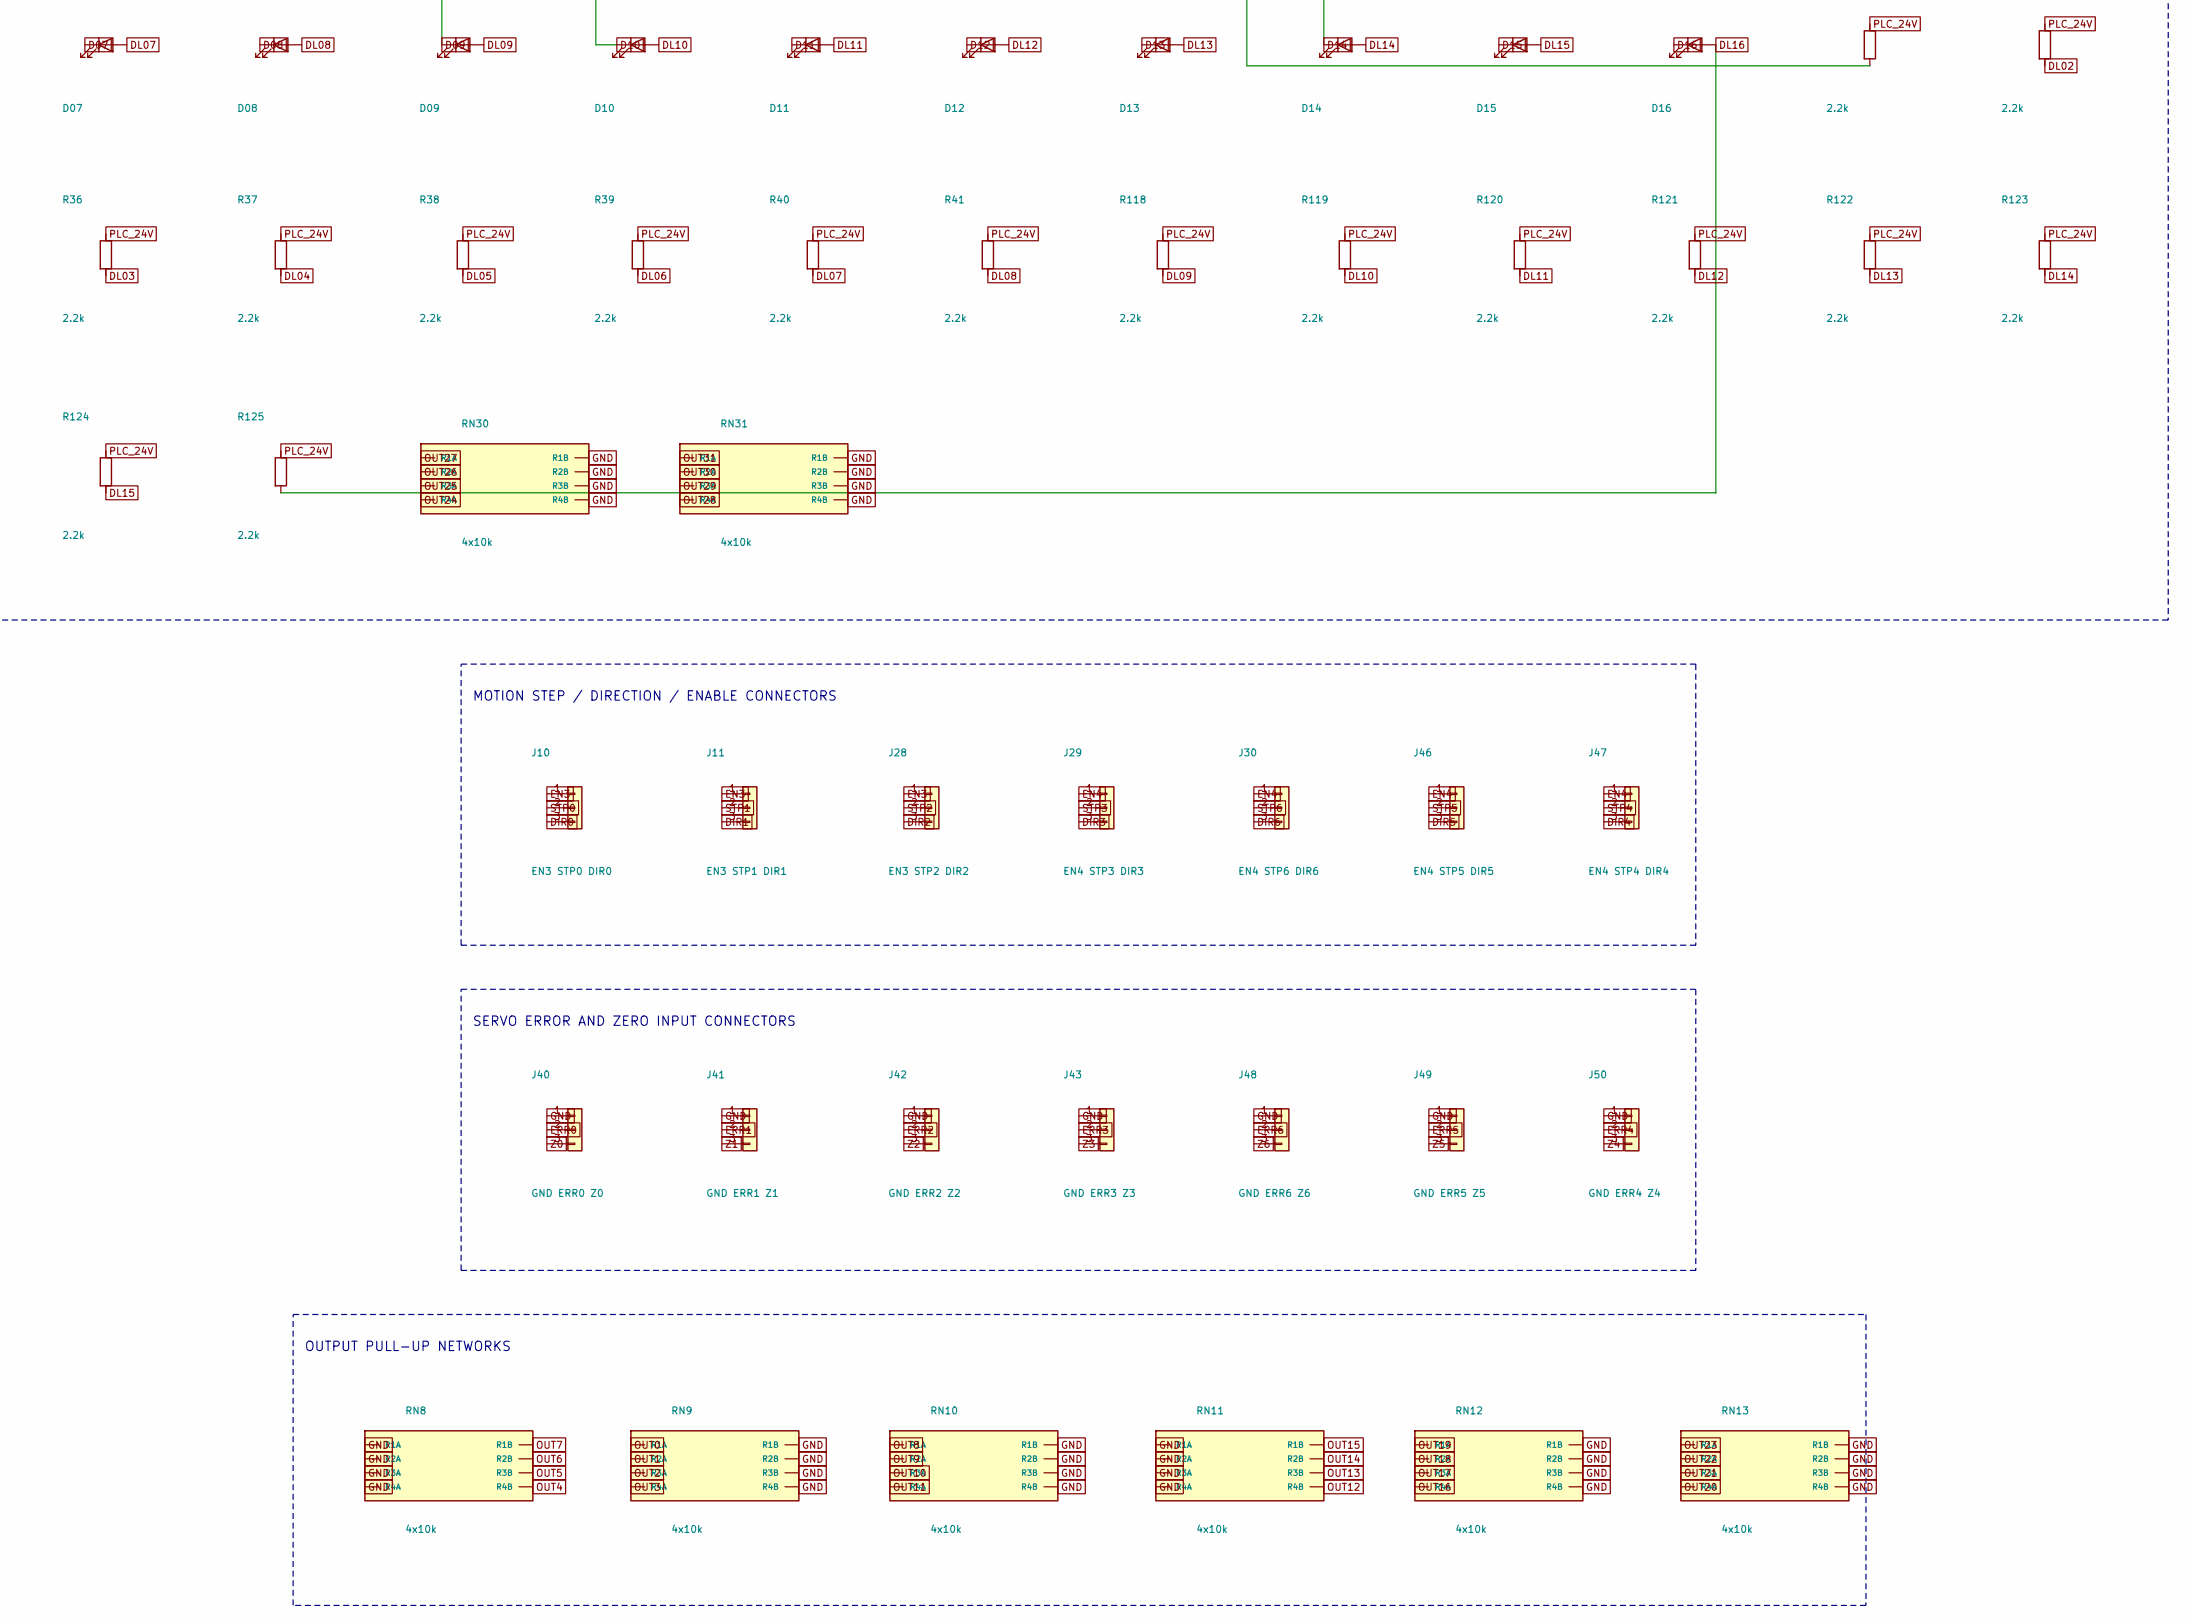
[picture p58: schematic field_outputs-python.kicad_sch, part in row 2, column 2]

Parts:
C115, C116: 100nF; C_0805_2012Metric; MPN CL21 series 0805 X7R 100nF
D45: D01; LED_1206_3216Metric; MPN LTST-C150KGKT
D46: D02; LED_1206_3216Metric; MPN LTST-C150KGKT
D47: D03; LED_1206_3216Metric; MPN LTST-C150KGKT
D48: D04; LED_1206_3216Metric; MPN LTST-C150KGKT
D49: D05; LED_1206_3216Metric; MPN LTST-C150KGKT
D50: D06; LED_1206_3216Metric; MPN LTST-C150KGKT
D51: D07; LED_1206_3216Metric; MPN LTST-C150KGKT
D52: D08; LED_1206_3216Metric; MPN LTST-C150KGKT
D57: D09; LED_1206_3216Metric; MPN LTST-C150KGKT
D58: D10; LED_1206_3216Metric; MPN LTST-C150KGKT
D59: D11; LED_1206_3216Metric; MPN LTST-C150KGKT
D60: D12; LED_1206_3216Metric; MPN LTST-C150KGKT
D61: D13; LED_1206_3216Metric; MPN LTST-C150KGKT
D62: D14; LED_1206_3216Metric; MPN LTST-C150KGKT
D63: D15; LED_1206_3216Metric; MPN LTST-C150KGKT
D64: D16; LED_1206_3216Metric; MPN LTST-C150KGKT
J10: EN3 STP0 DIR0; PhoenixContact_MCV_1,5_3-G-3.5_1x03_P3.50mm_Vertical; MPN Phoenix Contact MCV 1,5/3-G-3.5
J11: EN3 STP1 DIR1; PhoenixContact_MCV_1,5_3-G-3.5_1x03_P3.50mm_Vertical; MPN Phoenix Contact MCV 1,5/3-G-3.5
J12: D01 D02 D03 D04 D05 D06 D07 D08; PhoenixContact_MCV_1,5_8-G-3.5_1x08_P3.50mm_Vertical; MPN Phoenix Contact MCV 1,5/8-G-3.5
J28: EN3 STP2 DIR2; PhoenixContact_MCV_1,5_3-G-3.5_1x03_P3.50mm_Vertical; MPN Phoenix Contact MCV 1,5/3-G-3.5
J29: EN4 STP3 DIR3; PhoenixContact_MCV_1,5_3-G-3.5_1x03_P3.50mm_Vertical; MPN Phoenix Contact MCV 1,5/3-G-3.5
J30: EN4 STP6 DIR6; PhoenixContact_MCV_1,5_3-G-3.5_1x03_P3.50mm_Vertical; MPN Phoenix Contact MCV 1,5/3-G-3.5
J32: D09 D10 D11 D12 D13 D14 D15 D16; PhoenixContact_MCV_1,5_8-G-3.5_1x08_P3.50mm_Vertical; MPN Phoenix Contact MCV 1,5/8-G-3.5
J33, J45: PLC24+ PLC_0V; PhoenixContact_MCV_1,5_2-G-3.5_1x02_P3.50mm_Vertical; MPN Phoenix Contact MCV 1,5/2-G-3.5
J40: GND ERR0 Z0; PhoenixContact_MCV_1,5_3-G-3.5_1x03_P3.50mm_Vertical; MPN Phoenix Contact MCV 1,5/3-G-3.5
J41: GND ERR1 Z1; PhoenixContact_MCV_1,5_3-G-3.5_1x03_P3.50mm_Vertical; MPN Phoenix Contact MCV 1,5/3-G-3.5
J42: GND ERR2 Z2; PhoenixContact_MCV_1,5_3-G-3.5_1x03_P3.50mm_Vertical; MPN Phoenix Contact MCV 1,5/3-G-3.5
J43: GND ERR3 Z3; PhoenixContact_MCV_1,5_3-G-3.5_1x03_P3.50mm_Vertical; MPN Phoenix Contact MCV 1,5/3-G-3.5
J46: EN4 STP5 DIR5; PhoenixContact_MCV_1,5_3-G-3.5_1x03_P3.50mm_Vertical; MPN Phoenix Contact MCV 1,5/3-G-3.5
J47: EN4 STP4 DIR4; PhoenixContact_MCV_1,5_3-G-3.5_1x03_P3.50mm_Vertical; MPN Phoenix Contact MCV 1,5/3-G-3.5
J48: GND ERR6 Z6; PhoenixContact_MCV_1,5_3-G-3.5_1x03_P3.50mm_Vertical; MPN Phoenix Contact MCV 1,5/3-G-3.5
J49: GND ERR5 Z5; PhoenixContact_MCV_1,5_3-G-3.5_1x03_P3.50mm_Vertical; MPN Phoenix Contact MCV 1,5/3-G-3.5
J50: GND ERR4 Z4; PhoenixContact_MCV_1,5_3-G-3.5_1x03_P3.50mm_Vertical; MPN Phoenix Contact MCV 1,5/3-G-3.5
R34, R35, R36, R37, R38, R39, R40, R41, R118, R119, R120, R121, R122, R123, R124, R125: 2.2k; R_1206_3216Metric; MPN RC1206FR-07 1% 2.2k
RN8, RN9, RN10, RN11, RN12, RN13, RN30, RN31: 4x10k; R_Array_Convex_4x0603; MPN YC164-FR-0710KL
RN37, RN38, RN39, RN40: 4x1k; R_Array_Convex_4x1206; MPN YC324-FR-07 series 1%
U26, U27: TBD62083AFG; SOP-18_7.495x11.515mm_P1.27mm; MPN TBD62083AFG
U42, U43: TC74AC541F; SOIC-20W_7.5x12.8mm_P1.27mm; MPN TC74AC541F
U61, U62, U63, U64: TLP291-4; SOIC-16_4.55x10.3mm_P1.27mm; MPN TLP291-4

Connections:
5V: C115.1, C116.1, U42.20 (VCC), U43.20 (VCC)
D01: D45.1 (K), J12.1, U26.11 (O8)
D02: D46.1 (K), J12.2, U26.12 (O7)
D03: D47.1 (K), J12.3, U26.13 (O6)
D04: D48.1 (K), J12.4, U26.14 (O5)
D05: D49.1 (K), J12.5, U26.15 (O4)
D06: D50.1 (K), J12.6, U26.16 (O3)
D07: D51.1 (K), J12.7, U26.17 (O2)
D08: D52.1 (K), J12.8, U26.18 (O1)
D09: D57.1 (K), J32.1, U27.11 (O8)
D10: D58.1 (K), J32.2, U27.12 (O7)
D11: D59.1 (K), J32.3, U27.13 (O6)
D12: D60.1 (K), J32.4, U27.14 (O5)
D13: D61.1 (K), J32.5, U27.15 (O4)
D14: D62.1 (K), J32.6, U27.16 (O3)
D15: D63.1 (K), J32.7, U27.17 (O2)
D16: D64.1 (K), J32.8, U27.18 (O1)
DIR0: J10.3, U42.12 (Y4)
DIR1: J11.3, U42.14 (Y5)
DIR2: J28.3, U42.16 (Y6)
DIR3: J29.3, U42.18 (Y7)
DIR4: J47.3, U43.16 (Y6)
DIR5: J46.3, U43.14 (Y5)
DIR6: J30.3, U43.12 (Y4)
DL01: D45.2 (A), R34.2
DL02: D46.2 (A), R35.2
DL03: D47.2 (A), R36.2
DL04: D48.2 (A), R37.2
DL05: D49.2 (A), R38.2
DL06: D50.2 (A), R39.2
DL07: D51.2 (A), R40.2
DL08: D52.2 (A), R41.2
DL09: D57.2 (A), R118.2
DL10: D58.2 (A), R119.2
DL11: D59.2 (A), R120.2
DL12: D60.2 (A), R121.2
DL13: D61.2 (A), R122.2
DL14: D62.2 (A), R123.2
DL15: D63.2 (A), R124.2
DL16: D64.2 (A), R125.2
EN3: J10.1, J11.1, J28.1, U43.17 (A7)
EN4: J29.1, J30.1, J46.1, J47.1, U43.18 (Y7)
ERR0: J40.2
ERR1: J41.2
ERR2: J42.2
ERR3: J43.2
ERR4: J50.2
ERR5: J49.2
ERR6: J48.2
GND: C115.2, C116.2, J40.1, J41.1, J42.1, J43.1, J48.1, J49.1, J50.1, RN8.1 (R1A), RN8.2 (R2A), RN8.3 (R3A), RN8.4 (R4A), RN9.5 (R4B), RN9.6 (R3B), RN9.7 (R2B), RN9.8 (R1B), RN10.5 (R4B), RN10.6 (R3B), RN10.7 (R2B), RN10.8 (R1B), RN11.1 (R1A), RN11.2 (R2A), RN11.3 (R3A), RN11.4 (R4A), RN12.5 (R4B), RN12.6 (R3B), RN12.7 (R2B), RN12.8 (R1B), RN13.5 (R4B), RN13.6 (R3B), RN13.7 (R2B), RN13.8 (R1B), RN30.5 (R4B), RN30.6 (R3B), RN30.7 (R2B), RN30.8 (R1B), RN31.5 (R4B), RN31.6 (R3B), RN31.7 (R2B), RN31.8 (R1B), U42.1 (OE1_N), U42.10 (GND), U42.19 (OE2_N), U43.1 (OE1_N), U43.10 (GND), U43.19 (OE2_N), U61.2 (CH1_CATHODE), U61.4 (CH2_CATHODE), U61.6 (CH3_CATHODE), U61.8 (CH4_CATHODE), U62.2 (CH1_CATHODE), U62.4 (CH2_CATHODE), U62.6 (CH3_CATHODE), U62.8 (CH4_CATHODE), U63.2 (CH1_CATHODE), U63.4 (CH2_CATHODE), U63.6 (CH3_CATHODE), U63.8 (CH4_CATHODE), U64.2 (CH1_CATHODE), U64.4 (CH2_CATHODE), U64.6 (CH3_CATHODE), U64.8 (CH4_CATHODE)
OD01: RN37.8 (R1B), U61.1 (CH1_ANODE)
OD02: RN37.7 (R2B), U61.3 (CH2_ANODE)
OD03: RN37.6 (R3B), U61.5 (CH3_ANODE)
OD04: RN37.5 (R4B), U61.7 (CH4_ANODE)
OD05: RN38.8 (R1B), U62.1 (CH1_ANODE)
OD06: RN38.7 (R2B), U62.3 (CH2_ANODE)
OD07: RN38.6 (R3B), U62.5 (CH3_ANODE)
OD08: RN38.5 (R4B), U62.7 (CH4_ANODE)
OD09: RN39.8 (R1B), U63.1 (CH1_ANODE)
OD10: RN39.7 (R2B), U63.3 (CH2_ANODE)
OD11: RN39.6 (R3B), U63.5 (CH3_ANODE)
OD12: RN39.5 (R4B), U63.7 (CH4_ANODE)
OD13: RN40.8 (R1B), U64.1 (CH1_ANODE)
OD14: RN40.7 (R2B), U64.3 (CH2_ANODE)
OD15: RN40.6 (R3B), U64.5 (CH3_ANODE)
OD16: RN40.5 (R4B), U64.7 (CH4_ANODE)
OUT0: RN9.1 (R1A), U42.9 (Y3)
OUT1: RN9.2 (R2A), U42.8 (A3)
OUT2: RN9.3 (R3A), U42.7 (Y2)
OUT3: RN9.4 (R4A), U42.6 (A2)
OUT4: RN8.5 (R4B), U42.5 (Y1)
OUT5: RN8.6 (R3B), U42.4 (A1)
OUT6: RN8.7 (R2B), U42.3 (Y0)
OUT7: RN8.8 (R1B), U42.2 (A0)
OUT8: RN10.1 (R1A), U43.9 (Y3)
OUT9: RN10.2 (R2A), U43.8 (A3)
OUT10: RN10.3 (R3A), U43.7 (Y2)
OUT11: RN10.4 (R4A), U43.6 (A2)
OUT12: RN11.5 (R4B), U43.5 (Y1)
OUT13: RN11.6 (R3B), U43.4 (A1)
OUT14: RN11.7 (R2B), U43.3 (Y0)
OUT15: RN11.8 (R1B), U43.2 (A0)
OUT16: RN12.4 (R4A), RN37.4 (R4A)
OUT17: RN12.3 (R3A), RN37.3 (R3A)
OUT18: RN12.2 (R2A), RN37.2 (R2A)
OUT19: RN12.1 (R1A), RN37.1 (R1A)
OUT20: RN13.4 (R4A), RN38.4 (R4A)
OUT21: RN13.3 (R3A), RN38.3 (R3A)
OUT22: RN13.2 (R2A), RN38.2 (R2A)
OUT23: RN13.1 (R1A), RN38.1 (R1A)
OUT24: RN30.4 (R4A), RN39.4 (R4A)
OUT25: RN30.3 (R3A), RN39.3 (R3A)
OUT26: RN30.2 (R2A), RN39.2 (R2A)
OUT27: RN30.1 (R1A), RN39.1 (R1A)
OUT28: RN31.4 (R4A), RN40.4 (R4A)
OUT29: RN31.3 (R3A), RN40.3 (R3A)
OUT30: RN31.2 (R2A), RN40.2 (R2A)
OUT31: RN31.1 (R1A), RN40.1 (R1A)
PLC_0V: J33.2, J45.2, U26.9 (GND), U27.9 (GND)
PLC_24V: J33.1, J45.1, R34.1, R35.1, R36.1, R37.1, R38.1, R39.1, R40.1, R41.1, R118.1, R119.1, R120.1, R121.1, R122.1, R123.1, R124.1, R125.1, U26.10 (COM), U27.10 (COM), U61.10 (CH4_COLLECTOR), U61.12 (CH3_COLLECTOR), U61.14 (CH2_COLLECTOR), U61.16 (CH1_COLLECTOR), U62.10 (CH4_COLLECTOR), U62.12 (CH3_COLLECTOR), U62.14 (CH2_COLLECTOR), U62.16 (CH1_COLLECTOR), U63.10 (CH4_COLLECTOR), U63.12 (CH3_COLLECTOR), U63.14 (CH2_COLLECTOR), U63.16 (CH1_COLLECTOR), U64.10 (CH4_COLLECTOR), U64.12 (CH3_COLLECTOR), U64.14 (CH2_COLLECTOR), U64.16 (CH1_COLLECTOR)
STP0: J10.2, U42.11 (A4)
STP1: J11.2, U42.13 (A5)
STP2: J28.2, U42.15 (A6)
STP3: J29.2, U42.17 (A7)
STP4: J47.2, U43.15 (A6)
STP5: J46.2, U43.13 (A5)
STP6: J30.2, U43.11 (A4)
TD01: U26.8 (I8), U61.9 (CH4_EMITTER)
TD02: U26.7 (I7), U61.11 (CH3_EMITTER)
TD03: U26.6 (I6), U61.13 (CH2_EMITTER)
TD04: U26.5 (I5), U61.15 (CH1_EMITTER)
TD05: U26.4 (I4), U62.9 (CH4_EMITTER)
TD06: U26.3 (I3), U62.11 (CH3_EMITTER)
TD07: U26.2 (I2), U62.13 (CH2_EMITTER)
TD08: U26.1 (I1), U62.15 (CH1_EMITTER)
TD09: U27.8 (I8), U63.9 (CH4_EMITTER)
TD10: U27.7 (I7), U63.11 (CH3_EMITTER)
TD11: U27.6 (I6), U63.13 (CH2_EMITTER)
TD12: U27.5 (I5), U63.15 (CH1_EMITTER)
TD13: U27.4 (I4), U64.9 (CH4_EMITTER)
TD14: U27.3 (I3), U64.11 (CH3_EMITTER)
TD15: U27.2 (I2), U64.13 (CH2_EMITTER)
TD16: U27.1 (I1), U64.15 (CH1_EMITTER)
Z0: J40.3
Z1: J41.3
Z2: J42.3
Z3: J43.3
Z4: J50.3
Z5: J49.3
Z6: J48.3

Notes on the sheet:
PLC outputs, motion interfaces and servo feedback | 72 components | 130 local nets
5 V OUTPUT BUFFERS AND SERIES RESISTORS
16-CHANNEL OUTPUT OPTOISOLATION
GENERAL OUTPUT DRIVERS AND CONNECTORS
MOTION STEP / DIRECTION / ENABLE CONNECTORS
SERVO ERROR AND ZERO INPUT CONNECTORS
OUTPUT PULL-UP NETWORKS
