staskaaa-netizen/uCNC_Pi_Board/experiments/power-schematic-readability/other-sheets/mcu_io-python.kicad_sch

## KiCad design experiments/power-schematic-readability/other-sheets/mcu_io-python.kicad_sch (2026-11-03)

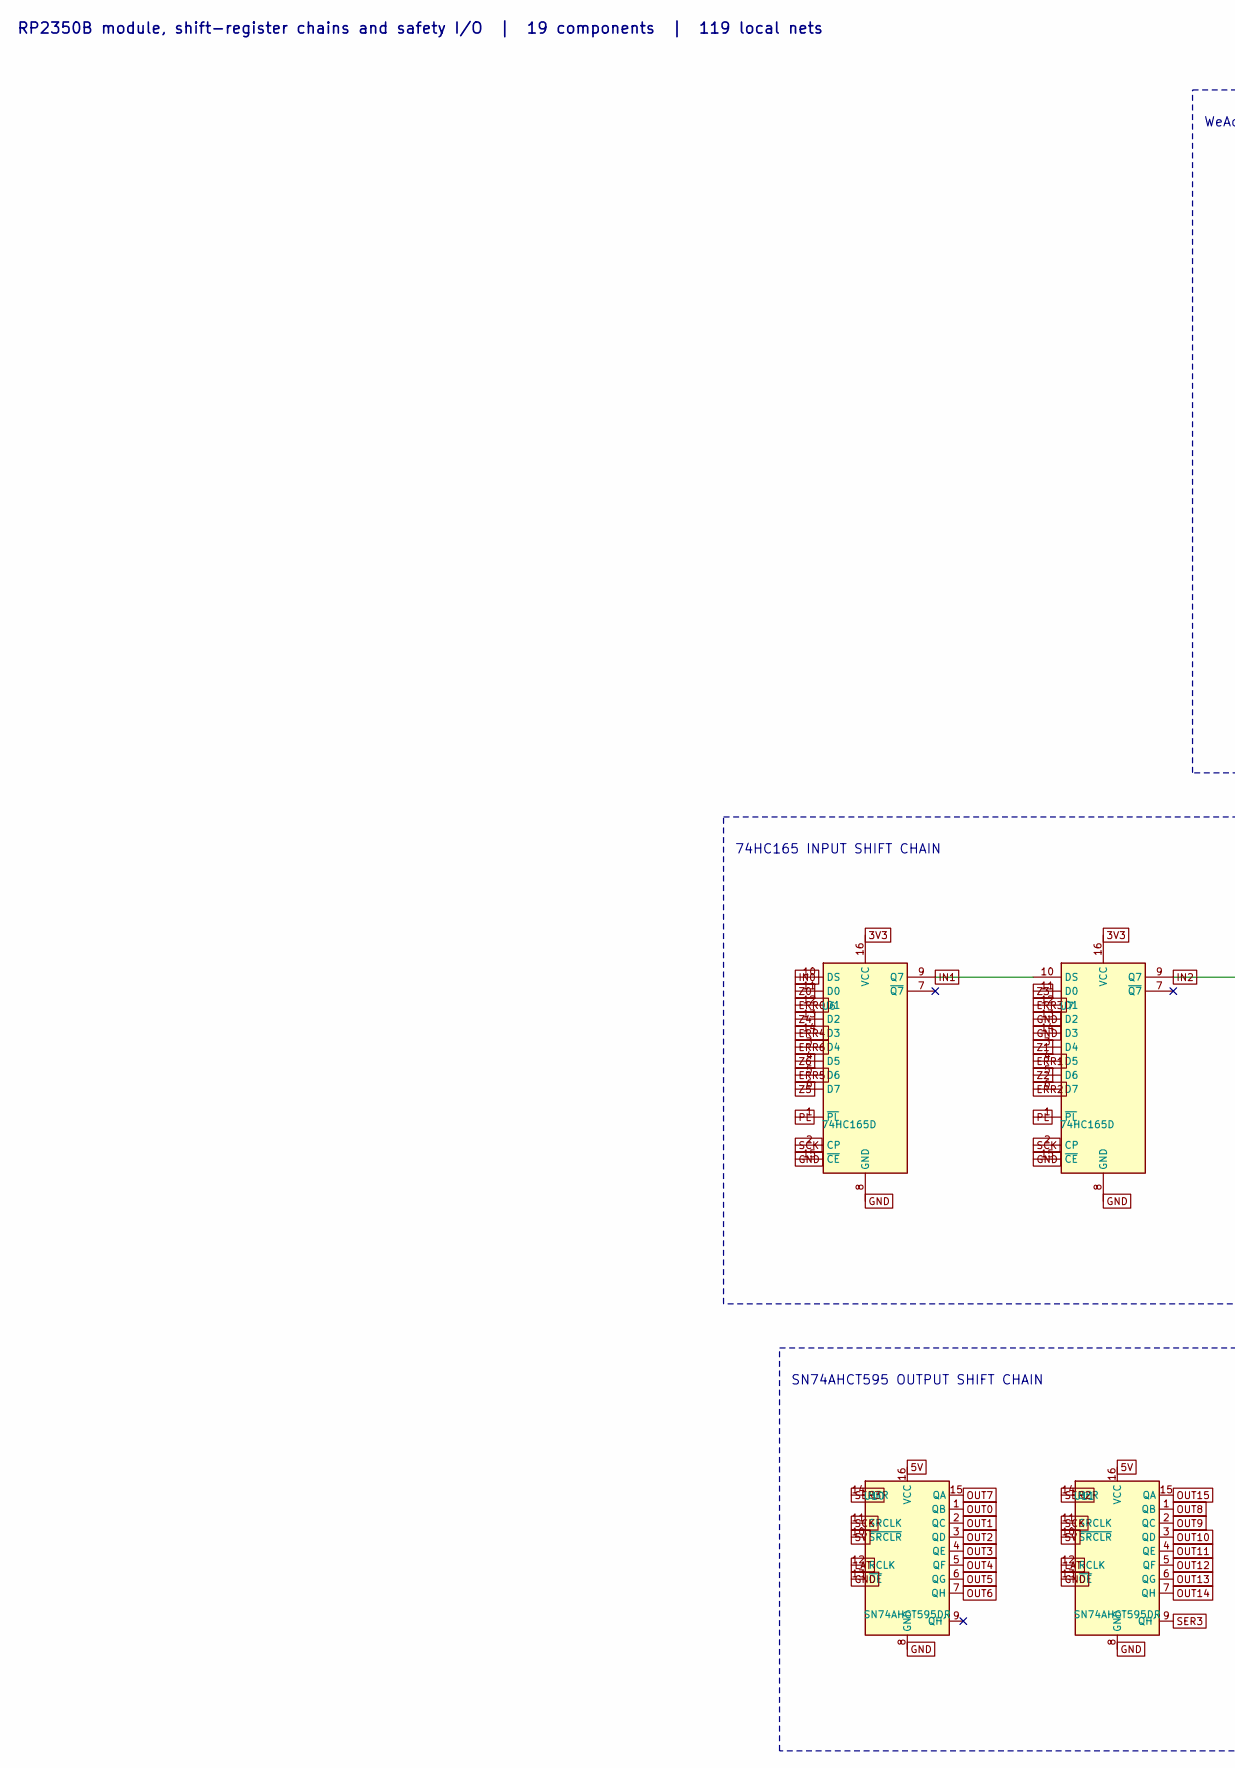
[picture p59: schematic mcu_io-python.kicad_sch, part in row 1, column 1]

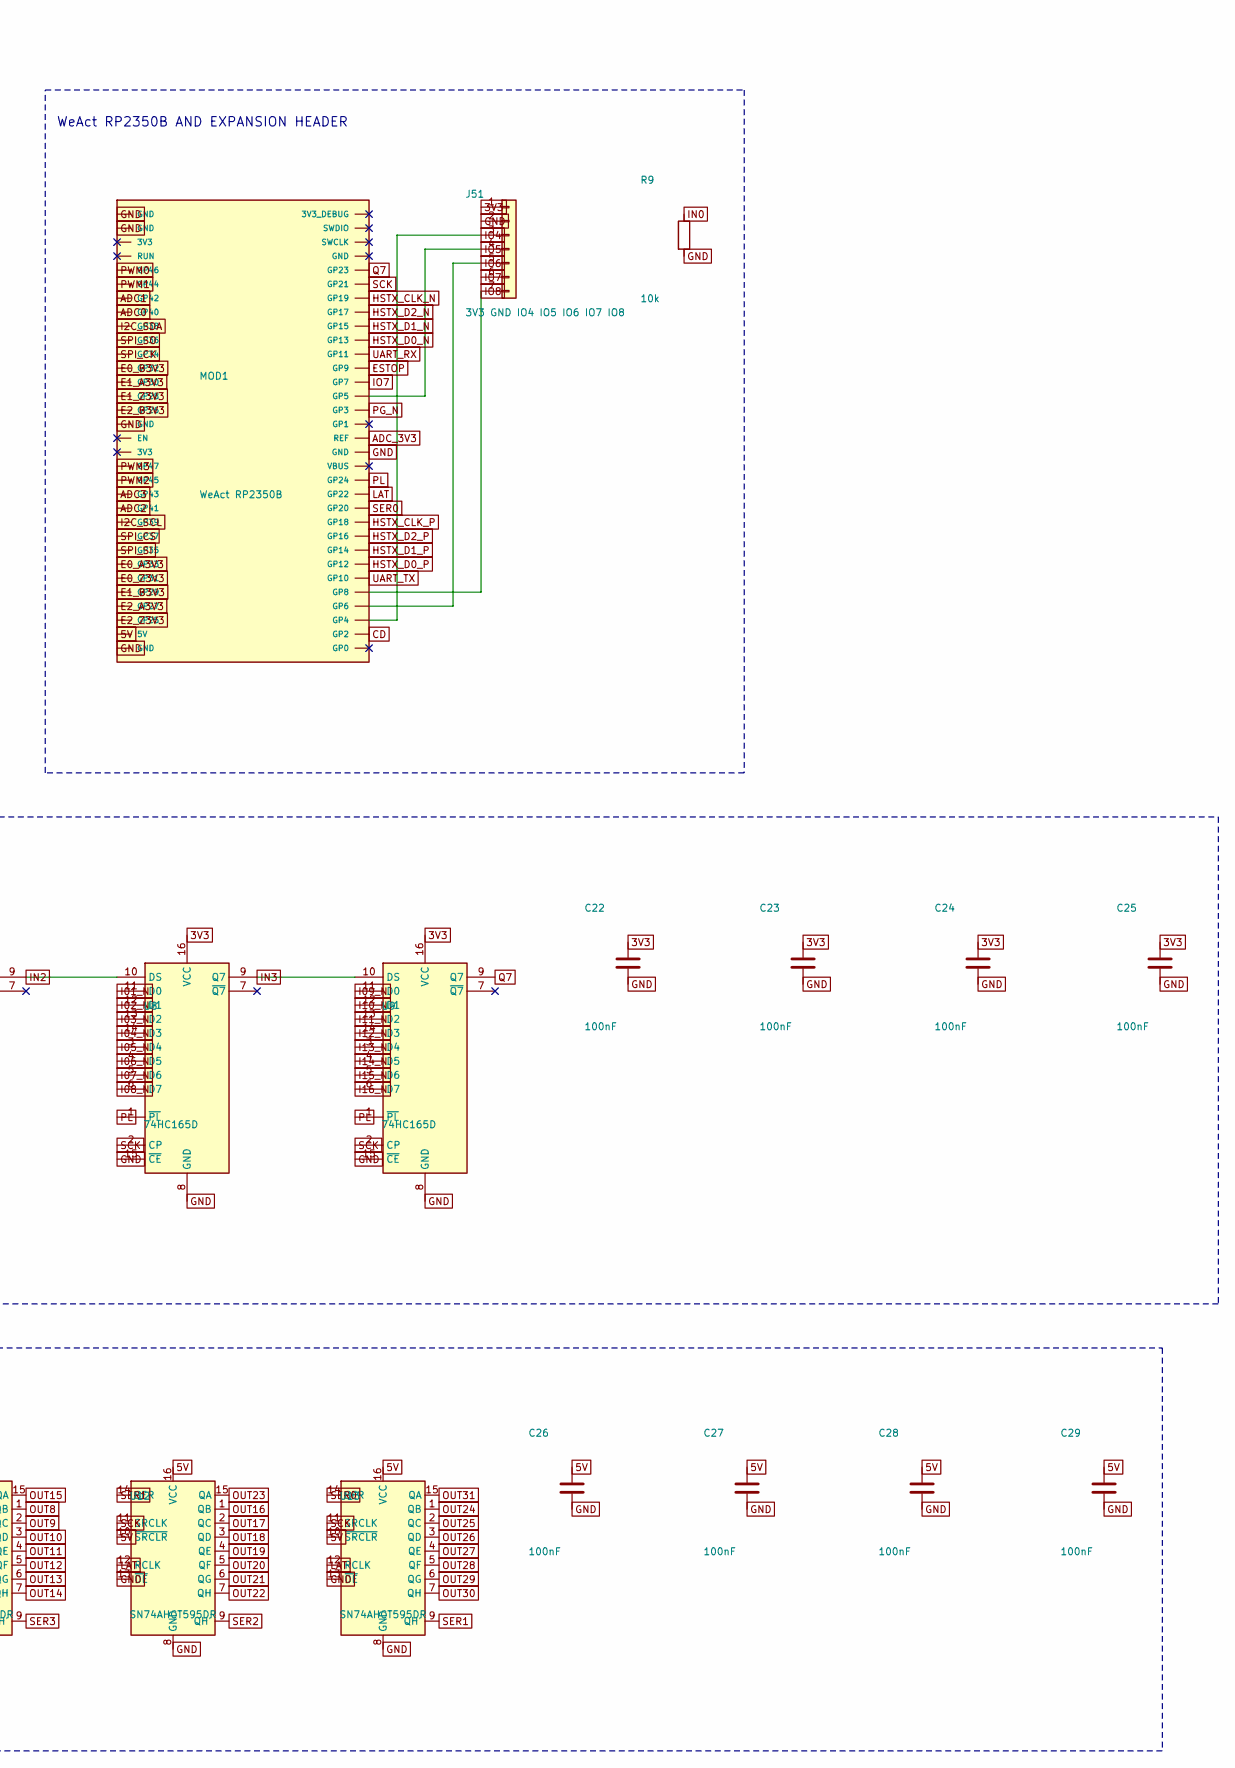
[picture p60: schematic mcu_io-python.kicad_sch, part in row 1, column 2]

Parts:
C22, C23, C24, C25, C26, C27, C28, C29: 100nF; C_0805_2012Metric; MPN CL21 series 0805 X7R 100nF
J51: 3V3 GND IO4 IO5 IO6 IO7 IO8; PinSocket_1x07_P2.54mm_Vertical; MPN 3V3 GND IO4 IO5 IO6 IO7 IO8
MOD1: WeAct RP2350B; WeAct_RP2350B_Socket; MPN WeAct Studio RP2350B Core Board
R9: 10k; R_1206_3216Metric; MPN RC1206FR-07 1% 10k
U6, U7, U8, U9: 74HC165D; SOIC-16_3.9x9.9mm_P1.27mm; MPN 74HC165D,653
U10, U11, U12, U13: SN74AHCT595DR; SOIC-16_3.9x9.9mm_P1.27mm; MPN SN74AHCT595DR

Connections:
3V3: C22.1, C23.1, C24.1, C25.1, J51.1, U6.16 (VCC), U7.16 (VCC), U8.16 (VCC), U9.16 (VCC)
5V: C26.1, C27.1, C28.1, C29.1, MOD1.31 (5V), U10.10 (~SRCLR), U10.16 (VCC), U11.10 (~SRCLR), U11.16 (VCC), U12.10 (~SRCLR), U12.16 (VCC), U13.10 (~SRCLR), U13.16 (VCC)
ADC0: MOD1.8 (GP40)
ADC1: MOD1.7 (GP42)
ADC2: MOD1.22 (GP41)
ADC3: MOD1.21 (GP43)
ADC_3V3: MOD1.48 (REF)
CD: MOD1.34 (GP2)
E0_A3V3: MOD1.26 (GP33)
E0_B3V3: MOD1.12 (GP32)
E0_Z3V3: MOD1.27 (GP31)
E1_A3V3: MOD1.13 (GP30)
E1_B3V3: MOD1.28 (GP29)
E1_Z3V3: MOD1.14 (GP28)
E2_A3V3: MOD1.29 (GP27)
E2_B3V3: MOD1.15 (GP26)
E2_Z3V3: MOD1.30 (GP25)
ERR0: U6.12 (D1)
ERR1: U7.4 (D5)
ERR2: U7.6 (D7)
ERR3: U7.12 (D1)
ERR4: U6.14 (D3)
ERR5: U6.5 (D6)
ERR6: U6.3 (D4)
ESTOP: MOD1.53 (GP9)
GND: C22.2, C23.2, C24.2, C25.2, C26.2, C27.2, C28.2, C29.2, J51.2, MOD1.1 (GND), MOD1.2 (GND), MOD1.16 (GND), MOD1.32 (GND), MOD1.47 (GND), R9.2, U6.8 (GND), U6.15 (~CE), U7.8 (GND), U7.13 (D2), U7.14 (D3), U7.15 (~CE), U8.8 (GND), U8.15 (~CE), U9.8 (GND), U9.15 (~CE), U10.8 (GND), U10.13 (~OE), U11.8 (GND), U11.13 (~OE), U12.8 (GND), U12.13 (~OE), U13.8 (GND), U13.13 (~OE)
HSTX_CLK_N: MOD1.58 (GP19)
HSTX_CLK_P: MOD1.42 (GP18)
HSTX_D0_N: MOD1.55 (GP13)
HSTX_D0_P: MOD1.39 (GP12)
HSTX_D1_N: MOD1.56 (GP15)
HSTX_D1_P: MOD1.40 (GP14)
HSTX_D2_N: MOD1.57 (GP17)
HSTX_D2_P: MOD1.41 (GP16)
I01_N: U8.11 (D0)
I2C_SCL: MOD1.23 (GP39)
I2C_SDA: MOD1.9 (GP38)
I02_N: U8.12 (D1)
I03_N: U8.13 (D2)
I04_N: U8.14 (D3)
I05_N: U8.3 (D4)
I06_N: U8.4 (D5)
I07_N: U8.5 (D6)
I08_N: U8.6 (D7)
I09_N: U9.11 (D0)
I10_N: U9.12 (D1)
I11_N: U9.13 (D2)
I12_N: U9.14 (D3)
I13_N: U9.3 (D4)
I14_N: U9.4 (D5)
I15_N: U9.5 (D6)
I16_N: U9.6 (D7)
IN0: R9.1, U6.10 (DS)
IN1: U6.9 (Q7), U7.10 (DS)
IN2: U7.9 (Q7), U8.10 (DS)
IN3: U8.9 (Q7), U9.10 (DS)
IO4: J51.3, MOD1.35 (GP4)
IO5: J51.4, MOD1.51 (GP5)
IO6: J51.5, MOD1.36 (GP6)
IO7: J51.6, MOD1.52 (GP7)
IO8: J51.7, MOD1.37 (GP8)
LAT: MOD1.44 (GP22), U10.12 (RCLK), U11.12 (RCLK), U12.12 (RCLK), U13.12 (RCLK)
OUT0: U10.1 (QB)
OUT1: U10.2 (QC)
OUT2: U10.3 (QD)
OUT3: U10.4 (QE)
OUT4: U10.5 (QF)
OUT5: U10.6 (QG)
OUT6: U10.7 (QH)
OUT7: U10.15 (QA)
OUT8: U11.1 (QB)
OUT9: U11.2 (QC)
OUT10: U11.3 (QD)
OUT11: U11.4 (QE)
OUT12: U11.5 (QF)
OUT13: U11.6 (QG)
OUT14: U11.7 (QH)
OUT15: U11.15 (QA)
OUT16: U12.1 (QB)
OUT17: U12.2 (QC)
OUT18: U12.3 (QD)
OUT19: U12.4 (QE)
OUT20: U12.5 (QF)
OUT21: U12.6 (QG)
OUT22: U12.7 (QH)
OUT23: U12.15 (QA)
OUT24: U13.1 (QB)
OUT25: U13.2 (QC)
OUT26: U13.3 (QD)
OUT27: U13.4 (QE)
OUT28: U13.5 (QF)
OUT29: U13.6 (QG)
OUT30: U13.7 (QH)
OUT31: U13.15 (QA)
PG_N: MOD1.50 (GP3)
PL: MOD1.45 (GP24), U6.1 (~PL), U7.1 (~PL), U8.1 (~PL), U9.1 (~PL)
PWM0: MOD1.5 (GP46)
PWM1: MOD1.6 (GP44)
PWM2: MOD1.20 (GP45)
PWM3: MOD1.19 (GP47)
Q7: MOD1.60 (GP23), U9.9 (Q7)
SCK: MOD1.59 (GP21), U6.2 (CP), U7.2 (CP), U8.2 (CP), U9.2 (CP), U10.11 (SRCLK), U11.11 (SRCLK), U12.11 (SRCLK), U13.11 (SRCLK)
SER0: MOD1.43 (GP20), U13.14 (SER)
SER1: U12.14 (SER), U13.9 (QH')
SER2: U11.14 (SER), U12.9 (QH')
SER3: U10.14 (SER), U11.9 (QH')
SPI_CK: MOD1.11 (GP34)
SPI_CS: MOD1.24 (GP37)
SPI_SI: MOD1.25 (GP35)
SPI_SO: MOD1.10 (GP36)
UART_RX: MOD1.54 (GP11)
UART_TX: MOD1.38 (GP10)
Z0: U6.11 (D0)
Z1: U7.3 (D4)
Z2: U7.5 (D6)
Z3: U7.11 (D0)
Z4: U6.13 (D2)
Z5: U6.6 (D7)
Z6: U6.4 (D5)

Notes on the sheet:
RP2350B module, shift-register chains and safety I/O | 19 components | 119 local nets
WeAct RP2350B AND EXPANSION HEADER
74HC165 INPUT SHIFT CHAIN
SN74AHCT595 OUTPUT SHIFT CHAIN
