staskaaa-netizen/uCNC_Pi_Board/experiments/power-schematic-readability/other-sheets/storage_wifi_ui-python.kicad_sch

## KiCad design experiments/power-schematic-readability/other-sheets/storage_wifi_ui-python.kicad_sch (2026-11-03)

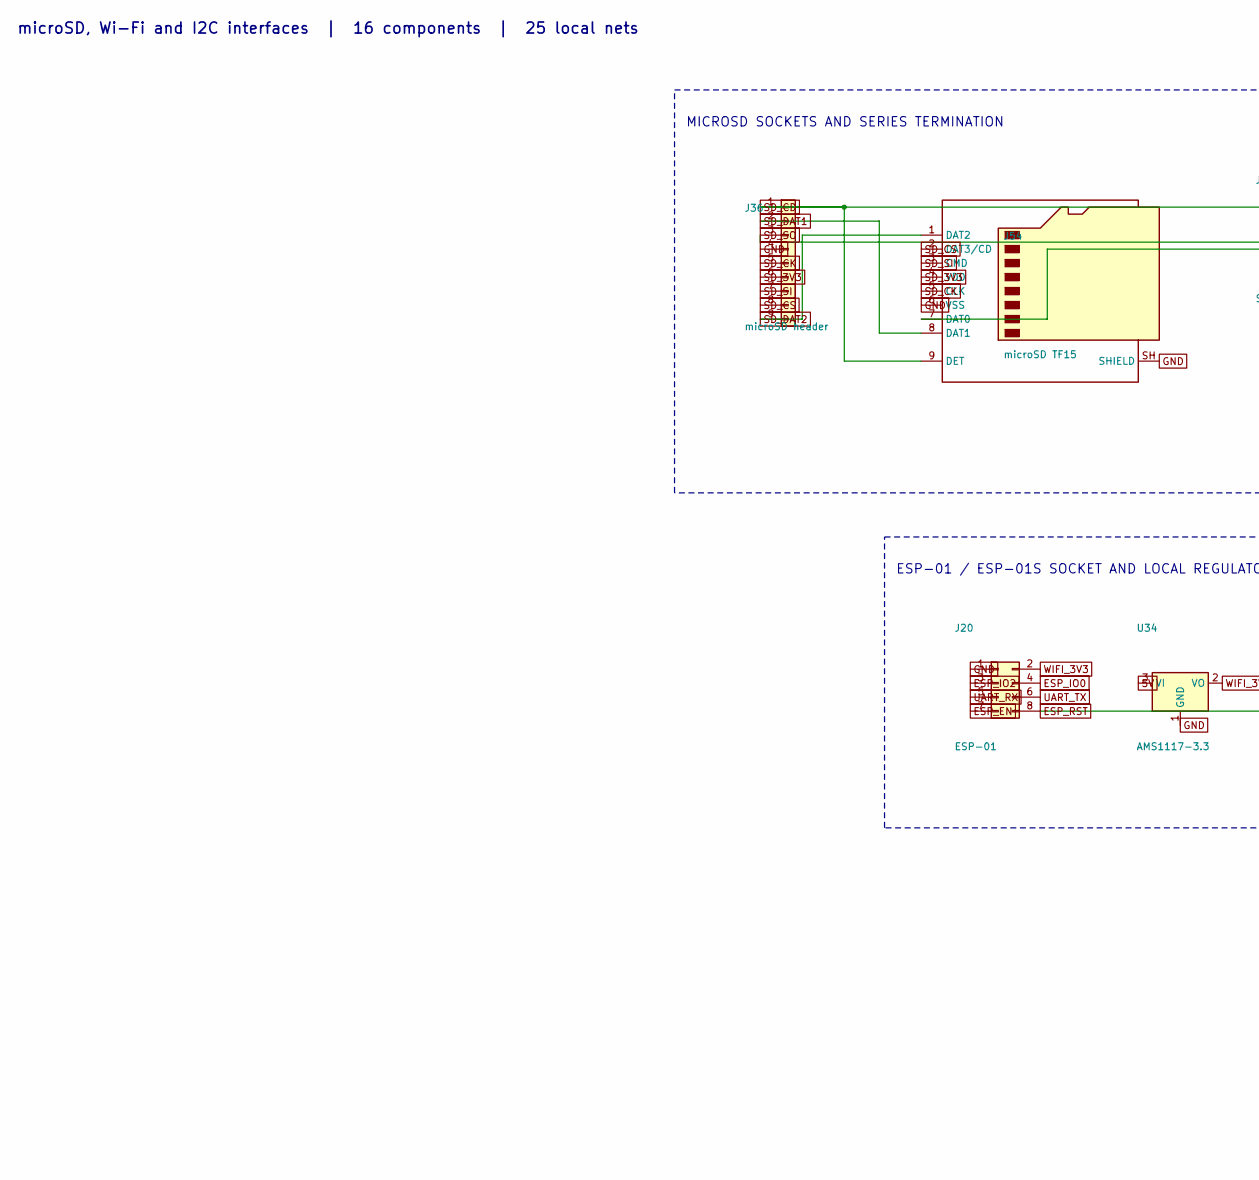
[picture p61: schematic storage_wifi_ui-python.kicad_sch, part in row 1, column 1]

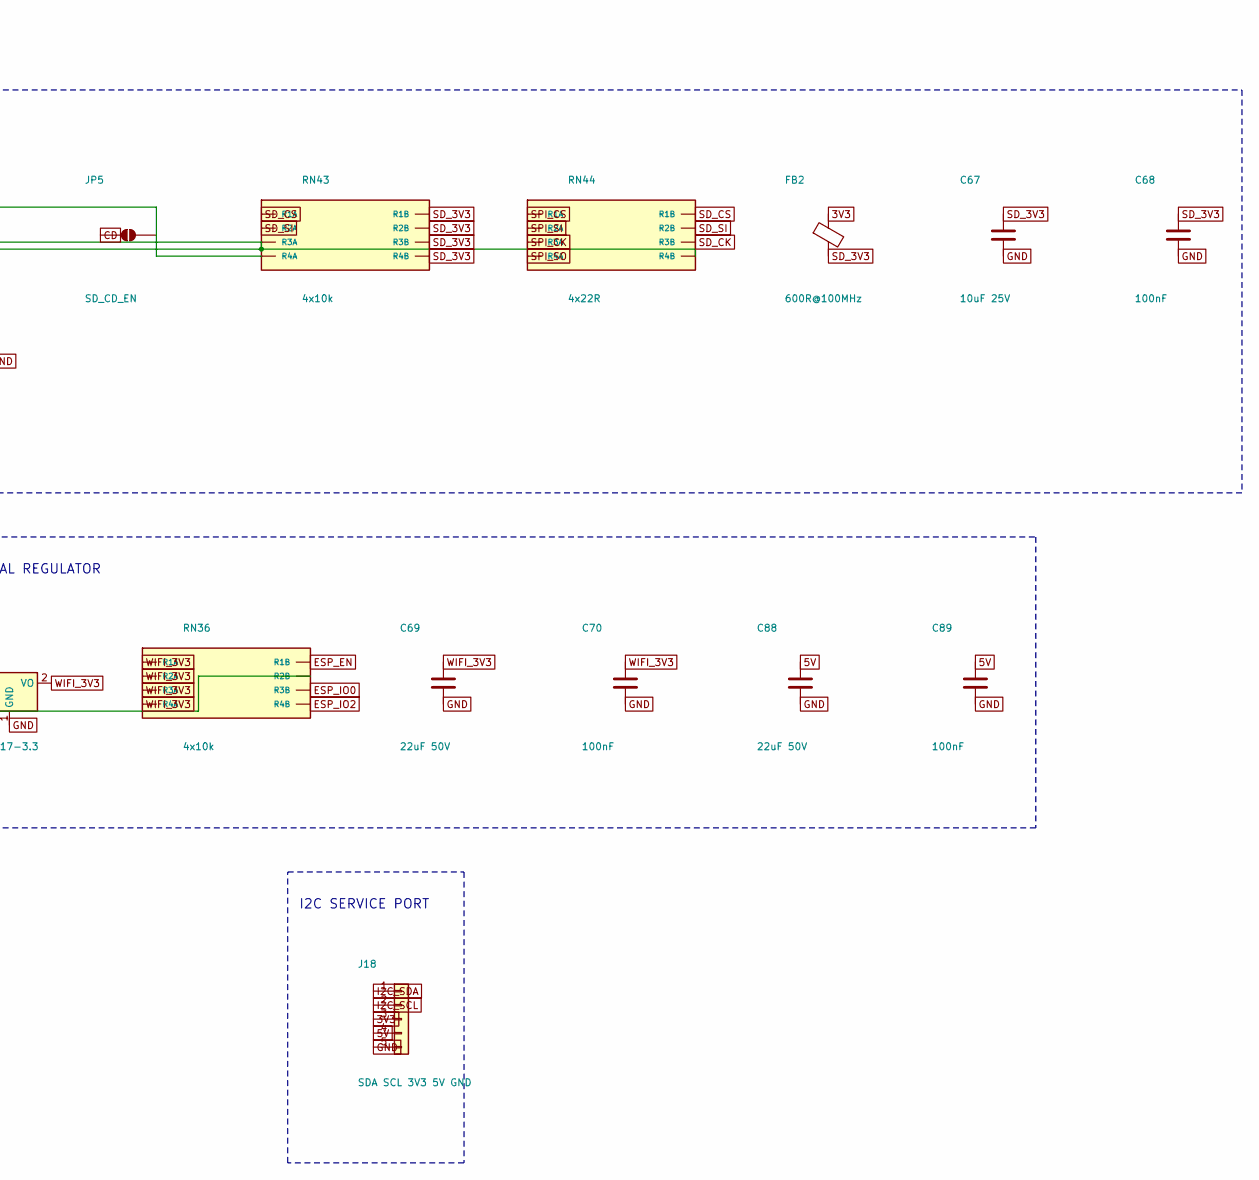
[picture p62: schematic storage_wifi_ui-python.kicad_sch, part in row 1, column 2]

Parts:
C67: 10uF 25V; C_1206_3216Metric; MPN CL31 series 1206 X7R 10uF 25V
C68, C70, C89: 100nF; C_0805_2012Metric; MPN CL21 series 0805 X7R 100nF
C69, C88: 22uF 50V; C_1210_3225Metric; MPN CL32 series 1210 X7R 22uF 50V
FB2: 600R@100MHz; R_1206_3216Metric; MPN BLM18KG601SN1D
J18: SDA SCL 3V3 5V GND; PhoenixContact_MCV_1,5_5-G-3.5_1x05_P3.50mm_Vertical; MPN Phoenix Contact MCV 1,5/5-G-3.5
J20: ESP-01; PinSocket_2x04_P2.54mm_Vertical; MPN 61300821121
J36: microSD header; PinHeader_1x09_P2.54mm_Vertical; MPN microSD header
J54: microSD TF15; TF-SMD_TF-15-15; MPN TF-15x15
JP5: SD_CD_EN; SolderJumper-2_P1.3mm_Open_Pad1.0x1.5mm; MPN SD_CD_EN
RN36, RN43: 4x10k; R_Array_Convex_4x0603; MPN YC164-FR-0710KL
RN44: 4x22R; R_Array_Convex_4x0603; MPN YC164-FR-07 series 1%
U34: AMS1117-3.3; SOT-223-3_TabPin2; MPN AMS1117-3.3

Connections:
3V3: FB2.1, J18.3
5V: C88.1, C89.1, J18.4, U34.3 (VI)
CD: JP5.1 (A)
ESP_EN: J20.7, RN36.8 (R1B)
ESP_IO0: J20.4, RN36.6 (R3B)
ESP_IO2: J20.3, RN36.5 (R4B)
ESP_RST: J20.8, RN36.7 (R2B)
GND: C67.2, C68.2, C69.2, C70.2, C88.2, C89.2, J18.5, J20.1, J36.4, J54.6 (VSS), J54.SH (SHIELD), U34.1 (GND)
I2C_SCL: J18.2
I2C_SDA: J18.1
SD_3V3: C67.1, C68.1, FB2.2, J36.6, J54.4 (VDD), RN43.5 (R4B), RN43.6 (R3B), RN43.7 (R2B), RN43.8 (R1B)
SD_CD: J36.1, J54.9 (DET), JP5.2 (B), RN43.4 (R4A)
SD_CK: J36.5, J54.5 (CLK), RN44.6 (R3B)
SD_CS: J36.8, J54.2 (DAT3/CD), RN43.1 (R1A), RN44.8 (R1B)
SD_DAT1: J36.2, J54.8 (DAT1)
SD_DAT2: J36.9, J54.1 (DAT2)
SD_SI: J36.7, J54.3 (CMD), RN43.2 (R2A), RN44.7 (R2B)
SD_SO: J36.3, J54.7 (DAT0), RN43.3 (R3A), RN44.5 (R4B)
SPI_CK: RN44.3 (R3A)
SPI_CS: RN44.1 (R1A)
SPI_SI: RN44.2 (R2A)
SPI_SO: RN44.4 (R4A)
UART_RX: J20.5
UART_TX: J20.6
WIFI_3V3: C69.1, C70.1, J20.2, RN36.1 (R1A), RN36.2 (R2A), RN36.3 (R3A), RN36.4 (R4A), U34.2 (VO)

Notes on the sheet:
microSD, Wi-Fi and I2C interfaces | 16 components | 25 local nets
MICROSD SOCKETS AND SERIES TERMINATION
ESP-01 / ESP-01S SOCKET AND LOCAL REGULATOR
I2C SERVICE PORT
