staskaaa-netizen/uCNC_Pi_Board/tools/generate_schematic.py

"""Generate the LeanCam NCC RP2350B hierarchical schematic from verified parts."""

from __future__ import annotations

import re
from collections import defaultdict
from dataclasses import dataclass
from pathlib import Path
from typing import Iterable

import kicad_sch_api.library.cache as cache_module
from kicad_sch_api import Schematic
from kicad_sch_api.core.types import Point
from configure_netclasses import configure_netclasses
from design_names import shorten_name, shorten_quoted_tokens


PROJECT = Path(__file__).resolve().parents[1]
HARDWARE = PROJECT / "hardware"
CACHE_DIR = PROJECT / ".kicad-cache"
KICAD_SYMBOLS = Path(
    r"C:\Users\s.zachazevski\AppData\Local\Programs\KiCad\10.0\share\kicad\symbols"
)
CUSTOM_SYMBOLS = HARDWARE / "libraries" / "LeanCam.kicad_sym"

FP = {
    "R1206": "Resistor_SMD:R_1206_3216Metric",
    "R0805": "Resistor_SMD:R_0805_2012Metric",
    "R_Array_4x0603": "Resistor_SMD:R_Array_Convex_4x0603",
    "R_Array_4x1206": "Resistor_SMD:R_Array_Convex_4x1206",
    "C0805": "Capacitor_SMD:C_0805_2012Metric",
    "C1206": "Capacitor_SMD:C_1206_3216Metric",
    "C1210": "Capacitor_SMD:C_1210_3225Metric",
    "C1206_100V": "Capacitor_SMD:C_1206_3216Metric",
    "LED0805": "LED_SMD:LED_0805_2012Metric",
    "D_SOD323": "Diode_SMD:D_SOD-323",
    "D_SMA": "Diode_SMD:D_SMA",
    "D_SMB": "Diode_SMD:D_SMB",
    "SOT23": "Package_TO_SOT_SMD:SOT-23",
    "SOT23_5": "Package_TO_SOT_SMD:SOT-23-5",
    "SOT23_6": "Package_TO_SOT_SMD:SOT-23-6",
    "SOT223": "Package_TO_SOT_SMD:SOT-223-3_TabPin2",
    "SOT89": "Package_TO_SOT_SMD:SOT-89-3_Handsoldering",
    "SOT363": "Package_TO_SOT_SMD:SOT-363_SC-70-6",
    "TSOT23_6": "Package_TO_SOT_SMD:TSOT-23-6",
    "SOIC8": "Package_SO:SOIC-8_3.9x4.9mm_P1.27mm",
    "SOIC8_POWERPAD": "Package_SO:SOIC-8-1EP_3.9x4.9mm_P1.27mm_EP2.41x3.3mm",
    "SOIC14": "Package_SO:SOIC-14_3.9x8.7mm_P1.27mm",
    "SOIC16": "Package_SO:SOIC-16_3.9x9.9mm_P1.27mm",
    "SOIC16W": "Package_SO:SOIC-16W_7.5x10.3mm_P1.27mm",
    "SOIC18W": "Package_SO:SOP-18_7.495x11.515mm_P1.27mm",
    "SOIC20W": "Package_SO:SOIC-20W_7.5x12.8mm_P1.27mm",
    "DIP4": "Package_DIP:DIP-4_W7.62mm",
    "DIP16": "Package_DIP:DIP-16_W7.62mm",
    "DIP20": "Package_DIP:DIP-20_W7.62mm",
    "SOP4": "Package_SO:SOP-4_4.4x2.6mm_P1.27mm",
    "SOIC4": "Package_SO:SOIC-4_4.55x2.6mm_P1.27mm",
    "SIP4": "Resistor_THT:R_Array_SIP5",
    "SIP8": "Resistor_THT:R_Array_SIP9",
    "TLP291_4": "Package_SO:SOIC-16_4.55x10.3mm_P1.27mm",
    "TO263_5": "Package_TO_SOT_SMD:TO-263-5_TabPin3",
    "USON10": "Package_SON:USON-10_2.5x1.0mm_P0.5mm",
    "SD": "Connector_Card:SD_TE_2041021",
    "PH2": "Capacitor_THT:CP_Radial_D10.0mm_P5.00mm",
    "SWITCH": "Button_Switch_THT:SW_PUSH_6mm",
    "WEACT": "LeanCam:WeAct_RP2350B_Socket",
    "NETTIE": "NetTie:NetTie-2_SMD_Pad2.0mm",
    "L_SRR1260": "Inductor_SMD:L_Bourns_SRR1260",
    "L_SMNR5040": "LeanCam:L_SXN_SMNR5040",
    "DCDC_TMA0505": "Converter_DCDC:Converter_DCDC_TRACO_TMA-05xxS_12xxS_Single_THT",
    "DCDC_TBA2": "Converter_DCDC:Converter_DCDC_TRACO_TBA2-xxxx_Single_THT",
    "SJ2": "LeanCam:SolderJumper_2_Open_1206Gap",
    "SJ2_STD": "Jumper:SolderJumper-2_P1.3mm_Open_Pad1.0x1.5mm",
    "SJ2_BRIDGED": "Jumper:SolderJumper-2_P1.3mm_Bridged_RoundedPad1.0x1.5mm",
    "SJ3": "Jumper:SolderJumper-3_P1.3mm_Open_Pad1.0x1.5mm",
}

for count in range(2, 17):
    FP[f"TERM{count}"] = (
        "Connector_Phoenix_MC:"
        f"PhoenixContact_MCV_1,5_{count}-G-3.5_1x{count:02d}_P3.50mm_Vertical"
    )

for count in (2, 3, 4, 5, 6, 8, 9, 10):
    FP[f"HDR1X{count}"] = (
        f"Connector_PinHeader_2.54mm:PinHeader_1x{count:02d}_P2.54mm_Vertical"
    )
FP["SOCKET1X7"] = (
    "Connector_PinSocket_2.54mm:PinSocket_1x07_P2.54mm_Vertical"
)
FP["MICROSD_SOFNG_C111196"] = "LeanCam:TF-SMD_TF-15-15"
FP["HDR2X4"] = "Connector_PinSocket_2.54mm:PinSocket_2x04_P2.54mm_Vertical"
FP["HDR2X5"] = "Connector_PinHeader_2.54mm:PinHeader_2x05_P2.54mm_Vertical"
FP["HDR2X8"] = "Connector_PinHeader_2.54mm:PinHeader_2x08_P2.54mm_Vertical"
FP["HDR2X10"] = "Connector_PinHeader_2.54mm:PinHeader_2x10_P2.54mm_Vertical"
FP["HDR2X10_2MM"] = "Connector_PinHeader_2.00mm:PinHeader_2x10_P2.00mm_Vertical"

MPN = {
    "R1206": ("Yageo", "RC1206 series 1%"),
    "R0805": ("Yageo", "RC0805 series 1%"),
    "R_Array_4x0603": ("Yageo", "YC164-FR-07 series 1%"),
    "R_Array_4x1206": ("Yageo", "YC324-FR-07 series 1%"),
    "C0805": ("Samsung Electro-Mechanics", "CL21 series 0805 X7R"),
    "C1206": ("Samsung Electro-Mechanics", "CL31 series 1206 X7R"),
    "C1210": ("Samsung Electro-Mechanics", "CL32 series 1210 X7R"),
    "C1206_100V": ("Murata", "GRM31 series 1206 C0G/X7R"),
    "LED0805": ("Hubei KENTO Elec", "KT-0805G"),
    "D_SOD323": ("Diodes Incorporated", "1N4148WS"),
    "D_SMA": ("MDD", "US1M"),
    "D_SMB": ("Bourns", "SMBJ24CA"),
    "SOT23": ("Texas Instruments", "generic SOT-23"),
    "SOT23_5": ("Texas Instruments", "generic SOT-23-5"),
    "SOT23_6": ("Texas Instruments", "generic SOT-23-6"),
    "SOT223": ("Advanced Monolithic Systems", "AMS1117-3.3"),
    "SOT89": ("Texas Instruments", "L78L12ACUTR"),
    "SOT363": ("Texas Instruments", "LM66100DCKR"),
    "TSOT23_6": ("Diodes Incorporated", "AP63203WU-7"),
    "SOIC8": ("Texas Instruments", "generic SOIC-8"),
    "SOIC8_POWERPAD": ("Texas Instruments", "LMR36510ADDAR"),
    "SOIC14": ("Texas Instruments", "generic SOIC-14"),
    "SOIC16": ("Texas Instruments", "generic SOIC-16"),
    "SOIC16W": ("Lite-On", "LTV-847S"),
    "SOIC18W": ("Toshiba", "TBD62083AFG"),
    "SOIC20W": ("Texas Instruments", "SN74AHCT541DWR"),
    "DIP4": ("Everlight", "EL3H7"),
    "SOP4": ("Everlight", "EL3H7"),
    "SOIC4": ("Toshiba", "TLP291"),
    "DIP16": ("Texas Instruments", "generic DIP-16"),
    "DIP20": ("Texas Instruments", "generic DIP-20"),
    "SIP4": ("Bourns", "4600X series bussed resistor network"),
    "SIP8": ("Bourns", "4600X series bussed resistor network"),
    "TLP291_4": ("Toshiba", "TLP291-4"),
    "TO263_5": ("Texas Instruments", "LM2596S-5.0/NOPB"),
    "USON10": ("Texas Instruments", "TPD4E05U06DQA"),
    "SD": ("TE Connectivity", "2041021-4"),
    "PH2": ("Nichicon", "UWT1H101MNL1GS"),
    "SWITCH": ("C&K", "PTS645"),
    "HDR2X4": ("Wurth Elektronik", "61300821121"),
    "SJ2": ("PCB fabrication", "2-pad solder jumper"),
    "L_SRR1260": ("Bourns", "SRR1260 series"),
    "L_SMNR5040": ("SXN (Shun Xiang Nuo Elec)", "SMNR5040 series"),
    "SJ3": ("PCB fabrication", "3-pad solder jumper"),
    "SJ2_BRIDGED": ("PCB fabrication", "2-pad bridged solder jumper"),
    "MICROSD_SOFNG_C111196": ("SOFNG", "TF-15x15"),
}

cache_module._global_cache = cache_module.SymbolLibraryCache(CACHE_DIR)
cache_module._global_cache.discover_libraries([KICAD_SYMBOLS])
cache_module._global_cache.add_library_path(CUSTOM_SYMBOLS)


@dataclass
class Part:
    reference: str
    value: str
    footprint: str
    lib_id: str
    dnp: bool
    mpn: str


PARTS: list[Part] = []
REF_COUNTERS: defaultdict[str, int] = defaultdict(int)


class SheetBuilder:
    def __init__(self, name: str, filename: str, paper: str = "A2") -> None:
        self.name = name
        self.filename = filename
        self.sch = Schematic.create(name, paper=paper)
        self.counters = REF_COUNTERS
        self.dnp_uuids: set[str] = set()
        self.pin_owners: dict[tuple[float, float], dict[tuple[str, str], str | None]] = defaultdict(dict)

    def next_ref(self, prefix: str) -> str:
        self.counters[prefix] += 1
        return f"{prefix}{self.counters[prefix]}"

    def note(self, text: str, x: float, y: float, width: float = 80, height: float = 20) -> None:
        self.sch.add_text_box(
            text=text,
            position=(x, y),
            size=(width, height),
            font_size=1.27,
            stroke_width=0.127,
            fill_type="none",
        )

    def _symbol_pins(self, lib_id: str):
        symbol = cache_module._global_cache.get_symbol(lib_id)
        if symbol is None:
            raise RuntimeError(f"Symbol not found: {lib_id}")
        return symbol.pins

    def _pin_world(self, component, pin_number: str):
        pin = next((item for item in self._symbol_pins(component.lib_id) if item.number == pin_number), None)
        if pin is None:
            raise RuntimeError(f"Pin {pin_number} not found on {component.reference}")
        return (
            component.position.x + pin.position.x,
            component.position.y - pin.position.y,
            pin.rotation,
        )

    def _stub_end(self, x: float, y: float, rotation: float) -> tuple[float, float]:
        if rotation == 0:
            return x - 2.54, y
        if rotation == 180:
            return x + 2.54, y
        if rotation == 90:
            return x, y + 2.54
        return x, y - 2.54

    def connect_pin(self, component, pin_number: str, net: str | None) -> None:
        x, y, rotation = self._pin_world(component, pin_number)
        key = (round(x, 4), round(y, 4))
        owner = (component.reference, pin_number)
        other_owners = {
            item: value for item, value in self.pin_owners[key].items() if item != owner
        }
        if other_owners and any(value != net for value in other_owners.values()):
            raise RuntimeError(
                f"Pin coordinate collision at {key} in {self.name}: "
                f"{owner}:{net!r} with {other_owners}"
            )
        self.pin_owners[key][owner] = net
        if net is None:
            self.sch.no_connects.add((x, y))
            return
        self.sch.labels.add(net, (x, y))

    def add(
        self,
        *,
        lib_id: str,
        value: str,
        footprint_key: str | None,
        nets: dict[str, str | None],
        position: tuple[float, float] = (50.8, 50.8),
        prefix: str = "U",
        mpn: str | None = None,
        manufacturer: str | None = None,
        dnp: bool = False,
        reference: str | None = None,
        rotation: float = 0,
    ):
        footprint = FP[footprint_key] if footprint_key else None
        value = shorten_name(value)
        if reference is None:
            reference = self.next_ref(prefix)
        else:
            match = re.fullmatch(r"([A-Za-z]+)([0-9]+)", reference)
            if match:
                self.counters[match.group(1)] = max(
                    self.counters[match.group(1)], int(match.group(2))
                )
        component = self.sch.components.add(
            lib_id,
            reference=reference,
            value=value,
            footprint=footprint,
            position=position,
            rotation=rotation,
        )
        component.set_property("MPN", mpn or value)
        component.set_property("Manufacturer", manufacturer or "generic")
        if dnp:
            component.set_property("Assembly", "DNP")
            self.dnp_uuids.add(component.uuid)
        defined = {pin.number: pin.name for pin in self._symbol_pins(lib_id)}
        normalized = {}
        for selector, net in nets.items():
            matches = [number for number, pin_name in defined.items() if selector in (number, pin_name)]
            if not matches:
                raise RuntimeError(f"No pin selector {selector!r} on {reference} ({lib_id})")
            for pin_number in matches:
                normalized[pin_number] = shorten_name(net) if net else None
        missing = sorted(set(defined) - set(normalized))
        if missing:
            raise RuntimeError(
                f"{reference} ({lib_id}) has unmapped pins: "
                + ", ".join(f"{number}:{defined[number]}" for number in missing)
            )
        for pin_number, net in normalized.items():
            self.connect_pin(component, pin_number, net)
        PARTS.append(
            Part(
                reference=reference,
                value=value,
                footprint=footprint or "",
                lib_id=lib_id,
                dnp=dnp,
                mpn=mpn or value,
            )
        )
        return component

    def two_pin(
        self,
        prefix: str,
        lib_id: str,
        value: str,
        footprint_key: str,
        net1: str,
        net2: str,
        position: tuple[float, float],
        *,
        mpn: str | None = None,
        manufacturer: str | None = None,
        dnp: bool = False,
        reference: str | None = None,
    ):
        return self.add(
            lib_id=lib_id,
            value=value,
            footprint_key=footprint_key,
            nets={"1": net1, "2": net2},
            position=position,
            prefix=prefix,
            mpn=mpn,
            manufacturer=manufacturer,
            dnp=dnp,
            reference=reference,
        )

    def resistor(
        self,
        net1: str,
        net2: str,
        value: str,
        position: tuple[float, float],
        *,
        dnp: bool = False,
        footprint_key: str | None = None,
        reference: str | None = None,
    ):
        if footprint_key is None:
            footprint_key = "R1206" if value == "2.2k" else "R0805"
        manufacturer, mpn = MPN[footprint_key]
        return self.two_pin(
            "R",
            "Device:R",
            value,
            footprint_key,
            net1,
            net2,
            position,
            mpn=f"{mpn} {value}" if footprint_key == "R0805" else f"RC1206FR-07 1% {value}",
            manufacturer=manufacturer,
            dnp=dnp,
            reference=reference,
        )

    def resistor_pack4(
        self,
        value: str,
        footprint_key: str,
        pairs: list[tuple[str | None, str | None]],
        position: tuple[float, float],
        *,
        dnp: bool = False,
        reference: str | None = None,
    ):
        if len(pairs) != 4:
            raise ValueError("A four-resistor pack requires four pairs")
        pins = [("1", "8"), ("2", "7"), ("3", "6"), ("4", "5")]
        nets = {}
        for (pin_a, pin_b), (net_a, net_b) in zip(pins, pairs):
            nets[pin_a] = net_a
            nets[pin_b] = net_b
        manufacturer, mpn = MPN[footprint_key]
        exact_mpns = {
            ("R_Array_4x0603", "1k"): "4D03WGJ0102T5E",
            ("R_Array_4x0603", "4.7k"): "YC164-FR-074K7L",
            ("R_Array_4x0603", "10k"): "4D03WGJ0103T5E",
            ("R_Array_4x0603", "330R"): "YC164-FR-07330RL",
            ("R_Array_4x1206", "100R"): "YC324-FR-07100RL",
            ("R_Array_4x1206", "330R"): "YC324-FR-07330RL",
            ("R_Array_4x1206", "0R"): "YC324-JK-070RL",
        }
        mpn = exact_mpns.get((footprint_key, value), mpn)
        exact_manufacturers = {
            ("R_Array_4x0603", "1k"): "UNI-ROYAL",
            ("R_Array_4x0603", "10k"): "UNI-ROYAL",
        }
        manufacturer = exact_manufacturers.get(
            (footprint_key, value),
            manufacturer,
        )
        return self.add(
            lib_id="LeanCam:ResistorPack04",
            value=f"4x{value}",
            footprint_key=footprint_key,
            nets=nets,
            position=position,
            prefix="RN",
            mpn=mpn,
            manufacturer=manufacturer,
            dnp=dnp,
            reference=reference,
        )

    def resistor_network(
        self,
        value: str,
        common_net: str,
        signal_nets: list[str | None],
        position: tuple[float, float],
        *,
        reference: str,
    ):
        count = len(signal_nets)
        if count not in (4, 8):
            raise ValueError("Only 4- or 8-element bussed networks are supported")
        footprint_key = "SIP4" if count == 4 else "SIP8"
        manufacturer, mpn = MPN[footprint_key]
        nets = {"1": common_net}
        nets.update(
            {str(index + 2): net for index, net in enumerate(signal_nets)}
        )
        return self.add(
            lib_id=f"Device:R_Network0{count}",
            value=f"{count}x{value}",
            footprint_key=footprint_key,
            nets=nets,
            position=position,
            prefix="RN",
            mpn=f"{mpn} {value}",
            manufacturer=manufacturer,
            reference=reference,
        )

    def capacitor(
        self,
        net1: str,
        net2: str,
        value: str,
        position: tuple[float, float],
        *,
        footprint_key: str | None = None,
        lib_id: str = "Device:C",
        dnp: bool = False,
        reference: str | None = None,
    ):
        if footprint_key is None:
            footprint_key = "C0805" if value in {"100nF", "1uF"} else "C1206"
        manufacturer, mpn = MPN[footprint_key]
        if (footprint_key, value) == ("C1206", "22uF 25V"):
            manufacturer = "Samsung Electro-Mechanics"
            mpn = "CL31A226KAHNNNE"
        return self.two_pin(
            "C",
            lib_id,
            value,
            footprint_key,
            net1,
            net2,
            position,
            manufacturer=manufacturer,
            mpn=f"{mpn} {value}",
            dnp=dnp,
            reference=reference,
        )

    def diode(
        self,
        net_k: str,
        net_a: str,
        position: tuple[float, float],
        *,
        value: str = "1N4148WS",
        lib_id: str = "Device:D",
        footprint_key: str = "D_SOD323",
        dnp: bool = False,
        reference: str | None = None,
    ):
        manufacturer, mpn = MPN[footprint_key]
        return self.two_pin(
            "D",
            lib_id,
            value,
            footprint_key,
            net_k,
            net_a,
            position,
            mpn=mpn if value == "1N4148WS" else value,
            manufacturer=manufacturer,
            dnp=dnp,
            reference=reference,
        )

    def led(
        self,
        net_k: str,
        net_a: str,
        position: tuple[float, float],
        value: str = "indicator",
        *,
        reference: str | None = None,
    ):
        manufacturer, mpn = MPN["LED0805"]
        return self.two_pin(
            "D",
            "Device:LED",
            value,
            "LED0805",
            net_k,
            net_a,
            position,
            mpn=mpn,
            manufacturer=manufacturer,
            reference=reference,
        )

    def header(
        self,
        rows: int,
        count: int,
        nets: dict[str, str],
        position: tuple[float, float],
        value: str,
        *,
        dnp: bool = False,
        reference: str | None = None,
        footprint_key: str | None = None,
    ):
        if rows == 1:
            lib_id = f"Connector_Generic:Conn_01x{count:02d}"
            footprint_key = footprint_key or f"HDR1X{count}"
        else:
            lib_id = f"Connector_Generic:Conn_02x{count:02d}_Odd_Even"
            footprint_key = footprint_key or (
                f"HDR{rows}X{count}"
                if rows != 2 or count != 10
                else "HDR2X10_2MM"
            )
        if footprint_key is None:
            raise RuntimeError(f"Connector footprint not configured: {rows}x{count}")
        manufacturer, mpn = MPN.get(footprint_key, ("generic", value))
        return self.add(
            lib_id=lib_id,
            value=value,
            footprint_key=footprint_key,
            nets=nets,
            position=position,
            prefix="J",
            mpn=mpn,
            manufacturer=manufacturer,
            dnp=dnp,
            reference=reference,
        )

    def terminal(
        self,
        count: int,
        nets: dict[str, str],
        position: tuple[float, float],
        value: str,
        *,
        reference: str | None = None,
    ):
        return self.add(
            lib_id=f"Connector_Generic:Conn_01x{count:02d}",
            value=value,
            footprint_key=f"TERM{count}",
            nets=nets,
            position=position,
            prefix="J",
            mpn=f"Phoenix Contact MCV 1,5/{count}-G-3.5",
            manufacturer="Phoenix Contact",
            reference=reference,
        )

    def save(self) -> Path:
        path = HARDWARE / self.filename
        self.sch.save(path)
        text = path.read_text(encoding="utf-8")
        text = re.sub(
            r'(?m)^\t\(label ("[^"]+")\n\t\t\(at ([^\)]+)\)\n\t\t\(effects',
            lambda m: (
                f"\t(global_label {m.group(1)}\n"
                "\t\t(shape passive)\n"
                f"\t\t(at {m.group(2)})\n"
                "\t\t(fields_autoplaced yes)\n"
                "\t\t(effects"
            ),
            text,
        )
        for component_uuid in self.dnp_uuids:
            marker = f'(uuid "{component_uuid}")'
            index = text.find(marker)
            if index < 0:
                raise RuntimeError(f"Could not locate DNP symbol {component_uuid}")
            block_start = text.rfind("\n\t(symbol\n", 0, index)
            block_end = text.find("\n\t(symbol\n", index)
            if block_end < 0:
                block_end = text.find("\n\t(sheet_instances", index)
            block = text[block_start:block_end]
            block = block.replace("\t\t(dnp no)", "\t\t(dnp yes)", 1)
            text = text[:block_start] + block + text[block_end:]
        path.write_text(text, encoding="utf-8")
        return path


def make_root() -> None:
    root = Schematic.create("LeanCam NCC RP2350B Motherboard", paper="A2")
    sheets = [
        ("Power and supervision", "power.kicad_sch", 20, 20, 120, 80, "2"),
        ("MCU, shift chains and safety", "mcu_io.kicad_sch", 20, 115, 180, 100, "3"),
        ("16 PLC inputs", "field_inputs.kicad_sch", 215, 20, 160, 120, "4"),
        ("24 PLC outputs", "field_outputs.kicad_sch", 390, 20, 160, 120, "5"),
        ("Encoders", "encoders.kicad_sch", 215, 155, 120, 85, "6"),
        ("Display", "display.kicad_sch", 350, 155, 200, 85, "7"),
        ("Storage, Wi-Fi and UI", "storage_wifi_ui.kicad_sch", 20, 230, 160, 100, "8"),
        ("Analog I/O", "analog_io.kicad_sch", 200, 255, 140, 90, "9"),
    ]
    for name, filename, x, y, width, height, page in sheets:
        root.add_sheet(
            name=name,
            filename=filename,
            position=(x, y),
            size=(width, height),
            page_number=page,
        )
    root.add_text_box(
        text=(
            "LeanCam NCC RP2350B motherboard\n"
            "This root sheet instantiates the functional hierarchy. Global net labels are "
            "the inter-sheet contract; see documentation/gpio-map.md and io-bit-map.md."
        ),
        position=(18, 270),
        size=(160, 30),
        font_size=1.6,
        stroke_width=0.2,
    )
    path = HARDWARE / "motherboard.kicad_sch"
    root.save(path)
    text = path.read_text(encoding="utf-8")
    text = re.sub(
        r'(\(title_block\s*\n\s*\(title "[^"]*"\))',
        r'\1\n\t\t(rev "PRE-FINAL")',
        text,
        count=1,
    )
    path.write_text(text, encoding="utf-8")


def add_power(builder: SheetBuilder) -> None:
    b = builder
    b.note(
        "Power tree: 12-24 V input with a TVS and two independent 1 A "
        "series-diode feeds. One feed powers the 5 V logic buck and analog housekeeping; "
        "the other powers the nominal 11 V backlight buck. WeAct onboard 3.3 V "
        "regulation supplies only the module, and the ESP has its own 3.3 V LDO.",
        15,
        15,
        175,
        28,
    )

    b.terminal(2, {"1": "VIN_RAW", "2": "GND"}, (30, 60), "24 V DC input")
    b.next_ref("F")  # retired F1 main-input fuse
    b.two_pin("D", "Device:D_TVS", "SMBJ24CA", "D_SMB", "VIN_RAW", "GND", (72, 55), mpn="SMBJ24CA", manufacturer="Bourns")
    b.next_ref("C")  # retired common bulk capacitor C1
    b.next_ref("C")  # retired input bypass C2

    # Two independent 1 A series feeds provide reverse-polarity protection and
    # keep the logic converter and backlight converter on separate branches.
    b.diode(
        "VIN_PROT",
        "VIN_RAW",
        (115, 65),
        value="US1M",
        footprint_key="D_SMA",
        reference="D2",
    )
    b.next_ref("D")  # retired D3 backlight-input diode
    b.next_ref("Q")  # retired Q1 reverse-polarity MOSFET
    b.next_ref("R")  # retired R1 gate pull-down
    b.capacitor("VIN_PROT", "GND", "22uF 35V", (145, 65), footprint_key="C1210")
    b.next_ref("C")  # retired input bypass C4

    # TI LMR36510 reference values for 5 V/1 A at 400 kHz:
    # L1=22 uH, COUT=2x22 uF, RFBT=33k+100k, RFBB=33k.
    b.add(
        lib_id="Regulator_Switching:LMR36510ADDA",
        value="LMR36510ADDAR",
        footprint_key="SOIC8_POWERPAD",
        nets={
            "1": "GND",
            "2": "VIN_PROT",
            "3": "VIN_PROT",
            "4": "PWR_GOOD_N",
            "5": "FB5",
            "6": "VCC5",
            "7": "BUCK5_BST",
            "8": "BUCK5_SW",
            "9": "GND",
        },
        position=(45, 100),
        prefix="U",
        mpn="LMR36510ADDAR",
        manufacturer="Texas Instruments",
    )
    b.two_pin("L", "Device:L", "22uH 1.4A", "L_SMNR5040", "BUCK5_SW", "+5V", (75, 100), mpn="SMNR5040-220MT", manufacturer="SXN (Shun Xiang Nuo Elec)")
    b.capacitor("VIN_PROT", "GND", "22uF 35V", (30, 120), footprint_key="C1210")
    b.capacitor("+5V", "GND", "22uF 25V", (115, 100), footprint_key="C1206")
    b.next_ref("C")  # retired output bypass C7
    b.next_ref("C")  # retired C8: C6/C11 already provide 2x22uF output bulk

    # Peripheral 3.3 V LDO. The WeAct regulator supplies only the module; this
    # separate linear rail prevents the MCU regulator from carrying board loads.
    b.add(
        lib_id="Regulator_Linear:AMS1117-3.3",
        value="AMS1117-3.3",
        footprint_key="SOT223",
        nets={
            "1": "GND",
            "2": "+3V3",
            "3": "+5V",
        },
        position=(65, 145),
        prefix="U",
        reference="U2",
        mpn="AMS1117-3.3",
        manufacturer="Advanced Monolithic Systems",
    )
    b.next_ref("L")  # reserve L2 for the dedicated backlight buck
    b.next_ref("C")  # retired 3.3 V buck bootstrap C9
    b.capacitor("+5V", "GND", "22uF 25V", (52, 155), footprint_key="C1206")
    b.capacitor("+5V", "GND", "22uF 25V", (118, 145), footprint_key="C1206")
    b.next_ref("C")  # retired optional output capacitor C12
    b.capacitor("+3V3", "GND", "100nF", (142, 145))
    # Isolated 3.3 V analog rail.
    b.two_pin(
        "FB",
        "Device:FerriteBead",
        "600R@100MHz",
        "R0805",
        "+3V3",
        "+3V3_A",
        (160, 145),
        mpn="GZ2012D601TF",
        manufacturer="Sunlord",
    )
    b.next_ref("C")  # retired C14: C15 provides the required reference bypass
    b.capacitor("+3V3_A", "GND", "100nF", (187, 145))

    # WeAct USB/5 V backfeed handling is provided by the module. Retire the
    # former ideal-diode branch without renumbering the remaining parts.
    b.next_ref("U")  # retired U3
    b.next_ref("C")  # retired C16: redundant +5V bulk
    b.next_ref("C")  # retired C17: redundant +5V bypass
    b.next_ref("R")  # retired status pull-up R2

    # The WeAct module owns reset and supervision.
    b.next_ref("U")  # retired U4
    b.next_ref("R")  # retired reset pull-up R3

    b.led("GND", "PWR5_LEDA", (240, 90), "5V_PWR")
    b.resistor("+5V", "PWR5_LEDA", "2.2k", (253, 90))
    b.led("GND", "PWR3_LEDA", (240, 110), "3V3_PWR")
    b.resistor("+3V3", "PWR3_LEDA", "2.2k", (253, 110))

    power_flags = (
        "GND",
        "+5V",
        "+3V3_A",
        "VIN_PROT",
        "+5V_ENC",
        "+3V3_SD",
        "+24V_FIELD",
        "ISO_GND",
        "VIN_BL_PROT",
        "+12V_BL",
    )
    for index, net in enumerate(power_flags):
        b.add(
            lib_id="power:PWR_FLAG",
            value=net,
            footprint_key=None,
            nets={"1": net},
            position=(25 + index * 12, 185),
            prefix="FLG",
            mpn="",
            manufacturer="",
        )

    b.note(
        "Default: the LMR36510 generates +5V for the module and both peripheral LDOs. "
        "The WeAct onboard regulator supplies only the module, whose 3V3 outputs and "
        "VBUS remain local.",
        120,
        165,
        140,
        34,
    )


def add_mcu(builder: SheetBuilder) -> None:
    b = builder
    b.note(
        "Shift order (verified from the hardware chain): 74HC165 Q7 -> next DS, with "
        "the PLC input banks assigned to their nearest 74HC165 data pins; "
        "AHCT595 SER enters the OUT0-7 register and QH' continues "
        "through the 32-bit chain. Both chains share one hardware clock. "
        "The AHCT595 data/clock/latch controls use consecutive GPIO20/21/22 for "
        "uCNC RP2350 PIO compatibility. Latch is simultaneous.",
        15,
        15,
        190,
        32,
    )

    gpio_nets = {
        "1": "GND", "2": "GND", "3": None, "4": None, "5": "AOUT0_PWM",
        "6": "AOUT1_PWM", "7": "AI1_ADC", "8": "AI0_ADC", "9": "I2C_SDA",
        "10": "SD_MISO_MCU", "11": "SD_SCK_MCU", "12": "ENC0_B_3V3",
        "13": "ENC1_A_3V3", "14": "ENC1_Z_3V3", "15": "ENC2_B_3V3",
        "16": "GND", "17": None, "18": None, "19": "AOUT3_PWM",
        "20": "AOUT2_PWM", "21": "AI3_ADC", "22": "AI2_ADC", "23": "I2C_SCL",
        "24": "SD_CS_MCU", "25": "SD_MOSI_MCU", "26": "ENC0_A_3V3",
        "27": "ENC0_Z_3V3", "28": "ENC1_B_3V3", "29": "ENC2_A_3V3",
        "30": "ENC2_Z_3V3", "31": "+5V", "32": "GND", "33": None,
        "34": "SD_CD_MCU", "35": "EXP_GPIO4", "36": "EXP_GPIO6",
        "37": "EXP_GPIO8", "38": "WIFI_TX", "39": "HSTX_D0_P",
        "40": "HSTX_D1_P", "41": "HSTX_D2_P", "42": "HSTX_CLK_P",
        "43": "SR_OUT_SER", "44": "SR_LATCH", "45": "SR_PL_N", "46": None,
        "47": "GND", "48": "+3V3_A", "49": None, "50": "PWR_GOOD_N",
        "51": "EXP_GPIO5", "52": "EXP_GPIO7", "53": "ESTOP_N", "54": "WIFI_RX",
        "55": "HSTX_D0_N", "56": "HSTX_D1_N", "57": "HSTX_D2_N",
        "58": "HSTX_CLK_N", "59": "SR_SCK", "60": "SR_IN_Q7",
        "61": None, "62": None, "63": None, "64": None,
    }
    b.add(
        lib_id="LeanCam:WeAct_RP2350B",
        value="WeAct RP2350B Core Board (socketed)",
        footprint_key="WEACT",
        nets=gpio_nets,
        position=(150, 95),
        prefix="MOD",
        mpn="WeAct Studio RP2350B Core Board",
        manufacturer="WeAct Studio",
        reference="MOD1",
    )

    # The WeAct board supplies RUN/reset, its reset button, POR/BOR and watchdog.
    # Keep the reserved references so the remaining hierarchy stays stable.
    b.next_ref("D")   # retired reset diode D7
    b.next_ref("SW")  # retired reset button SW1
    b.next_ref("C")   # retired reset capacitor C21

    b.next_ref("J")  # retired SWD connector J4
    # Use the WeAct board's onboard status LED so GPIO46 is available for the
    # fourth 0-10 V output. Reserve the old references to keep numbering stable.
    b.next_ref("D")  # removed external status LED D8
    b.next_ref("R")  # removed status LED resistor R8

    # Paired ZERO/ERROR status is kept by axis. U6 takes AX0 and AX4-AX6;
    # U7 takes AX1-AX3 and two spare inputs. The spares are exposed on J55
    # with normally-open solder jumpers for optional grounding.
    servo_u6_inputs = [
        "AX0_ZERO", "AX0_ERROR_N", "AX6_ZERO", "AX6_ERROR_N",
        "AX4_ERROR_N", "AX4_ZERO", "AX5_ERROR_N", "AX5_ZERO",
    ]
    servo_u7_inputs = [
        "AX3_ZERO", "AX3_ERROR_N", "U7_IN13", "U7_IN14",
        "AX1_ZERO", "AX1_ERROR_N", "AX2_ZERO", "AX2_ERROR_N",
    ]
    # Chain order is U6 (mixed status), U7 (mixed status), U8 (PLC 1-8),
    # U9 (PLC 9-16).
    in_u_order = [(8, 16), (9, 24), (10, 0), (11, 8)]
    positions = [(70, 195), (100, 195), (130, 195), (160, 195)]
    for offset, ((unit_index, base), pos) in enumerate(zip(in_u_order, positions)):
        next_ds = "SR_IN_DS0" if offset == 0 else f"SR_IN_CHAIN{offset}"
        if base < 16:
            plc_pin_numbers = {
                0: tuple(range(1, 9)),
                8: tuple(range(9, 17)),
            }
            data_nets = [
                f"PLC_IN{number}_N" for number in plc_pin_numbers[base]
            ]
        elif base == 16:
            data_nets = servo_u6_inputs
        else:
            data_nets = servo_u7_inputs
        nets = {
            "1": "SR_PL_N",
            "2": "SR_SCK",
            "3": data_nets[4],
            "4": data_nets[5],
            "5": data_nets[6],
            "6": data_nets[7],
            "7": None,
            "8": "GND",
            "9": (
                f"SR_IN_CHAIN{offset + 1}"
                if offset < 3
                else "SR_IN_Q7"
            ),
            "10": next_ds,
            "11": data_nets[0],
            "12": data_nets[1],
            "13": data_nets[2],
            "14": data_nets[3],
            "15": "GND",
            "16": "+3V3",
        }
        b.add(
            lib_id="74xx:74HC165",
            value="74HC165D",
            footprint_key="SOIC16",
            nets=nets,
            position=pos,
            prefix="U",
            mpn="74HC165D,653",
            manufacturer="Nexperia",
        )
        b.capacitor("+3V3", "GND", "100nF", (pos[0] + 16, pos[1]))

    # U6/U7 carry direct servo status inputs. Match the PLC registers by
    # providing a 10 k pull-up on every data input. J55 exposes the two U7
    # spare inputs without extra grounding jumpers.
    servo_input_groups = (
        servo_u6_inputs[:4],
        servo_u6_inputs[4:],
        servo_u7_inputs[:4],
        servo_u7_inputs[4:],
    )
    for group, input_nets in enumerate(servo_input_groups):
        b.resistor_pack4(
            "10k",
            "R_Array_4x0603",
            [(net, "+3V3") for net in reversed(input_nets)],
            (250 + (group % 2) * 60, 210 + (group // 2) * 50),
            reference=f"RN{45 + group}",
        )

    b.header(
        1,
        3,
        {
            "1": "GND",
            "2": "U7_IN13",
            "3": "U7_IN14",
        },
        (185, 215),
        "U7 spare inputs: GND, IN13, IN14",
        reference="J55",
    )
    b.next_ref("JP")  # retired JP6
    b.next_ref("JP")  # retired JP7
    b.resistor(
        "SR_IN_DS0",
        "GND",
        "10k",
        (55, 210),
        footprint_key="R0805",
    )
    for _ in range(4):
        b.next_ref("R")  # retired discrete R10-R13
    b.next_ref("RN")  # retired RN41

    # Output chain: MCU data enters U13, then flows U13 -> U12 -> U11 -> U10.
    out_positions = [(70, 245), (100, 245), (130, 245), (160, 245)]
    # Every output register uses the same monotonic Q-pin map. QH is the last
    # physical channel in each byte.
    monotonic_output_pin_bits = {
        1: 0, 2: 1, 3: 2, 4: 3, 5: 4, 6: 5, 7: 6, 15: 7
    }
    output_register_pin_bits = (monotonic_output_pin_bits,) * 4
    for offset, pos in enumerate(out_positions):
        base = offset * 8
        ser = "SR_OUT_SER" if offset == 3 else f"SR_OUT_CHAIN{3 - offset}"
        q_next = f"SR_OUT_CHAIN{4 - offset}" if offset > 0 else None
        pin_bits = output_register_pin_bits[offset]
        nets = {
            str(pin): f"OUT{base + bit}" for pin, bit in pin_bits.items()
        }
        nets.update({
            "8": "GND",
            "9": q_next,
            "10": "+5V",
            "11": "SR_SCK",
            "12": "SR_LATCH",
            "13": "GND",
            "14": ser,
            "16": "+5V",
        })
        b.add(
            lib_id="74xx:74AHCT595",
            value="SN74AHCT595DR",
            footprint_key="SOIC16",
            nets=nets,
            position=pos,
            prefix="U",
            mpn="SN74AHCT595DR",
            manufacturer="Texas Instruments",
        )
        b.capacitor("+5V", "GND", "100nF", (pos[0] + 16, pos[1]))
    # Local output-gating circuitry is intentionally omitted. The external
    # machine interface owns hard output blocking; on this board the AHCT595
    # output-enable pins are tied active so the shift chain remains usable.
    for _ in range(3):
        b.next_ref("U")  # retired U14-U16 AND gates
    b.next_ref("Q")     # retired Q4 inverter
    b.next_ref("R")     # retired R14 base resistor
    b.next_ref("R")     # retired R15 pull-up

    b.note(
        "Output safety qualification is external. J5 is the only local E-stop "
        "input. AHCT595 output-enable pins are tied active; "
        "the external machine interface must provide hard output blocking.",
        190,
        325,
        165,
        40,
    )


def add_field_inputs(builder: SheetBuilder) -> None:
    b = builder
    b.note(
        "16 isolated PLC field positions use software-remapped logical channels to minimize PCB crossings. "
        "The dedicated E-stop optochannel is separate from the shift-register bits. "
        "PLC and control channels "
        "keep a 2.2 k series limit before the indicator LED and optocoupler LED, "
        "with a reverse diode at the protected node. Every "
        "four isolated inputs share one TLP291-4 SOP-16 optocoupler. Four 4x10 k "
        "isolated networks provide the PLC pull-ups and no input-node capacitor "
        "is fitted. U6/U7 carry seven paired servo status signals with two "
        "pulled-up spares; U8/U9 carry PLC inputs 1-16.",
        15,
        15,
        190,
        45,
    )

    # E-stop remains completely outside the input shift chain.
    b.terminal(
        2,
        {"1": "ESTOP_FIELD", "2": "ISO_GND"},
        (25, 70),
        "Dedicated E-stop loop",
        reference="J5",
    )
    for block in range(2):
        # J7 and J8 feed physical left-to-right channels 1-8 and 9-16.
        logical_numbers = tuple(range(1, 9)) if block == 0 else tuple(range(9, 17))
        nets = {str(local + 1): f"FIELD_IN{number}" for local, number in enumerate(logical_numbers)}
        b.terminal(
            8,
            nets,
            (25, 125 + block * 48),
            f"PLC positions {logical_numbers[0]}-{logical_numbers[-1]} signals",
            reference=f"J{7 + block}",
        )

    for field_net, led_net, opto_net, output_net in (
        ("ESTOP_FIELD", "ESTOP_LED_A", "ESTOP_OPTO_A", "ESTOP_N"),
    ):
        x = 100
        b.resistor(field_net, led_net, "2.2k", (x + 7, 72))
        b.led(opto_net, led_net, (x, 87))
        b.diode(led_net, "ISO_GND", (x + 7, 72))
        b.next_ref("C")  # removed input filter C30/C31
    b.next_ref("R")  # retired HOLD series resistor R17
    b.next_ref("D")  # retired HOLD indicator D11
    b.next_ref("D")  # retired HOLD reverse diode D12
    b.next_ref("RN")  # removed safety pull-up pack RN1
    b.next_ref("U")  # retired quad safety optocoupler U17
    b.next_ref("C")   # removed U17 pull-up rail bypass C32

    for group in range(4):
        x0 = 240 + (group % 2) * 100
        y0 = 65 + (group // 2) * 100
        for channel in range(4):
            bit = group * 4 + channel
            number = bit + 1

            x = x0 + channel * 17
            b.resistor(
                f"FIELD_IN{number}",
                f"FLD_LED{number}_A",
                "2.2k",
                (x + 7, y0),
            )
            b.led(
                f"FLD_OPTO{number}_A",
                f"FLD_LED{number}_A",
                (x, y0 + 15),
            )
            b.diode(f"FLD_LED{number}_A", "ISO_GND", (x + 7, y0))
            b.next_ref("C")  # removed input filter capacitor
        opto_pins = {}
        for channel in range(4):
            number = group * 4 + channel + 1
            opto_pins[str(1 + channel * 2)] = f"FLD_OPTO{number}_A"
            opto_pins[str(2 + channel * 2)] = "ISO_GND"
            opto_pins[str(16 - channel * 2)] = f"PLC_IN{number}_N"
            opto_pins[str(15 - channel * 2)] = "GND"
        opto_reference = ("U21", "U20", "U19", "U18")[group]
        b.add(
            lib_id="LeanCam:QuadOpto",
            value="TLP291-4",
            footprint_key="TLP291_4",
            nets=opto_pins,
            position=(x0 + 40, y0 + 79),
            prefix="U",
            reference=opto_reference,
            mpn="TLP291-4",
            manufacturer="Toshiba",
        )
        b.next_ref("RN")  # preserve the retired PLC pull-up pack refs
        b.next_ref("C")   # removed pull-up rail bypass C37-C52

def add_field_outputs(builder: SheetBuilder) -> None:
    b = builder
    b.note(
        "32-bit output chain: bit0 drives the sixteenth buffered motion/AUX output; "
        "bits1-15 drive the fifteen motion outputs through the same buffers; bits16-31 drive "
        "isolated general outputs through TLP291-4 optocouplers and TBD62083AFG "
        "field drivers. J12 exposes DO0-DO7 and J32 exposes DO8-DO15.",
        15,
        15,
        180,
        35,
    )

    # MC74AC541DWR2G buffers provide the higher current needed by the motion
    # interface. OUT0-OUT13 are seven STEP/DIR pairs; OUT14-OUT15 are the
    # shared enable lines for AX0-AX2 and AX3-AX6.
    motion_buffer_specs = (
        ("U42", tuple(range(7, -1, -1)), "C115"),
        ("U43", tuple(range(15, 7, -1)), "C116"),
    )
    input_pins = (2, 3, 4, 5, 6, 7, 8, 9)
    output_pins = (18, 17, 16, 15, 14, 13, 12, 11)
    for reference, channel_bits, bypass_reference in motion_buffer_specs:
        nets = {"1": "GND", "10": "GND", "19": "GND", "20": "+5V"}
        buffer_output_net = {}
        for axis in range(7):
            buffer_output_net[axis * 2] = f"AX{axis}_STEP"
            buffer_output_net[axis * 2 + 1] = f"AX{axis}_DIR"
        buffer_output_net[14] = "EN_3AX"
        buffer_output_net[15] = "EN_4AX"
        for input_pin, output_pin, bit in zip(
            input_pins, output_pins, channel_bits
        ):
            nets[str(input_pin)] = f"OUT{bit}" if bit is not None else None
            nets[str(output_pin)] = buffer_output_net.get(bit)
        b.add(
            lib_id="LeanCam:OctalBuffer5V",
            value="MC74AC541DWR2G",
            footprint_key="SOIC20W",
            nets=nets,
            position=(50 + (reference == "U43") * 55, 80),
            prefix="U",
            reference=reference,
            mpn="MC74AC541DWR2G",
            manufacturer="onsemi",
        )
        b.capacitor(
            "+5V",
            "GND",
            "100nF",
            (55 + (reference == "U43") * 55, 100),
            reference=bypass_reference,
        )

    output_pulldown_pairs = (
        (("GND", "OUT7"), ("GND", "OUT6"),
         ("GND", "OUT5"), ("GND", "OUT4")),
        (("OUT0", "GND"), ("OUT1", "GND"),
         ("OUT2", "GND"), ("OUT3", "GND")),
        (("OUT8", "GND"), ("OUT9", "GND"),
         ("OUT10", "GND"), ("OUT11", "GND")),
        (("GND", "OUT15"), ("GND", "OUT14"),
         ("GND", "OUT13"), ("GND", "OUT12")),
    )
    for pack_index, pairs in enumerate(output_pulldown_pairs):
        b.resistor_pack4(
            "10k",
            "R_Array_4x0603",
            list(pairs),
            (35 + (pack_index % 4) * 55, 280 + (pack_index // 4) * 50),
            reference=f"RN{8 + pack_index}",
        )
    b.next_ref("RN")  # retired RN12
    b.next_ref("RN")  # retired RN13
    # The former keyboard output arrays are removed. Preserve their references
    # so the remaining numbered hierarchy stays stable.
    # The MC74AC541DWR2G outputs drive the motion connectors directly. The former
    # RN16-RN19 100 ohm series arrays are removed.
    # Preserve the retired keyboard-array references. RN23/RN25 are reused
    # later by the 16-channel input expander pull-ups.
    for _ in range(16):
        b.next_ref("RN")

    # General outputs are opto-isolated between the shift registers and the
    # field-side ULN array. The opto transistor drives the ULN input from the
    # externally supplied +24V_FIELD rail, so the ULN remains the high-current
    # output device while logic GND remains isolated from ISO_GND.
    general_outputs = [
        (f"DO{bit}", f"OUT{16 + bit}") for bit in range(16)
    ]
    for pack_index in range(4):
        b.resistor_pack4(
            "1k",
            "R_Array_4x0603",
            [
                (
                    general_outputs[pack_index * 4 + (3 - bit)][1],
                    f"DO_OPTO_LED{pack_index * 4 + bit}_A",
                )
                for bit in range(4)
            ],
            (250 + pack_index * 25, 60),
            reference=f"RN{37 + pack_index}",
        )

    for package_index in range(4):
        nets = {}
        for slot in range(4):
            index = package_index * 4 + slot
            pin_anode = str(1 + slot * 2)
            pin_cathode = str(2 + slot * 2)
            pin_collector = str(16 - slot * 2)
            pin_emitter = str(15 - slot * 2)
            if index >= len(general_outputs):
                nets.update({
                    pin_anode: None,
                    pin_cathode: None,
                    pin_collector: None,
                    pin_emitter: None,
                })
                continue
            nets.update({
                pin_anode: f"DO_OPTO_LED{index}_A",
                pin_cathode: "GND",
                pin_emitter: f"DO_DRV{package_index * 4 + (3 - slot)}",
                pin_collector: "+24V_FIELD",
            })
        b.add(
            lib_id="LeanCam:QuadOpto",
            value="TLP291-4",
            footprint_key="TLP291_4",
            nets=nets,
            position=(620 + package_index * 65, 80),
            prefix="U",
            reference=f"U{61 + package_index}",
            mpn="TLP291-4",
            manufacturer="Toshiba",
        )

    # Two eight-channel TBD62083AFG arrays provide all sixteen general outputs.
    # Their channel order is mirrored to match the left-to-right board placement.
    uln_package_channels = (
        ("U26", tuple(range(7, -1, -1))),
        ("U27", tuple(range(15, 7, -1))),
    )
    for package_index, (reference, channel_bits) in enumerate(
        uln_package_channels
    ):
        nets = {"9": "ISO_GND", "10": "+24V_FIELD"}
        for channel, signal_index in enumerate(channel_bits):
            nets[str(channel + 1)] = f"DO_DRV{signal_index}"
            nets[str(18 - channel)] = f"DO{signal_index}"
        b.add(
            lib_id="Transistor_Array:ULN2803A",
            value="TBD62083AFG(Z,EL)",
            footprint_key="SOIC18W",
            nets=nets,
            position=(170 + package_index * 45, 195),
            prefix="U",
            reference=reference,
            mpn="TBD62083AFG(Z,EL)",
            manufacturer="Toshiba",
        )
    # Output LEDs indicate low-side channel energisation.
    for bit in range(8):
        x = 250 + (bit % 4) * 18
        y = 150 + (bit // 4) * 28
        b.led(
            f"DO{bit}",
            f"DO_LED{bit}_A",
            (x, y),
            f"DO{bit}",
            reference=f"D{45 + bit}",
        )
        b.resistor(
            "+24V_FIELD",
            f"DO_LED{bit}_A",
            "2.2k",
            (x + 8, y),
            reference=f"R{34 + bit}",
        )

    b.terminal(
        3,
        {"1": "EN_3AX", "2": "AX0_STEP", "3": "AX0_DIR"},
        (300, 140),
        "AX0: EN_3AX, STEP, DIR",
        reference="J10",
    )
    b.terminal(
        3,
        {"1": "EN_3AX", "2": "AX1_STEP", "3": "AX1_DIR"},
        (330, 140),
        "AX1: EN_3AX, STEP, DIR",
        reference="J11",
    )
    b.terminal(
        8,
        {
            "1": "DO0", "2": "DO1", "3": "DO2", "4": "DO3",
            "5": "DO4", "6": "DO5", "7": "DO6", "8": "DO7",
        },
        (300, 260),
        "General outputs 0-7",
        reference="J12",
    )
def add_input_pullups(
    builder: SheetBuilder,
    storage_builder: SheetBuilder,
) -> None:
    """Add discrete safety pull-ups and grouped PLC pull-up networks."""
    b = builder
    b.note(
        "The dedicated E-stop uses one TLP291 SOP-4 optocoupler and R74. "
        "PLC inputs use four TLP291-4 packages with two "
        "8x10 k pull-up networks. Every "
        "field input uses the same connector-side indicator LED / 2.2 k / "
        "reverse-diode chain. Firmware provides debouncing.",
        15,
        205,
        250,
        34,
    )

    b.add(
        lib_id="Isolator:TLP291",
        value="TLP291",
        footprint_key="SOIC4",
        nets={
            "1": "ESTOP_OPTO_A",
            "2": "ISO_GND",
            "3": "GND",
            "4": "ESTOP_N",
        },
        position=(440, 250),
        prefix="U",
        reference="U35",
        mpn="TLP291",
        manufacturer="Toshiba",
    )

    channels = [("R74", "ESTOP_N")]
    for index, (resistor_reference, output_net) in enumerate(channels):
        b.resistor(
            output_net,
            "+3V3",
            "10k",
            (55 + index * 15, 250),
            footprint_key="R0805",
            reference=resistor_reference,
        )

    pullup_references = ("RN35", "RN34", "RN33", "RN32")
    for group in range(4):
        numbers = tuple(range(group * 4 + 4, group * 4, -1))
        b.resistor_pack4(
            "10k",
            "R_Array_4x0603",
            [(f"PLC_IN{number}_N", "+3V3") for number in numbers],
            (55 + group * 60, 340),
            reference=pullup_references[group],
        )

    storage_builder.next_ref("RN")  # retired ESP pull-up array RN36


def add_encoders(builder: SheetBuilder) -> None:
    b = builder
    b.note(
        "Three independent quadrature encoders. The first eight 5 V push-pull A/B/Z "
        "outputs feed U28, an SN74AHCT541 powered at 3.3 V. ENC2_Z uses only a "
        "22 k series / 33 k shunt divider, which is sufficient for this single "
        "input and avoids a second 20-pin buffer. No ESD array is fitted.",
        15,
        15,
        190,
        35,
    )
    for encoder in range(3):
        x0 = 50 + encoder * 80
        nets = {
            "1": "+5V_ENC",
            "2": f"ENC{encoder}_A_5V",
            "3": f"ENC{encoder}_B_5V",
            "4": f"ENC{encoder}_Z_5V",
            "5": "GND",
        }
        b.terminal(
            5,
            nets,
            (x0, 80),
            f"Encoder {encoder}: +5,A,B,Z,GND",
            reference=f"J{13 + encoder}",
        )

    encoder_inputs = [
        f"ENC{encoder}_{signal}_5V"
        for encoder in range(3)
        for signal in "ABZ"
    ]
    channels = encoder_inputs[:8]
    nets = {str(pin): "GND" for pin in range(2, 10)}
    nets.update({str(pin): None for pin in range(11, 19)})
    nets.update({"1": "GND", "10": "GND", "19": "GND", "20": "+3V3"})
    for input_pin, input_net in enumerate(channels, start=2):
        nets[str(input_pin)] = input_net
        nets[str(20 - input_pin)] = input_net.replace("_5V", "_3V3")
    b.add(
        lib_id="LeanCam:OctalBufferAHCT",
        value="SN74AHCT541DWR",
        footprint_key="SOIC20W",
        nets=nets,
        position=(60, 125),
        prefix="U",
        reference="U28",
        mpn="SN74AHCT541DWR",
        manufacturer="Texas Instruments",
    )
    b.next_ref("C")  # retired U28 bypass C57
    b.capacitor(
        "+3V3",
        "GND",
        "100nF",
        (185, 125),
        reference="C119",
    )
    # Preserve later reference allocation: retired U29 and its C58 bypass.
    b.next_ref("U")
    b.next_ref("C")

    b.two_pin("F", "Device:Fuse", "500mA", "R1206", "+5V", "+5V_ENC", (30, 55), mpn="0ZCG0050FF2E", manufacturer="Bel Fuse")
    b.two_pin(
        "D",
        "Device:D_TVS",
        "SMAJ5.0A",
        "D_SMA",
        "+5V_ENC",
        "GND",
        (45, 55),
        reference="D53",
        mpn="SMAJ5.0A",
        manufacturer="Bourns",
    )


def add_encoder_z_divider(builder: SheetBuilder) -> None:
    b = builder
    b.resistor(
        "ENC2_Z_5V",
        "ENC2_Z_3V3",
        "22k",
        (180, 80),
        footprint_key="R0805",
        reference="R110",
    )
    b.resistor(
        "ENC2_Z_3V3",
        "GND",
        "33k",
        (194, 80),
        footprint_key="R0805",
        reference="R111",
    )
    b.note(
        "ENC2_Z level translation: 22 k series and 33 k to GND. "
        "5 V input produces approximately 3.0 V at the RP2350 pin.",
        170,
        95,
        70,
        25,
    )


def add_storage_wifi(builder: SheetBuilder) -> None:
    b = builder
    b.note(
        "MicroSD card and ESP-01/ESP-01S socket. The former keyboard scan "
        "interface is removed together with the former 2x10 expansion input "
        "connector.",
        15,
        15,
        190,
        35,
    )
    # Preserve the retired keyboard filter-capacitor references.
    for _ in range(8):
        b.next_ref("C")

    # I2C header with optional pull-up resistors.
    b.terminal(
        5,
        {
            "1": "I2C_SDA", "2": "I2C_SCL", "3": "+3V3",
            "4": "+5V", "5": "GND",
        },
        (35, 150),
        "I2C0: SDA, SCL, 3.3 V, 5 V, GND",
        reference="J18",
    )
    b.next_ref("R")  # retired I2C SDA pull-up R42
    b.next_ref("R")  # retired I2C SCL pull-up R43

    b.next_ref("RN")  # retired RN42; DAT1/DAT2 have no pull-ups in SPI mode
    b.resistor_pack4(
        "10k",
        "R_Array_4x0603",
        [
            ("SD_CS_N", "+3V3_SD"),
            ("SD_MOSI", "+3V3_SD"),
            ("SD_MISO", "+3V3_SD"),
            ("SD_CD", "+3V3_SD"),
        ],
        (125, 145),
        reference="RN43",
    )
    for _ in range(4):
        b.next_ref("R")  # consolidated R50-R53 into RN44
    b.resistor_pack4(
        "22R",
        "R_Array_4x0603",
        [
            ("SD_CS_MCU", "SD_CS_N"),
            ("SD_MOSI_MCU", "SD_MOSI"),
            ("SD_SCK_MCU", "SD_SCK"),
            ("SD_MISO_MCU", "SD_MISO"),
        ],
        (220, 145),
        reference="RN44",
    )
    b.two_pin("FB", "Device:FerriteBead", "600R@100MHz", "R0805", "+3V3", "+3V3_SD", (75, 170), mpn="GZ2012D601TF", manufacturer="Sunlord")
    b.capacitor(
        "+3V3_SD",
        "GND",
        "22uF 25V",
        (90, 170),
        footprint_key="C1206",
        reference="C67",
    )
    b.capacitor("+3V3_SD", "GND", "100nF", (102, 170), reference="C68")
    b.next_ref("R")  # preserve the retired R54 card-detect resistor reference
    b.add(
        lib_id="Jumper:SolderJumper_2_Open",
        value="SD_CD_EN",
        footprint_key="SJ2_STD",
        nets={"1": "SD_CD_MCU", "2": "SD_CD"},
        position=(300, 165),
        prefix="JP",
        reference="JP5",
        mpn="",
        manufacturer="PCB fabrication",
    )

    # ESP-01/ESP-01S socket and programming/test header.
    b.header(2, 4, {
        "1": "GND", "2": "WIFI_RX", "3": "WIFI_GPIO2", "4": "WIFI_EN",
        "5": "WIFI_GPIO0", "6": "WIFI_RST", "7": "WIFI_TX", "8": "+3V3_WIFI",
    }, (40, 205), "ESP-01/ESP-01S socket", reference="J20")
    b.next_ref("J")  # retired J21 external UART header
    for _ in range(4):
        b.next_ref("R")  # preserve the retired discrete ESP pull-up references
    b.next_ref("SW")  # retired SW2 ESP programming button
    b.capacitor(
        "+3V3_WIFI",
        "GND",
        "22uF 25V",
        (105, 220),
        footprint_key="C1206",
        reference="C69",
    )
    b.next_ref("C")  # retired ESP output bypass C70
    b.next_ref("FB")  # retired local-LDO link FB3

def add_display(builder: SheetBuilder) -> None:
    b = builder
    b.note(
        "HSTX pair order from the verified PicoLVDS/reference firmware: "
        "D0=GP12(P)/13(N), D1=GP14(P)/15(N), D2=GP16(P)/17(N), "
        "CLK=GP18(P)/19(N). J22 uses the verified display pinout: odd pins "
        "on the left and even pins on the right. Only the first eight rows "
        "are used; pins 17-20 are no-connect.",
        15,
        15,
        190,
        38,
    )

    b.header(2, 10, {
        "1": "+3V3", "2": "+3V3", "3": "+3V3", "4": "GND",
        "5": "GND", "6": "GND", "7": "LVDS_D0_N", "8": "LVDS_D0_P",
        "9": "LVDS_D1_N", "10": "LVDS_D1_P",
        "11": "LVDS_D2_N", "12": "LVDS_D2_P",
        "13": "GND", "14": "GND",
        "15": "LVDS_CLK_N", "16": "LVDS_CLK_P",
        "17": None, "18": None, "19": None, "20": None,
    }, (50, 85), "LCD LVDS 2x10, 2.00 mm", reference="J22")

    # Passive LVDS. The isolated array pairs are ordered to follow J22 from
    # left to right when the networks are rotated 90 degrees on the PCB.
    passive = [
        ("HSTX_D0_P", "LVDS_D0_P"), ("HSTX_D0_N", "LVDS_D0_N"),
        ("HSTX_D1_P", "LVDS_D1_P"), ("HSTX_D1_N", "LVDS_D1_N"),
        ("HSTX_D2_P", "LVDS_D2_P"), ("HSTX_D2_N", "LVDS_D2_N"),
        ("HSTX_CLK_P", "LVDS_CLK_P"), ("HSTX_CLK_N", "LVDS_CLK_N"),
    ]
    for pack in range(2):
        b.resistor_pack4(
            "330R",
            "R_Array_4x0603",
            passive[pack * 4:(pack + 1) * 4],
            (90 + pack * 65, 85),
            reference=f"RN{26 + pack}",
        )

    # Preserve reference numbering after removal of the HDMI branch.
    b.next_ref("J")   # retired J23 HDMI connector
    b.next_ref("RN")  # retired RN28 HDMI link array
    b.next_ref("RN")  # retired RN29 HDMI link array
    b.next_ref("R")   # retired R59 HDMI DDC pull-up
    b.next_ref("R")   # retired R60 HDMI DDC pull-up
    b.next_ref("F")   # retired F3 HDMI fuse
    b.next_ref("C")   # retired C107 HDMI bulk capacitor
    b.next_ref("C")   # retired C108 HDMI bypass capacitor


def add_analog(builder: SheetBuilder) -> None:
    b = builder
    b.note(
        "Four 0-10 V ADC inputs use a 100 k over 33 k divider and one 100 nF ADC "
        "capacitor per channel. Place each divider/filter group at J24, not at the MCU. "
        "Four ground-referenced 0-10 V outputs use individual 0805 resistors for "
        "the approved two-stage 10 k / 1 uF and 10 k / 100 nF PWM filters. A "
        "TLV2374 is powered from a local 12 V rail and uses 22 k / 10 k feedback "
        "for a nominal gain of 3.2, leaving calibration headroom for exactly 10 V.",
        15,
        15,
        300,
        45,
    )

    analog_in_nets = {
        "1": "GND",
        "2": "AI0",
        "3": "AI1",
        "4": "AI2",
        "5": "AI3",
    }
    b.terminal(
        5,
        analog_in_nets,
        (38, 75),
        "GND/AI0/AI1/AI2/AI3",
        reference="J24",
    )

    for bit in range(3):
        x = 100 + bit * 50
        b.resistor(
            f"AI{bit}",
            f"AI{bit}_ADC",
            "100k",
            (x, 70),
            reference=f"R{61 + bit * 3}",
        )
        b.next_ref("R")  # retired second upper resistor
        b.resistor(
            f"AI{bit}_ADC",
            "GND",
            "33k",
            (x, 100),
            reference=f"R{63 + bit * 3}",
        )
        b.capacitor(
            f"AI{bit}_ADC",
            "GND",
            "100nF",
            (x, 130),
            reference=f"C{73 + bit}",
        )
    b.resistor(
        "AI3", "AI3_ADC", "100k", (250, 70), reference="R182"
    )
    b.resistor(
        "AI3_ADC", "GND", "33k", (250, 100), reference="R183"
    )
    b.capacitor(
        "AI3_ADC", "GND", "100nF", (250, 130), reference="C118"
    )

    b.terminal(
        5,
        {
            "1": "GND",
            "2": "AOUT0",
            "3": "AOUT1",
            "4": "AOUT2",
            "5": "AOUT3",
        },
        (38, 210),
        "0-10 V outputs 0-3; pin 1 = common GND",
        reference="J25",
    )

    for bit in range(4):
        x = 90 + bit * 25
        b.resistor(
            f"AOUT{bit}_PWM",
            f"AOUT{bit}_F1",
            "10k",
            (x, 200),
            footprint_key="R0805",
            reference=f"R{92 + bit}",
        )
        b.resistor(
            f"AOUT{bit}_F1",
            f"AOUT{bit}_F2",
            "10k",
            (x, 210),
            footprint_key="R0805",
            reference=f"R{96 + bit}",
        )
        b.resistor(
            f"AOUT{bit}_FB",
            f"AOUT{bit}",
            "22k",
            (x, 230),
            footprint_key="R0805",
            reference=f"R{100 + bit}",
        )
        b.resistor(
            f"AOUT{bit}_FB",
            "GND",
            "10k",
            (x, 240),
            footprint_key="R0805",
            reference=f"R{104 + bit}",
        )

    for bit in range(4):
        x = 255 + bit * 35
        b.capacitor(
            f"AOUT{bit}_F1",
            "GND",
            "1uF",
            (x, 205),
            reference=f"C{92 + bit * 2}",
        )
        b.capacitor(
            f"AOUT{bit}_F2",
            "GND",
            "100nF",
            (x, 225),
            reference=f"C{93 + bit * 2}",
        )

    b.add(
        lib_id="LeanCam:TLV2374",
        value="TLV2374IDR",
        footprint_key="SOIC14",
        nets={
            "1": "AOUT0",
            "2": "AOUT0_FB",
            "3": "AOUT0_F2",
            "4": "+12V_AO",
            "5": "AOUT1_F2",
            "6": "AOUT1_FB",
            "7": "AOUT1",
            "8": "AOUT2",
            "9": "AOUT2_FB",
            "10": "AOUT2_F2",
            "11": "GND",
            "12": "AOUT3_F2",
            "13": "AOUT3_FB",
            "14": "AOUT3",
        },
        position=(430, 210),
        prefix="U",
        reference="U38",
        mpn="TLV2374IDR",
        manufacturer="Texas Instruments",
    )

    b.add(
        lib_id="LeanCam:L78L12",
        value="L78L12ACUTR",
        footprint_key="SOT89",
        nets={"1": "+12V_AO", "2": "GND", "3": "VIN_PROT"},
        position=(350, 295),
        prefix="U",
        reference="U37",
        mpn="L78L12ACUTR",
        manufacturer="Texas Instruments",
    )
    b.capacitor(
        "VIN_PROT",
        "GND",
        "22uF 35V",
        (315, 295),
        footprint_key="C1210",
        reference="C100",
    )
    b.capacitor(
        "+12V_AO",
        "GND",
        "22uF 25V",
        (385, 295),
        footprint_key="C1206",
        reference="C101",
    )
    b.capacitor(
        "+12V_AO",
        "GND",
        "100nF",
        (465, 210),
        reference="C102",
    )


def add_backlight_power(builder: SheetBuilder) -> None:
    b = builder
    b.note(
        "U3 is a 24 V to 12 V LMR36510 buck powered from the isolated PLC "
        "field supply on J33/J45. D3 provides reverse protection and the "
        "complete converter loop references ISO_GND.",
        250,
        250,
        210,
        42,
    )
    b.diode(
        "VIN_BL_PROT",
        "+24V_FIELD",
        (250, 270),
        value="US1M",
        footprint_key="D_SMA",
        reference="D3",
    )
    b.add(
        lib_id="Regulator_Switching:LMR36510ADDA",
        value="LMR36510ADDAR",
        footprint_key="SOIC8_POWERPAD",
        nets={
            "1": "ISO_GND",
            "2": "VIN_BL_PROT",
            "3": "VIN_BL_PROT",
            "4": None,
            "5": "FB12",
            "6": "VCC12",
            "7": "BUCK12_BST",
            "8": "BUCK12_SW",
            "9": "ISO_GND",
        },
        position=(275, 310),
        prefix="U",
        reference="U3",
        mpn="LMR36510ADDAR",
        manufacturer="Texas Instruments",
    )
    b.two_pin(
        "L",
        "Device:L",
        "47uH 0.9A",
        "L_SMNR5040",
        "BUCK12_SW",
        "+12V_BL",
        (305, 310),
        mpn="SMNR5040-470MT",
        manufacturer="SXN (Shun Xiang Nuo Elec)",
        reference="L2",
    )
    b.capacitor(
        "VIN_BL_PROT", "ISO_GND", "22uF 35V", (257, 305),
        footprint_key="C1210", reference="C107",
    )
    b.capacitor(
        "VIN_BL_PROT", "ISO_GND", "22uF 35V", (257, 318),
        footprint_key="C1210", reference="C108",
    )
    for index, x in enumerate((325, 340, 355)):
        b.capacitor(
            "+12V_BL", "ISO_GND", "22uF 25V", (x, 310),
            footprint_key="C1206", reference=f"C{109 + index}",
        )
    b.next_ref("C")  # retired output bypass C112
    b.capacitor(
        "BUCK12_BST", "BUCK12_SW", "100nF", (282, 325),
        footprint_key="C0805", reference="C113",
    )
    b.capacitor(
        "VCC12", "ISO_GND", "1uF", (297, 325),
        footprint_key="C0805", reference="C114",
    )
    b.resistor("+12V_BL", "FB12", "100k", (311, 325), reference="R126")
    b.resistor(
        "FB12",
        "ISO_GND",
        "10k",
        (324, 325),
        footprint_key="R0805",
        reference="R127",
    )
    b.resistor("FB12", "ISO_GND", "100k", (337, 325), reference="R128")
def add_backlight(builder: SheetBuilder) -> None:
    b = builder
    b.note(
        "J2 carries the isolated 12 V backlight rail generated from the PLC "
        "24 V field supply and its ISO_GND return. Backlight PWM is not "
        "provided by this board.",
        15,
        240,
        180,
        30,
    )
    b.terminal(
        2,
        {"1": "+12V_BL", "2": "ISO_GND"},
        (40, 260),
        "Backlight: +12V_BL, ISO_GND",
        reference="J2",
    )
    # Preserve the reference sequence of the removed backlight circuit so the
    # remaining staged PCB references stay stable.
    b.next_ref("Q")  # retired Q2 high-side switch
    b.next_ref("R")  # retired R6 gate pull-up
    b.next_ref("D")  # retired D6 gate clamp
    b.next_ref("R")  # retired R7 base resistor
    b.next_ref("Q")  # retired Q3 enable transistor
    b.next_ref("C")  # retired C18 backlight bulk capacitor
    b.next_ref("JP") # retired JP1 supply selector
    b.next_ref("U")  # retired U5
    b.next_ref("C")  # retired C19
    b.next_ref("C")  # retired C20
    b.next_ref("J")  # retired J3


def main() -> None:
    HARDWARE.mkdir(parents=True, exist_ok=True)
    sheets = {
        "power": SheetBuilder("Power and supervision", "power.kicad_sch", "A2"),
        "mcu": SheetBuilder("MCU, shift chains and safety", "mcu_io.kicad_sch", "A1"),
        "inputs": SheetBuilder("16 PLC inputs", "field_inputs.kicad_sch", "A1"),
        "outputs": SheetBuilder("24 PLC outputs", "field_outputs.kicad_sch", "A1"),
        "encoders": SheetBuilder("Encoders", "encoders.kicad_sch", "A2"),
        "storage": SheetBuilder("Storage, Wi-Fi and UI", "storage_wifi_ui.kicad_sch", "A1"),
        "display": SheetBuilder("Display", "display.kicad_sch", "A1"),
        "analog": SheetBuilder("Analog I/O", "analog_io.kicad_sch", "A2"),
    }
    add_power(sheets["power"])
    add_backlight(sheets["power"])
    add_mcu(sheets["mcu"])
    add_field_inputs(sheets["inputs"])
    add_field_outputs(sheets["outputs"])
    add_encoders(sheets["encoders"])
    add_storage_wifi(sheets["storage"])
    add_display(sheets["display"])
    add_analog(sheets["analog"])

    # U33 was the retired LCD-logic enable gate. Reserve the reference after
    # all automatically numbered MCU/peripheral gates have been created.
    sheets["power"].next_ref("U")

    # Explicit end-of-design references keep the existing capacitor references stable
    # staged PCB. One local 100 nF part is assigned to every supply-bearing IC
    # that did not already have a dedicated decoupling capacitor.
    local_decoupling = (
        ("power", "+5V", (285, 240), "C76"),       # U2 input
    )
    for sheet_name, rail, position, reference in local_decoupling:
        sheets[sheet_name].capacitor(
            rail,
            "GND",
            "100nF",
            position,
            reference=reference,
            dnp=reference == "C78",
        )
    sheets["power"].capacitor(
        "BUCK5_BST",
        "BUCK5_SW",
        "100nF",
        (345, 240),
        footprint_key="C0805",
        reference="C86",
    )
    sheets["power"].capacitor(
        "VCC5",
        "GND",
        "1uF",
        (369, 252),
        footprint_key="C0805",
        reference="C91",
    )
    sheets["storage"].add(
        lib_id="Regulator_Linear:AMS1117-3.3",
        value="AMS1117-3.3",
        footprint_key="SOT223",
        nets={"1": "GND", "2": "+3V3_WIFI", "3": "+5V"},
        position=(330, 260),
        prefix="U",
        reference="U34",
        mpn="AMS1117-3.3",
        manufacturer="Advanced Monolithic Systems",
    )
    sheets["storage"].capacitor(
        "+5V",
        "GND",
        "22uF 25V",
        (342, 260),
        footprint_key="C1206",
        reference="C88",
    )
    sheets["storage"].next_ref("C")  # retired ESP input bypass C89
    sheets["power"].capacitor(
        "+3V3",
        "GND",
        "22uF 25V",
        (417, 240),
        footprint_key="C1206",
        reference="C90",
    )
    for net_a, net_b, value, position, reference in (
        ("+5V", "FB5_TOP", "33k", (400, 240), "R70"),
        ("FB5_TOP", "FB5", "100k", (412, 240), "R71"),
        ("FB5", "GND", "33k", (424, 240), "R72"),
        ("PWR_GOOD_N", "+3V3", "100k", (436, 240), "R73"),
    ):
        sheets["power"].resistor(
            net_a,
            net_b,
            value,
            position,
            reference=reference,
        )

    add_input_pullups(sheets["inputs"], sheets["storage"])
    add_encoder_z_divider(sheets["encoders"])

    motion_connectors = (
        ("J28", "AX2: EN_3AX, STEP, DIR", {
            "1": "EN_3AX", "2": "AX2_STEP", "3": "AX2_DIR",
        }, (360, 175)),
        ("J29", "AX3: EN_4AX, STEP, DIR", {
            "1": "EN_4AX", "2": "AX3_STEP", "3": "AX3_DIR",
        }, (390, 175)),
        ("J30", "AX4: EN_4AX, STEP, DIR", {
            "1": "EN_4AX", "2": "AX4_STEP", "3": "AX4_DIR",
        }, (330, 210)),
        ("J46", "AX5: EN_4AX, STEP, DIR", {
            "1": "EN_4AX", "2": "AX5_STEP", "3": "AX5_DIR",
        }, (390, 210)),
        ("J47", "AX6: EN_4AX, STEP, DIR", {
            "1": "EN_4AX", "2": "AX6_STEP", "3": "AX6_DIR",
        }, (450, 210)),
    )
    for reference, value, nets, position in motion_connectors:
        sheets["outputs"].terminal(
            3,
            nets,
            position,
            value,
            reference=reference,
        )
    servo_inputs = (
        ("J40", "AX0"), ("J41", "AX1"), ("J42", "AX2"), ("J43", "AX3"),
        ("J48", "AX4"), ("J49", "AX5"), ("J50", "AX6"),
    )
    for index, (reference, axis) in enumerate(servo_inputs):
        sheets["outputs"].terminal(
            3,
            {
            "1": "GND",
                "2": f"{axis}_ERROR_N",
            "3": f"{axis}_ZERO",
            },
            (300 + (index % 4) * 55, 300 + (index // 4) * 30),
        f"{axis}: GND, ERROR, ZERO",
            reference=reference,
        )
    sheets["outputs"].terminal(
        8,
        {
            "1": "DO8", "2": "DO9", "3": "DO10", "4": "DO11",
            "5": "DO12", "6": "DO13", "7": "DO14", "8": "DO15",
        },
        (375, 260),
        "General outputs 8-15",
        reference="J32",
    )
    sheets["outputs"].terminal(
        2,
        {"1": "+24V_FIELD", "2": "ISO_GND"},
        (470, 260),
        "External isolated field 24 V supply / relay common A",
        reference="J33",
    )
    sheets["outputs"].terminal(
        2,
        {"1": "+24V_FIELD", "2": "ISO_GND"},
        (500, 260),
        "External isolated field 24 V supply / relay common B",
        reference="J45",
    )
    for bit in range(8, 16):
        led_reference = f"D{57 + bit - 8}"
        resistor_reference = f"R{118 + bit - 8}"
        x = 250 + ((bit - 8) % 4) * 18
        y = 205 + ((bit - 8) // 4) * 28
        sheets["outputs"].led(
            f"DO{bit}",
            f"DO_LED{bit}_A",
            (x, y),
            f"DO{bit}",
            reference=led_reference,
        )
        sheets["outputs"].resistor(
            "+24V_FIELD",
            f"DO_LED{bit}_A",
            "2.2k",
            (x + 8, y),
            reference=resistor_reference,
        )
    sheets["outputs"].next_ref("RN")  # retired RN30
    sheets["outputs"].next_ref("RN")  # retired RN31

    sheets["storage"].header(
        1,
        9,
        nets={
            "1": "SD_CD",
            "2": "SD_DAT1",
            "3": "SD_MISO",
            "4": "GND",
            "5": "SD_SCK",
            "6": "+3V3_SD",
            "7": "SD_MOSI",
            "8": "SD_CS_N",
            "9": "SD_DAT2",
        },
        position=(380, 165),
        value="Open-Smart TF Card Breakout",
        reference="J36",
    )

    add_backlight_power(sheets["power"])
    sheets["mcu"].header(
        1,
        7,
        {
            "1": "+3V3",
            "2": "GND",
            "3": "EXP_GPIO4",
            "4": "EXP_GPIO5",
            "5": "EXP_GPIO6",
            "6": "EXP_GPIO7",
            "7": "EXP_GPIO8",
        },
        (100, 155),
        "Expansion socket: +3V3, GND, GPIO4-GPIO8",
        footprint_key="SOCKET1X7",
        reference="J51",
    )
    sheets["storage"].add(
        lib_id="Connector:Micro_SD_Card_Det1",
        value="SOFNG TF-15x15 microSD socket (C111196)",
        footprint_key="MICROSD_SOFNG_C111196",
        nets={
            "1": "SD_DAT2",
            "2": "SD_CS_N",
            "3": "SD_MOSI",
            "4": "+3V3_SD",
            "5": "SD_SCK",
            "6": "GND",
            "7": "SD_MISO",
            "8": "SD_DAT1",
            "9": "SD_CD",
            "SH": "GND",
        },
        position=(510, 165),
        prefix="J",
        reference="J54",
        mpn="TF-15x15",
        manufacturer="SOFNG",
    )

    for sheet in sheets.values():
        sheet.save()
    make_root()
    for path in HARDWARE.glob("*.kicad_sch"):
        text = path.read_text(encoding="utf-8")
        path.write_text(shorten_quoted_tokens(text), encoding="utf-8")
    configure_netclasses()

    # Deterministic reference check across the hierarchy.
    duplicates = sorted(ref for ref, count in defaultdict(
        int, {ref: sum(part.reference == ref for part in PARTS) for ref in {part.reference for part in PARTS}}
    ).items() if count > 1)
    if duplicates:
        raise RuntimeError(f"Duplicate references: {duplicates}")
    print(f"Generated {len(PARTS)} parts across {len(sheets)} hierarchical sheets")


if __name__ == "__main__":
    main()
