staskaaa-netizen/uCNC_Pi_Board/(commit log)

2026-10-25 Initial LeanCam uCNC RP2350B board
2026-10-27 Update RP2350B PCB, pinout and fabrication rules
2026-10-29 Add complete generated schematic review PDF
2026-10-29 Finalize interface routing and repair PCB connectivity
2026-10-29 Add board specification and PCB PDF exports
2026-10-30 Update RP2350 board power and I/O design
2026-10-30 Close final PCB connectivity gaps
2026-10-30 Add buck thermal vias and refresh 3D renders
2026-10-30 BOM simplification
2026-11-02 Remove backlight PWM and finish side-1 remap
2026-11-02 Move SD chip select to side-1 pin 24
2026-11-03 Reverse encoder level-shifter channel mapping
2026-11-03 Finalize current routing and mark RN41 DNP
2026-11-03 Publish cache-free current 3D renders
2026-11-03 Finalize current RP2350 board and documentation
2026-11-03 Mark RP2350B board pre-final
2026-11-03 Refine connector labels and refresh design artifacts
2026-11-03 Add green LEDs and manufacturing packages
2026-11-04 Finalize component silkscreen labels and manufacturing outputs
2026-11-04 Update text placement and refresh board artifacts
2026-11-05 Set rail-specific capacitor ratings and add JLC outputs
2026-11-05 Move J54 inside and complete assembly BOMs
2026-11-05 Add current J54 placement renders
2026-11-05 Apply JLC-approved parts and finalize assembly package
2026-11-06 Finalize JLCPCB-ready RP2350B board
2026-11-07 Add ordered first-batch PCB review image
2026-11-09 Add normative RP2350 HAL pin contract
